Kizim01/Kizim-TLS-Pie/components_3013_iso_ORIG.jpg

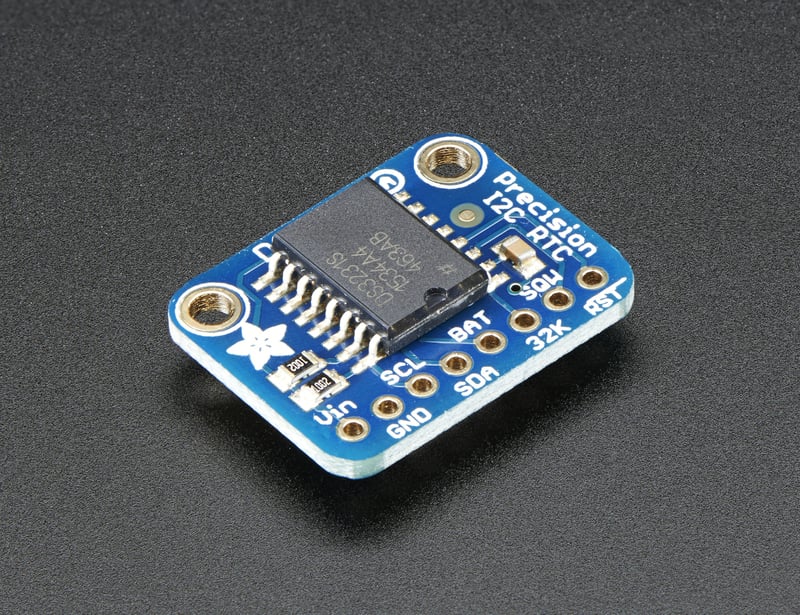
components_3013_iso_ORIG.jpg
