Kizim01/Kizim-TLS-Pie/microview pinout jpeg.jpg

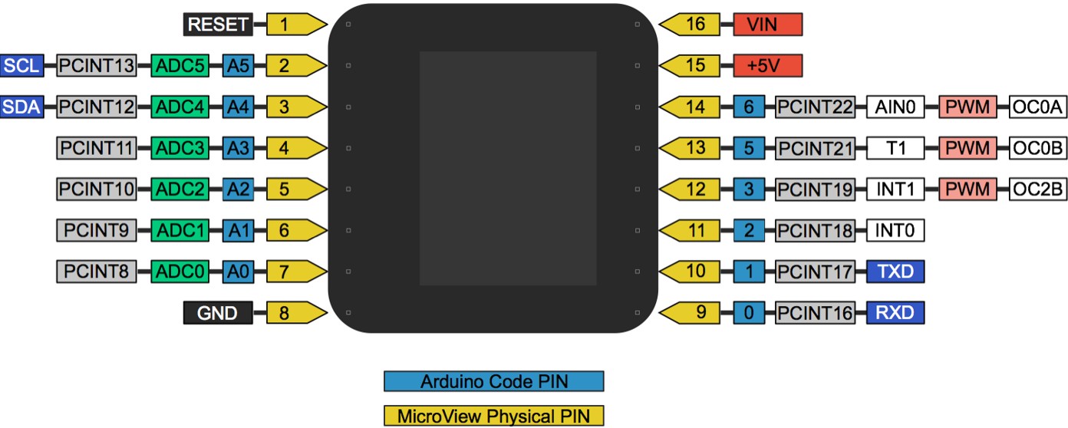
microview pinout jpeg.jpg
