Kizim01/Kizim-TLS-Pie/README.md

# TLS_Pie
Software to run a DIY Terrestrial Laser Scanner using a Raspberry Pie 4 and a Velodyne Lidar unit
house cutaway 6

Using a stepper motor a gearbox and a Velodyne VLP-16 Lidar unit one can achive good results similure to a low cost Terrestrial Laser Scanner.
PieTLS lightweight
TLS_Pie render 1
TLS_Pie render 2

Can be used indoors or Out.
house cutaway 7
spheres 1

Software to convert the Velodyne PCAP files to Point Clouds can be found here:
https://github.com/Rotoslider/PCAP-to-Point-Cloud-for-TLS
