Kizim01/Kizim-TLS-Pie/FUNDING_CONCEPT_NOTE.md

# Kizim Robotics — Funding concept note

## One-sentence pitch
Kizim Robotics is building fully autonomous, decentralized lidar mapping swarm drones that can inspect, map, and understand complex environments faster, safer, and at lower cost than traditional single-drone or manual approaches.

## Problem
Current mapping and inspection workflows are slow, expensive, and often dangerous. Traditional aerial mapping relies on expensive single-platform systems, manual operation, or centralized control. In remote, cluttered, or high-risk environments, this creates delays, incomplete coverage, and high operational cost.

## Opportunity
A new generation of low-cost autonomous drones can work together as a swarm to map large areas collaboratively, share situational awareness, and continue operating even if one unit is lost or disconnected. This is especially valuable for:
- infrastructure inspection
- mining and industrial site mapping
- disaster response and search-and-rescue support
- utilities and energy corridor monitoring
- geospatial surveying and environmental monitoring
- defense and security applications

## Solution
Kizim Robotics is developing a decentralized swarm platform for autonomous lidar mapping. The system is designed around:
- low-cost autonomous drone units
- onboard lidar sensing and navigation
- distributed coordination without a single point of failure
- collaborative mapping and data fusion
- resilient mission execution in complex environments

The platform is intended to move from single-unit operations toward a fully autonomous swarm architecture that can map and inspect large areas with greater coverage, resilience, and lower cost.

## Why now
The market is now ready for this category because:
- lidar and compute costs are falling
- edge autonomy is improving rapidly
- robotics software is maturing
- customers increasingly need faster and safer inspection workflows
- drone operations are becoming more accepted across industrial and public-sector use cases

## Why Kizim Robotics
Kizim Robotics is positioned at the intersection of robotics, autonomy, sensing, and distributed systems. The company combines hardware prototyping, embedded control, lidar mapping, and swarm coordination into a practical platform with a clear path from prototype to deployment.

## Market potential
The addressable market spans:
- industrial inspection and asset monitoring
- surveying and geospatial services
- energy and utilities
- mining and heavy industry
- defense and public safety
- disaster response and infrastructure resilience

This market is attractive because buyers are not simply buying drones; they are buying safer, faster, more complete data acquisition and reduced operational risk.

## Current traction and evidence
The project already has:
- an active hardware and software prototype direction
- evidence of lidar-based scanning and autonomy concepts
- an operating concept that is grounded in a real technical problem
- a strong narrative for research, pilot, and commercial validation

## Funding ask
Initial funding should be used to accelerate the path from prototype to credible pilot deployment.

Suggested early-stage funding target:
- $750,000 to $1.5 million for prototype maturation, field testing, and initial pilot programs

Possible funding mix:
- research and innovation grants
- strategic partnerships
- angel or seed investment
- defense or public-sector innovation channels where relevant

## Use of funds
- 40% robotics and autonomy R&D
- 25% hardware and sensor integration
- 15% field trials and pilot deployments
- 10% software and data infrastructure
- 10% team, operations, and compliance

## Milestones
Within 12 months, Kizim Robotics should aim to achieve:
- a working multi-unit autonomous demo
- a validated mapping workflow
- at least one pilot customer or partner
- strong technical and operational data for follow-on funding

## Closing statement
Kizim Robotics is building a platform that can turn distributed autonomous drones into a new class of mobile sensing infrastructure. The opportunity is not just to build drones, but to create a scalable system for autonomous mapping, inspection, and situational awareness in the real world.

This is the kind of technology that can attract grants, strategic partnerships, and early-stage investment when framed as both a breakthrough in autonomy and a practical solution to costly, dangerous, and slow current workflows.
