Kizim01/Kizim-TLS-Pie/COMPANY_LAUNCH_CHECKLIST.md

# Kizim Robotics — Company launch checklist

## 1. Define the company foundation
- Choose the legal structure for the business
- Register the company name and domain
- Set up basic corporate documents and founder agreements
- Create an internal working agreement for IP ownership and roles

## 2. Protect the technology
- Document the core technical architecture
- Record prototypes, test results, and design changes
- Create a simple IP log for inventions and improvements
- Consider provisional patent filings if the core concept is novel
- Keep clear records of prototypes, screenshots, code, and test data

## 3. Build the story and materials
- Create a one-page concept note
- Create a simple pitch deck
- Prepare a short executive summary for investors and partners
- Draft a basic website or landing page

## 4. Define the first product focus
Choose one primary use case first, such as:
- industrial inspection
- surveying and mapping
- utilities monitoring
- disaster response
- defense or public-safety support

A focused first market makes fundraising much easier.

## 5. Create a proof-of-value package
Prepare evidence that shows the technology is real:
- demo video or short footage
- technical summary
- test results
- customer problem statement
- pilot proposal or partner outreach materials

## 6. Build the funding pipeline
Start with a layered approach:
- grant and innovation funding
- strategic partnerships
- angel or seed support
- later-stage venture capital if traction is strong

## 7. Prepare a basic financial plan
- estimate runway needs
- define monthly burn
- outline hiring needs
- define hardware and software milestones
- build a simple forecast for the next 12 to 18 months

## 8. Set up the operating basics
- business bank account
- accounting system
- basic CRM or contact tracker
- shared design and project management tools
- document repository for technical and commercial materials

## 9. Start outreach early
Begin contacting:
- potential pilot customers
- research labs and universities
- robotics or sensing partners
- incubators and accelerators
- grant and innovation programs

## 10. Plan the first pilot
A pilot should answer one question clearly:
- does the system solve a real customer problem better than current alternatives?

The pilot should include:
- a clear use case
- a measurable success metric
- a timeline
- a simple deployment plan

## 11. Build the team deliberately
Start with the minimum team needed to move fast:
- technical lead
- embedded or robotics engineer
- software/autonomy engineer
- operations or business lead
- advisors in hardware, funding, or sector-specific execution

## 12. Keep the narrative disciplined
The story should stay consistent:
- the problem is real
- the solution is credible
- the market is meaningful
- the team can execute
- the funding will move the project to the next milestone

## 13. First milestones to target
Within the first 6 to 12 months, aim for:
- a working multi-unit demo
- a documented pilot use case
- initial customer conversations
- at least one credible funding path opened

## 14. Final launch mindset
Do not launch as a company that tries to be everything at once. Launch as a focused robotics company solving one high-value problem with a clear path to scale.

That is much more compelling to funders than a broad and undefined vision.
