Kizim01/Kizim-TLS-Pie/PITCH_DECK_OUTLINE.md

# Kizim Robotics — Pitch deck outline

## Suggested deck structure
This structure is designed for a seed-stage or grant-style investor conversation. Keep it visual, technical, and focused on impact.

### Slide 1 — Title
Kizim Robotics
Autonomous decentralized lidar mapping swarm drones
Subtitle: Faster, safer, more complete mapping for industrial and public-sector environments

### Slide 2 — The problem
Current mapping and inspection is slow, expensive, and often dangerous.
- Manual inspections are labor-intensive
- Single-drone systems are fragile and limited
- Large sites are difficult to map completely and quickly

### Slide 3 — The solution
A decentralized swarm of autonomous drones that collaborate in real time to map and inspect environments.
- distributed coordination
- resilient operation
- shared mapping data
- better coverage and lower operational cost

### Slide 4 — Why now
Why the market is ready now:
- cheaper sensors and compute
- better autonomy software
- rising demand for industrial inspection and remote sensing
- growing need for fast situational awareness

### Slide 5 — Product vision
What the system does:
- launch and coordinate multiple drones
- map terrain and infrastructure with lidar
- fuse data into a shared map
- adapt to changing conditions autonomously

### Slide 6 — Technical approach
Core technical pillars:
- autonomy and navigation
- lidar sensing and mapping
- swarm coordination and communication
- edge processing and data fusion

### Slide 7 — Prototype / proof of concept
Show the current technical progress:
- prototype platform
- mapping workflow
- control architecture
- early autonomous behavior
- bench-test or field-test results

### Slide 8 — Use cases
Primary applications:
- infrastructure inspection
- utilities and energy corridors
- mining and industrial sites
- disaster response
- surveying and geospatial mapping
- defense and security

### Slide 9 — Market and customer value
Who pays and why:
- operators want lower cost and faster coverage
- customers need safer and more complete data
- organizations need less downtime and better situational awareness

### Slide 10 — Business model
Possible revenue paths:
- hardware platform sales
- pilot deployments
- software and analytics subscriptions
- service contracts for inspection and mapping
- partnerships with industrial or public-sector customers

### Slide 11 — Go-to-market strategy
How to win early customers:
- start with one high-value vertical
- build a pilot program
- prove ROI with measurable outcomes
- expand through partnerships

### Slide 12 — Roadmap
12-month plan:
- field-ready prototype
- multi-unit swarm demo
- pilot deployment
- data package for follow-on funding

### Slide 13 — Team
Highlight:
- robotics and autonomy experience
- embedded systems and hardware background
- software and sensing expertise
- industry partnerships and advisors

### Slide 14 — Funding ask
State clearly:
- amount requested
- use of funds
- milestones for the next round
- what success looks like

### Slide 15 — Close
End with a strong closing line:
Kizim Robotics is building the infrastructure for autonomous distributed mapping at a time when the world needs faster, safer, and more resilient sensing systems.
