Kizim01/Kizim-TLS-Pie/TLS_Pie_Schemdraw_Schematic.pdf

## TLS_Pie wiring schematic

MicroView / Arduino
Buttons
Stepper Driver
Raspberry Pi
Signals: A0/A1/A2/D2, D3/D5/D6, D7/D8
Notes: Pi triggers GPIO17/GPIO27; shared ground required
