Kizim01/Kizim-TLS-Pie/START_HERE/README.md

# START HERE

Use this folder as the single project restart point.

Primary guide:
- [START_HERE.md](../START_HERE.md)

Quick links:
- [AI_HANDOFF_CHANGELOG.md](../AI_HANDOFF_CHANGELOG.md)
- [PROJECT_CONTEXT.md](../PROJECT_CONTEXT.md)
- [AI_HANDOFF_CHECKLIST.md](../AI_HANDOFF_CHECKLIST.md)
- [Pi_Setup_Package](../Pi_Setup_Package)
- [Pi_Setup_Package.zip](../Pi_Setup_Package.zip)
- [MicroView_Setup_Package](../MicroView_Setup_Package)
- [MicroView_Setup_Package.zip](../MicroView_Setup_Package.zip)

If resuming with Copilot, paste this prompt first:

```text
Continue from this repository context. Read these first:
1) AI_HANDOFF_CHANGELOG.md
2) PROJECT_CONTEXT.md
3) AI_HANDOFF_CHECKLIST.md
Then summarize current status, pending hardware validation, and the next 3 recommended actions.
```
