Kizim01/Kizim-TLS-Pie/4670_additional_big_easy_driver_107def42-5508-472d-be67-b35f5f0497c9.webp

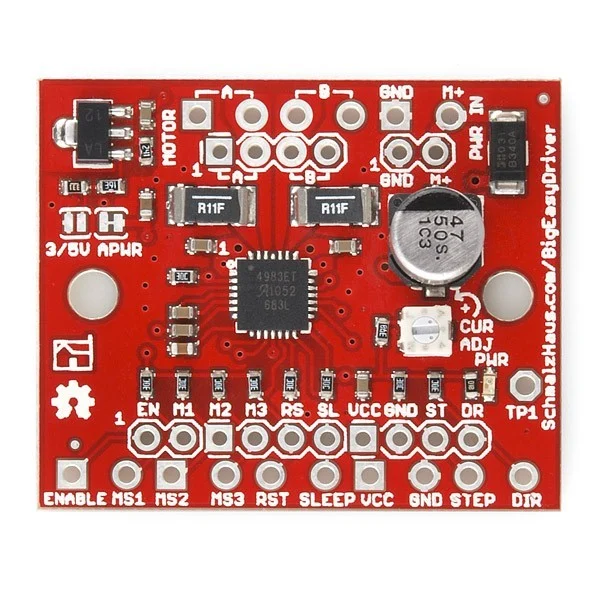
4670_additional_big_easy_driver_107def42-5508-472d-be67-b35f5f0497c9.webp
