Kizim01/Kizim-TLS-Pie/170906573-ced1bcf0-2f3b-4d30-9000-c1366d5eeb3a.png

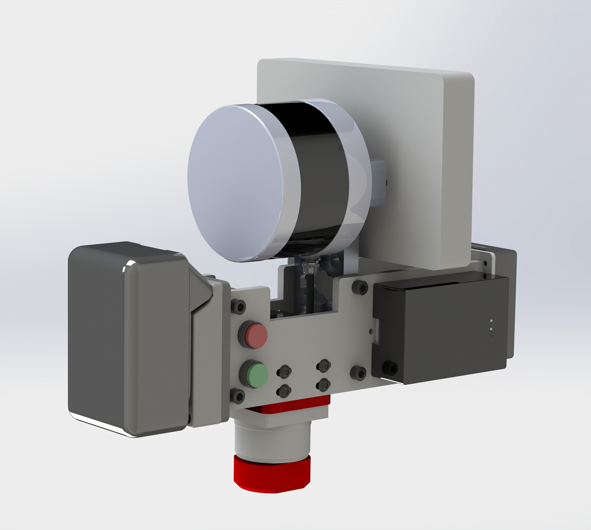
170906573-ced1bcf0-2f3b-4d30-9000-c1366d5eeb3a.png
