Kizim01/Kizim-TLS-Pie/big easy driver.jpg

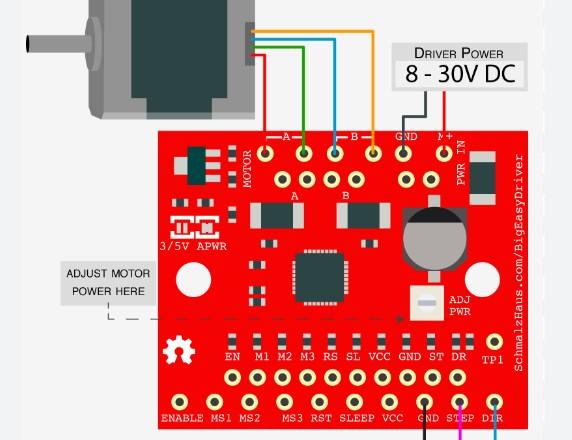
big easy driver.jpg
