Kizim01/Kizim-TLS-Pie/i-rotated-the-raspberry-pi-4s-gpio-diagram-by-180-degrees-v0-a71h1fe0s5b71.webp

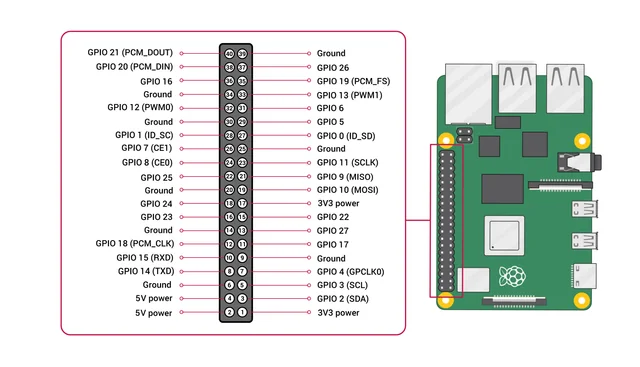
i-rotated-the-raspberry-pi-4s-gpio-diagram-by-180-degrees-v0-a71h1fe0s5b71.webp
