Kizim01/Kizim-TLS-Pie/WhatsApp Image 2026-08-09 at 3.39.35 AM.jpeg

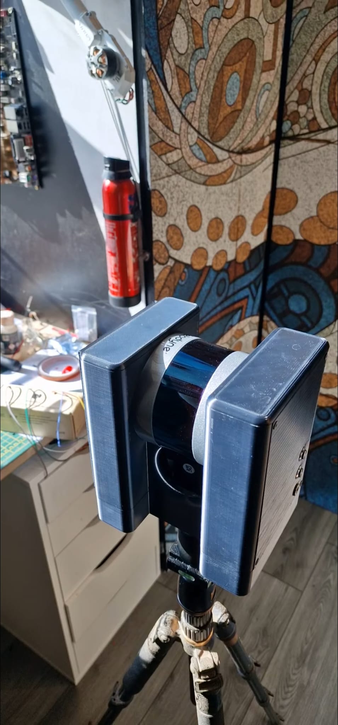
WhatsApp Image 2026-08-09 at 3.39.35 AM.jpeg
