Kizim01/Kizim-TLS-Pie/WIRING_REV2.html

Kizim Robotics · TLS Pie

# Rev 2.0 wiring schematic

Every conductor in the rig, endpoint to endpoint, named at both ends. This is the Pi-only architecture: the MicroView, the level shifter, the five push buttons and the monitor are all gone.

Rev2.0 Supersedes1.1 — 2022-09-12 Date2026-08-09 Statusnot yet built Sheets4

## 00 How to read this

This is an interconnect diagram, not a circuit-analysis schematic. Every device is a labelled block with its real silkscreen pin names on the edges, because the silkscreen is what you read with a wire in your hand. Only the parts you actually fit as discrete components — the fuse, the switches, the four resistors — are drawn as symbols.

Sheets 1–3 are grouped by subsystem: power, the motor chain, the capture path. Sheet 4 is that same wiring seen from the header — pin 1 at the bottom, laid out the way the connector sits in front of you. Use 1–3 to understand the rig, and 4 to wire it.

Two conventions A filled dot where wires meet is a connection. Wires that cross without a dot are not connected. Every ground symbol ⏚ is the same single net — see the star-point note under Figure 1.

+VBATT 12–24 V unregulated

+12 V motor supply

+5 V Pi supply

+3V3 from the Pi

GND one common net

STEP / DIR / ENABLE

I²C SDA / SCL

Ethernet capture path

Motor coils A and B

## 01 Power distribution

FIG 1

Power distribution

TLS Pie · Rev 2.0

Sheet 1 of 4

F1 protects everything. S1 and S2 hang off the fuse in parallel, so S1 does not switch the lidar — cutting S1 kills the Pi and the motor rail and leaves the VLP-16 spinning on S2.

The star point Every ⏚ on all three sheets is one net. Land them all at the battery negative terminal — that is the star point. Nine conductors arrive there: BT1(–), U3 IN–, U3 OUT–, U6 IN–, U6 OUT–, U4 GND (power side), U7 J2 pin 2, and the Pi's ground, which reaches the star through U3 OUT–. The Pi's ground and the driver's ground must be common or STEP and DIR have no return path — that is what the red note on Rev 1.1 was about.

Three things to settle before this is energised

- RESOLVED — they are LM2596 bucks, not XL6009 boosts. The Rev 1.0 label was wrong. A photograph of the hardware reads LM2596S-ADJ: a step-down regulator, 4.5–40 V in, 3 A absolute maximum, ~2 A realistically on a bare module. Making 5 V from 12 V is exactly what it is for, so the Pi's rail was never in danger from the topology.
- But a buck cannot make 12 V from a 12 V battery. It needs ~1.5 V of headroom. If U6 is set to 12 V on a 12 V nominal pack it is not regulating at all and the motor rail sags under load. Delete U6 and take M+ from the switched battery instead — the driver accepts 8–35 V, U6 only ever existed to run the monitor that is now gone, and regulating a motor supply buys nothing while costing a 3 A ceiling and an LM2596's transient response in front of a chopper driver. Measure M+ while the motor is turning.
- Feeding the Pi through JP1 pins 2 and 4 bypasses its input protection. The USB-C jack has a polyfuse and an e-fuse behind it; the header pins have neither. The supply must be accurate (5.1 V) and current-limited, and its polarity is unforgiving.
- The VLP-16 wants 12 V nominal. S2 hands it raw battery volts. On a 24 V pack that is outside the sensor's input range — check the pack's actual voltage before S2 is closed, or put a regulator in that leg.

## 02 Motor chain — Pi header to driver to motor

FIG 2

Motor chain

TLS Pie · Rev 2.0

Sheet 2 of 4

Three signals, one return, four coil wires. Everything else on the driver is left open on purpose.

R_PU is the gating item — nothing turns until it is fitted Every Pi GPIO floats as an input for the ~30 s the Pi takes to boot, and ENABLE is active-low. Without the pull-up the driver can sit energised through the whole of boot with nothing in control of it. Two details decide whether the resistor actually does its job:

- It goes on the driver side of R_EN — at the ENABLE pin itself, as drawn. Put it on the Pi side and it stops holding ENABLE high the moment the Pi is unplugged.
- It pulls up to the driver's own VCC, not the Pi's 3V3. VCC is an output from the driver's on-board regulator, selected by the 3/5V APWR jumper. Set that jumper to 3.3 V and measure VCC before wiring anything to it. Then ENABLE is held disabled whenever the driver has power, whether the Pi is running, booting or absent — and no 5 V can ever reach GPIO13.

Note: PROJECT_CONTEXT.md says pull up to +3V3 and MICROVIEW_REMOVAL.md says pull up to the driver's VCC. They disagree. VCC at 3.3 V is the version that also covers "Pi off, driver on", so that is what is drawn here.

Coil pairing is the one motor mistake that matters A1/A2 must be the two ends of the same coil, and B1/B2 the two ends of the other. Get a wire from coil A onto a B output and the motor will buzz, heat and not turn. Which way round the two ends of a coil go only reverses the direction — and direction is a software setting (TLSPIE_DIR_FORWARD=0), so do not chase it with a soldering iron.

Find the pairs with a multimeter on continuity, motor disconnected: the two wires of one coil read a few ohms to each other and open circuit to the other pair.

## 03 Capture path, clock and cooling

FIG 3

Capture path, clock, cooling

TLS Pie · Rev 2.0

Sheet 3 of 4

The sensor never touches the GPIO header — it is Ethernet the whole way, which is why eth0 must stay on 192.168.1.x and the phone hotspot must not.

TB1 — the nine-way terminal block inside U7 Nothing here is hand-wired: the VLP-16's factory cable lands on TB1 in this order. Listed so a disturbed terminal can be put back.

TB1 | Function | TB1 | Function
1 | Gnd / Shield | 6 | Ethernet TX–
2 | +12 Vdc | 7 | Ethernet RX+
3 | GPS_Pulse_CNT | 8 | Ethernet RX–
4 | GPS_RX_CNT | 9 | GPS return
5 | Ethernet TX+ | —

Vin goes to 3V3 — header pin 1, not pin 2 or 4 On this breakout the I²C pull-up resistors reference Vin, so whatever you feed Vin is what appears on SDA and SCL when the bus is idle. Put 5 V on Vin and the board pulls GPIO2 and GPIO3 to 5 V — and the Pi's GPIOs are not 5 V tolerant. The DS3231 runs happily from 2.3 V and draws microamps, so there is no reason to use 5 V here even if it were safe.

Check it before you trust it: power the board from pin 1 with the SDA and SCL wires not yet fitted, and measure SDA to GND. It must read about 3.3 V, not 5.

U1 · Adafruit DS3231 Precision RTC breakout · all eight pins
Pin | Silkscreen | Goes to | Why / why not
1 | Vin | JP1 pin 1 · 3V3 | Powers the chip and sets the I²C bus voltage — see the box above
2 | GND | JP1 pin 9 | Any Pi ground works; 9 is chosen because it sits beside the I²C pair
3 | SCL | JP1 pin 5 · GPIO3 | I²C clock
4 | SDA | JP1 pin 3 · GPIO2 | I²C data
5 | BAT | no connection | Positive of the coin cell, which lives in the holder on the underside. Nothing to wire
6 | 32K | no connection | 32.768 kHz output, open-drain. Useful as a reference clock; this rig has no use for it
7 | SQW | no connection | Alarm / square-wave output, open-drain. If you ever want the RTC to wake the Pi on a schedule, this is the pin — and it would need a free GPIO plus a pull-up
8 | RST | no connection | Open-drain reset, bidirectional. Leave it

Four things about this board specifically

- The pin order is not the order the header hands the wires over in. The breakout runs Vin, GND, SCL, SDA — the Pi's four pins arrive as 3V3, SDA, SCL, GND. Two of the four wires cross. That is drawn honestly on Sheet 4 rather than tidied away.
- SDA and SCL are easy to swap and the symptom is silence, not damage. i2cdetect simply finds nothing. Check the pair before blaming the board.
- No battery-charging circuit. That is the difference between this board and the cheap ZS-042 clones, which do have one and slowly cook a non-rechargeable cell. Here a plain coin cell is exactly right — fit it + side up.
- Address 0x68 is fixed and nothing else in the rig is on I²C, so there is no conflict to design around.

Wiring it is half the job — the Pi ignores it until you say so Raspberry Pi OS keeps time with fake-hwclock, which just restores the last known time at boot. The RTC only takes over once the kernel driver is bound:

Step | Command
Enable I²C | sudo raspi-config nonint do_i2c 0
Confirm the board answers | sudo i2cdetect -y 1 → expect 68
Bind the driver | add dtoverlay=i2c-rtc,ds3231 to /boot/firmware/config.txt, reboot
Confirm it bound | sudo i2cdetect -y 1 → 68 becomes UU
Stop the fake clock | sudo apt -y remove fake-hwclock && sudo systemctl disable fake-hwclock
Set the time once, online | sudo hwclock -w

This matters more here than on a desk machine. The rig runs off a phone hotspot with no guaranteed internet, and every scan's sidecar and filename is timestamped — without the RTC a cold boot in the field dates your captures from whenever the Pi was last switched off.

## 04 JP1 — the header as you hold it

Drawn in the orientation of your pinout card: pin 1 at the bottom, odd numbers up the right column, even numbers up the left, the header running down the board’s left edge. Eleven pins carry wires — 1, 2, 3, 4, 5, 6, 9, 33, 35, 37 and 39. One is damaged. The other twenty-eight are free, and stay free.

FIG 4

JP1 in the board’s own orientation

TLS Pie · Rev 2.0

Sheet 4 of 4

The same eleven conductors as Figures 1–3, arranged the way the connector sits in front of you. A coloured outline marks a pin that carries a wire; a grey stub marks one that does not.

Which end is pin 1 Pin 1 is the corner of the header nearest the USB-C power and micro-HDMI edge of the board. In this orientation that puts it at the bottom, 3V3 on the right of the pair and 5 V on the left. Count up in twos from there and the header cannot end up reversed — which is the mistake that destroyed the MicroView.

JP1 · Raspberry Pi 4B · Rev 2.0 assignment · pin 1 at the bottom
even pins · left column | | | odd pins · right column
GPIO21 | 40 | | 39 | GND → U4 GND (logic)
GPIO20 | 38 | | 37 | GPIO26 → R_DR → U4 DIR
GPIO16 | 36 | | 35 | GPIO19 → R_ST → U4 STEP
GND | 34 | | 33 | GPIO13 → R_EN → U4 ENABLE
GPIO12 | 32 | | 31 | GPIO6
GND | 30 | | 29 | GPIO5
ID_SC — reserved, HAT EEPROM | 28 | | 27 | ID_SD — reserved
GPIO7 CE1 | 26 | | 25 | GND
GPIO8 CE0 | 24 | | 23 | GPIO11 SCLK
GPIO25 | 22 | | 21 | GPIO9 MISO
GND | 20 | | 19 | GPIO10 MOSI
GPIO24 | 18 | | 17 | 3V3 spare
GPIO23 | 16 | | 15 | GPIO22
GND | 14 | | 13 | GPIO27 — DAMAGED, output-only
GPIO18 | 12 | | 11 | GPIO17
GPIO15 RXD tested OK | 10 | | 9 | GND → U1 GND (pin 2)
GPIO14 TXD tested OK | 8 | | 7 | GPIO4
GND → U10 fan – | 6 | | 5 | GPIO3 SCL → U1 SCL (pin 3)
5V ← U3 OUT+ · → U10 fan + | 4 | | 3 | GPIO2 SDA → U1 SDA (pin 4)
5V ← U3 OUT+ | 2 | | 1 | 3V3 → U1 Vin

Pin 13 · GPIO27 Confirmed damaged by gpio_selftest.py on 2026-08-09 — it drives both rails but its internal pull-up no longer holds it high as an input, consistent with the 12 V incident. It was the old RECORDSTOP line. Nothing in Rev 2.0 uses it. Never put an input there. GPIO14 and GPIO15, the two pins that ran to the destroyed harness, both pass.

Ground pins are electrically identical, so pins 6, 9 and 39 were chosen for tidiness rather than function: 6 sits next to the fan's 5 V on pin 4, 9 next to the I²C pair, and 39 next to the three motor signals at the far end. Keep the motor's return on 39 — it keeps the driver's ground wire away from the I²C pair.

## 05 Master netlist

One row per conductor. If a wire is not on this list it should not be in the rig. Colours follow the Rev 1.0 harness so old and new wiring read the same.

Every conductor, endpoint to endpoint
Net | From | To | Wire | Note
Power — Figure 1
+VBATT | BT1 (+) | F1 · terminal 1 | pink | size for the full load, not just the motor
+VBATT | F1 · terminal 2 | S1 · pole | pink | S1 and S2 tap the same fused node
+VBATT | F1 · terminal 2 | S2 · pole | pink | S1 does not switch this leg
+VSW1 | S1 · throw | U3 · IN+ (4) | pink
+VSW1 | S1 · throw | U6 · IN+ (4) | pink
+VSW2 | S2 · throw | U7 · J2 pin 1 | pink | barrel jack, centre positive
+5V | U3 · OUT+ (1) | JP1 pin 2 | red | set U3 to 5.1 V loaded
+5V | U3 · OUT+ (1) | JP1 pin 4 | red | second conductor, shares the current
+12V | U6 · OUT+ (1) | U4 · M+ | yellow | add 100 µF electrolytic at U4 if this run is long
Ground — one net, star-connected at BT1 (–)
GND | BT1 (–) | star point | green | the reference for everything
GND | U3 · IN– (3) | star point | green
GND | U3 · OUT– (2) | star point | green | this is also the Pi's ground path
GND | U6 · IN– (3) | star point | green
GND | U6 · OUT– (2) | star point | green
GND | U4 · GND (power side, by M+) | star point | green | carries coil current — keep it thick and short
GND | U7 · J2 pin 2 | star point | green
Motor chain — Figure 2
M.ENABLE | JP1 pin 33 · GPIO13 | R_EN → U4 · ENABLE | blue | active-low
M.ENABLE | U4 · ENABLE | R_PU → U4 · VCC | blue | 10 kΩ; driver side of R_EN
M.STEP | JP1 pin 35 · GPIO19 | R_ST → U4 · STEP | blue | pigpio DMA waveform
M.DIR | JP1 pin 37 · GPIO26 | R_DR → U4 · DIR | blue
GND | JP1 pin 39 | U4 · GND (logic side, by VCC) | green | signal return — mandatory
COIL A | U4 · A1 | M1 · A+ | motor lead | pairing matters, polarity does not
COIL A | U4 · A2 | M1 · A– | motor lead
COIL B | U4 · B1 | M1 · B+ | motor lead
COIL B | U4 · B2 | M1 · B– | motor lead
Clock, cooling, capture — Figure 3
+3V3 | JP1 pin 1 | U1 · Vin (breakout pin 1) | red/thin | 3V3, never 5 V — the board's I²C pull-ups reference Vin
GND | JP1 pin 9 | U1 · GND (pin 2) | green
SCL | JP1 pin 5 · GPIO3 | U1 · SCL (pin 3) | cyan | Pi already has 1.8 kΩ to 3V3; the breakout adds ~10 kΩ
SDA | JP1 pin 3 · GPIO2 | U1 · SDA (pin 4) | cyan | likewise — the parallel pair is still legal
— | U1 · BAT, 32K, SQW, RST (pins 5–8) | no connection | — | coin cell, 32.768 kHz out, alarm out, reset — none used here
+5V | JP1 pin 4 | U10 · fan (+) | red
GND | JP1 pin 6 | U10 · fan (–) | green
ETH | Pi on-board RJ-45 (eth0) | U7 · J3 RJ-45 | Cat5e | not on the header — the capture path
SENSOR | U7 · TB1 1–9 | VLP-16 | factory cable | see the TB1 table above

## 06 What to add and what to take off

Components added in Rev 2.0
Ref | Value | Sits between | Why
R_PU | 10 kΩ | U4 ENABLE → U4 VCC | Mandatory. Holds the driver disabled through the Pi's ~30 s boot, when no software exists
R_EN | 1 kΩ | JP1 pin 33 → U4 ENABLE | The driver's inputs are high-impedance, so these cost nothing electrically. They cap fault current into the Pi's clamp diodes at under 10 mA even with 12 V on the line
R_ST | 1 kΩ | JP1 pin 35 → U4 STEP
R_DR | 1 kΩ | JP1 pin 37 → U4 DIR

Removed from Rev 1.1 — do not re-fit
Ref | Was | Replaced by
P1 | MicroView — motor control + OLED | The Pi, in one process
U2 | 4-channel logic level shifter | Nothing. No 5 V logic remains
U9 | HDMI monitor on the 12 V rail | The phone panel
SW1–SW5 | Reset, Scan 1/2/3, Stop | The phone panel
R1–R5 | 10 kΩ button pull-ups to 5 V | Nothing — and they were a live hazard: a 10 kΩ to 5 V on a Pi GPIO puts 5 V on a pin that is not 5 V tolerant every time the button is open
R5 (1 kΩ) | series resistor on the Stop button | Nothing

Keep S1 (Main) and S2 (Lidar) are power switches, not buttons. S1 is the rig's emergency stop: it cuts both the Pi's converter and the motor rail, so the coils de-energise and STEP stops toggling — and unlike a switch in series with ENABLE, a crashed Pi with the DMA engine still clocking pulses cannot defeat it. Check S1's DC rating before trusting it: it breaks a DC inductive load, DC arcs do not self-extinguish the way AC ones do, and an under-rated switch slowly welds its contacts. A welded E-stop looks fine right up until it is needed.

## 07 Bring-up order

No motor has ever turned on this rig. Build the wiring in this order and each step is provable before the next one can hurt anything.

1. Header disconnected — run ./gpio_selftest.py. Expect 25 of 26 pins healthy and GPIO27 output-only.
2. Converters on the bench, no loads. Confirm U3 holds 5.1 V and U6 holds 12 V from the real pack, and measure M+ again while the motor is turning — a buck set to 12 V on a 12 V pack is in dropout and will sag exactly when the motor needs it.
3. Ground first. Star-point every return, then check continuity from the Pi's pin 39 to the battery negative before any supply is connected.
4. Power the Pi only. Panel reachable at http://tlspie.local:8080/, nothing else wired.
5. Fit R_PU, then the three series resistors, then the signal wires. With the driver powered and the Pi off, measure ENABLE — it must sit at VCC, not near zero.
6. Motor uncoupled from the head. ./tls_scan.py --scan scan3 --no-record, then press Stop mid-move and confirm the motor halts.
7. Command 90° and measure it with the shaft marked. This is the outstanding question: 640,000 steps/rev is measured and solid, but whether that comes from a 100:1 reduction or a 0.45°/step motor is still unsettled.
8. Full scan with capture. Watch for lost steps while tcpdump runs — DMA and capture contend for memory bandwidth, and that is the one real open performance question.

Before the first move, verify on the board itself

- MS1/MS2/MS3 open = 1/16 microstep on a Big Easy Driver, via its on-board pull-ups. The measured 640,000 steps/rev assumes 1/16 — if a jumper has been moved, the geometry constant is wrong.
- RST and SLP are tied together on the board on a genuine Big Easy Driver, so both may be left open. Put a meter across them and confirm continuity. If they are not tied, jumper RST to SLP or the driver never leaves reset and the motor will simply never move.
- Set the current limit on the ADJ PWR pot before the motor sees load.
- Confirm the Pi really is 192.168.1.100 against the VLP-16's own configuration. That number was never verified against the sensor.

TLS Pie · Rev 2.0 · drawn 2026-08-09 · supersedes Rev 1.1 of 2022-09-12 · source of truth for pin assignments is tls_stepper.py (TLSPIE_STEP_PIN / TLSPIE_DIR_PIN / TLSPIE_ENABLE_PIN) — this sheet documents the defaults
