Kizim01/Kizim-TLS-Pie/MicroView_Setup_Package/new wiring diagram 18.07.26.png

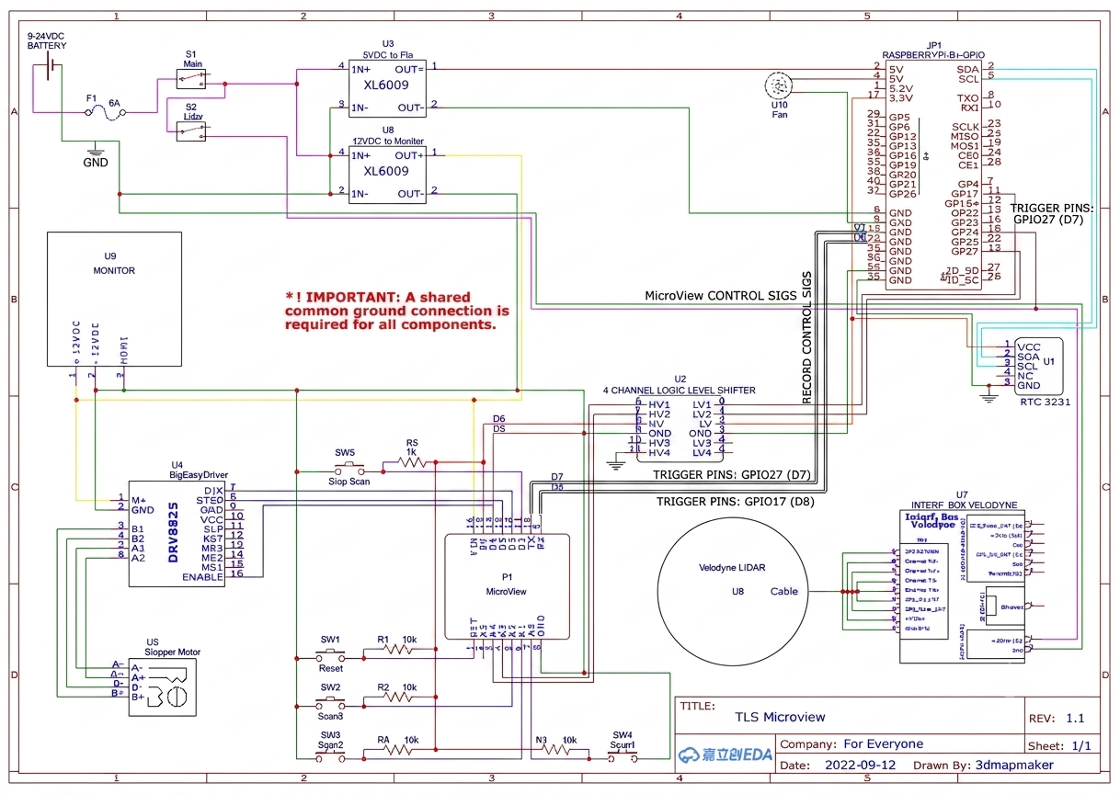
MicroView_Setup_Package/new wiring diagram 18.07.26.png
