Kizim01/Kizim-TLS-Pie/AI_HANDOFF_CHANGELOG.md

# TLS_Pie AI handoff changelog

This file is meant to help another AI instance quickly understand what changed in the repository and what still needs verification.

## Project purpose
TLS_Pie is a MicroView / Arduino + Raspberry Pi + stepper driver + Velodyne lidar control setup. The main goal is to start and stop lidar capture from the Arduino controller and have the Raspberry Pi capture packets with tcpdump.

## What changed in this session

### 1. Arduino / MicroView firmware
File: [Arduino Microview/LidarHDMicroviewV1.0/LidarHDMicroviewV1.0.ino](Arduino%20Microview/LidarHDMicroviewV1.0/LidarHDMicroviewV1.0.ino)

Changes:
- Moved the record start/stop trigger outputs from the old pins to digital pins D7 and D8.
- The current mapping is:
  - RECORDSTART = D7
  - RECORDSTOP = D8
- This was done to avoid conflicts with the MicroView display-related pins and to make the trigger wiring more reliable.

### 2. Raspberry Pi trigger scripts
Files:
- [Raspberry Pie4/TLS-Pie/VLPbuttons.py](Raspberry%20Pie4/TLS-Pie/VLPbuttons.py)
- [Raspberry Pie4/TLS-Pie/VLPwaitbutton.py](Raspberry%20Pie4/TLS-Pie/VLPwaitbutton.py)
- [Raspberry Pie4/TLS-Pie/VLPrecord.sh](Raspberry%20Pie4/TLS-Pie/VLPrecord.sh)

Changes:
- Updated the Pi-side scripts to wait for Arduino-triggered pulses rather than relying only on local button presses.
- The expected trigger wiring is:
  - Arduino D7 -> Pi GPIO17
  - Arduino D8 -> Pi GPIO27
- The record shell script now creates the capture directory before starting tcpdump.

### 3. Documentation and reference files created
Files:
- [WIRING_DIAGRAM.md](WIRING_DIAGRAM.md)
- [CHANGELOG_AND_TEST_GUIDE.md](CHANGELOG_AND_TEST_GUIDE.md)
- [UPDATED_SCHEMATIC_COMPARE.md](UPDATED_SCHEMATIC_COMPARE.md)
- [VISUAL_SCHEMATICS.md](VISUAL_SCHEMATICS.md)
- [SCHEMATIC_VISUAL_REWORK.md](SCHEMATIC_VISUAL_REWORK.md)

These files summarize:
- wiring expectations,
- signal names and pin mappings,
- troubleshooting steps,
- and comparison between the old and new schematic logic.

### 4. PDF outputs generated
Files:
- [TLS_Pie_Test_Guide.pdf](TLS_Pie_Test_Guide.pdf)
- [TLS_Pie_Updated_Schematic_Compare.pdf](TLS_Pie_Updated_Schematic_Compare.pdf)
- [TLS_Pie_Visual_Schematic.pdf](TLS_Pie_Visual_Schematic.pdf)
- [TLS_Pie_Schemdraw_Schematic_landscape.pdf](TLS_Pie_Schemdraw_Schematic_landscape.pdf)

## Important design notes
- Shared ground is required between the Arduino / MicroView, Raspberry Pi, and stepper driver.
- The Arduino now controls recording start/stop through D7 and D8.
- The Pi scripts are aligned with those trigger pins.
- The original schematic image in the repo is [Schematic_TLS Mircoview.png](Schematic_TLS%20Mircoview.png).

## What to verify next
1. Upload the Arduino sketch to the correct board and confirm the MicroView boots normally.
2. Verify button inputs on A0, A1, A2, and D2.
3. Confirm D7 and D8 produce the expected pulses when the scan starts and stops.
4. Verify Raspberry Pi GPIO17 and GPIO27 receive these pulses.
5. Confirm the Pi captures packets with tcpdump and writes output files.
6. Check the stepper driver control pins D3, D5, and D6 during motion.

## Quick summary for the next AI
If you are continuing this work, the main thing to remember is:
- the trigger wiring was changed to D7 and D8,
- the Pi waits for GPIO17 and GPIO27,
- and the system should use a common ground.

If you need to debug hardware, start with power and ground, then verify the Arduino outputs, then the Pi GPIO inputs, then the stepper and capture path.

## Pi setup work completed in this session
- Added a Raspberry Pi setup installer at [Raspberry Pie4/setup_tls_pie_pi.sh](Raspberry%20Pie4/setup_tls_pie_pi.sh)
- Added a beginner-friendly setup checklist at [Raspberry Pie4/TLS_Pie_Pi_Setup_Checklist.md](Raspberry%20Pie4/TLS_Pie_Pi_Setup_Checklist.md)
- Added a fuller setup guide at [Raspberry Pie4/TLS_Pie_Pi_Setup_Guide.md](Raspberry%20Pie4/TLS_Pie_Pi_Setup_Guide.md)
- Generated PDF versions at [Raspberry Pie4/TLS_Pie_Pi_Setup_Checklist.pdf](Raspberry%20Pie4/TLS_Pie_Pi_Setup_Checklist.pdf) and [Raspberry Pie4/TLS_Pie_Pi_Setup_Guide.pdf](Raspberry%20Pie4/TLS_Pie_Pi_Setup_Guide.pdf)

## Pi setup status
The Pi setup files and documentation are now present in the repository, but the hardware-side validation still needs to be done on the actual Pi:
1. Copy the repo to the Pi at /home/lipi/TLS-Pie
2. Run the installer script
3. Reboot and verify the recorder starts automatically
4. Confirm the Pi receives the Arduino trigger pulses and creates a .pcap file

So the setup work is largely completed in the repository, but it is not fully verified on hardware yet.

## Major integration updates (latest)

### 1. Pi runtime hardening
Files:
- [Raspberry Pie4/TLS-Pie/VLPrecord.sh](Raspberry%20Pie4/TLS-Pie/VLPrecord.sh)
- [Raspberry Pie4/TLS-Pie/VLPselfcheck.sh](Raspberry%20Pie4/TLS-Pie/VLPselfcheck.sh)
- [Raspberry Pie4/TLS-Pie/VLPstatussignal.py](Raspberry%20Pie4/TLS-Pie/VLPstatussignal.py)

Changes:
- Added recorder status tracking with explicit states written to `/tmp/tlspie/VLPrecord.status`.
- Added recorder logging under `/home/<user>/velodyne/logs`.
- Added stronger interface and runtime checks and clearer abort handling.
- Added Pi-to-MicroView status pulse signaling through `VLPstatussignal.py`.

### 2. Pi setup script improvements
Files:
- [Raspberry Pie4/setup_tls_pie_pi.sh](Raspberry%20Pie4/setup_tls_pie_pi.sh)
- [Pi_Setup_Package/setup_tls_pie_pi.sh](Pi_Setup_Package/setup_tls_pie_pi.sh)

Changes:
- Added dry-run mode (`TLSPIE_DRY_RUN=1`).
- Added setup logging.
- Added first-scan verification output.
- Ensured new companion scripts are marked executable.

### 3. MicroView abort-cause display integration
File:
- [Arduino Microview/LidarHDMicroviewV1.0/LidarHDMicroviewV1.0.ino](Arduino%20Microview/LidarHDMicroviewV1.0/LidarHDMicroviewV1.0.ino)

Changes:
- Added Pi status input pin support:
  - `PISTATUS = D4`
- Added decoded abort-cause display on OLED using pulse count codes from Pi.
- Added user-visible runtime states on OLED:
  - `READY`
  - `WAIT PI`
  - `SCANNING`
  - `REC`
  - `PI TIMEOUT`
  - `REC LOST` (brief transition before detailed abort screen)
  - `PI ABORTED` + reason code

Pi abort reason code mapping shown on OLED:
- 1 START TIMEOUT
- 2 NO INTERFACE
- 3 LIDAR OFFLINE
- 4 TCPDUMP ERROR
- 5 EMPTY PCAP
- 6 INTERRUPTED
- 7 TOOL MISSING
- 8 reserved for Pi recording ACK (non-abort)

### 4. New packaging and handoff outputs
Files/folders:
- [Pi_Setup_Package](Pi_Setup_Package)
- [Pi_Setup_Package.zip](Pi_Setup_Package.zip)
- [MicroView_Setup_Package](MicroView_Setup_Package)
- [MicroView_Setup_Package.zip](MicroView_Setup_Package.zip)
- [Pi_Setup_Package/build_package.ps1](Pi_Setup_Package/build_package.ps1)

Changes:
- Added one-command package build and sync lock verification.
- Added dedicated MicroView setup package with firmware, status references, checklist, wiring image, and Pi companion files.

### 5. Validation completed
- Bash tooling installed and verified.
- Shell script syntax checks passed.
- ShellCheck lint is clean on key scripts.
- Python compile checks passed for Pi helper scripts.
- Package sync-lock verification passed and zips were generated.

## Remaining hardware verification tasks
1. Wire Pi GPIO22 -> level shifter -> MicroView D4 (`PISTATUS`).
2. Flash updated MicroView firmware and confirm OLED states transition as expected.
3. Bench-test one full cycle:
   - READY -> WAIT PI -> SCANNING + REC -> READY
4. Force an abort condition and verify:
   - REC LOST transition
   - PI ABORTED with correct reason code.

## Latest session update (2026-07-18)

### NEW_PROJECT_START_HERE starter kit flow finalized
Files:
- [NEW_PROJECT_START_HERE/START_NEW_PROJECT.bat](NEW_PROJECT_START_HERE/START_NEW_PROJECT.bat)
- [NEW_PROJECT_START_HERE/init_new_project.ps1](NEW_PROJECT_START_HERE/init_new_project.ps1)
- [NEW_PROJECT_START_HERE/README.md](NEW_PROJECT_START_HERE/README.md)
- [NEW_PROJECT_START_HERE/Templates](NEW_PROJECT_START_HERE/Templates)

Changes:
- Removed interactive pauses from `START_NEW_PROJECT.bat` so startup is fully automatic.
- Removed self-rename behavior from `START_NEW_PROJECT.bat` (avoids Windows "batch file cannot be found" noise).
- `START_NEW_PROJECT.bat` now runs the initializer and exits cleanly.
- `init_new_project.ps1` now creates a separate `RESUME_PROJECT.bat` in the project root.
- Templates are now kept in a dedicated toolkit folder:
  - `NEW_PROJECT_START_HERE/Templates`
- Generated working docs are written to the project root:
  - `PROJECT_CONTEXT.md`
  - `AI_HANDOFF_CHANGELOG.md`
  - `AI_HANDOFF_CHECKLIST.md`
  - `AI_PROJECT_RUNBOOK.md`
  - `COPILOT_START_PROMPT.txt`
  - `START_HERE.md`
  - `RESUME_PROJECT.bat`

Validation:
- Sandbox run confirmed starter behavior:
  - Generated docs created in project root.
  - Template files stayed in `NEW_PROJECT_START_HERE/Templates`.
  - `RESUME_PROJECT.bat` created and successfully reran refresh with skip-existing behavior.
- Cleaned leftover test folder in toolkit (`NEW_PROJECT_START_HERE/_rename_test`).

Resulting usage model:
1. Keep `NEW_PROJECT_START_HERE` as a reusable toolkit folder in repo.
2. Run `NEW_PROJECT_START_HERE/START_NEW_PROJECT.bat` for initial bootstrap.
3. Run `RESUME_PROJECT.bat` from project root for future refresh/resume operations.

## Session update (2026-07-18): VLPrecord.sh timing fix + consolidated setup package

### Code review findings
Reviewed the full Velodyne -> pcap capture chain (LidarHDMicroviewV1.0.ino -> VLPbuttons.py/VLPwaitbutton.py -> VLPrecord.sh -> tcpdump -> .pcap -> MATLAB TLS_Velodyne_script.m). Found:
1. VLPrecord.sh sent the MicroView recording ACK (`signal_microview_code 8`) before starting tcpdump, so the motor could begin rotating before packet capture was actually running.
2. The autostart launcher in setup_tls_pie_pi.sh passes the capture interface as a positional argument (`VLPrecord.sh $INTERFACE`), but VLPrecord.sh never read `$1`, so the interface override was silently ignored and it always fell back to `eth0`.
3. tcpdump had no BPF filter, so it captured all traffic on the interface, not just lidar packets.

### Fixes applied
Files changed (identical fix applied to all three copies):
- [Raspberry Pie4/TLS-Pie/VLPrecord.sh](Raspberry%20Pie4/TLS-Pie/VLPrecord.sh)
- `Pi_Setup_Package/TLS-Pie/Raspberry Pie4/TLS-Pie/VLPrecord.sh`
- `MicroView_Setup_Package/Pi_Companion_Files/VLPrecord.sh`

Changes:
- `ETH_INTERFACE="${1:-${ETH_INTERFACE:-eth0}}"` - positional argument now takes priority.
- Added `CAPTURE_FILTER="${CAPTURE_FILTER-host $LIDAR_IP}"` and applied it to the tcpdump command line.
- Reordered capture start: tcpdump now starts first, the script waits 0.3s and confirms the process is alive (`kill -0`) before calling `status_update`/`signal_microview_code 8`. If tcpdump dies immediately, it aborts with `TCPDUMP_ERROR` instead of acking the MicroView.

Note: `Pi_Setup_Package/build_package.ps1` copies `Raspberry Pie4/TLS-Pie/VLPrecord.sh` (repo root) onto the Pi_Setup_Package copy and verifies by hash equality - the repo root copy had to be fixed too, or the next package rebuild would silently revert the fix.

### New consolidated setup folder
Created `SETUP_PACKAGE_18.07.26/` at the repo root with:
- `Pi/` - full copy of `Pi_Setup_Package` (installer, runtime scripts, checklists/guides)
- `MicroView/` - full copy of `MicroView_Setup_Package` (firmware, docs, Pi companion files)
- `BENCH_TEST_CHECKLIST.md` and `.pdf` - staged end-to-end bench test procedure (see below)
- `make_bench_test_checklist_pdf.py` - regenerates the PDF from the markdown source

The original `Pi_Setup_Package` and `MicroView_Setup_Package` folders were kept as backups (not deleted).

### Static validation performed (2026-07-18)
- `python -m py_compile` passed for VLPbuttons.py, VLPwaitbutton.py, VLPstatussignal.py (both package copies).
- `bash -n` (via Git for Windows bash) passed for VLPrecord.sh, VLPselfcheck.sh, setup_tls_pie_pi.sh.
- Brace/paren/bracket balance check passed for LidarHDMicroviewV1.0.ino.
- This confirms no syntax errors; it does not confirm GPIO timing or hardware behavior.

### Bench test checklist added
`SETUP_PACKAGE_18.07.26/BENCH_TEST_CHECKLIST.md` (+ PDF) documents a 6-stage test procedure:
0. Static code validation (complete, see above)
1. Pi environment self-check (VLPselfcheck.sh)
2. Dry-run install (TLSPIE_DRY_RUN=1)
3. MicroView <-> Pi signaling only (no motor, no lidar)
4. Add lidar, capture-only test
5. Full bench scan with motor engaged
6. MATLAB conversion validation

### Remaining hardware verification tasks
1. Run the bench test checklist stages 1-6 on real hardware.
2. Confirm the motor does not move until tcpdump is confirmed running (validates the ACK-ordering fix).
3. Confirm the autostart launcher picks up the correct interface via the positional argument.
4. Confirm the .pcap only contains lidar traffic and converts correctly in the MATLAB TLS_Velodyne converter.

## Session update (2026-07-18, part 2): wireless Pi setup docs

### Changes made
- Added a wireless/headless setup path to the Pi setup docs in `SETUP_PACKAGE_18.07.26/Pi/`, so the Pi can be fully configured and controlled from a laptop over WiFi/SSH without ever plugging in a monitor, keyboard, or mouse:
  - [SETUP_PACKAGE_18.07.26/Pi/TLS_Pie_Pi_Setup_Guide.md](SETUP_PACKAGE_18.07.26/Pi/TLS_Pie_Pi_Setup_Guide.md) - added a new step 4, "Set up wireless remote access (SSH)", covering Raspberry Pi Imager's SSH/WiFi settings, connecting via `ssh user@hostname.local`, and optional VNC. Remaining steps renumbered (5-13).
  - [SETUP_PACKAGE_18.07.26/Pi/TLS_Pie_Pi_Setup_Checklist.md](SETUP_PACKAGE_18.07.26/Pi/TLS_Pie_Pi_Setup_Checklist.md) - added step "1a" with the same quick SSH/VNC setup bullets.
- Regenerated both PDFs from the updated markdown.
- Added [SETUP_PACKAGE_18.07.26/Pi/make_setup_pdfs.py](SETUP_PACKAGE_18.07.26/Pi/make_setup_pdfs.py), a reusable reportlab-based generator (same pattern as `make_bench_test_checklist_pdf.py`) that renders both `TLS_Pie_Pi_Setup_Guide.md` and `TLS_Pie_Pi_Setup_Checklist.md` to PDF in one run.

### Files touched
- SETUP_PACKAGE_18.07.26/Pi/TLS_Pie_Pi_Setup_Guide.md and .pdf
- SETUP_PACKAGE_18.07.26/Pi/TLS_Pie_Pi_Setup_Checklist.md and .pdf
- SETUP_PACKAGE_18.07.26/Pi/make_setup_pdfs.py (new file)

### Validation performed
- Ran `make_setup_pdfs.py`, confirmed both PDFs regenerated with exit code 0 and printed output paths.

### Remaining work
- None code-side; this was documentation-only. The underlying VLPrecord.sh fixes and bench test checklist still need real hardware verification (see above).

---

## Session update (2026-08-08/09): MicroView destroyed, architecture moved to Pi-only

> **If you are the next AI on this project, read this section and the rewritten
> [PROJECT_CONTEXT.md](PROJECT_CONTEXT.md) before anything else.** Every earlier section of this
> changelog describes an architecture that no longer exists.

### 1. The MicroView is dead — cause confirmed

Symptom: OLED dark, `avrdude` failing `not in sync: resp=0x00` at 115200 / 57600 / 19200 / 9600.

Cause: the harness was wired with **both pin rows reversed** — right column physical pin N to pin
(25−N), left column pin N to pin (9−N). That put **12 V on physical pin 10 = Arduino D1/TXD**
(absolute max ≈ 5.5 V), and put the **GND wire on RESET**, leaving the board with no ground return.

TXD is the pin the ATmega replies to `avrdude` on, which is why the FTDI programmer looked
perfectly healthy while nothing answered — one fault explaining every symptom.

Ruled out during diagnosis: the sketch, the Arduino IDE (bare `avrdude` fails identically), port
contention, and the FT231X programmer itself.

### 2. Unresolved — is the Pi damaged?

The wires intended for TX and RX landed on pin 15 (**the +5 V rail**) and pin 16 (**VIN**), both
running off-board. The path to the Pi went through **U2, the 4-channel level shifter**, which on a
BSS138 MOSFET design blocks HV→LV conduction and probably protected the Pi. That is inference, not
measurement.

**Action for the next session:** run `gpio_selftest.py --pins 14,15` with the header disconnected.
Replace U2 regardless.

### 3. Firmware bugs found and fixed (commits `feb1d91`, `9fe8249`)

Fixed but **never uploaded** — the board died first. Retained for reference only.

- `KILL_SCAN()` ran as an ISR while calling `delay()` and driving the OLED. Interrupts are masked
  inside an ISR so Timer0 never ticks and `delay()` blocks forever — the board hung permanently on
  the first kill press, and because the `RECORDSTOP` pulse sat after those delays the Pi was never
  told to stop.
- KILL interrupt was `RISING` on an active-low button, so it fired on release. Now `FALLING`.
- All four buttons were `INPUT` but read active-low — floating. Now `INPUT_PULLUP`.
- Scan moves were blocking, so neither the kill button nor a Pi abort was looked at for the whole
  3–6 minute rotation.
- The PI TIMEOUT screen was drawn and immediately overwritten by `showReadyScreen()`.
- RAM was at 67%; the logo moved to PROGMEM, now 49%.
- **`PISTATUS`/`RECORDSTART`/`RECORDSTOP` were on D4/D7/D8 — pins the MicroView does not break
  out.** The OLED uses D4 (3.3 V regulator enable), D7 (reset), D8 (data/command), D10, D11, D13
  internally. Moved to A3/A4/A5. See `SparkFun_MicroView/src/MicroView.h`.

### 4. New architecture — the Pi runs everything (commit `5360777`)

New files in `Raspberry Pie4/TLS-Pie/`:

- **`tls_stepper.py`** — pan axis on **pigpio DMA waveforms**. Linux is not real-time, so a step
  train bit-banged from a Python loop stalls whenever the scheduler preempts it, and that jitter
  lands in the point cloud as angular error. Trapezoidal profile: 16-segment ramp, chunked cruise,
  mirrored decel, emitted as `wave_chain` loops.
- **`tls_scan.py`** — controller. `VLPrecord.sh`'s preflight checks ported verbatim; `tcpdump`
  still confirmed alive before the motor turns; capture still stops before the return leg.
- **`gpio_selftest.py`** — GPIO damage check (commit `7c9fe44`).
- **`MICROVIEW_REMOVAL.md`** — wiring tables, install, staged bench test.

Removed from the design: the MicroView, U2, and the RECORDSTART/RECORDSTOP/PISTATUS handshake.
GPIO17/22/27 are now free. **The DS3231 RTC is retained** — the Pi has no battery-backed clock and
is now the sole timekeeper for pcap filenames and packet timestamps.

Scan geometry unchanged, verified with `--plan`: 378.0 s at 1 °/s, 189.0 s at 2 °/s, 190.8 s for
the 180, all step counts exact against 640,000 steps/rev.

### 5. Rev 2.0 schematic

Proposed sheet drawn in the Rev 1.0 style:
<https://claude.ai/code/artifact/b2678f52-1866-431c-8107-538c1a09c199>

### 6. Validation performed

`py_compile` passes on all three new Python files; the motion planner runs and its arithmetic
checks out. **That is the entire extent of it.** No motor has turned, no pcap has been written, no
button has been pressed, and the Pi's GPIOs have not been tested since the incident.

### 7. What to verify next

1. `gpio_selftest.py` — is the Pi damaged?
2. **Confirm the driver chip.** `STEPS_PER_REV = 640000` assumes 1/32 microstepping, which only the
   DRV8825 does. An A4988-based Big Easy Driver maxes at 1/16 and would run every move twice as far
   as commanded. The Rev 1.0 sheet labels U4 "BigEasyDriver" but gives the part as DRV8825.
3. Fit the 10 kΩ ENABLE pull-up and remove the R1–R5 5 V button pull-ups **before** power-up.
4. Bench test in the order given in `MICROVIEW_REMOVAL.md`, motor uncoupled.
5. Watch for lost steps *while a capture is running* — DMA and `tcpdump` contend for memory
   bandwidth, and that is the one open performance question.

### 8. Known safety gaps — raised, not implemented

- The stop button is **normally-open, which fails dangerous**: a broken wire reads as "not
  pressed" and the stop function vanishes silently. Wire it normally-closed.
- **No hardware E-stop.** pigpio's DMA engine keeps clocking steps if the Python process is
  killed. A **latching** switch in series with ENABLE is the only stop that survives dead software.
- No maximum-duration watchdog, and no systemd unit (so a service stop can SIGKILL past the
  graceful path).
- **`BTNPOWEROFF` was dropped in the port** — `VLPrecord.sh` could `poweroff` on a stop press;
  `tls_scan.py` only aborts. Pulling power from a running Pi risks SD card corruption.

---

## Session update (2026-08-09, part 2): step constant corrected, phone UI, preview

### 1. `STEPS_PER_REV` was wrong by 2× — corrected to 320,000

A photograph of the fitted driver board shows the chip marked **`4983ET`**: an Allegro A4983/A4988,
which is what the SparkFun Big Easy Driver uses. **Maximum 1/16 microstepping.** Only the DRV8825
does 1/32, and that is not the fitted part.

    400 steps × 16 microsteps × 50:1 = 320,000   ← correct
    400 steps × 32 microsteps × 50:1 = 640,000   ← what the firmware used

Because the step rate is derived from the same constant, both distance and speed were doubled. A
nominal "360° at 1 °/s over 6 minutes" scan was really about **756° at 2 °/s**. This came straight
from the MicroView firmware, so it has been wrong for as long as the rig has existed — relevant if
any historical scan data ever looked odd.

**Verify empirically anyway:** command 90° on an uncoupled motor, mark the shaft, measure.

Also from the board photo: `VCC` is an **output** fed by the on-board regulator via the `3/5V APWR`
jumper — do not drive it from the Pi. The board accepts **8–30 V DC** on M+/GND. Motor current is
set on the `ADJ PWR` pot.

### 2. Hardware removed at the user's direction

The monitor, U6 (the 12 V boost that fed it) and the fan are all gone; there is no E-stop yet
(user confirmed they will fit one). **Consequence worth carrying forward:** dropping the MicroView
OLED was justified by the monitor being present, so with the monitor gone the rig was briefly
headless with no status display at all. That is what motivated the phone panel below.

### 3. Two scan profiles, four buttons

Cut to `slow` (360° @ 1 °/s) and `fast` (360° @ 2 °/s). The 180° profile is gone. That freed the
fourth button, so the mapping is now **Slow / Quick / Restart / Stop** on GPIO5 / 6 / 12 / 17.

**Restart** closes a gap the old design could only warn about. After an abort the position is
genuinely unknown — pigpio cannot report how many steps left the DMA buffer — so Restart drives the
head back to zero when the position is known, and takes the current position as the new zero when
it is not.

### 4. Phone control panel — `tls_web.py`

Stdlib-only HTTP server on a daemon thread inside `tls_scan.py`, sharing scanner state directly
rather than guessing at it through a file. **Its stop button raises the same flag the GPIO stop
button does: one abort path, not two.** iOS-style interface — frosted glass over a gradient
wallpaper, SF Pro through the system stack, dark by deliberate choice for a field instrument.
Optional `TLSPIE_WEB_TOKEN`, because the default bind lets anyone on the network start the motor.

Remote start was accepted on the user's stated basis that they are always within line of sight of
the rig while operating.

### 5. Live point-cloud preview — `tls_cloud.py`, opt in

Decodes a decimated slice of the VLP-16 UDP stream into a ring buffer the panel draws as a
top-down plan view coloured by height. **Off by default** (`TLSPIE_PREVIEW=1`) because it competes
for CPU and memory bandwidth with DMA step generation and `tcpdump` — step-timing jitter under load
is the open performance question in this design. Defaults decode ~0.6% of the stream. `tcpdump` is
unaffected: libpcap captures at the link layer and does not consume datagrams.

The preview is in the sensor frame and ignores the pan axis turning underneath, so it smears into
the sweep. Useful for judging coverage; not survey data.

### 6. `tls-scan.service`

Runs the scanner independently of any login. Not convenience: a scan launched from an SSH session
dies with the link, and a controller killed mid-scan leaves the DMA clocking steps with nothing to
stop them. `KillSignal=SIGTERM` with a 600 s stop timeout keeps systemd from SIGKILLing through the
graceful shutdown.

### 7. Validation

39 automated checks, no hardware. Notably the **VLP-16 decoder verified against hand-built packets
with known geometry** — a 10 m return at 90° azimuth on the −15° laser lands where the trigonometry
says it should. Plus range gating, malformed packets, decimation, the ring buffer, and the whole
HTTP surface including busy-rejection and token auth.

**Still nothing on hardware.** No motor has turned, no pcap written, no real lidar packet decoded.

### 8. What to verify next

1. `gpio_selftest.py` — is the Pi damaged? GPIO14/15 ran to the harness that took 12 V.
2. Measure a commanded 90° before trusting `STEPS_PER_REV`; confirm MS1/MS2/MS3 are set for 1/16.
3. Fit the 10 kΩ ENABLE pull-up and remove the old R1–R5 5 V button pull-ups **before** power-up.
4. Set motor current on the `ADJ PWR` pot.
5. Bench-test uncoupled, motor before capture. Then enable the preview and re-check for lost steps.
