Kizim01/Kizim-TLS-Pie/kicad/preview.pdf

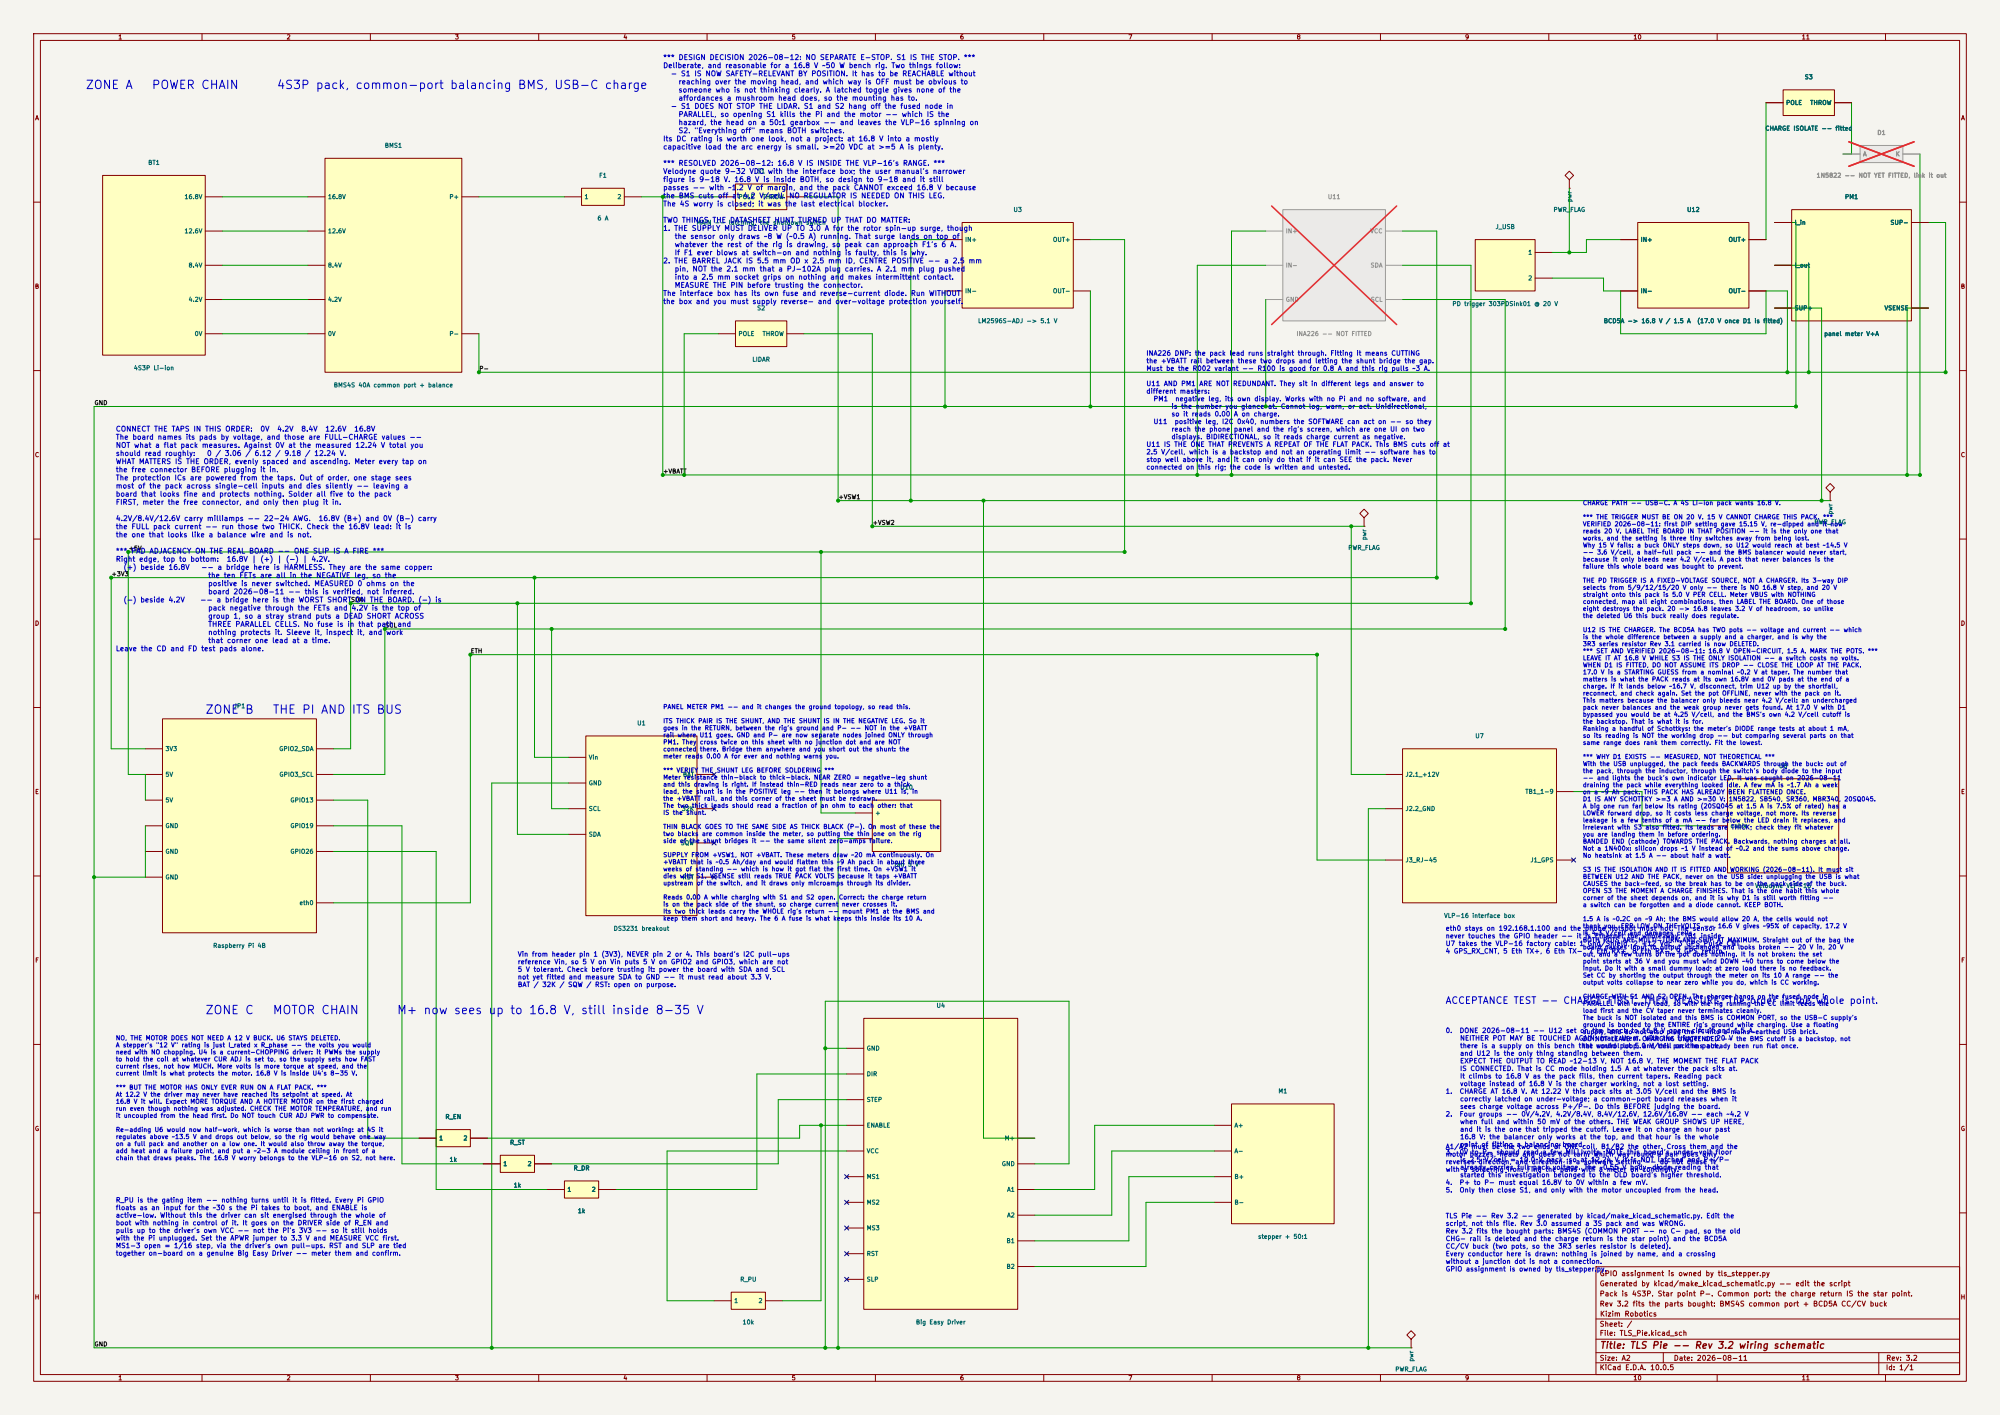
[picture p9: page 1]

*** DESIGN DECISION 2026-08-12: NO SEPARATE E-STOP. S1 IS THE STOP. *** Deliberate, and reasonable for a 16.8 V ~50 W bench rig. Two things follow: - S1 IS NOW SAFETY-RELEVANT BY POSITION. It has to be REACHABLE without

reaching over the moving head, and which way is OFF must be obvious to
someone who is not thinking clearly. A latched toggle gives none of the
affordances a mushroom head does, so the mounting has to. - S1 DOES NOT STOP THE LIDAR. S1 and S2 hang off the fused node in

S3 CHARGE ISOLATE -- fitted POLE THROW

PARALLEL, so opening S1 kills the Pi and the motor -- which IS the
hazard, the head on a 50:1 gearbox -- and leaves the VLP-16 spinning on S2. "Everything off" means BOTH switches.

Its DC rating is worth one look, not a project: at 16.8 V into a mostly
capacitive load the arc energy is small. >=20 VDC at >=5 A is plenty. *** RESOLVED 2026-08-12: 16.8 V IS INSIDE THE VLP-16's RANGE. *** Velodyne quote 9-32 VDC with the interface box; the user manual's narrower

1N5822 -- NOT YET FITTED, link it out

figure is 9-18 V. 16.8 V is inside BOTH, so design to 9-18 and it still
passes -- with ~1.2 V of margin, and the pack CANNOT exceed 16.8 V because
The 4S worry is closed; it was the last electrical blocker.

PD trigger 303PDSink01 @ 20 V POLE THROW

U12 BCD5A -> 16.8 V / 1.5 A (17.0 V once D1 is fitted) OUT+

TWO THINGS THE DATASHEET HUNT TURNED UP THAT DO MATTER:
1. THE SUPPLY MUST DELIVER UP TO 3.0 A for the rotor spin-up surge, though
the sensor only draws ~8 W (~0.5 A) running. That surge lands on top of
whatever the rest of the rig is drawing, so peak can approach F1's 6 A.
2. THE BARREL JACK IS 5.5 mm OD x 2.5 mm ID, CENTRE POSITIVE -- a 2.5 mm
pin, NOT the 2.1 mm that a PJ-102A plug carries. A 2.1 mm plug pushed
into a 2.5 mm socket grips on nothing and makes intermittent contact.
MEASURE THE PIN before trusting the connector.
the box and you must supply reverse- and over-voltage protection yourself.

different masters: PM1 negative leg, its own display. Works with no Pi and no software, and

is the number you glance at. Cannot log, warn, or act. Unidirectional, so it reads 0.00 stop well above it, and reach the phone displays. BIDIRECTIONAL, so it reads charge current as negative. U11 IS THE ONE THAT PREVENTS A REPEAT OF THE FLAT PACK. This BMS cuts off at 2.5 V/cell, which is a backstop and not an operating limit -- software has to | this rig; the code is written and untested. CONNECT THE TAPS IN THIS ORDER: 0V 4.2V 8.4V 12.6V 16.8V | A on charge. U11 positive leg, I2C 0x40, numbers the SOFTWARE can act on -- so they it can only do that if it can SEE the pack. Never connected on panel and the rig's screen, which are one UI on two

The board names its pads by voltage, and those are FULL-CHARGE values --
NOT what a flat pack measures. Against 0V at the measured 12.24 V total you
WHAT MATTERS IS THE ORDER, evenly spaced and ascending. Meter every tap on
the free connector BEFORE plugging it in.
The protection ICs are powered from the taps. Out of order, one stage sees most of the pack across single-cell inputs and dies silently -- leaving a

board that looks fine and protects nothing. Solder all five to the pack
FIRST, meter the free connector, and only then plug it in.

CHARGE PATH -- USB-C. A 4S Li-ion pack wants 16.8 V. *** THE TRIGGER MUST BE ON 20 V. 15 V CANNOT CHARGE THIS PACK. *** VERIFIED 2026-08-11: first DIP setting gave 15.15 V, re-dipped and it now

4.2V/8.4V/12.6V carry milliamps -- 22-24 AWG. 16.8V (B+) and 0V (B-) carry
the FULL pack current -- run those two THICK. Check the 16.8V lead: it is
the one that looks like a balance wire and is not. *** PAD ADJACENCY ON THE REAL BOARD -- ONE SLIP IS A FIRE *** Right edge, top to bottom: 16.8V | (+) | (-) | 4.2V.

reads 20 V. LABEL THE BOARD IN THAT POSITION -- it is the only one that works, and the setting is three tiny switches away from being lost. Why 15 V fails: a buck ONLY steps down, so U12 would reach at best ~14.5 V -- 3.6 V/cell, a half-full pack -- and the BMS balancer would never start, because it only bleeds near 4.2 V/cell. A pack that never balances is the

failure this whole board was bought to prevent. THE PD TRIGGER IS A FIXED-VOLTAGE SOURCE, NOT A CHARGER. Its 3-way DIP

the ten FETs are all in the NEGATIVE leg, so the
positive is never switched. MEASURED 0 ohms on the
board 2026-08-11 -- this is verified, not inferred.

selects from 5/9/12/15/20 V only -- there is NO 16.8 V step, and 20 V
straight onto this pack is 5.0 V PER CELL. Meter VBUS with NOTHING
connected, map all eight combinations, then LABEL THE BOARD. One of those
eight destroys the pack. 20 -> 16.8 leaves 3.2 V of headroom, so unlike
the deleted U6 this buck really does regulate. U12 IS THE CHARGER. The BCD5A has TWO pots -- voltage and current -- which

group 1, so a stray strand puts a DEAD SHORT ACROSS
THREE PARALLEL CELLS. No fuse is in that path and
that corner one lead at a time.
JP1 Raspberry Pi 4B

is the whole difference between a supply and a charger, and is why the 3R3 series resistor Rev 3.1 carried is now DELETED. *** SET AND VERIFIED 2026-08-11: 16.8 V OPEN-CIRCUIT, 1.5 A. MARK THE POTS. *** LEAVE IT AT 16.8 V WHILE S3 IS THE ONLY ISOLATION -- a switch costs no volts. WHEN D1 IS FITTED, DO NOT ASSUME ITS DROP -- CLOSE THE LOOP AT THE PACK. 17.0 V is a STARTING GUESS from a nominal ~0.2 V at taper. The number that matters is what the PACK reads at its own 16.8V and 0V pads at the end of a

Leave the CD and FD test pads alone.

charge. If it lands below ~16.7 V, disconnect, trim U12 up by the shortfall,
reconnect, and check again. Set the pot OFFLINE, never with the pack on it. This matters because the balancer only bleeds near 4.2 V/cell: an undercharged

PANEL METER PM1 -- and it changes the ground topology, so read this.

pack never balances and the weak group never gets found. At 17.0 V with D1
bypassed you would be at 4.25 V/cell, and the BMS's own 4.2 V/cell cutoff is
the backstop. That is what it is for. Ranking a handful of Schottkys: the meter's DIODE range tests at about 1 mA, so its reading is NOT the working drop -- but comparing several parts on that same range does rank them correctly. Fit the lowest. *** WHY D1 EXISTS -- MEASURED, NOT THEORETICAL *** With the USB unplugged, the pack feeds BACKWARDS through the buck: out of

the pack, through the inductor, through the switch's body diode to the input -- and lights the buck's own indicator LED. It was caught on 2026-08-11

lead, the shunt is in the POSITIVE leg -- then it belongs where U11 is, in

IS the shunt. THIN BLACK GOES TO THE SAME SIDE AS THICK BLACK (P-). On most of these the

LOWER forward drop, so it costs less charge voltage, not more. Its reverse

corner of the sheet depends on, and it is why D1 is still worth fitting --
a switch can be forgotten and a diode cannot. KEEP BOTH. 1.5 A is ~0.2C on ~9 Ah; the BMS would allow 20 A, the cells would not

thank you. ERR LOW ON THE VOLTS -- 16.6 V gives ~95% of capacity, 17.2 V
is 4.3 V/cell and damages cells. BOTH POTS ARE MULTI-TURN AND SHIP AT MAXIMUM. Straight out of the bag the board passes input to output unchanged and looks broken -- 20 V in, 20 V out, and a few turns of the pot does nothing. It is not broken: the set point starts at 36 V and you must wind DOWN ~40 turns to come below the

the control loop, and this pack has already been run flat once. Vin from header pin 1 (3V3), NEVER pin 2 or 4. This board's I2C pull-ups

4 GPS_RX_CNT, 5 Eth TX+, 6 Eth TX-, 7 Eth RX+, 8 Eth RX-, 9 GPS return.

input. Do it with a small dummy load; at zero load there is no feedback. Set CC by shorting the output through the meter on its 10 A range -- the output volts collapse to near zero while you do, which is CC working. CHARGE WITH S1 AND S2 OPEN. The charger hangs on the fused node in PARALLEL with every load, so with the rig running the CC limit feeds the

already carries full pack voltage. The ~0.55 V body-diode reading that started this investigation belonged to the OLD board's higher threshold. 4. P+ to P- must equal 16.8V to 0V within a few mV. 5. Only then close S1, and only with the motor uncoupled from the head. ACCEPTANCE TEST -- CHARGE FIRST, THEN MEASURE. The order is the whole point.

load first and the CV taper never terminates cleanly. The buck is NOT isolated and this BMS is COMMON PORT, so the USB-C supply's

ground is bonded to the ENTIRE rig's ground while charging. Use a floating
supply, and do not also plug the Pi into a mains-earthed USB brick. DO NOT LEAVE IT CHARGING UNATTENDED -- the BMS cutoff is a backstop, not

Every conductor here is drawn: nothing is joined by name, and a crossing without a junction dot is not a connection. GPIO assignment is owned by tls_stepper.py. 0. DONE 2026-08-11 -- U12 set on the bench to 16.8 V open-circuit and 1.5 A. NEITHER POT MAY BE TOUCHED AGAIN; mark them. With the trigger on 20 V

NO, THE MOTOR DOES NOT NEED A 12 V BUCK. U6 STAYS DELETED. A stepper's "12 V" rating is just I_rated x R_phase -- the volts you would

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

there is a supply on this bench that would put 5.0 V/cell on the pack, and U12 is the only thing standing between them. EXPECT THE OUTPUT TO READ ~12-13 V, NOT 16.8 V, THE MOMENT THE FLAT PACK

IS CONNECTED. That is CC mode holding 1.5 A at whatever the pack sits at.
It climbs to 16.8 V as the pack fills, then current tapers. Reading pack
voltage instead of 16.8 V is the charger working, not a lost setting. 1. CHARGE AT 16.8 V. At 12.22 V this pack sits at 3.05 V/cell and the BMS is correctly latched on under-voltage; a common-port board releases when it sees charge voltage across P+/P-. Do this BEFORE judging the board. 2. Four groups -- 0V/4.2V, 4.2V/8.4V, 8.4V/12.6V, 12.6V/16.8V -- each ~4.2 V when full and within 50 mV of the others. THE WEAK GROUP SHOWS UP HERE, and it is the one that tripped the cutoff. Leave it on charge an hour past 16.8 V: the balancer only works at the top, and that hour is the whole point of fitting a balancing board. 3. 0V to P- should read a few MILLIvolts. NOTE this board's under-volt floor

current limit is what protects the motor. 16.8 V is inside U4's 8-35 V. *** BUT THE MOTOR HAS ONLY EVER RUN ON A FLAT PACK. *** At 12.2 V the driver may never have reached its setpoint at speed. At 16.8 V it will. Expect MORE TORQUE AND A HOTTER MOTOR on the first charged

run even though nothing was adjusted. CHECK THE MOTOR TEMPERATURE, and run
it uncoupled from the head first. Do NOT touch CUR ADJ PWR to compensate.

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

A1/A2 must be the two ends of ONE coil, B1/B2 the other. Cross them and the motor buzzes, heats and does not turn. Which way round a pair goes only
is 2.5 V/cell = 10.0 V pack, so at 12.24 V it is NOT latched and P+/P-
reverses direction, and direction is a software setting -- do not chase it with a soldering iron. Find the pairs with a meter on continuity.

chain that draws peaks. The 16.8 V worry belongs to the VLP-16 on S2, not here. R_PU is the gating item -- nothing turns until it is fitted. Every Pi GPIO

floats as an input for the ~30 s the Pi takes to boot, and ENABLE is active-low. Without this the driver can sit energised through the whole of boot with nothing in control of it. It goes on the DRIVER side of R_EN and

TLS Pie -- Rev 3.2 -- generated by kicad/make_kicad_schematic.py. Edit the
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
