Kizim01/Kizim-TLS-Pie/kicad/TLS_Pie.kicad_sch

## KiCad design kicad/TLS_Pie.kicad_sch (2026-08-13)

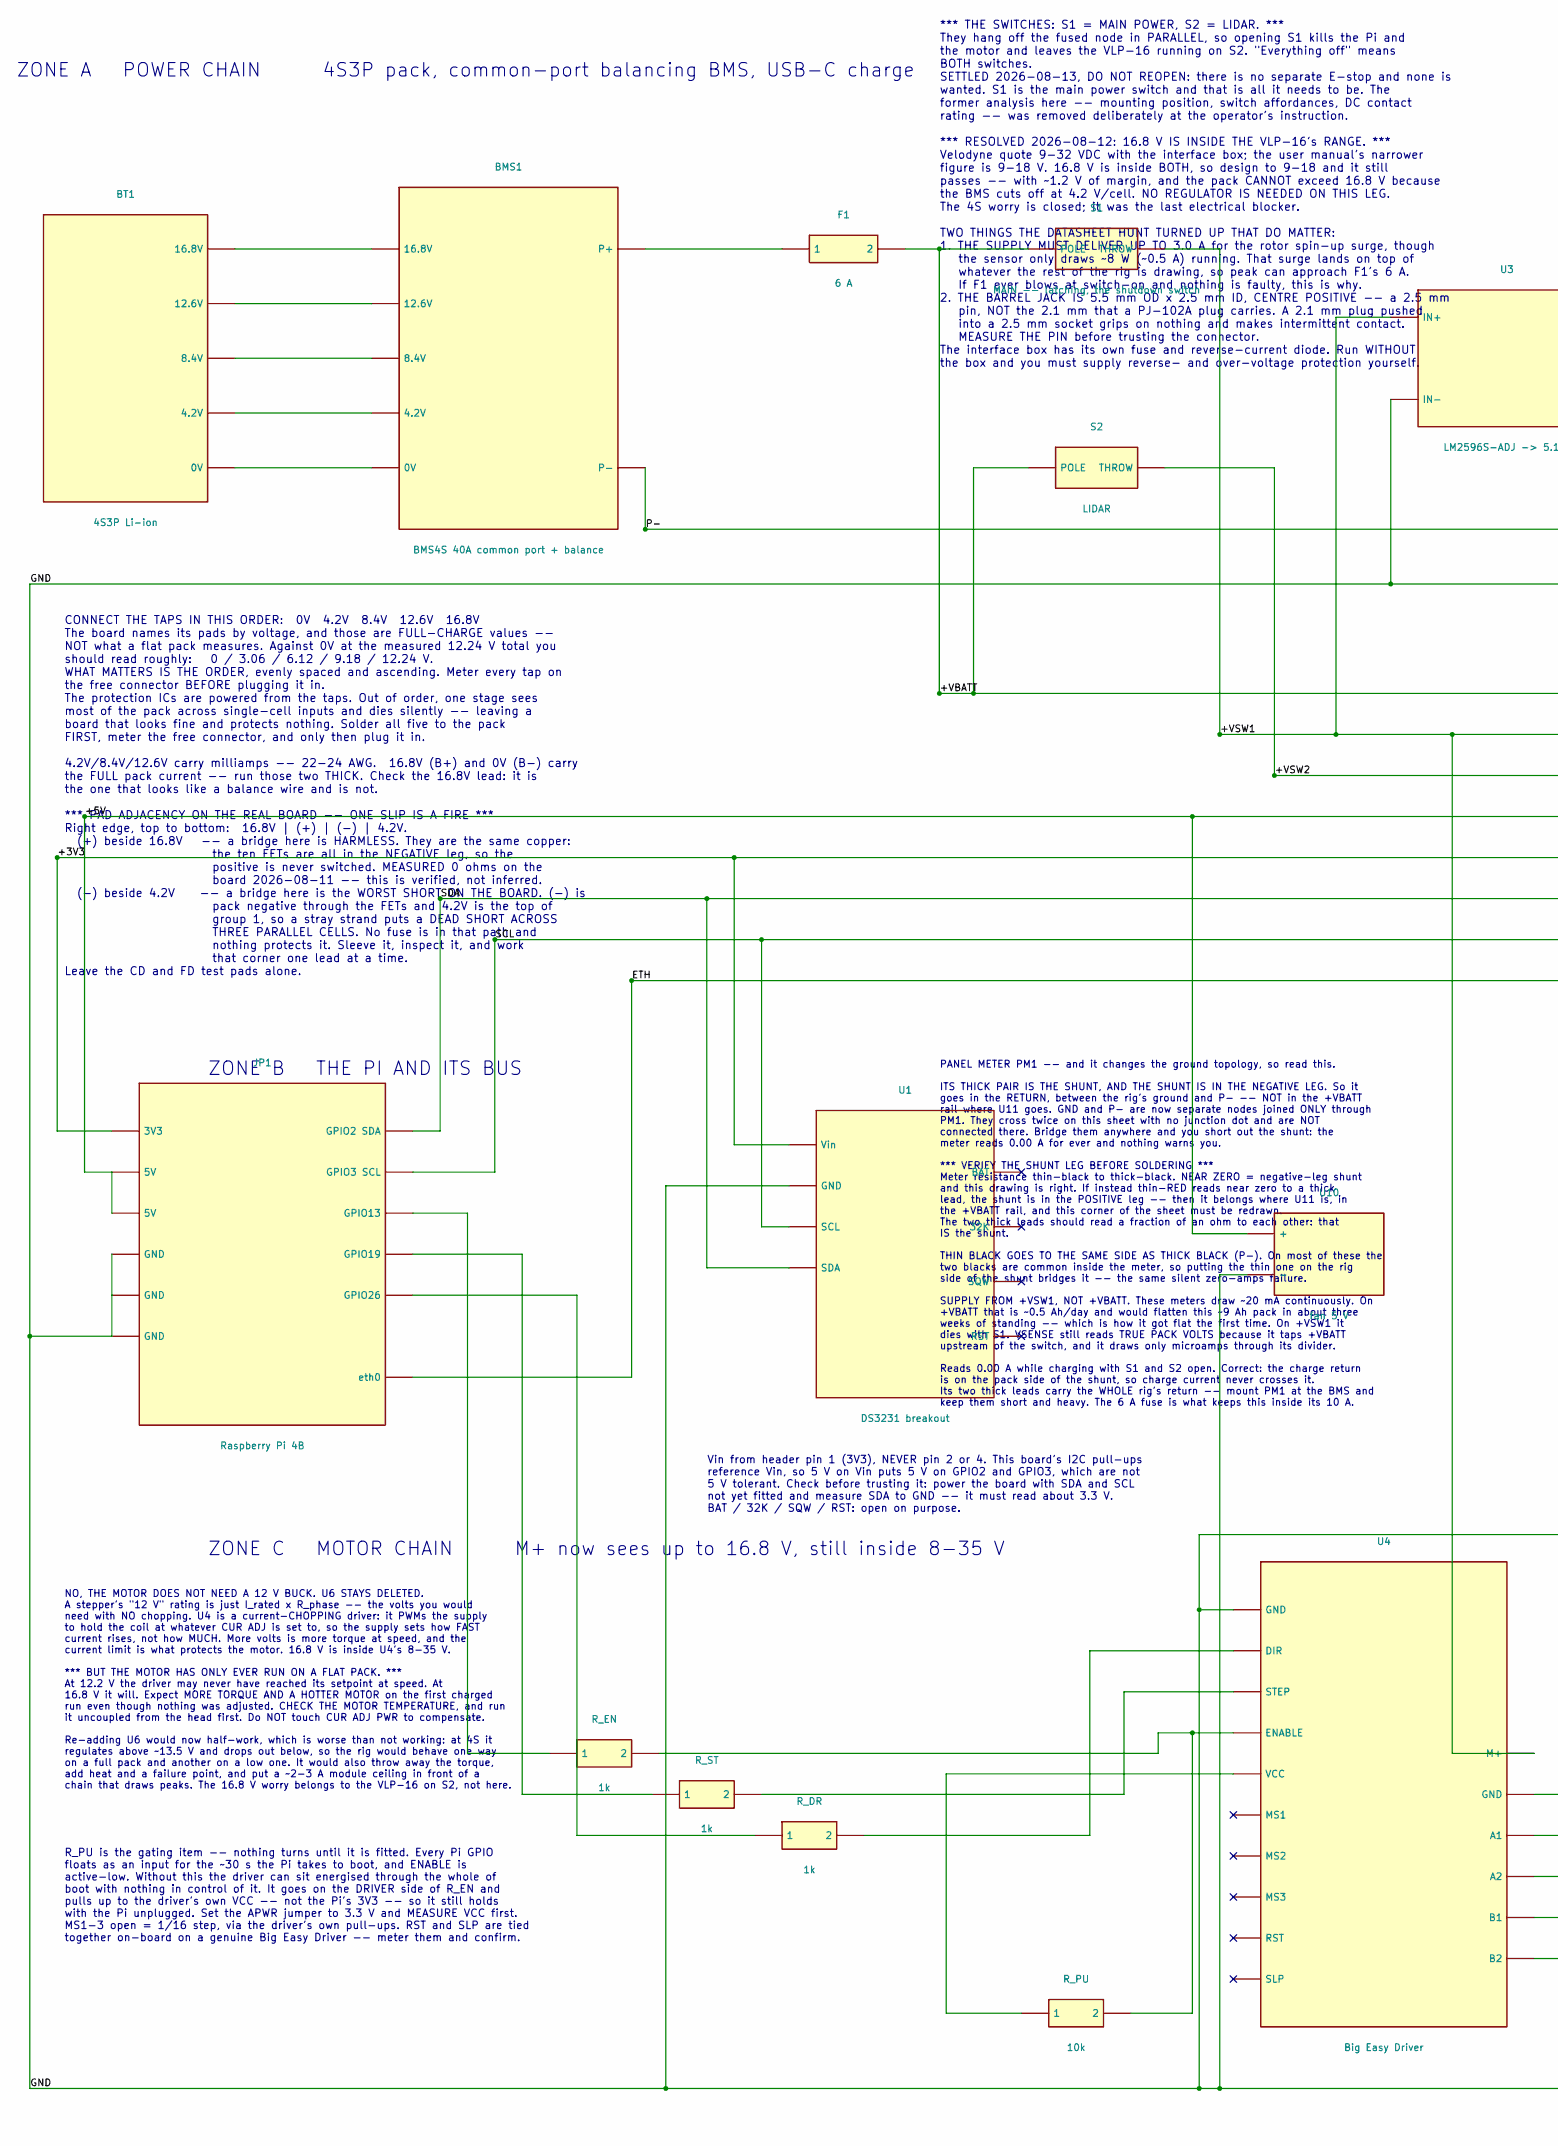
[picture p10: schematic TLS_Pie.kicad_sch, part in row 1, column 1]

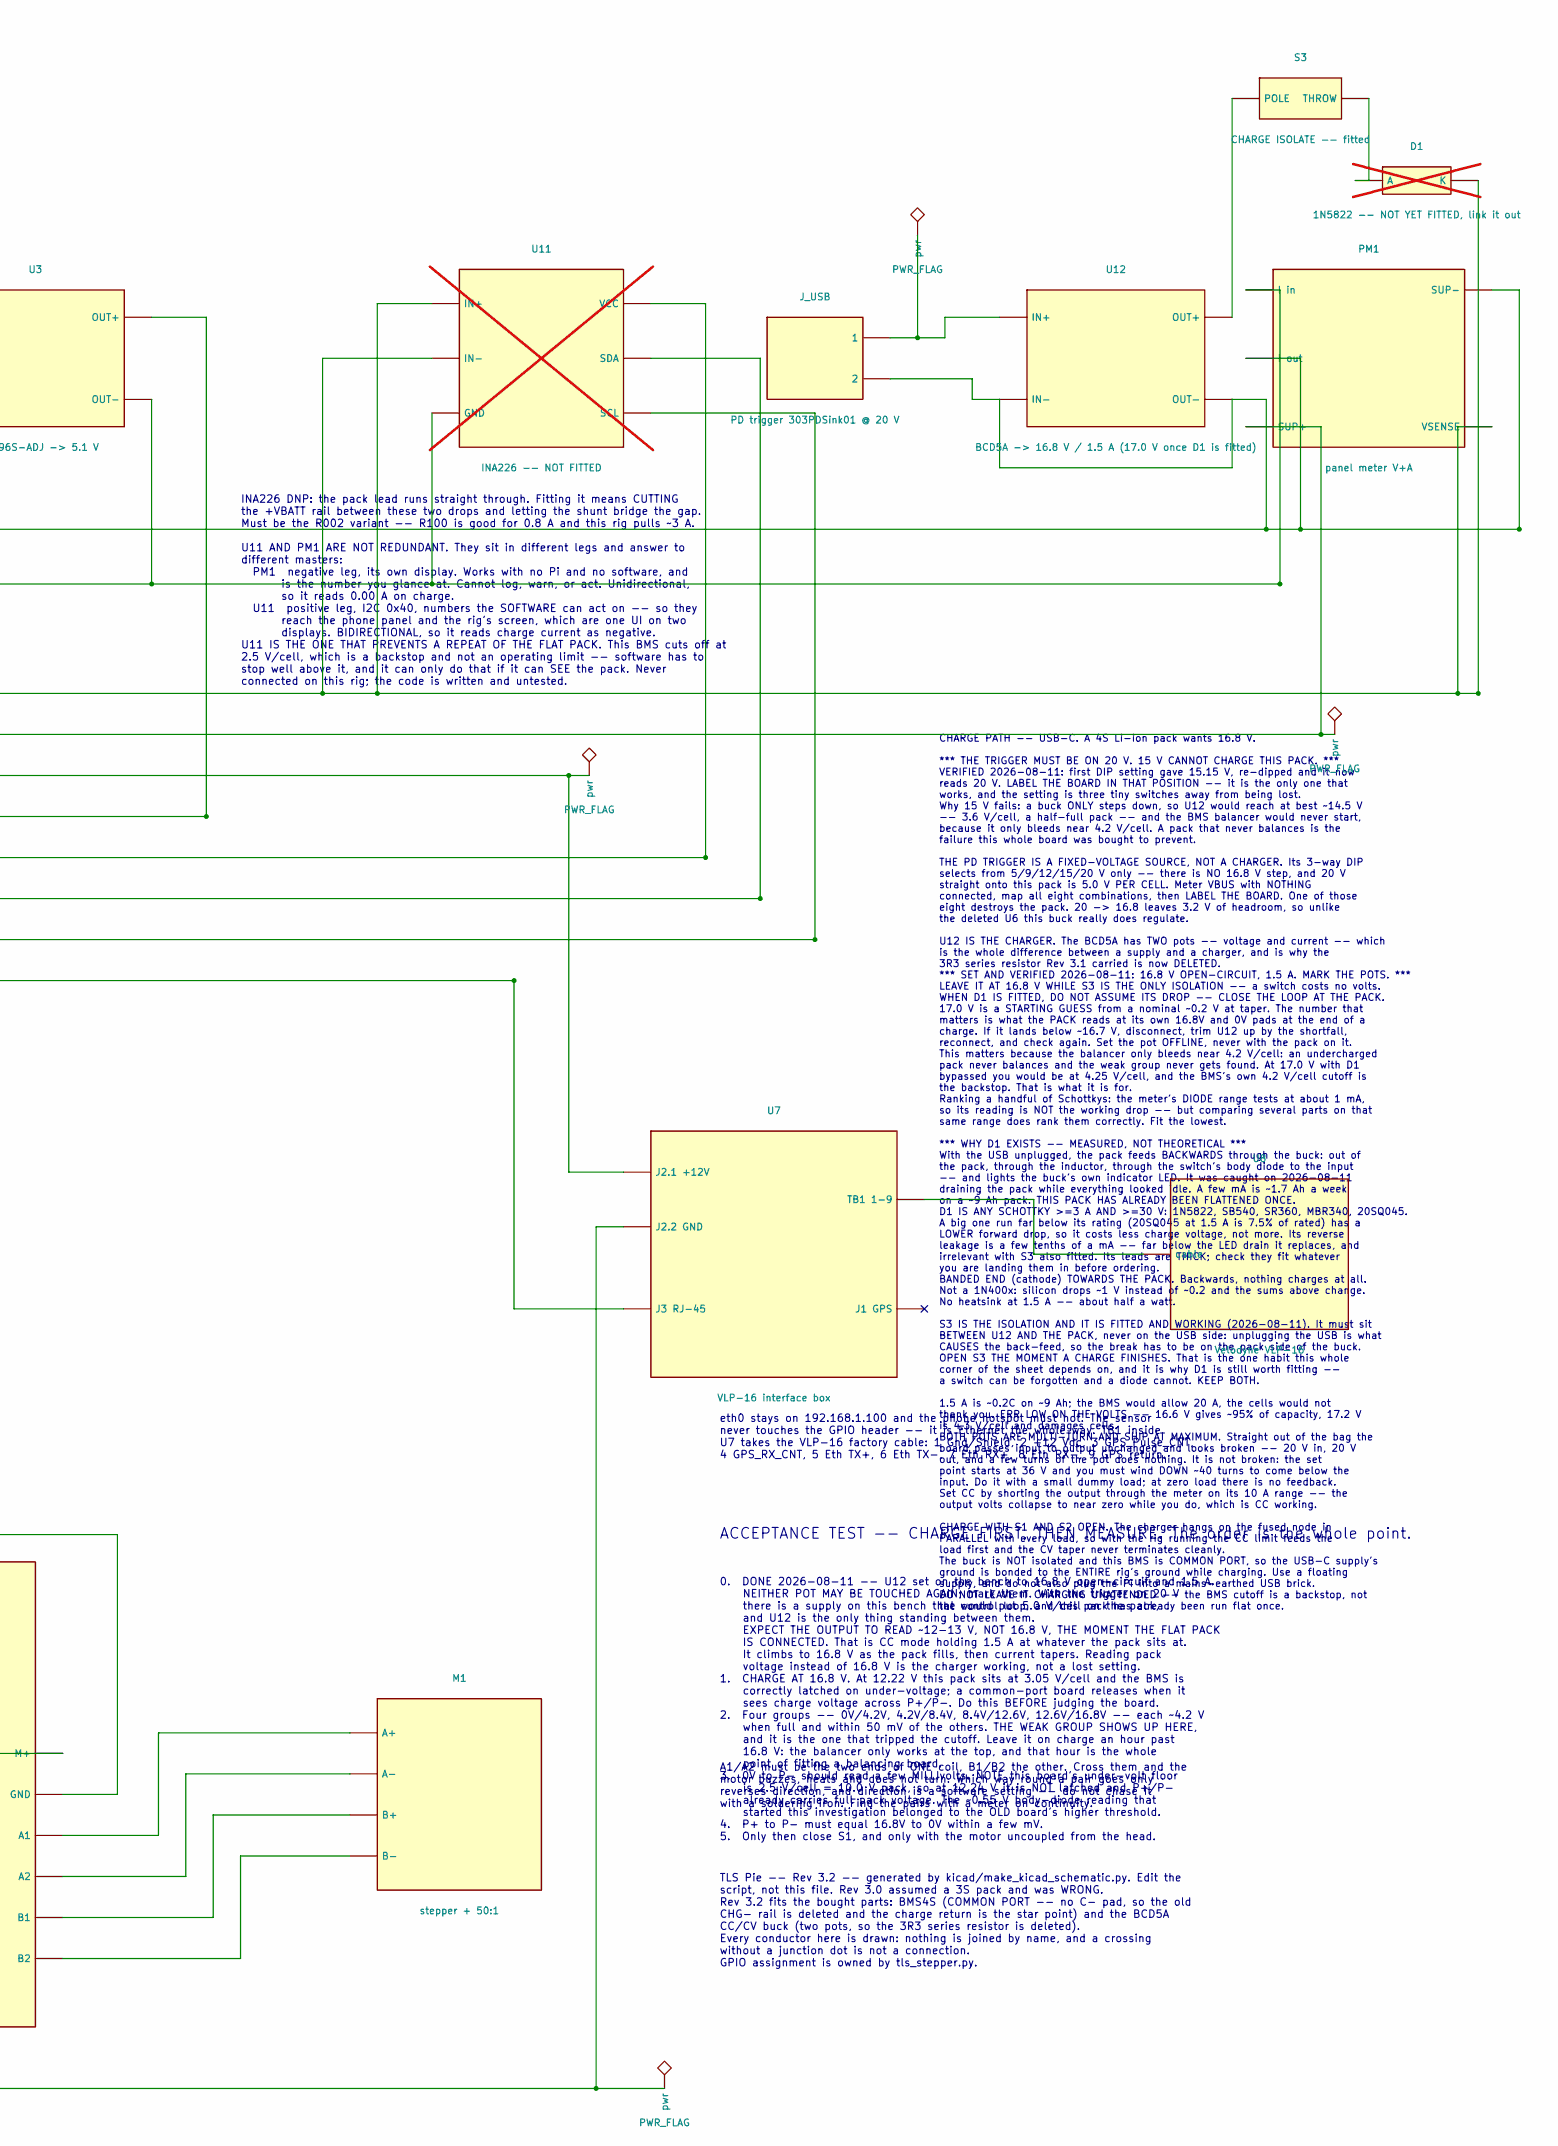
[picture p11: schematic TLS_Pie.kicad_sch, part in row 1, column 2]

Parts:
BMS1: BMS4S 40A common port + balance
BT1: 4S3P Li-ion
D1: 1N5822 -- NOT YET FITTED, link it out; not fitted
F1: 6 A
JP1: Raspberry Pi 4B
J_USB: PD trigger 303PDSink01 @ 20 V
M1: stepper + 50:1
PM1: panel meter V+A
R_DR: 1k
R_EN: 1k
R_PU: 10k
R_ST: 1k
S1: MAIN -- latching, the shutdown switch
S2: LIDAR
S3: CHARGE ISOLATE -- fitted
U1: DS3231 breakout
U3: LM2596S-ADJ -> 5.1 V
U4: Big Easy Driver
U7: VLP-16 interface box
U8: Velodyne VLP-16
U10: fan 5 V
U11: INA226 -- NOT FITTED; not fitted
U12: BCD5A -> 16.8 V / 1.5 A (17.0 V once D1 is fitted)

Connections:
+3V3: JP1.1 (3V3), U1.1 (Vin), U11.4 (VCC)
+5V: JP1.2 (5V), JP1.4 (5V), U3.1 (OUT+), U10.1 (+)
+VBATT: D1.2 (K), F1.2, PM1.5 (VSENSE), S1.1 (POLE), S2.1 (POLE), U11.1 (IN+), U11.2 (IN-)
+VSW1: PM1.3 (SUP+), S1.2 (THROW), U3.4 (IN+), U4.11 (M+)
+VSW2: S2.2 (THROW), U7.1 (J2.1 +12V)
ETH: JP1.ETH (eth0), U7.3 (J3 RJ-45)
GND: JP1.6 (GND), JP1.9 (GND), JP1.39 (GND), PM1.1 (I in), U1.2 (GND), U3.2 (OUT-), U3.3 (IN-), U4.1 (GND), U4.12 (GND), U7.2 (J2.2 GND), U10.2 (-), U11.3 (GND)
unnamed: BMS1.1 (16.8V), BT1.1 (16.8V)
unnamed: BMS1.2 (12.6V), BT1.2 (12.6V)
unnamed: BMS1.3 (8.4V), BT1.3 (8.4V)
unnamed: BMS1.4 (4.2V), BT1.4 (4.2V)
unnamed: BMS1.5 (0V), BT1.5 (0V)
unnamed: BMS1.6 (P+), F1.1
unnamed: D1.1 (A), S3.2 (THROW)
unnamed: JP1.33 (GPIO13), R_EN.1
unnamed: JP1.35 (GPIO19), R_ST.1
unnamed: JP1.37 (GPIO26), R_DR.1
unnamed: J_USB.1, U12.4 (IN+)
unnamed: M1.1 (A+), U4.13 (A1)
unnamed: M1.2 (A-), U4.14 (A2)
unnamed: M1.3 (B+), U4.15 (B1)
unnamed: M1.4 (B-), U4.16 (B2)
unnamed: R_DR.2, U4.2 (DIR)
unnamed: R_EN.2, R_PU.2, U4.4 (ENABLE)
unnamed: R_PU.1, U4.5 (VCC)
unnamed: R_ST.2, U4.3 (STEP)
unnamed: S3.1 (POLE), U12.1 (OUT+)
unnamed: U7.4 (TB1 1-9), U8.1
P-: BMS1.7 (P-), J_USB.2, PM1.2 (I out), PM1.4 (SUP-), U12.2 (OUT-), U12.3 (IN-)
SCL: JP1.5 (GPIO3 SCL), U1.3 (SCL), U11.6 (SCL)
SDA: JP1.3 (GPIO2 SDA), U1.4 (SDA), U11.5 (SDA)

Notes on the sheet:
ZONE A POWER CHAIN 4S3P pack, common-port balancing BMS, USB-C charge
*** THE SWITCHES: S1 = MAIN POWER, S2 = LIDAR. *** They hang off the fused node in PARALLEL, so opening S1 kills the Pi and the motor and leaves the VLP-16 running on S2. "Everything off" means BOTH switches. SETTLED 2026-08-13, DO NOT REOPEN: there is no separate E-stop and none is wanted. S1 is t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
CONNECT THE TAPS IN THIS ORDER: 0V 4.2V 8.4V 12.6V 16.8V The board names its pads by voltage, and those are FULL-CHARGE values -- NOT what a flat pack measures. Against 0V at the measured 12.24 V total you should read roughly: 0 / 3.06 / 6.12 / 9.18 / 12.24 V. WHAT MATTERS IS THE ORDER, evenly spac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
PANEL METER PM1 -- and it changes the ground topology, so read this. ITS THICK PAIR IS THE SHUNT, AND THE SHUNT IS IN THE NEGATIVE LEG. So it goes in the RETURN, between the rig's ground and P- -- NOT in the +VBATT rail where U11 goes. GND and P- are now separate nodes joined ONLY through PM1. They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
INA226 DNP: the pack lead runs straight through. Fitting it means CUTTING the +VBATT rail between these two drops and letting the shunt bridge the gap. Must be the R002 variant -- R100 is good for 0.8 A and this rig pulls ~3 A. U11 AND PM1 ARE NOT REDUNDANT. They sit in different legs and answer to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
CHARGE PATH -- USB-C. A 4S Li-ion pack wants 16.8 V. *** THE TRIGGER MUST BE ON 20 V. 15 V CANNOT CHARGE THIS PACK. *** VERIFIED 2026-08-11: first DIP setting gave 15.15 V, re-dipped and it now reads 20 V. LABEL THE BOARD IN THAT POSITION -- it is the only one that works, and the setting is three t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
ZONE B THE PI AND ITS BUS
Vin from header pin 1 (3V3), NEVER pin 2 or 4. This board's I2C pull-ups reference Vin, so 5 V on Vin puts 5 V on GPIO2 and GPIO3, which are not 5 V tolerant. Check before trusting it: power the board with SDA and SCL not yet fitted and measure SDA to GND -- it must read about 3.3 V. BAT / 32K / SQ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
eth0 stays on 192.168.1.100 and the phone hotspot must not. The sensor never touches the GPIO header -- it is Ethernet the whole way. TB1 inside U7 takes the VLP-16 factory cable: 1 Gnd/Shield, 2 +12 Vdc, 3 GPS_Pulse_CNT, 4 GPS_RX_CNT, 5 Eth TX+, 6 Eth TX-, 7 Eth RX+, 8 Eth RX-, 9 GPS return.
ZONE C MOTOR CHAIN M+ now sees up to 16.8 V, still inside 8-35 V
NO, THE MOTOR DOES NOT NEED A 12 V BUCK. U6 STAYS DELETED. A stepper's "12 V" rating is just I_rated x R_phase -- the volts you would need with NO chopping. U4 is a current-CHOPPING driver: it PWMs the supply to hold the coil at whatever CUR ADJ is set to, so the supply sets how FAST current rises,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
R_PU is the gating item -- nothing turns until it is fitted. Every Pi GPIO floats as an input for the ~30 s the Pi takes to boot, and ENABLE is active-low. Without this the driver can sit energised through the whole of boot with nothing in control of it. It goes on the DRIVER side of R_EN and pulls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
A1/A2 must be the two ends of ONE coil, B1/B2 the other. Cross them and the motor buzzes, heats and does not turn. Which way round a pair goes only reverses direction, and direction is a software setting -- do not chase it with a soldering iron. Find the pairs with a meter on continuity.
ACCEPTANCE TEST -- CHARGE FIRST, THEN MEASURE. The order is the whole point.
0. DONE 2026-08-11 -- U12 set on the bench to 16.8 V open-circuit and 1.5 A. NEITHER POT MAY BE TOUCHED AGAIN; mark them. With the trigger on 20 V there is a supply on this bench that would put 5.0 V/cell on the pack, and U12 is the only thing standing between them. EXPECT THE OUTPUT TO READ ~12-13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
TLS Pie -- Rev 3.2 -- generated by kicad/make_kicad_schematic.py. Edit the script, not this file. Rev 3.0 assumed a 3S pack and was WRONG. Rev 3.2 fits the bought parts: BMS4S (COMMON PORT -- no C- pad, so the old CHG- rail is deleted and the charge return is the star point) and the BCD5A CC/CV buc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
