Kizim01/Kizim-TLS-Pie/Raspberry Pie4/TLS-Pie/tls_web.py

#!/usr/bin/env python3
"""
Phone control panel for the TLS Pie scanner.

Serves a touch-sized web UI from the Pi so the whole scanner runs from a phone:
start either scan, stop one in progress, restart the head after an abort, and
watch live status, progress, capture size and an optional point-cloud preview.

This replaces the display capability lost with the MicroView OLED and the
monitor, and improves on both -- a 64x48 OLED could never show elapsed time,
capture size, or what the lidar is actually seeing.

DESIGN
------
Standard library only. No Flask, no pip install, nothing to break on a field
rig. The server runs as a daemon thread inside tls_scan.py rather than as a
separate process, so it shares scanner state directly instead of guessing at it
through a file, and its stop button raises the same flag the physical stop
button does. One abort path, not two.

The UI polls /api/status once a second. Commands are POSTs that set a flag; the
scan loop acts on them. The web thread never touches pigpio.

NETWORK EXPOSURE -- READ THIS
-----------------------------
By default this binds to 0.0.0.0, so anyone who can reach the Pi on the network
can start the motor. On a phone hotspot with just you and the Pi that is fine.
On a shared site network it is not. Set TLSPIE_WEB_TOKEN to require a token,
which the UI keeps in the URL:

    TLSPIE_WEB_TOKEN=somethingLong ./tls_scan.py
    http://raspberrypi.local:8080/?t=somethingLong

A shared secret over plain HTTP stops a bystander, nothing more.

SAFETY
------
The stop button here is software, exactly like the GPIO stop button, with the
same limit: if the controlling process dies, pigpio's DMA engine keeps clocking
step pulses and nothing in this file can intervene. S1, the main power switch,
is what covers that case. No separate E-stop is fitted and none is wanted --
settled 2026-08-13, do not re-suggest one.
"""

import json
import math
import os
import socket
import struct
import subprocess
import threading
import time
import zlib
from http.server import BaseHTTPRequestHandler, ThreadingHTTPServer
from urllib.parse import urlparse, parse_qs

# Power telemetry. Imported defensively: a panel that will not start because a
# battery gauge is unhappy would be a worse rig than one with no gauge at all,
# and this is the only software abort on the machine.
try:
    import tls_power
except Exception:                                            # pragma: no cover
    tls_power = None

# Scan storage. Same defensive import for the same reason: the panel is the
# only software abort on this rig and must come up even if a USB stick is
# behaving badly.
try:
    import tls_storage
except Exception:                                            # pragma: no cover
    tls_storage = None

WEB_HOST = os.environ.get("TLSPIE_WEB_HOST", "0.0.0.0")
WEB_PORT = int(os.environ.get("TLSPIE_WEB_PORT", "8080"))
WEB_TOKEN = os.environ.get("TLSPIE_WEB_TOKEN", "")

# The boot intro, played full-screen by the rig's own panel while the rest of
# the page settles. Absent is a perfectly normal state -- the panel skips it.
SPLASH_VIDEO = os.environ.get(
    "TLSPIE_SPLASH_VIDEO",
    os.path.join(os.path.dirname(os.path.abspath(__file__)), "splash", "intro.mp4"))

# --- the intro flag ----------------------------------------------------------
#
# tls_kiosk_launch.sh creates this file before it starts chromium and deletes it
# when mpv exits, so the panel can hold a black curtain over itself for exactly
# as long as the intro is on screen. The kiosk launcher and this server are
# different processes under different users, and a file is the smallest thing
# that carries one bit between them without inventing a protocol.
#
# ⛔ THE STALENESS CHECK IS THE SAFETY FEATURE, not tidiness. The curtain covers
# the whole screen including STOP. If the launcher is killed between creating
# the flag and removing it -- SIGKILL, a crash, a yanked power lead mid-boot --
# a plain existence check would black out the panel on every boot thereafter,
# and the only cure would be an SSH session the operator may not have. The
# window is generous against a slow cold boot and still far shorter than the
# time it takes to walk to the rig.
#
# The path is the kiosk's own runtime directory, not /run: this server runs as
# root but the launcher runs as `lipi`, and /run is not writable by it. Same
# hardcoded uid as tls-kiosk.service's XDG_RUNTIME_DIR, and for the same reason
# -- there is exactly one login user on this machine. Override in both places
# together if that ever stops being true.
INTRO_FLAG = os.environ.get("TLSPIE_INTRO_FLAG",
                            "/run/user/1000/tlspie-intro-playing")
INTRO_FLAG_MAX_AGE = 120.0


def intro_playing():
    """True while the boot intro is on screen. Never raises: a status poll that
    could 500 on a stat() is a panel that goes OFFLINE because of a decoration."""
    try:
        return (time.time() - os.path.getmtime(INTRO_FLAG)) < INTRO_FLAG_MAX_AGE
    except Exception:
        return False


class ScannerState:
    """
    Shared state between the scan loop and the web thread.

    Every field is guarded by one lock. The scan loop writes; the web thread
    reads snapshots and raises request flags the scan loop consumes.
    """

    def __init__(self, profiles, cloud=None, builder=None, dumpdir=None):
        self._lock = threading.Lock()
        self.profiles = profiles
        self.cloud = cloud
        # The stored-scan library. Optional so tls_web stays usable on its own
        # and so the tests can drive a panel with no filesystem behind it.
        self.builder = builder
        self.dumpdir = dumpdir

        self.phase = "IDLE"            # IDLE PREFLIGHT RECORDING SCANNING
                                       # RETURNING COMPLETE ABORTED HOMING
        # Set at PREFLIGHT by tls_storage.choose_dumpdir(). Needs a default
        # here so snapshot() can read it before the first scan.
        self.recording_to_usb = False
        self.message = "Waiting"
        self.profile = None
        self.started_at = None
        self.expected_s = None
        self.capture_file = None
        self.last_capture = None
        self.position_known = True
        self.busy = False

        self._start_request = None
        self._stop_request = False
        self._restart_request = False

    # --- written by the scan loop -------------------------------------
    def set(self, phase=None, message=None, **fields):
        with self._lock:
            if phase is not None:
                self.phase = phase
            if message is not None:
                self.message = message
            for key, value in fields.items():
                setattr(self, key, value)

    def begin_scan(self, profile_name, expected_s):
        with self._lock:
            self.busy = True
            self.profile = profile_name
            self.started_at = time.time()
            self.expected_s = expected_s
            self.capture_file = None
            self._stop_request = False

    def end_scan(self):
        with self._lock:
            self.busy = False
            self.profile = None
            self.started_at = None
            self.expected_s = None
            self._stop_request = False
            self._start_request = None

    # --- consumed by the scan loop ------------------------------------
    def take_start_request(self):
        with self._lock:
            profile, self._start_request = self._start_request, None
            return profile

    def take_restart_request(self):
        with self._lock:
            wanted, self._restart_request = self._restart_request, False
            return wanted

    def stop_requested(self):
        with self._lock:
            return self._stop_request

    # --- raised by the web thread -------------------------------------
    def request_start(self, profile_name):
        with self._lock:
            if self.busy:
                return False, "A scan is already running"
            if profile_name not in self.profiles:
                return False, "Unknown scan"
            self._start_request = profile_name
            return True, "Starting"

    def request_stop(self):
        """
        Stop whatever is moving the head -- and only while something is.

        ⛔ A PRESS WITH NOTHING RUNNING IS REFUSED, NOT REMEMBERED. The flag is
        cleared when a scan begins and when it ends, and nowhere else, so a
        press that landed while idle sat there until the next thing that asked.
        The panel shows STOP for up to a second after a scan ends (it polls at
        1 Hz), and a second phone or a stale page can post it at any time. A
        scan's start cleared it; Restart did not, so Restart stopped on its
        first poll, drove nothing, and reported itself interrupted (the 45th
        pass's sweep, reproduced). Every move the head makes runs with `busy`
        set -- a scan, its turn back after a stop, and a Restart -- so this
        refuses nothing that could be stopped.
        """
        with self._lock:
            if not self.busy:
                return False, "Nothing is running"
            self._stop_request = True
            return True, "Stopping"

    def clear_stop(self):
        """
        Forget a stop that has been acted on, so the next press is heard.

        A stopped scan turns the head back to where it started, and that move
        has to be stoppable as well. Left set, the press that ended the sweep
        would end the return before its first step.
        """
        with self._lock:
            self._stop_request = False

    def request_restart(self):
        with self._lock:
            if self.busy:
                return False, "Stop the scan first"
            self._restart_request = True
            return True, "Restarting"

    # --- read by the web thread ---------------------------------------
    def scan_roots(self):
        """
        Every directory the scan library should read.

        Scans live wherever the drive was at the time, so this is the SD card
        plus the USB stick when one is mounted. Resolved per call rather than
        cached: a stick can be plugged in or ejected between two page loads, and
        a library that needed a restart to notice would be worse than no USB
        support at all.

        Deliberately takes no lock -- it only reads self.dumpdir, which is set
        once at construction, and it shells out to the filesystem. Holding the
        state lock across a mount check would let a slow stick stall the scan
        loop.
        """
        if tls_storage is None or self.dumpdir is None:
            return self.dumpdir
        try:
            return tls_storage.roots(sd_dumpdir=self.dumpdir)
        except Exception:                                    # pragma: no cover
            return self.dumpdir

    def snapshot(self):
        # ⛔⛔ THE LOCK COVERS THE FIELDS, NOT THE PROBES. This used to hold the
        # state lock while it asked the USB stick for its free space, the
        # power chip for its voltage, the builder for its progress and the
        # disk for the capture's size -- and STOP, the stop flag the motor
        # polls, and so the watchdog's own loop, all wait on that same lock.
        # A stick stalling one stat() stalled the only software stop the rig
        # has (the 45th pass's sweep, `tls_web.py:283`). The fields are copied
        # under the lock; everything that can block is asked once it is free.
        with self._lock:
            elapsed = progress = remaining = None
            if self.started_at is not None:
                elapsed = time.time() - self.started_at
                if self.expected_s:
                    progress = max(0.0, min(1.0, elapsed / self.expected_s))
                    remaining = max(0.0, self.expected_s - elapsed)
            capture_file, builder = self.capture_file, self.builder
            dumpdir = self.dumpdir

            out = {
                "phase": self.phase,
                "message": self.message,
                "profile": self.profile,
                "profileLabel": (self.profiles.get(self.profile, {}).get("label")
                                 if self.profile else None),
                "busy": self.busy,
                "elapsed": elapsed,
                "remaining": remaining,
                "expected": self.expected_s,
                "progress": progress,
                "captureFile": (os.path.basename(self.capture_file)
                                if self.capture_file else None),
                "captureBytes": None,           # asked below, unlocked
                "lastCapture": (os.path.basename(self.last_capture)
                                if self.last_capture else None),
                "positionKnown": self.position_known,
                "stopPending": self._stop_request,
                "preview": self.cloud is not None,
                "library": self.dumpdir is not None,
                "build": None,                  # these are asked below,
                "power": None,                  # once the lock is free
                "storage": None,
                "recordingToUsb": self.recording_to_usb,
                "introPlaying": None,
                "scans": [
                    {"id": key, "label": value["label"], "detail": value["detail"]}
                    for key, value in sorted(
                        self.profiles.items(), key=lambda kv: kv[1]["order"])
                ],
            }
        size = None
        if capture_file:
            try:
                size = os.path.getsize(capture_file)
            except OSError:
                size = None
        out["captureBytes"] = size
        out["build"] = builder.status() if builder is not None else None
        out["power"] = tls_power.read() if tls_power is not None else None
        out["storage"] = (tls_storage.status(sd_dumpdir=dumpdir)
                          if tls_storage is not None else None)
        # Cheap: one stat() per poll, and only the rig's own screen acts on
        # it. The phone ignores the field entirely.
        out["introPlaying"] = intro_playing()
        return out


# ---------------------------------------------------------------------------
# Home-screen icon and web app manifest
# ---------------------------------------------------------------------------
# Without these, Android's "Add to Home screen" gives you a browser bookmark
# wearing a thumbnail of the page. With them you get a named icon that opens
# straight into the panel.
#
# Both are generated at runtime rather than committed as files: the rig has no
# Pillow, and a binary blob in git is a thing nobody can review or diff.
#
# NOTE ON FULL SCREEN. A true standalone install -- own icon, own entry in the
# recents list, no address bar -- additionally requires a SECURE ORIGIN, and
# this server is plain HTTP on a hotspot. A self-signed certificate does not
# help; Chrome wants a valid one. So the manifest gets you the icon and the
# name, and the page's own "Full screen" button (Fullscreen API, which does
# work over HTTP) gets you the chrome-free display. Between them the result is
# indistinguishable in use from an installed app.

ICON_BG = (0x05, 0x06, 0x0A)      # matches the page background and theme-color
ICON_ACCENT = (0x0A, 0x84, 0xFF)  # matches --blue

_icon_cache = {}
_icon_lock = threading.Lock()


def _png_chunk(tag, data):
    return (struct.pack(">I", len(data)) + tag + data
            + struct.pack(">I", zlib.crc32(tag + data) & 0xFFFFFFFF))


def render_icon(size):
    """
    Draw the launcher icon as a PNG: three concentric range rings and a sweep
    spoke on a dark ground -- a plan view of what the instrument does, and the
    same thing the preview canvas draws.

    Everything stays inside the central 72% so Android can mask the icon to a
    circle, a squircle or a teardrop without clipping anything that matters.

    Pure stdlib. The pixel loop is skipped entirely outside the artwork disc,
    which is most of the image, and the result is cached -- it runs once per
    size for the life of the process.
    """
    centre = (size - 1) / 2.0
    rings = ((0.150, 1.00), (0.245, 0.62), (0.340, 0.34))  # radius frac, alpha
    half = size * 0.011               # half the ring line thickness
    dot = size * 0.038                # centre marker
    spoke_from, spoke_to = size * 0.055, size * 0.352
    spoke_half = size * 0.010
    limit = size * 0.368              # nothing is drawn beyond this radius

    bg_row = bytes(ICON_BG) * size
    raw = bytearray()

    for y in range(size):
        raw.append(0)                 # PNG filter type 0 for this scanline
        dy = y - centre
        if abs(dy) > limit:
            raw.extend(bg_row)        # fast path: this row is entirely ground
            continue

        row = bytearray(bg_row)
        span = math.sqrt(limit * limit - dy * dy)
        for x in range(max(0, int(centre - span)),
                       min(size, int(centre + span) + 2)):
            dx = x - centre
            r = math.hypot(dx, dy)

            cover = 0.0
            for frac, alpha in rings:
                # 1px feather either side, so the curves are not stepped
                a = alpha * min(max(1.0 - (abs(r - frac * size) - half), 0.0), 1.0)
                if a > cover:
                    cover = a

            # the sweep spoke, up and to the right at 45 degrees
            proj = (dx - dy) * 0.70710678
            if spoke_from <= proj <= spoke_to:
                a = min(max(1.0 - (abs(dx + dy) * 0.70710678 - spoke_half),
                            0.0), 1.0)
                if a > cover:
                    cover = a

            px = [int(ICON_BG[i] + (ICON_ACCENT[i] - ICON_BG[i]) * cover + 0.5)
                  for i in range(3)]

            white = min(max(1.0 - (r - dot), 0.0), 1.0)
            if white > 0.0:
                px = [int(px[i] + (255 - px[i]) * white + 0.5) for i in range(3)]

            row[3 * x:3 * x + 3] = bytes(px)

        raw.extend(row)

    header = struct.pack(">IIBBBBB", size, size, 8, 2, 0, 0, 0)  # 8-bit RGB
    return (b"\x89PNG\r\n\x1a\n"
            + _png_chunk(b"IHDR", header)
            + _png_chunk(b"IDAT", zlib.compress(bytes(raw), 9))
            + _png_chunk(b"IEND", b""))


def icon(size):
    """Cached render_icon. First call for a size costs about a second on a Pi."""
    with _icon_lock:
        if size not in _icon_cache:
            _icon_cache[size] = render_icon(size)
        return _icon_cache[size]


def manifest():
    """
    The web app manifest. start_url carries the token if one is set, otherwise
    the home-screen icon would open a page that answers 403.
    """
    return {
        "name": "TLS Scanner",
        "short_name": "TLS",
        "description": "Control panel for the TLS Pie terrestrial laser scanner",
        "start_url": ("/?t=" + WEB_TOKEN) if WEB_TOKEN else "/",
        "scope": "/",
        "display": "standalone",
        "orientation": "portrait",
        "background_color": "#05060a",
        "theme_color": "#05060a",
        "icons": [
            {"src": "/icon-192.png", "sizes": "192x192",
             "type": "image/png", "purpose": "any"},
            {"src": "/icon-512.png", "sizes": "512x512",
             "type": "image/png", "purpose": "any"},
            {"src": "/icon-512.png", "sizes": "512x512",
             "type": "image/png", "purpose": "maskable"},
        ],
    }


PAGE = """<!doctype html>
<html lang="en"><head>
<meta charset="utf-8">
<meta name="viewport" content="width=device-width,initial-scale=1,viewport-fit=cover,user-scalable=no">
<meta name="theme-color" content="#05060a">
<meta name="apple-mobile-web-app-capable" content="yes">
<meta name="apple-mobile-web-app-status-bar-style" content="black-translucent">
<meta name="mobile-web-app-capable" content="yes">
<meta name="application-name" content="TLS Scanner">
<link rel="manifest" href="/manifest.webmanifest">
<link rel="icon" type="image/png" sizes="192x192" href="/icon-192.png">
<link rel="apple-touch-icon" href="/icon-180.png">
<title>TLS Scanner</title>
<style>
  :root{
    --blue:#0A84FF; --red:#FF453A; --green:#30D158; --orange:#FF9F0A;
    --purple:#BF5AF2; --teal:#40C8E0; --grey:#8E8E93;
    --text:#F5F5F7; --dim:rgba(235,235,245,.62); --faint:rgba(235,235,245,.32);
    --glass:rgba(255,255,255,.07);
    --edge:rgba(255,255,255,.14);
    --hi:rgba(255,255,255,.20);
  }
  *{box-sizing:border-box;-webkit-tap-highlight-color:transparent}
  html,body{height:100%}
  body{
    margin:0;background:#05060a;color:var(--text);
    font-family:-apple-system,BlinkMacSystemFont,"SF Pro Text","SF Pro Display",
      system-ui,"Segoe UI",Roboto,sans-serif;
    -webkit-font-smoothing:antialiased;
    padding:max(18px,env(safe-area-inset-top)) 18px
            calc(28px + env(safe-area-inset-bottom));
    max-width:560px;margin:0 auto;position:relative;overflow-x:hidden;
  }
  /* the wallpaper the glass blurs over */
  body::before{
    content:"";position:fixed;inset:-25%;z-index:-1;pointer-events:none;
    background:
      radial-gradient(46% 34% at 18% 8%, rgba(10,132,255,.42), transparent 62%),
      radial-gradient(42% 32% at 88% 22%, rgba(191,90,242,.34), transparent 62%),
      radial-gradient(52% 38% at 62% 92%, rgba(64,200,224,.24), transparent 60%),
      #05060a;
    filter:saturate(122%);
  }

  .hdr{display:flex;align-items:baseline;justify-content:space-between;
    margin:2px 2px 18px;gap:12px}
  .hdr h1{font-size:30px;font-weight:700;letter-spacing:-.024em;margin:0;
    font-family:-apple-system,BlinkMacSystemFont,"SF Pro Display",sans-serif}
  .hdrend{display:flex;align-items:baseline;gap:10px;flex:none}
  .hdr .rev{font-size:12px;color:var(--faint);letter-spacing:.02em;
    font-variant-numeric:tabular-nums}
  .hdr .fs{appearance:none;-webkit-appearance:none;font:inherit;font-size:12px;
    color:var(--dim);background:var(--glass);border:1px solid var(--edge);
    border-radius:9px;padding:5px 10px;letter-spacing:.01em;white-space:nowrap}
  .hdr .fs:active{background:var(--hi)}

  .card{
    background:var(--glass);
    -webkit-backdrop-filter:blur(30px) saturate(180%);
    backdrop-filter:blur(30px) saturate(180%);
    border:.5px solid var(--edge);border-radius:24px;
    padding:20px;margin-bottom:14px;
    box-shadow:0 12px 40px rgba(0,0,0,.42),
               inset 0 .5px 0 var(--hi);
  }

  .statusline{display:flex;align-items:center;gap:11px}
  .dot{width:11px;height:11px;border-radius:50%;flex:0 0 auto;
    background:var(--grey);box-shadow:0 0 14px currentColor}
  .dot.live{animation:breathe 1.6s ease-in-out infinite}
  @keyframes breathe{0%,100%{opacity:1;transform:scale(1)}
                     50%{opacity:.4;transform:scale(.82)}}
  @media (prefers-reduced-motion:reduce){.dot.live{animation:none}}
  .phase{font-size:15px;font-weight:600;letter-spacing:.10em;
    text-transform:uppercase}
  .msg{font-size:15px;color:var(--dim);line-height:1.42;margin-top:11px}
  .prof{font-size:13px;color:var(--faint);margin-top:4px}

  .bar{height:8px;background:rgba(255,255,255,.10);border-radius:99px;
    overflow:hidden;margin:18px 0 9px}
  .bar>div{height:100%;width:0;border-radius:99px;
    transition:width .8s cubic-bezier(.4,0,.2,1)}
  .times{display:flex;justify-content:space-between;font-size:13px;
    color:var(--faint);font-variant-numeric:tabular-nums}

  .stack{display:flex;flex-direction:column;gap:11px}
  button{
    font:inherit;font-weight:600;width:100%;cursor:pointer;
    border-radius:20px;border:.5px solid var(--edge);
    background:var(--glass);
    -webkit-backdrop-filter:blur(30px) saturate(180%);
    backdrop-filter:blur(30px) saturate(180%);
    color:var(--text);padding:19px 20px;text-align:left;line-height:1.25;
    box-shadow:inset 0 .5px 0 var(--hi);
    transition:transform .12s ease, opacity .18s ease;
  }
  button:active{transform:scale(.975)}
  button:disabled{opacity:.32;cursor:not-allowed}
  button:focus-visible{outline:3px solid var(--blue);outline-offset:3px}
  button .lbl{display:block;font-size:19px;letter-spacing:-.012em}
  button .det{display:block;font-size:13.5px;color:var(--dim);
    font-weight:400;margin-top:4px}

  .go{background:linear-gradient(180deg,rgba(10,132,255,.34),rgba(10,132,255,.20));
    border-color:rgba(10,132,255,.52)}
  .go .det{color:rgba(255,255,255,.72)}
  .stop{background:linear-gradient(180deg,rgba(255,69,58,.42),rgba(255,69,58,.26));
    border-color:rgba(255,69,58,.62);text-align:center;padding:26px 20px}
  .stop .lbl{font-size:23px;font-weight:700;letter-spacing:.05em}
  .stop .det{color:rgba(255,255,255,.76)}
  .restart{text-align:center}
  .restart .lbl{font-size:17px}

  /* Shut down. Deliberately QUIETER than .stop, which is filled red and 23px:
     STOP is the safety control and has to be the loudest thing on the screen,
     and a power button that shouts just as loudly next to it is a hazard
     under time pressure. This one is outlined, and buys its safety from a
     second tap rather than from size. Arming it fills it in, so "one more tap
     and the rig goes off" is visible from arm's length. */
  .power{text-align:center;background:rgba(255,69,58,.10);
    border-color:rgba(255,69,58,.40)}
  .power .lbl{font-size:17px;color:#FF9A93}
  .power.armed{background:rgba(255,69,58,.34);
    border-color:rgba(255,69,58,.78)}
  .power.armed .lbl{color:#fff}

  /* Reboot is amber, not red. It is recoverable -- the rig comes back on its
     own -- and colouring it identically to the one irreversible control on the
     page would flatten exactly the distinction that matters when they sit a
     finger-width apart. */
  .power.reboot{background:rgba(255,159,10,.10);
    border-color:rgba(255,159,10,.40)}
  .power.reboot .lbl{color:#FFC46B}
  .power.reboot.armed{background:rgba(255,159,10,.32);
    border-color:rgba(255,159,10,.78)}
  .power.reboot.armed .lbl{color:#fff}

  .kv{display:flex;justify-content:space-between;gap:14px;font-size:14.5px;
    padding:11px 0;border-bottom:.5px solid rgba(255,255,255,.09)}
  .kv:last-child{border-bottom:0;padding-bottom:0}
  .kv:first-child{padding-top:0}
  .kv span:first-child{color:var(--faint)}
  .kv span:last-child{font-variant-numeric:tabular-nums;text-align:right;
    word-break:break-all}

  .banner{border-radius:18px;padding:14px 17px;margin-bottom:14px;
    font-size:14px;line-height:1.45;border:.5px solid;
    -webkit-backdrop-filter:blur(24px);backdrop-filter:blur(24px)}
  .banner.warn{border-color:rgba(255,159,10,.5);color:#FFD08A;
    background:rgba(255,159,10,.13)}

  .cvwrap{position:relative;border-radius:18px;overflow:hidden;
    background:rgba(0,0,0,.34);border:.5px solid rgba(255,255,255,.09)}
  canvas{display:block;width:100%;height:auto}
  .cvmeta{position:absolute;left:13px;bottom:11px;font-size:11.5px;
    color:var(--faint);font-variant-numeric:tabular-nums;
    text-shadow:0 1px 3px rgba(0,0,0,.8)}
  .sechead{font-size:12px;letter-spacing:.11em;text-transform:uppercase;
    color:var(--faint);font-weight:600;margin:0 0 13px}

  .foot{color:var(--faint);font-size:12px;text-align:center;
    margin-top:22px;line-height:1.6;padding:0 8px}

  /* ---- stored scans ---- */
  .daygroup{font-size:11.5px;letter-spacing:.1em;text-transform:uppercase;
    color:var(--faint);font-weight:600;margin:15px 0 2px}
  .daygroup:first-child{margin-top:0}
  .srow{display:flex;align-items:center;gap:12px;width:100%;text-align:left;
    padding:13px 0;background:none;border:0;border-bottom:.5px solid
    rgba(255,255,255,.09);color:var(--text);border-radius:0;cursor:pointer}
  /* The row used to be a <button>. It carries a real <button> inside it now,
     and a button inside a button is invalid HTML that browsers silently
     un-nest -- which would put the download control outside the row. */
  .vsliders{position:absolute;left:11px;right:11px;bottom:62px;z-index:6;
    background:rgba(10,12,18,.90);border:.5px solid var(--edge);
    border-radius:15px;padding:11px 13px;display:flex;flex-direction:column;
    gap:9px}
  .vsl{display:flex;align-items:center;gap:10px;font-size:12.5px;
    color:var(--dim)}
  .vsl>span{flex:0 0 78px}
  .vsl>input{flex:1;min-width:0;accent-color:#0A84FF}
  .vsl>b{flex:0 0 62px;text-align:right;color:var(--text);font-weight:600;
    font-variant-numeric:tabular-nums}
  .dl{flex:0 0 auto;width:36px;height:36px;padding:0;border-radius:99px;
    font-size:15px;line-height:1;background:rgba(255,255,255,.07);
    border:.5px solid var(--edge);color:var(--dim)}
  .dl:active{opacity:.55}
  .srow:last-child{border-bottom:0}
  .srow:active{transform:none;opacity:.6}
  .srow .nm{flex:1;min-width:0}
  .srow .t{font-size:15.5px;letter-spacing:-.01em}
  .srow .d{font-size:12.5px;color:var(--faint);margin-top:3px;
    font-variant-numeric:tabular-nums}
  .chip{font-size:10.5px;padding:3px 9px;border-radius:99px;white-space:nowrap;
    border:.5px solid rgba(255,255,255,.18);color:var(--dim);font-weight:600;
    letter-spacing:.03em}
  .chip.ok{border-color:rgba(48,209,88,.45);color:#7DE2A0}
  .chip.busy{border-color:rgba(10,132,255,.5);color:#7CC0FF}
  .chip.warn{border-color:rgba(255,159,10,.5);color:#FFD08A}
  .empty{color:var(--faint);font-size:13.5px;line-height:1.5;padding:2px 0}

  /* ---- 3D viewer ---- */
  #viewer{position:fixed;inset:0;z-index:60;background:#05060A;display:none}
  #viewer.on{display:block}
  #glcv{position:absolute;inset:0;width:100%;height:100%;
    touch-action:none;display:block}
  .vbar{position:absolute;left:0;right:0;display:flex;gap:9px;
    align-items:center;padding:12px 14px;pointer-events:none}
  .vbar > *{pointer-events:auto}
  .vtop{top:0;padding-top:calc(env(safe-area-inset-top,0px) + 12px);
    background:linear-gradient(180deg,rgba(5,6,10,.92),rgba(5,6,10,0))}
  .vbot{bottom:0;padding-bottom:calc(env(safe-area-inset-bottom,0px) + 12px);
    background:linear-gradient(0deg,rgba(5,6,10,.92),rgba(5,6,10,0))}
  .vb{border-radius:13px;border:.5px solid var(--edge);background:var(--glass);
    -webkit-backdrop-filter:blur(24px);backdrop-filter:blur(24px);
    color:var(--text);font:600 14px/1 -apple-system,system-ui,sans-serif;
    padding:12px 15px;text-align:center}
  .vb.wide{flex:1}
  .vb.on{background:linear-gradient(180deg,rgba(10,132,255,.34),rgba(10,132,255,.20));
    border-color:rgba(10,132,255,.55)}
  .vb.danger{background:linear-gradient(180deg,rgba(255,69,58,.42),
    rgba(255,69,58,.26));border-color:rgba(255,69,58,.62)}
  .vtitle{flex:1;font-size:13.5px;color:var(--dim);min-width:0;
    overflow:hidden;text-overflow:ellipsis;white-space:nowrap}
  .vstat{position:absolute;left:14px;
    bottom:calc(env(safe-area-inset-bottom,0px) + 66px);
    font-size:11.5px;color:var(--faint);font-variant-numeric:tabular-nums;
    text-shadow:0 1px 4px #000;pointer-events:none;line-height:1.5}

  /* Narrow and see-through on purpose: nudging a scan is pointless if the
     panel hides the cloud you are lining it up against. The blur keeps the
     text readable over whatever is behind it. */
  .layers{position:absolute;top:0;right:0;bottom:0;width:min(248px,60vw);
    background:rgba(10,12,18,.55);
    -webkit-backdrop-filter:blur(36px) saturate(180%);
    backdrop-filter:blur(36px) saturate(180%);
    border-left:.5px solid var(--edge);overflow-y:auto;z-index:2;
    transform:translateX(101%);transition:transform .22s ease;
    padding:0 14px calc(env(safe-area-inset-bottom,0px) + 20px);
    text-shadow:0 1px 3px rgba(0,0,0,.55)}
  .layers.on{transform:none}
  .lhead{position:sticky;top:0;z-index:1;display:flex;align-items:center;
    gap:10px;margin:0 -14px 4px;padding:calc(env(safe-area-inset-top,0px)
    + 12px) 14px 11px;
    background:linear-gradient(180deg,rgba(10,12,18,.72),rgba(10,12,18,0));
    -webkit-backdrop-filter:blur(12px);backdrop-filter:blur(12px)}
  .lhead .sechead{margin:0;flex:1}
  .lback{padding:8px 13px;border-radius:11px;font-size:13.5px;font-weight:600;
    border:.5px solid var(--edge);background:rgba(255,255,255,.10);
    color:var(--text)}
  .lrow{display:flex;align-items:center;gap:11px;padding:12px 0;
    border-bottom:.5px solid rgba(255,255,255,.09)}
  .sw{width:15px;height:15px;border-radius:5px;flex:none;
    border:.5px solid rgba(255,255,255,.25)}
  .lname{flex:1;min-width:0;font-size:14px;overflow:hidden;
    text-overflow:ellipsis;white-space:nowrap}
  .tog{width:46px;height:27px;border-radius:99px;flex:none;padding:0;
    border:.5px solid var(--edge);background:rgba(255,255,255,.10);
    position:relative;transition:background .16s}
  .tog.on{background:rgba(48,209,88,.75)}
  .tog i{position:absolute;top:2.5px;left:2.5px;width:21px;height:21px;
    border-radius:99px;background:#fff;transition:transform .16s}
  .tog.on i{transform:translateX(19px)}
  .nudge{padding:12px 0 4px;border-bottom:.5px solid rgba(255,255,255,.09)}
  .nudge label{display:block;font-size:12px;color:var(--faint);
    margin:9px 0 5px;font-variant-numeric:tabular-nums}
  .nudge input[type=range]{width:100%;accent-color:var(--blue)}
  .note{font-size:12px;color:var(--faint);line-height:1.5;margin:11px 0 0}

  /* --- Local touch panel only. Scoped to .kiosk so the phone and any desktop
         browser are completely unaffected. --------------------------------- */

  /* There is no mouse on the rig, so the pointer is an arrow parked on the
     screen forever. The compositor draws its own hardware cursor as well --
     XCURSOR_SIZE=1 in tls-kiosk.service deals with that half. */
  html.kiosk, html.kiosk *{cursor:none !important}

  /* THE TAP DELAY. This page carries a mobile viewport meta, but DESKTOP
     chromium ignores it -- and the kiosk is desktop chromium. So every tap was
     being held for ~300ms waiting to see if it became a double-tap-to-zoom,
     which is what made the panel feel unresponsive on the 5.5" screen.
     touch-action:manipulation opts out of double-tap zoom and is honoured on
     desktop, so taps register immediately.

     NOT applied to the 3D viewer's canvas, which sets touch-action:none and
     does its own pinch and drag handling. */
  html.kiosk body, html.kiosk button, html.kiosk .card,
  html.kiosk .banner, html.kiosk .scan, html.kiosk .power{touch-action:manipulation}

  /* Long-pressing a control on a touchscreen otherwise starts a text
     selection, complete with handles, over the scan buttons. */
  html.kiosk{-webkit-user-select:none;user-select:none}
  html.kiosk input, html.kiosk textarea{-webkit-user-select:auto;user-select:auto}

  /* ⛔ THE PERFORMANCE FIX. This is what made the local screen feel slow.
     The panel's frosted-glass look is NINE backdrop-filter blur(30px)
     saturate(180%) rules. Each one re-blurs the region behind it EVERY FRAME.
     A phone GPU eats that for breakfast; the Pi 4's VideoCore, driving
     1080x1920, does not -- and it is paid on every repaint, which the 1 Hz
     status poll triggers constantly.

     Dropped for the kiosk only, so the phone keeps the look it was designed
     with. --glass is only rgba(255,255,255,.07), which relies on the blur to
     read as a surface, so the cards get an opaque background instead of
     turning into faint rectangles. */
  html.kiosk *{backdrop-filter:none !important;-webkit-backdrop-filter:none !important}

  /* ⛔ GLASS WITHOUT THE BLUR -- and it costs nothing.
     The first version of this made the cards nearly opaque
     (rgba(32,32,40,.92)), which killed the frosted look along with the blur.
     It did not have to: what backdrop-filter is blurring here is the page
     BACKGROUND, and that background is a smooth gradient with no
     high-frequency detail in it. Blurring a smooth gradient produces very
     nearly the same pixels as not blurring it -- so a genuinely translucent
     card over it reads as frosted glass for free.

     So: real translucency (the gradient shows through and shifts colour down
     the page, exactly as the phone's does), a bright top edge for the lit
     bevel, and NO per-frame blur. */
  html.kiosk .card{
    background:linear-gradient(180deg,rgba(66,66,84,.55),rgba(30,30,42,.50));
    box-shadow:inset 0 .5px 0 rgba(255,255,255,.15)}
  html.kiosk .banner{
    background:linear-gradient(180deg,rgba(78,62,40,.55),rgba(44,34,22,.50));
    box-shadow:inset 0 .5px 0 rgba(255,255,255,.12)}

  /* TRUE backdrop-filter, opt-in only: ?aero=1 / TLSPIE_KIOSK_AERO=1.
     ⛔ IT IS OFF BY DEFAULT AND SHOULD STAY OFF. Measured on the rig, panel
     idle at its 1 Hz poll, summed across every chromium process:

         flat cards ....... 7.0% of one core
         backdrop-filter .. 17.1% of one core

     Two and a half times the cost while nothing is happening, and it is paid
     again on every repaint -- which is what made the panel feel laggy the one
     time it shipped enabled. The rule above gets the same look for free. */
  html.kiosk.aero .card{background:var(--glass);box-shadow:none;
    -webkit-backdrop-filter:blur(30px) saturate(180%) !important;
    backdrop-filter:blur(30px) saturate(180%) !important}

  /* ⛔ DO NOT give .hdr a background here. There was a
         html.kiosk .hdr{background:rgba(18,18,24,.94)}
     rule, added by reflex alongside the two above, and it was a mistake: .hdr
     has NO background and NO backdrop-filter in the base stylesheet. The title
     is meant to sit directly on the page gradient, as it does on the phone.
     Giving it one painted an opaque slab behind "TLS Scanner" with a hard edge
     down each side -- the header, alone on the whole page, stopped matching the
     phone. The two rules above are compensating for a blur that was removed;
     this one compensated for nothing. */

  /* Transitions on a device that is already working hard read as lag rather
     than polish. Taps should land instantly. */
  html.kiosk *{transition-duration:0s !important}

  /* No mouse means the scrollbar is not a control, just a bright strip down
     the right-hand edge. Touch scrolling is unaffected. */
  html.kiosk::-webkit-scrollbar, html.kiosk *::-webkit-scrollbar{
    width:0;height:0;display:none}
  html.kiosk{scrollbar-width:none;-ms-overflow-style:none}

/* --- the boot curtain -------------------------------------------------------
   Holds the panel black from its FIRST PAINT until the intro video has
   finished, on the rig's own screen only (`kiosk=1`; the phone never gets it).

   ⛔ WHY THE PANEL HAS TO PAINT ITSELF AND THEN HIDE, rather than just loading
   later. cage stacks toplevels by map order, so mpv has to map AFTER chromium
   or the video plays underneath the panel. mpv takes about 1.8 s to get its
   window up, and chromium spends that time painting -- so the operator saw the
   control surface, then a video over it, then the control surface again.

   Loading the panel late instead was tried on 2026-08-11 and put a WHITE FLASH
   between the intro and the panel: a window covered by a fullscreen client is
   occluded, and chromium defers painting an occluded window, so the navigation
   rendered only when mpv exited -- white first. The panel must be painted
   BEFORE the intro covers it. This makes what it paints black.

   Black on `html` with the body faded out, rather than a fixed overlay: the
   panel sets `zoom` on the root element, and zoom changes the containing block
   a `position:fixed` overlay is sized against. This construction cannot be
   caught out by it. */
html.booting{background:#000}
html.booting body{opacity:0}
body{transition:opacity .25s ease}
@media (prefers-reduced-motion:reduce){body{transition:none}}
</style></head><body>
<script>
/*
  Two things the rig's own 5.5" panel needs and the phone does not. Both come
  from query parameters, so this stays ONE page serving both surfaces.

  zoom -- the panel is 1080x1920 across 5.5 inches, about 400 PPI. Rendered 1:1
  the CSS viewport is 1080px wide while body is max-width:560px, so the layout
  sits as a narrow strip down the middle with dead space either side. That is
  exactly what the first fit on hardware looked like. Zoom 250% makes the CSS
  viewport 432px, so the phone layout fills the screen at phone-sized targets.

  ⛔ Deliberately NOT chromium's --force-device-scale-factor. Tried 2026-08-10:
  it shrank chromium's Wayland SURFACE to exactly one third -- a 360x640 plane
  in the top-left of a 1080x1920 screen. Zoom changes the layout; that flag
  changed the window.

  Runs before first paint, so there is no flash of the unzoomed layout.
*/
(function(){
  try{
    var p = new URLSearchParams(location.search);
    var z = parseFloat(p.get('zoom'));
    if(z > 0) document.documentElement.style.zoom = z / 100;
    if(p.get('kiosk') === '1') document.documentElement.classList.add('kiosk');
    if(p.get('aero') === '1') document.documentElement.classList.add('aero');
    /* Curtain up before the first paint, on the rig's screen only. Dropped by
       poll() once the server says the intro is over -- see the CSS above.
       Applied optimistically: if the intro is already finished, the very first
       poll clears it, which costs one frame of black on a screen that was
       black anyway. Getting it wrong the other way shows the control surface
       mid-boot, which is the fault being fixed. */
    if(p.get('kiosk') === '1') document.documentElement.classList.add('booting');
  }catch(e){}
})();
</script>

<div class="hdr"><h1>TLS Scanner</h1><span class="hdrend">
  <span class="rev" id="rev">Rev 2.0</span>
  <button class="fs" id="fs" hidden>Full screen</button>
</span></div>

<div class="card">
  <div class="statusline"><div class="dot" id="dot"></div>
    <div class="phase" id="phase">&mdash;</div></div>
  <div class="msg" id="msg">Connecting&hellip;</div>
  <div class="prof" id="prof"></div>
  <div class="bar"><div id="fill"></div></div>
  <div class="times"><span id="elapsed">&ndash;&ndash;:&ndash;&ndash;</span>
    <span id="remain"></span></div>
  <div class="prof" id="pwr"></div>
</div>

<div id="rehome" class="banner warn" style="display:none">
  Position unknown after the abort. Align the head, then press Restart to set
  this as the start position.
</div>

<!--
  Power. Hidden while the supply is healthy: a warning that is always on screen
  stops being a warning. On 2026-08-10 a draining pack made the motor shed
  steps and then rebooted the Pi mid-move with nothing to show for it, and the
  measurements taken meanwhile sent a debugging session down the wrong path.
-->
<div id="pwrbanner" class="banner warn" style="display:none"></div>

<div class="card" id="previewCard" style="display:none">
  <p class="sechead">Live preview &middot; plan view</p>
  <div class="cvwrap">
    <canvas id="cv" width="720" height="520"></canvas>
    <div class="cvmeta" id="cvmeta"></div>
  </div>
</div>

<div class="stack" style="margin-bottom:14px">
  <button class="stop" id="stop" onclick="cmd('stop')" disabled>
    <span class="lbl">STOP</span>
    <span class="det">deletes this scan and turns the head back</span>
  </button>
</div>

<div class="card">
  <div class="stack" id="scans"></div>
</div>

<div class="stack" style="margin-bottom:14px">
  <button class="restart" id="restart" onclick="cmd('restart')">
    <span class="lbl">Restart</span>
    <span class="det">return the head to start and clear the fault</span>
  </button>
</div>

<!--
  Storage. Scans record to the USB stick whenever one is usable and to the SD
  card otherwise -- a missing stick must never stop a scan. Eject is disabled
  during a scan because unmounting the filesystem tcpdump is writing to loses
  the capture, and exFAT has no journal to recover it from.
-->
<div class="card" id="usbCard">
  <p class="sechead">Storage</p>
  <div class="prof" id="usbline">&mdash;</div>
  <button class="restart" id="usbcheck" onclick="cmd('usb?action=check')">
    <span class="lbl">Check for USB</span>
    <span class="det">mount a drive you have just plugged in</span>
  </button>
  <button class="restart" id="usbeject" onclick="cmd('usb?action=eject')">
    <span class="lbl">Eject USB</span>
    <span class="det">flush and unmount, then it is safe to pull out</span>
  </button>
</div>

<div class="card" id="libCard" style="display:none">
  <p class="sechead">Scans</p>
  <div id="buildnote" class="banner warn" style="display:none"></div>
  <div id="lib"><div class="empty">Loading&hellip;</div></div>
</div>

<div class="card">
  <div class="kv"><span>Capture</span><span id="cap">&mdash;</span></div>
  <div class="kv"><span>Size</span><span id="size">&mdash;</span></div>
  <div class="kv"><span>Last completed</span><span id="last">&mdash;</span></div>
</div>

<div id="viewer">
  <canvas id="glcv"></canvas>

  <div class="vbar vtop">
    <button class="vb" onclick="closeViewer()">&lsaquo; Back</button>
    <div class="vtitle" id="vtitle"></div>
    <button class="vb" onclick="toggleLayers()">Layers</button>
  </div>

  <div class="vstat" id="vstat"></div>

  <!-- Hidden by default: on a 5.5in panel three sliders permanently on screen
       cost more than they earn, and they are set once and left. -->
  <div class="vsliders" id="vsliders" hidden>
    <label class="vsl"><span>Point size</span>
      <input type="range" id="spsize" min="20" max="200" value="100" step="5">
      <b id="spsizev">1.00&times;</b></label>
    <label class="vsl"><span>Colour low</span>
      <input type="range" id="szlo" min="0" max="1000" value="0" step="1">
      <b id="szlov">auto</b></label>
    <label class="vsl"><span>Colour high</span>
      <input type="range" id="szhi" min="0" max="1000" value="1000" step="1">
      <b id="szhiv">auto</b></label>
    <button class="vb" id="sreset" onclick="resetDisplay()">Reset display</button>
  </div>

  <div class="vbar vbot">
    <button class="vb wide" id="vcolor" onclick="cycleColor()">Colour: height</button>
    <button class="vb" id="vdisp" onclick="toggleSliders()">Display</button>
    <button class="vb" id="vroam" onclick="toggleRoam()">Orbit</button>
    <button class="vb" onclick="resetView()">Recentre</button>
    <!-- Stop stays reachable from inside the viewer. The panel is the only
         software abort on this rig, so it must never be a navigation away. -->
    <button class="vb danger" id="vstop" onclick="cmd('stop')" hidden>STOP</button>
  </div>

  <div class="layers" id="layers">
    <div class="lhead">
      <p class="sechead">Layers</p>
      <button class="lback" id="lback">Done</button>
    </div>
    <div id="layerlist"></div>
    <div id="nudgebox"></div>
    <p class="note" id="viewnote"></p>
  </div>
</div>

<div class="foot">
  Software stop only &mdash; if the controller dies, cut power at the main switch.
</div>

<!--
  Shut down, at the very bottom of the page on purpose: it is the last thing
  you do, it is irreversible, and nothing above it should ever be reached by a
  thumb aiming here. Pulling the plug instead risks the scan library, because
  exFAT has no journal and loses the directory rather than the last file.
-->
<!--
  ⚠ "Reboot the Pi", never "Restart". There is already a Restart button on this
  page and it does something completely different -- it returns the HEAD to
  start and clears a fault. Two controls called Restart, one of which reboots
  the computer mid-session, is a trap in the dark on a tripod.
-->
<div class="card" id="powerCard">
  <p class="sechead">Power</p>
  <div class="stack">
    <button class="power reboot" id="rbtbtn" onclick="armPower('rbt')">
      <span class="lbl">Reboot the Pi</span>
      <span class="det" id="rbtdet">ejects the USB stick first, then restarts</span>
    </button>
    <button class="power" id="pwrbtn" onclick="armPower('pwr')">
      <span class="lbl">Shut down the Pi</span>
      <span class="det" id="pwrdet">ejects the USB stick first, then powers off</span>
    </button>
  </div>
</div>

<script>
const T = new URLSearchParams(location.search).get('t');
const q = p => T ? p + (p.includes('?') ? '&' : '?') + 't=' + encodeURIComponent(T) : p;

const COLOR = {
  IDLE:'#8E8E93', PREFLIGHT:'#FF9F0A', RECORDING:'#FF453A', SCANNING:'#0A84FF',
  RETURNING:'#BF5AF2', HOMING:'#BF5AF2', COMPLETE:'#30D158',
  ABORTED:'#FF453A', STOPPED:'#8E8E93'
};
const LIVE = ['PREFLIGHT','RECORDING','SCANNING','RETURNING','HOMING'];

const mmss = s => s == null ? '--:--'
  : (s=Math.max(0,Math.round(s)), String(Math.floor(s/60)).padStart(2,'0')+':'+String(s%60).padStart(2,'0'));
const mb = b => b == null ? '—'
  : b < 1048576 ? (b/1024).toFixed(0)+' kB' : (b/1048576).toFixed(1)+' MB';

/* The scan buttons come from the server, so they must be rebuilt when the
   SERVER's answer changes -- not once and never again.

   ⛔ This read `if(!built)`, and on 2026-08-19 that shipped a profile nobody
   could press. A third profile was added and deployed, /api/status served all
   three on every poll, and the panel went on showing two: the page had been
   loaded before the restart, `built` was already true, and buildScans never ran
   again. Caught only by taking a screenshot -- the API and the screen disagreed
   and only the screen was right, which is this project's oldest lesson.

   It would have been worse in the field than on the bench. The kiosk gets a
   fresh page whenever tls-kiosk restarts; a phone left open on the panel does
   not, so the operator's own screen could stay stale for days while every poll
   carried the new button. A deploy that needs every viewer to know to reload is
   not a deploy.

   Keying on the offered set rather than a flag also covers a label or detail
   that was merely edited, which no count of buttons would catch. Rebuilding
   only on a genuine change is what keeps the poll cheap -- and the disabled
   pass below re-runs every poll anyway, so a rebuilt button is never left
   enabled during a scan. */
let builtKey = null;
const scansKey = s => s.scans.map(x => [x.id, x.label, x.detail].join('\u0001')).join('\u0002');
function buildScans(s){
  const wrap = document.getElementById('scans');
  wrap.innerHTML = '';
  s.scans.forEach(sc => {
    const b = document.createElement('button');
    b.className = 'go'; b.id = 'btn-' + sc.id;
    b.onclick = () => cmd('start', sc.id);
    b.innerHTML = '<span class="lbl">' + sc.label + '</span>' +
                  '<span class="det">' + sc.detail + '</span>';
    wrap.appendChild(b);
  });
  builtKey = scansKey(s);
}

// Power readout and warning.
//
// Two sources, and the UI says WHICH, because they answer different questions.
// Without an INA226 fitted, all the Pi can report is whether its own 5 V rail
// has sagged -- that is a health light, not a fuel gauge, and labelling it
// "battery" would be a lie the operator would rely on.
//
// The percentage is hedged with a ~ for the same reason: lithium voltage
// against charge is nonlinear and sags under load, so it reads low during a
// scan and "recovers" afterwards. That is chemistry, not a fault.
function renderPower(p){
  const line = document.getElementById('pwr');
  const ban  = document.getElementById('pwrbanner');
  if(!p){ line.textContent = ''; ban.style.display = 'none'; return; }

  const bits = [];
  if(p.packV != null){
    bits.push(p.packV.toFixed(2) + ' V');
    if(p.percent != null) bits.push('~' + p.percent + '%');
    if(p.amps != null)    bits.push(p.amps.toFixed(2) + ' A');
  } else {
    // Be explicit that the pack is not being measured, rather than silently
    // showing nothing and letting it read as "fine".
    bits.push('pack not monitored');
  }
  if(p.socTempC != null) bits.push(p.socTempC.toFixed(0) + '°C');
  line.textContent = bits.join('  ·  ');

  if(p.level === 'ok' || !p.note){ ban.style.display = 'none'; return; }
  ban.textContent = p.note;
  ban.style.display = 'block';
  ban.style.borderColor = p.level === 'crit' ? 'rgba(255,69,58,.55)'
                                             : 'rgba(255,159,10,.5)';
  ban.style.color       = p.level === 'crit' ? '#FF9A93' : '#FFD08A';
  ban.style.background  = p.level === 'crit' ? 'rgba(255,69,58,.14)'
                                             : 'rgba(255,159,10,.13)';
}

// Storage. Says WHERE the next scan will record, because that is the thing an
// operator needs to know before walking over and pulling the stick out.
// Scales all the way to TB, unlike mb() above which stops at MB -- fine for a
// capture file, useless for a 64 GB stick's free space.
function sz(n){
  if(n == null) return '?';
  const u = ['B','kB','MB','GB','TB'];
  let i = 0, v = n;
  while(v >= 1024 && i < u.length-1){ v /= 1024; i++; }
  return v.toFixed(0) + ' ' + u[i];
}

function renderStorage(s){
  const st = s.storage;
  const line = document.getElementById('usbline');
  const chk  = document.getElementById('usbcheck');
  const ej   = document.getElementById('usbeject');
  if(!st){ document.getElementById('usbCard').style.display = 'none'; return; }

  let txt;
  if(st.targetIsUsb){
    txt = 'Recording to USB · ' + sz(st.usbFree) + ' free';
  } else if(st.usbPresent && !st.usbMounted){
    txt = 'USB drive found but not mounted — press Check for USB';
  } else {
    txt = 'Recording to the SD card · ' + sz(st.sdFree) + ' free';
  }
  if(st.note) txt += ' · ' + st.note;
  line.textContent = txt;

  // Both actions touch the filesystem tcpdump may be writing to.
  chk.disabled = s.busy;
  ej.disabled  = s.busy || !st.usbMounted;
}

/* --- dropping the boot curtain ---------------------------------------------
   One-shot. Once the panel has been shown it is never hidden again: the curtain
   exists to cover a boot, and a control surface that can black itself out later
   is a hazard, not a feature. */
let curtainDropped = false;
function dropCurtain(){
  if(curtainDropped) return;
  curtainDropped = true;
  document.documentElement.classList.remove('booting');
}

/* ⛔ THIS IS SAFETY, NOT POLISH. The curtain covers the whole screen, STOP
   button included, so every path that could leave it up is a safety problem
   rather than a cosmetic one -- the same rule test_intro.py already applies to
   the intro itself. It is therefore bounded three independent ways: the server
   says the intro ended, OR a deadline passes, OR the operator touches the
   screen. Losing the server does not strand anybody behind it. */
if(document.documentElement.classList.contains('booting')){
  setTimeout(dropCurtain, 25000);
  addEventListener('pointerdown', dropCurtain, {once:true});
}

async function poll(){
  // Once the Pi is on its way down there is nothing left to ask it, and the
  // OFFLINE banner would read as a fault rather than as the expected outcome.
  if(shuttingDown) return;
  try{
    const s = await (await fetch(q('/api/status'),{cache:'no-store'})).json();
    // A server too old to report the field sends undefined, which drops the
    // curtain. That is the right way round to fail.
    if(!s.introPlaying) dropCurtain();
    if(scansKey(s) !== builtKey) buildScans(s);
    const c = COLOR[s.phase] || '#8E8E93';

    document.getElementById('phase').textContent = s.phase;
    document.getElementById('phase').style.color = c;
    document.getElementById('msg').textContent = s.message;
    document.getElementById('prof').textContent = s.profileLabel || '';

    const dot = document.getElementById('dot');
    dot.style.background = c; dot.style.color = c;
    dot.className = 'dot' + (LIVE.includes(s.phase) ? ' live' : '');

    const fill = document.getElementById('fill');
    fill.style.width = ((s.progress || 0)*100).toFixed(1) + '%';
    fill.style.background = 'linear-gradient(90deg,' + c + 'AA,' + c + ')';

    document.getElementById('elapsed').textContent = mmss(s.elapsed);
    document.getElementById('remain').textContent =
      s.remaining != null ? mmss(s.remaining) + ' left' : '';
    document.getElementById('cap').textContent = s.captureFile || '—';
    document.getElementById('size').textContent = mb(s.captureBytes);
    document.getElementById('last').textContent = s.lastCapture || '—';
    document.getElementById('rehome').style.display = s.positionKnown ? 'none':'block';
    renderPower(s.power);
    renderStorage(s);
    renderShutdown(s);

    document.getElementById('stop').disabled = !s.busy || s.stopPending;
    document.getElementById('restart').disabled = s.busy;
    s.scans.forEach(sc => {
      const b = document.getElementById('btn-' + sc.id);
      if(b) b.disabled = s.busy;
    });

    document.getElementById('previewCard').style.display = s.preview ? 'block':'none';
    if(s.preview) pollCloud();

    document.getElementById('libCard').style.display = s.library ? 'block':'none';

    // The viewer covers the whole screen, so Stop has to be reachable from
    // inside it. This panel is the only software abort on the rig.
    const vs = document.getElementById('vstop');
    vs.hidden = !s.busy;
    vs.disabled = s.stopPending;

    // A build that is running, or one that just gave way to a scan.
    const b = s.build || {};
    if(b.building){
      const pct = b.fraction != null ? ' ' + (b.fraction*100).toFixed(0) + '%' : '';
      setBuildNote('Building the 3D view for ' + b.building + pct +
                   ' — a scan will interrupt it.');
      if(Date.now() - libStamp > 2000){ libStamp = Date.now(); refreshLibrary(); }
    } else if(b.last && !b.last.ok){
      setBuildNote('3D view for ' + b.last.name + ': ' + b.last.message + '.');
    } else {
      setBuildNote('');
    }

    keepAwake(s.busy);
  }catch(e){
    document.getElementById('phase').textContent = 'OFFLINE';
    document.getElementById('phase').style.color = '#FF453A';
    document.getElementById('msg').textContent = 'No reply from the Pi.';
    document.getElementById('dot').className = 'dot';
  }
}

/* ---- point cloud preview: top-down plan view ---- */
let cloudBusy = false;
async function pollCloud(){
  if(cloudBusy) return;
  cloudBusy = true;
  try{
    const d = await (await fetch(q('/api/cloud'),{cache:'no-store'})).json();
    drawCloud(d);
  }catch(e){}
  cloudBusy = false;
}

function drawCloud(d){
  const cv = document.getElementById('cv'), g = cv.getContext('2d');
  const W = cv.width, H = cv.height, cx = W/2, cy = H/2;
  g.clearRect(0,0,W,H);

  const p = d.points || [];
  // furthest point sets the scale, rounded up to a tidy ring spacing
  let far = 1;
  for(let i=0;i<p.length;i+=3){
    const r = Math.hypot(p[i], p[i+1]);
    if(r > far) far = r;
  }
  const farM = Math.max(2, far/100);
  const step = farM <= 5 ? 1 : farM <= 12 ? 2 : farM <= 30 ? 5 : farM <= 60 ? 10 : 20;
  const spanM = Math.ceil(farM/step)*step;
  const scale = (Math.min(W,H)/2 - 14) / (spanM*100);

  // range rings
  g.strokeStyle = 'rgba(255,255,255,.10)'; g.lineWidth = 1;
  g.font = '11px -apple-system,system-ui,sans-serif';
  g.fillStyle = 'rgba(235,235,245,.30)';
  for(let r=step; r<=spanM; r+=step){
    g.beginPath(); g.arc(cx,cy,r*100*scale,0,6.2832); g.stroke();
    g.fillText(r+' m', cx + 4, cy - r*100*scale + 13);
  }
  g.strokeStyle = 'rgba(255,255,255,.07)';
  g.beginPath(); g.moveTo(cx,8); g.lineTo(cx,H-8);
  g.moveTo(8,cy); g.lineTo(W-8,cy); g.stroke();

  // points, coloured by height
  let zmin = 1e9, zmax = -1e9;
  for(let i=2;i<p.length;i+=3){ if(p[i]<zmin)zmin=p[i]; if(p[i]>zmax)zmax=p[i]; }
  const zr = Math.max(1, zmax - zmin);
  for(let i=0;i<p.length;i+=3){
    const t = (p[i+2]-zmin)/zr;                       // 0 low .. 1 high
    const hue = 205 - t*185;                          // blue -> amber
    g.fillStyle = 'hsla(' + hue + ',88%,' + (46+t*22) + '%,.85)';
    g.fillRect(cx + p[i]*scale - 1, cy - p[i+1]*scale - 1, 2.2, 2.2);
  }

  // sensor marker
  g.fillStyle = '#FFFFFF';
  g.beginPath(); g.arc(cx,cy,3.4,0,6.2832); g.fill();

  document.getElementById('cvmeta').textContent =
    d.count.toLocaleString() + ' pts · ' + spanM + ' m across · ' +
    d.packetsUsed.toLocaleString() + '/' + d.packetsSeen.toLocaleString() + ' pkts';
}

// --- shut down / reboot ---------------------------------------------------
// Two taps, not a dialog. These live on a touchscreen bolted to a tripod, so a
// brushed sleeve must not end the session -- but a modal is worse on a 5.5"
// panel in daylight than a button that changes what it says. The arm expires
// by itself, so walking away is the same as cancelling.
//
// Both buttons share one implementation on purpose: they carry identical
// guards on the server, and two near-copies here would be two places for the
// confirm or the disable-while-scanning to rot out of step.
const POWER = {
  pwr: {btn:'pwrbtn', det:'pwrdet', api:'/api/shutdown',
        idle:'Shut down the Pi',  rest:'ejects the USB stick first, then powers off',
        arm:'Tap again to shut down', going:'Shutting down…',
        phase:'SHUTTING DOWN', after:'safe to cut power once the LED is off',
        lost:'Shutting down — wait for the green LED to stop before cutting power'},
  rbt: {btn:'rbtbtn', det:'rbtdet', api:'/api/reboot',
        idle:'Reboot the Pi',     rest:'ejects the USB stick first, then restarts',
        arm:'Tap again to reboot', going:'Rebooting…',
        phase:'REBOOTING', after:'the panel comes back on its own',
        lost:'Rebooting — the panel comes back in about fifteen seconds'}
};
let armTimer = null, armed = null;
let shuttingDown = false;

function pwrLabel(k, lbl, det){
  document.getElementById(POWER[k].btn).querySelector('.lbl').textContent = lbl;
  document.getElementById(POWER[k].det).textContent = det;
}

function disarmPower(k){
  if(armed === k){ clearTimeout(armTimer); armTimer = null; armed = null; }
  document.getElementById(POWER[k].btn).classList.remove('armed');
  pwrLabel(k, POWER[k].idle, POWER[k].rest);
}

async function armPower(k){
  const c = POWER[k];
  const b = document.getElementById(c.btn);
  if(!b.classList.contains('armed')){
    // Arming one disarms the other. Leaving both live invites tapping the
    // wrong one, and they are one finger-width apart.
    Object.keys(POWER).forEach(o => { if(o !== k) disarmPower(o); });
    b.classList.add('armed');
    armed = k;
    pwrLabel(k, c.arm, 'cancels itself in 5 seconds');
    armTimer = setTimeout(() => disarmPower(k), 5000);
    return;
  }
  clearTimeout(armTimer); armTimer = null; armed = null;
  b.disabled = true;
  pwrLabel(k, c.going, 'flushing the USB stick');

  let ok = false, message = '';
  try{
    const r = await fetch(q(c.api + '?confirm=yes'), {method:'POST'});
    const j = await r.json();
    ok = j.ok; message = j.message;
  }catch(e){
    // The machine going down before the reply arrives looks EXACTLY like this,
    // and is the successful case. Treating a dropped connection as a failure
    // would tell the operator it had not happened while the rig was already
    // on its way down -- so the only honest reading is that it worked.
    ok = true;
    message = c.lost;
  }

  if(ok){
    shuttingDown = true;             // stop polling; OFFLINE would be alarming
    b.classList.remove('armed');
    document.getElementById('phase').textContent = c.phase;
    document.getElementById('phase').style.color = '#FF9F0A';
    document.getElementById('dot').className = 'dot';
    document.getElementById('dot').style.background = '#FF9F0A';
    document.getElementById('msg').textContent = message;
    pwrLabel(k, c.going, c.after);
    // The other button is now meaningless and must not be tappable.
    Object.keys(POWER).forEach(o => {
      if(o !== k) document.getElementById(POWER[o].btn).disabled = true;
    });
    return;
  }
  // Refused, or it could not run. Say why, right under the button.
  b.disabled = false;
  b.classList.remove('armed');
  pwrLabel(k, c.idle, message);
}

function renderShutdown(s){
  if(shuttingDown) return;
  Object.keys(POWER).forEach(k => {
    const b = document.getElementById(POWER[k].btn);
    if(s.busy){
      if(b.classList.contains('armed')) disarmPower(k);
      b.disabled = true;
      document.getElementById(POWER[k].det).textContent = 'stop the scan first';
    } else if(b.disabled){
      // Only on the transition back, so a refusal message stays readable
      // instead of being wiped by the next 1 Hz poll.
      b.disabled = false;
      disarmPower(k);
    }
  });
}

async function cmd(what, profile){
  const url = what === 'start' ? '/api/start?profile=' + profile : '/api/' + what;
  try{ await fetch(q(url), {method:'POST'}); }catch(e){}
  poll();
}

// Full screen. Plain HTTP cannot get a standalone PWA install, but the
// Fullscreen API works anywhere, and it is what actually matters on a rig you
// operate at arm's length: no address bar eating the top of the screen.
// Hidden entirely where the API is missing, rather than offering a dead button.
const fsb = document.getElementById('fs');
if (document.documentElement.requestFullscreen){
  fsb.hidden = false;
  fsb.onclick = () => {
    if (document.fullscreenElement) document.exitFullscreen();
    else document.documentElement.requestFullscreen().catch(()=>{});
  };
  document.addEventListener('fullscreenchange', () => {
    fsb.textContent = document.fullscreenElement ? 'Exit full screen'
                                                 : 'Full screen';
  });
}

// Keep the screen awake while a scan runs. A phone that sleeps mid-scan does
// not stop the scan -- the Pi owns that -- but you lose sight of it, and the
// reflex is to grab the rig. Best effort: unsupported on older browsers, and
// the lock is dropped by the browser whenever the tab is backgrounded.
let wakeLock = null;
async function keepAwake(want){
  if (!('wakeLock' in navigator)) return;
  try{
    if (want && !wakeLock){
      wakeLock = await navigator.wakeLock.request('screen');
      wakeLock.addEventListener('release', () => { wakeLock = null; });
    } else if (!want && wakeLock){
      await wakeLock.release(); wakeLock = null;
    }
  }catch(e){ wakeLock = null; }
}

/* ==================== stored scans ==================== */
const PALETTE = ['#0A84FF','#FF9F0A','#30D158','#BF5AF2','#FF375F','#64D2FF',
                 '#FFD60A','#5E5CE6'];
let library = [], libStamp = 0;

const dayName = ep => {
  const d = new Date(ep*1000), now = new Date();
  const same = (a,b) => a.toDateString() === b.toDateString();
  const y = new Date(now); y.setDate(y.getDate()-1);
  if (same(d,now)) return 'Today';
  if (same(d,y))   return 'Yesterday';
  return d.toLocaleDateString(undefined,{day:'numeric',month:'short'});
};
const clock = ep => new Date(ep*1000)
  .toLocaleTimeString(undefined,{hour:'2-digit',minute:'2-digit'});

function setBuildNote(text){
  const el = document.getElementById('buildnote');
  el.textContent = text;
  el.style.display = text ? 'block' : 'none';
}

async function refreshLibrary(){
  try{
    const d = await (await fetch(q('/api/scans'),{cache:'no-store'})).json();
    library = d.scans || [];
  }catch(e){ return; }

  const wrap = document.getElementById('lib');
  if(!library.length){
    wrap.innerHTML = '<div class="empty">No scans yet. The 3D view appears ' +
      'here once a scan finishes and its cloud has been built.</div>';
    return;
  }
  let html = '', day = null;
  library.forEach(s => {
    const d = dayName(s.epoch);
    if(d !== day){ day = d; html += '<div class="daygroup">'+d+'</div>'; }

    let chip = '<span class="chip">tap to build</span>';
    if(s.building) chip = '<span class="chip busy">building…</span>';
    else if(s.hasCloud && s.registered === false)
      chip = '<span class="chip warn">unregistered</span>';
    else if(s.hasCloud && s.blocked)
      /* Nothing in this scan got more than a few metres from the sensor. The
         usual cause is the lens cover, and the rig cannot tell on its own --
         every other status reads as a clean success. */
      chip = '<span class="chip warn" title="nothing beyond ' +
             (s.reachM||0).toFixed(1) + ' m — lens cover on?">blocked?</span>';
    else if(s.hasCloud) chip = '<span class="chip ok">' +
      (s.points/1000).toFixed(0) + 'k pts</span>';
    else if(!s.hasCapture) chip = '<span class="chip warn">no data</span>';

    // The capture is offloaded and pruned in normal use; the cloud stays. So
    // the size is only shown while there is still a capture to size.
    const size = s.hasCapture ? (s.pcapBytes/1048576).toFixed(0)+' MB'
                              : 'capture offloaded';
    const det = [clock(s.epoch), s.label || '', size].filter(Boolean).join(' · ');
    /* Offer the capture when there is one -- that is the product, and the
       reason to get a scan off the rig at all. Once it has been offloaded and
       pruned the cloud is what remains, so offer that instead. */
    const kind = s.hasCapture ? 'capture' : (s.hasCloud ? 'cloud' : null);
    const what = s.hasCapture ? 'capture, '+(s.pcapBytes/1048576).toFixed(0)+' MB'
                              : 'cloud';
    const dl = kind ? '<button class="dl" data-dl="'+s.name+'" data-kind="'+kind+
                      '" title="Download '+what+'" aria-label="Download '+what+
                      '">&#8595;</button>' : '';
    html += '<div class="srow" role="button" tabindex="0" data-scan="'+s.name+'" ' +
            'data-ready="'+(s.hasCloud?1:0)+'">' +
            '<span class="nm"><span class="t">'+(s.label||s.name)+'</span>' +
            '<span class="d">'+det+'</span></span>'+chip+dl+'</div>';
  });
  wrap.innerHTML = html;
}

/* Handlers are delegated onto the containers rather than written as inline
   onclick attributes. Generated markup would otherwise need a JS string quoted
   inside an HTML attribute inside a Python string, and Python quietly eats the
   escaping -- which it did, and which no amount of checking that the page
   CONTAINS the right words would have caught. Delegation removes the nesting
   entirely. Containers keep their listeners because only their children are
   replaced. */
document.getElementById('lib').addEventListener('click', e => {
  /* The download button sits inside the row, so it must be claimed first or
     tapping it would also open the viewer behind the download. */
  const dl = e.target.closest('.dl');
  if(dl){
    downloadScan(dl.getAttribute('data-dl'), dl.getAttribute('data-kind'));
    return;
  }
  const row = e.target.closest('.srow'); if(!row) return;
  const name = row.getAttribute('data-scan');
  if(row.getAttribute('data-ready') === '1') openViewer(name);
  else buildCloud(name);
});
/* The row is a div now, so Enter and Space are not free any more. */
document.getElementById('lib').addEventListener('keydown', e => {
  if(e.key !== 'Enter' && e.key !== ' ') return;
  const row = e.target.closest('.srow'); if(!row) return;
  e.preventDefault();
  row.click();
});

function downloadScan(name, kind){
  /* A plain navigation, NOT fetch(). The browser's own downloader handles
     resume, backgrounding and the save location, and it streams to storage --
     whereas fetch() into a Blob would have to fit 370 MB in the phone's RAM
     before a single byte reached the disk. */
  const a = document.createElement('a');
  a.href = q('/api/download?name='+encodeURIComponent(name)+'&kind='+kind);
  a.download = '';
  document.body.appendChild(a);
  a.click();
  a.remove();
}

async function buildCloud(name){
  try{ await fetch(q('/api/build?name='+encodeURIComponent(name)),
                   {method:'POST'}); }catch(e){}
  refreshLibrary();
}

/* ==================== 3D viewer ==================== */
/* Hand-written WebGL rather than a library: the Pi serves this offline on a
   phone hotspot, so every byte has to come from here, and a point cloud is one
   buffer and one draw call. A library would be most of a megabyte to save
   about eighty lines of matrix maths. */

const VS = `
attribute vec3 aPos;        /* centimetres, as int16 */
attribute float aInt;
uniform mat4 uVP, uModel;
uniform vec2 uZ;            /* height range for the colour ramp */
uniform vec3 uFlat;         /* per-scan colour */
uniform float uMode;        /* 0 = by height, 1 = by scan, 2 = by intensity */
uniform float uPS;
uniform float uPSmax;    /* ceiling, so points can go genuinely small */
varying vec3 vC;
vec3 ramp(float t){
  return vec3(smoothstep(0.42,0.95,t),
              0.30 + 0.62*smoothstep(0.0,0.72,t) - 0.18*smoothstep(0.80,1.0,t),
              1.0 - 0.88*smoothstep(0.10,0.62,t));
}
void main(){
  vec4 w = uModel * vec4(aPos*0.01, 1.0);
  gl_Position = uVP * w;
  float t = clamp((w.z - uZ.x)/max(0.01, uZ.y - uZ.x), 0.0, 1.0);
  vec3 c = ramp(t);
  if(uMode > 1.5) c = vec3(0.35 + 0.65*aInt);
  else if(uMode > 0.5) c = uFlat;
  vC = c;
  /* The ceiling is what actually decides how fat a dense cloud looks: at
     500k points most are near enough to sit on the clamp, so scaling uPS alone
     changes almost nothing until the ceiling comes down with it. 1.0 is the
     floor because a point smaller than a pixel is not drawn smaller, it is
     drawn unreliably. */
  gl_PointSize = clamp(uPS/max(gl_Position.w, 0.5), 1.0, uPSmax);
}`;

const FS = `
precision mediump float;
varying vec3 vC;
void main(){ gl_FragColor = vec4(vC, 1.0); }`;

const V = {
  gl:null, prog:null, loc:{}, layers:[], base:null, sel:null,
  cam:{yaw:-0.9, pitch:0.45, dist:30, t:[0,0,0]},
  free:false,
  psize:1.0, zlo:null, zhi:null,
  mode:0, raf:0, dirty:true, dpr:1
};
const MODES = ['height','scan','intensity'];

function m4persp(fov, asp, n, f){
  const t = 1/Math.tan(fov/2), o = new Float32Array(16);
  o[0]=t/asp; o[5]=t; o[10]=(f+n)/(n-f); o[11]=-1; o[14]=2*f*n/(n-f);
  return o;
}
function m4mul(a,b){
  const o = new Float32Array(16);
  for(let i=0;i<4;i++) for(let j=0;j<4;j++){
    let s=0; for(let k=0;k<4;k++) s += a[k*4+j]*b[i*4+k];
    o[i*4+j] = s;
  }
  return o;
}
function camBasis(){
  const cp=Math.cos(V.cam.pitch), sp=Math.sin(V.cam.pitch);
  const cy=Math.cos(V.cam.yaw),   sy=Math.sin(V.cam.yaw);
  return {dir:[cp*cy,cp*sy,sp], right:[-sy,cy,0], up:[-sp*cy,-sp*sy,cp]};
}
function m4view(){
  const b = camBasis(), t = V.cam.t, d = V.cam.dist;
  const eye = [t[0]+b.dir[0]*d, t[1]+b.dir[1]*d, t[2]+b.dir[2]*d];
  const dot = (u,v) => u[0]*v[0]+u[1]*v[1]+u[2]*v[2];
  return new Float32Array([
    b.right[0], b.up[0], b.dir[0], 0,
    b.right[1], b.up[1], b.dir[1], 0,
    b.right[2], b.up[2], b.dir[2], 0,
    -dot(b.right,eye), -dot(b.up,eye), -dot(b.dir,eye), 1]);
}
function m4model(a){
  const r = (a.yaw||0)*Math.PI/180, c = Math.cos(r), s = Math.sin(r);
  return new Float32Array([c,s,0,0, -s,c,0,0, 0,0,1,0,
                           a.x||0, a.y||0, a.z||0, 1]);
}

function glInit(){
  const cv = document.getElementById('glcv');
  const gl = cv.getContext('webgl', {antialias:false, alpha:false,
                                     preserveDrawingBuffer:false});
  if(!gl){ return null; }
  const sh = (type, src) => {
    const s = gl.createShader(type);
    gl.shaderSource(s, src); gl.compileShader(s);
    if(!gl.getShaderParameter(s, gl.COMPILE_STATUS))
      throw new Error(gl.getShaderInfoLog(s));
    return s;
  };
  const p = gl.createProgram();
  gl.attachShader(p, sh(gl.VERTEX_SHADER, VS));
  gl.attachShader(p, sh(gl.FRAGMENT_SHADER, FS));
  gl.linkProgram(p);
  if(!gl.getProgramParameter(p, gl.LINK_STATUS))
    throw new Error(gl.getProgramInfoLog(p));
  gl.useProgram(p);

  V.gl = gl; V.prog = p;
  V.loc = {
    aPos: gl.getAttribLocation(p,'aPos'), aInt: gl.getAttribLocation(p,'aInt'),
    uVP: gl.getUniformLocation(p,'uVP'), uModel: gl.getUniformLocation(p,'uModel'),
    uZ: gl.getUniformLocation(p,'uZ'), uFlat: gl.getUniformLocation(p,'uFlat'),
    uMode: gl.getUniformLocation(p,'uMode'), uPS: gl.getUniformLocation(p,'uPS'),
    uPSmax: gl.getUniformLocation(p,'uPSmax')
  };
  gl.enable(gl.DEPTH_TEST);
  gl.clearColor(0.02, 0.024, 0.039, 1);
  return gl;
}

function parseCloud(buf){
  const dv = new DataView(buf);
  const magic = String.fromCharCode.apply(null, new Uint8Array(buf,0,6));
  if(magic !== 'TLSCLD') throw new Error('not a cloud file');
  const hlen = dv.getUint32(8, true);
  const hdr = JSON.parse(
    new TextDecoder().decode(new Uint8Array(buf, 12, hlen)));
  const n = hdr.count, off = 12 + hlen;
  return {hdr, n,
          pos: new Int16Array(buf, off, n*3),
          inten: new Uint8Array(buf, off + n*6, n)};
}

async function addLayer(entry, isBase){
  if(V.layers.some(l => l.name === entry.name)) return;
  const gl = V.gl;
  const url = '/api/scanfile?name=' + encodeURIComponent(entry.name) +
              '&v=' + (entry.built || 0);
  const buf = await (await fetch(q(url))).arrayBuffer();
  const c = parseCloud(buf);

  const pb = gl.createBuffer();
  gl.bindBuffer(gl.ARRAY_BUFFER, pb); gl.bufferData(gl.ARRAY_BUFFER, c.pos, gl.STATIC_DRAW);
  const ib = gl.createBuffer();
  gl.bindBuffer(gl.ARRAY_BUFFER, ib); gl.bufferData(gl.ARRAY_BUFFER, c.inten, gl.STATIC_DRAW);

  const a = entry.alignment || {};
  V.layers.push({
    name: entry.name, label: entry.label || entry.name,
    n: c.n, pb, ib, hdr: c.hdr, on: true, base: !!isBase,
    color: PALETTE[V.layers.length % PALETTE.length],
    align: {x: a.x_m||0, y: a.y_m||0, z: a.z_m||0, yaw: a.yaw_deg||0},
    saved: !!entry.alignment
  });
  V.dirty = true;
  renderLayers();
}

function zRange(){
  let lo = 1e9, hi = -1e9;
  V.layers.filter(l=>l.on).forEach(l => {
    const b = l.hdr.bounds_m;
    if(!b) return;
    lo = Math.min(lo, b[0][2] + l.align.z);
    hi = Math.max(hi, b[1][2] + l.align.z);
  });
  if(lo > hi) return [0,1];
  /* A manual range is kept as absolute metres, not as a fraction of the auto
     range, so toggling scans on and off does not silently move the colours
     you just set. */
  const a = (V.zlo === null) ? lo : V.zlo;
  const b = (V.zhi === null) ? hi : V.zhi;
  return (b - a < 0.01) ? [a, a + 0.01] : [a, b];
}
function zAuto(){
  let lo = 1e9, hi = -1e9;
  V.layers.filter(l=>l.on).forEach(l => {
    const b = l.hdr.bounds_m;
    if(!b) return;
    lo = Math.min(lo, b[0][2] + l.align.z);
    hi = Math.max(hi, b[1][2] + l.align.z);
  });
  return (lo > hi) ? [0,1] : [lo, hi];
}

function draw(){
  V.raf = 0;
  const gl = V.gl; if(!gl) return;
  const cv = gl.canvas;
  const w = Math.round(cv.clientWidth * V.dpr), h = Math.round(cv.clientHeight * V.dpr);
  if(cv.width !== w || cv.height !== h){ cv.width = w; cv.height = h; }
  gl.viewport(0,0,cv.width,cv.height);
  gl.clear(gl.COLOR_BUFFER_BIT | gl.DEPTH_BUFFER_BIT);

  const far = Math.max(400, V.cam.dist*6);
  const vp = m4mul(m4persp(1.0, cv.width/Math.max(1,cv.height), 0.15, far), m4view());
  gl.uniformMatrix4fv(V.loc.uVP, false, vp);
  gl.uniform2fv(V.loc.uZ, new Float32Array(zRange()));
  gl.uniform1f(V.loc.uPS, cv.height * 0.11 * V.psize);
  gl.uniform1f(V.loc.uPSmax, Math.max(1.0, 5.0 * V.psize));
  gl.uniform1f(V.loc.uMode, V.mode);

  let shown = 0;
  V.layers.forEach(l => {
    if(!l.on) return;
    shown += l.n;
    gl.uniformMatrix4fv(V.loc.uModel, false, m4model(l.align));
    const c = l.color;
    gl.uniform3f(V.loc.uFlat, parseInt(c.substr(1,2),16)/255,
                 parseInt(c.substr(3,2),16)/255, parseInt(c.substr(5,2),16)/255);
    gl.bindBuffer(gl.ARRAY_BUFFER, l.pb);
    gl.enableVertexAttribArray(V.loc.aPos);
    gl.vertexAttribPointer(V.loc.aPos, 3, gl.SHORT, false, 0, 0);
    gl.bindBuffer(gl.ARRAY_BUFFER, l.ib);
    gl.enableVertexAttribArray(V.loc.aInt);
    gl.vertexAttribPointer(V.loc.aInt, 1, gl.UNSIGNED_BYTE, true, 0, 0);
    gl.drawArrays(gl.POINTS, 0, l.n);
  });

  const on = V.layers.filter(l=>l.on).length;
  document.getElementById('vstat').textContent =
    shown.toLocaleString() + ' pts · ' + on +
    (on===1 ? ' scan' : ' scans') + ' · ' +
    (V.free ? 'free roam'
            : V.cam.dist <= CAM_FLOOR + 1e-6 ? 'inside'
                                             : V.cam.dist.toFixed(0) + ' m out');
}
function invalidate(){ if(!V.raf) V.raf = requestAnimationFrame(draw); }

/* ---- camera control: one finger orbits, two pinch and pan ---- */
function bindTouch(cv){
  let prev = null;
  const snap = ts => ts.length >= 2
    ? {x:(ts[0].clientX+ts[1].clientX)/2, y:(ts[0].clientY+ts[1].clientY)/2,
       d:Math.hypot(ts[0].clientX-ts[1].clientX, ts[0].clientY-ts[1].clientY), n:2}
    : {x:ts[0].clientX, y:ts[0].clientY, d:0, n:1};

  cv.addEventListener('touchstart', e => { prev = snap(e.touches); },
                      {passive:true});
  cv.addEventListener('touchend', e => {
    prev = e.touches.length ? snap(e.touches) : null; }, {passive:true});
  cv.addEventListener('touchmove', e => {
    e.preventDefault();
    const cur = snap(e.touches);
    if(prev && prev.n === cur.n){
      if(cur.n === 1) orbit(cur.x-prev.x, cur.y-prev.y);
      else { zoom(prev.d/Math.max(1,cur.d)); pan(cur.x-prev.x, cur.y-prev.y); }
    }
    prev = cur;
  }, {passive:false});

  /* mouse, so this can be checked on a laptop before it goes near a rig */
  let down = null;
  cv.addEventListener('mousedown', e => { down = {x:e.clientX, y:e.clientY, s:e.shiftKey}; });
  window.addEventListener('mouseup', () => { down = null; });
  window.addEventListener('mousemove', e => {
    if(!down) return;
    const dx = e.clientX-down.x, dy = e.clientY-down.y;
    down.s ? pan(dx,dy) : orbit(dx,dy);
    down.x = e.clientX; down.y = e.clientY;
  });
  cv.addEventListener('wheel', e => { e.preventDefault();
    zoom(Math.exp(e.deltaY*0.0012)); }, {passive:false});
}
/* ---- the pivot, and why there are two modes -------------------------------
   The camera is stored as (yaw, pitch, dist, t) with eye = t + dir*dist, so
   rotating yaw/pitch swings the EYE around t while t stays put. That is an
   orbit rig, and it is the right feel for inspecting a cloud from outside.

   Inside a room it is the wrong feel entirely. Every drag swings you around a
   pivot somewhere out in the geometry, which reads as the cloud being dragged
   about rather than you turning your head, and corners stay unreachable
   because you can never look INTO one -- you can only circle it.

   FREE ROAM keeps the eye fixed and rotates about it: look around from where
   you stand. Same maths, opposite fixed point. Recompute t from the eye after
   the angles change and every other function -- m4view, zoom, pan -- carries
   on working unaltered, because they only ever read (yaw,pitch,dist,t). */
function eyePos(){
  const b = camBasis(), t = V.cam.t, d = V.cam.dist;
  return [t[0]+b.dir[0]*d, t[1]+b.dir[1]*d, t[2]+b.dir[2]*d];
}
function setEye(e){
  const b = camBasis(), d = V.cam.dist;      /* NEW basis: call after rotating */
  for(let i=0;i<3;i++) V.cam.t[i] = e[i] - b.dir[i]*d;
}

function orbit(dx,dy){
  const keep = V.free ? eyePos() : null;
  V.cam.yaw -= dx*0.0062;
  V.cam.pitch = Math.max(-1.45, Math.min(1.45, V.cam.pitch + dy*0.0062));
  if(keep) setEye(keep);          /* pivot on the eye, not on the target */
  invalidate();
}

function toggleRoam(){
  const keep = eyePos();
  V.free = !V.free;
  /* Pin the radius short on entry. dist is the gain for both pan and the
     fly-through step, so leaving it at overview scale (30 m) would make a
     single swipe inside a room throw you across the building. The eye is
     preserved, so the view does not jump when the mode changes -- only the
     handling does. */
  if(V.free) V.cam.dist = CAM_FLOOR;
  setEye(keep);
  document.getElementById('vroam').textContent = V.free ? 'Free roam' : 'Orbit';
  document.getElementById('vroam').classList.toggle('on', V.free);
  invalidate();
}
/* ---- fly-through, added 2026-08-13 ------------------------------------
   This used to be a pure orbit rig with a hard floor on the radius:

       V.cam.dist = Math.max(0.6, Math.min(900, V.cam.dist*f));

   Zooming only ever shortened the leash to a target pinned at the centre of
   the cloud, so the camera could never pass through anything. That read as
   "the viewport stops when it hits a point" -- but nothing here tests points
   at all. It was the 0.6 m floor, every time, and the wall was simply what
   happened to be near the pivot.

   Below the floor the pinch stops shrinking the radius and starts pushing the
   TARGET forward instead. The eye follows, because eye = t + dir*dist, so the
   whole camera translates and you fly through the wall into the room. Orbit
   still works once inside: there is still a target to swing around, it is just
   in front of you now rather than at the centre of the scan.

   ⚠ FLY_GAIN is not cosmetic. The raw residual (CAM_FLOOR - dist*f) is about a
   centimetre per touchmove, so without it crossing a room takes a minute of
   pinching and the feature reads as still broken.

   Reset View returns to the fitted overview, so flying off into empty space is
   always one tap from recoverable. */
const CAM_FLOOR = 0.6, FLY_GAIN = 6.0;

function zoom(f){
  const d = V.cam.dist * f;
  if(d >= CAM_FLOOR){ V.cam.dist = Math.min(900, d); invalidate(); return; }
  const b = camBasis(), step = (CAM_FLOOR - d) * FLY_GAIN;
  for(let i=0;i<3;i++) V.cam.t[i] -= b.dir[i]*step;   /* -dir is into the scene */
  V.cam.dist = CAM_FLOOR;
  invalidate();
}
function pan(dx,dy){
  /* Floor the gain too. While flying, dist is pinned at CAM_FLOOR, and a
     strictly dist-proportional pan works out at well under a millimetre per
     swipe -- which feels like a seized control rather than a slow one. */
  const b = camBasis(), k = Math.max(V.cam.dist, 1.5)*0.0022;
  for(let i=0;i<3;i++) V.cam.t[i] += (-b.right[i]*dx + b.up[i]*dy)*k;
  invalidate();
}

function resetView(){
  const bnds = V.layers.filter(l=>l.on).map(l=>l.hdr.bounds_m).filter(Boolean);

  /* ⭐ PIVOT ON THE LIDAR, NOT ON THE BOUNDING BOX.
     The cloud is built in a sensor-centred frame -- the optical centre IS the
     origin, confirmed 2026-08-13 against three tape-measured surfaces -- so
     [0,0,0] is exactly where the instrument stood, and it is the only pivot
     that means anything physically.

     The bounding-box centre is not a place at all. It is an artefact of
     whatever the scan happened to reach, so one far return drags it somewhere
     nobody ever stood. On this rig's first scan the box spans
     y = -24.9 .. +72.8 m because a single wall was seen at 72 m, which put the
     pivot about 24 m out in +y -- open air. Every drag then swung the cloud
     about a point off in the distance rather than about the instrument, which
     is what made it feel like dragging the cloud instead of examining it. */
  V.cam.t = [0,0,0];

  if(bnds.length){
    const lo = [0,1,2].map(i => Math.min.apply(null, bnds.map(x=>x[0][i])));
    const hi = [0,1,2].map(i => Math.max.apply(null, bnds.map(x=>x[1][i])));
    /* Frame by REACH FROM THE SENSOR, now that the sensor is the centre -- the
       box diagonal would pull back to fit geometry that is no longer centred.

       Use the MEDIAN of the four horizontal half-extents, not the max. The max
       is set by the single furthest thing the scan caught: on the bench scan
       that is a wall at 72.8 m seen through a doorway, which frames the view at
       ~102 m and renders the actual room a smudge. The median tolerates one
       runaway direction out of four and gives ~35 m here, which frames what you
       came to look at. Under-framing is cheap now anyway -- you can zoom and
       fly out -- whereas over-framing wastes the whole screen. */
    const reach = [Math.abs(lo[0]), Math.abs(hi[0]),
                   Math.abs(lo[1]), Math.abs(hi[1])].sort((p,q) => p-q);
    V.cam.dist = Math.max(4, (reach[1]+reach[2])/2 * 1.4);
  } else { V.cam.dist = 30; }
  V.cam.yaw = -0.9; V.cam.pitch = 0.45;
  /* Recentre means 'back to the overview', which is an orbit view by
     definition. Leaving free roam on here would keep the eye-pivot while
     dist jumped back to overview scale -- overview reach, room-scale handling. */
  if(V.free){
    V.free = false;
    const btn = document.getElementById('vroam');
    if(btn){ btn.textContent = 'Orbit'; btn.classList.remove('on'); }
  }
  invalidate();
}
/* ---- the Display sliders -------------------------------------------------
   Point size is a multiplier on both the size and its ceiling (see the shader
   note). The two colour sliders are positions within the cloud's own height
   range, converted to absolute metres the moment they are touched -- so the
   colours stay put when scans are toggled, instead of drifting as the auto
   range changes underneath them. */
function toggleSliders(){
  const p = document.getElementById('vsliders');
  p.hidden = !p.hidden;
  document.getElementById('vdisp').classList.toggle('on', !p.hidden);
  if(!p.hidden) syncSliders();
}
function syncSliders(){
  const [lo,hi] = zAuto(), span = Math.max(0.01, hi-lo);
  const f = v => Math.round(1000*(v-lo)/span);
  const zl = document.getElementById('szlo'), zh = document.getElementById('szhi');
  if(V.zlo !== null) zl.value = Math.max(0, Math.min(1000, f(V.zlo)));
  if(V.zhi !== null) zh.value = Math.max(0, Math.min(1000, f(V.zhi)));
  labelSliders();
}
function labelSliders(){
  document.getElementById('spsizev').textContent = V.psize.toFixed(2)+'×';
  document.getElementById('szlov').textContent =
    V.zlo === null ? 'auto' : V.zlo.toFixed(1)+' m';
  document.getElementById('szhiv').textContent =
    V.zhi === null ? 'auto' : V.zhi.toFixed(1)+' m';
}
function bindSliders(){
  const ps = document.getElementById('spsize');
  ps.addEventListener('input', () => {
    V.psize = ps.value/100; labelSliders(); invalidate();
  });
  const zl = document.getElementById('szlo'), zh = document.getElementById('szhi');
  const apply = () => {
    const [lo,hi] = zAuto(), span = Math.max(0.01, hi-lo);
    let a = lo + span*(zl.value/1000), b = lo + span*(zh.value/1000);
    /* Keep them ordered without fighting the user's finger: whichever slider
       moved last wins, and the other is nudged clear of it. */
    if(b - a < 0.05) b = a + 0.05;
    V.zlo = a; V.zhi = b;
    labelSliders(); invalidate();
  };
  zl.addEventListener('input', apply);
  zh.addEventListener('input', apply);
}
function resetDisplay(){
  V.psize = 1.0; V.zlo = null; V.zhi = null;
  document.getElementById('spsize').value = 100;
  document.getElementById('szlo').value = 0;
  document.getElementById('szhi').value = 1000;
  labelSliders(); invalidate();
}

function cycleColor(){
  V.mode = (V.mode+1) % 3;
  document.getElementById('vcolor').textContent = 'Colour: ' + MODES[V.mode];
  invalidate();
}
function toggleLayers(){
  document.getElementById('layers').classList.toggle('on');
}
function closeLayers(){
  document.getElementById('layers').classList.remove('on');
}
document.getElementById('lback').addEventListener('click', closeLayers);

/* ---- layers panel ---- */
function renderLayers(){
  let html = '';
  V.layers.forEach((l,i) => {
    html += '<div class="lrow">' +
      '<span class="sw" style="background:'+l.color+'"></span>' +
      '<span class="lname" data-sel="'+i+'">'+l.label+
        (l.base ? '' : ' · <span style="color:var(--faint)">nudge</span>')+
      '</span>' +
      '<button class="tog'+(l.on?' on':'')+'" data-tog="'+i+'">' +
      '<i></i></button></div>';
  });

  const others = library.filter(s => s.hasCloud &&
                                !V.layers.some(l => l.name === s.name));
  if(others.length){
    html += '<p class="sechead" style="margin:18px 0 8px">Add</p>';
    others.forEach(s => {
      html += '<div class="lrow"><span class="lname" data-add="'+s.name+'">' +
        (s.label||s.name)+'</span>' +
        '<span class="chip">'+clock(s.epoch)+'</span></div>';
    });
  }
  document.getElementById('layerlist').innerHTML = html;
  renderNudge();
}

document.getElementById('layerlist').addEventListener('click', e => {
  const tog = e.target.closest('[data-tog]');
  if(tog){ toggleLayer(+tog.getAttribute('data-tog')); return; }
  const sel = e.target.closest('[data-sel]');
  if(sel){ selectLayer(+sel.getAttribute('data-sel')); return; }
  const add = e.target.closest('[data-add]');
  if(add) addByName(add.getAttribute('data-add'));
});

function toggleLayer(i){ V.layers[i].on = !V.layers[i].on; renderLayers(); invalidate(); }
function selectLayer(i){ V.sel = (V.sel === i) ? null : i; renderNudge(); }
function addByName(name){
  const e = library.find(s => s.name === name);
  if(e) addLayer(e, false).then(invalidate).catch(()=>{});
}

function renderNudge(){
  const box = document.getElementById('nudgebox');
  const note = document.getElementById('viewnote');
  if(V.sel == null || !V.layers[V.sel]){
    box.innerHTML = '';
    note.textContent = V.layers.length > 1
      ? 'Tap a scan’s name to nudge it into place.'
      : 'Scans from the same tripod position stack exactly. Move the tripod ' +
        'and they will not — use the nudge sliders to line them up.';
    return;
  }
  const l = V.layers[V.sel], a = l.align;
  const row = (k,lab,min,max,step,unit) =>
    '<label>'+lab+' <b data-lab="'+k+'">'+a[k].toFixed(k==='yaw'?1:2)+unit+
    '</b></label>' +
    '<input type="range" data-k="'+k+'" min="'+min+'" max="'+max+'" ' +
    'step="'+step+'" value="'+a[k]+'">';
  box.innerHTML = '<div class="nudge"><p class="sechead" style="margin:4px 0 2px">'
    + l.label + '</p>'
    + row('x','East',-30,30,0.05,' m')
    + row('y','North',-30,30,0.05,' m')
    + row('z','Up',-5,5,0.02,' m')
    + row('yaw','Twist',-180,180,0.5,'°')
    + '<button class="vb wide" id="savealign" style="width:100%;margin-top:14px">'
    + 'Save alignment</button></div>';
  note.textContent = 'Rough alignment — for coverage checking only. ' +
    'Survey-grade registration happens off the Pi, from the pcaps.';
}

document.getElementById('nudgebox').addEventListener('input', e => {
  const k = e.target.getAttribute('data-k');
  if(k) setNudge(k, e.target.value);
});
document.getElementById('nudgebox').addEventListener('click', e => {
  if(e.target.closest('#savealign')) saveNudge();
});
function setNudge(k, v){
  if(V.sel == null) return;
  const l = V.layers[V.sel];
  l.align[k] = parseFloat(v);
  l.saved = false;
  // Update the readout in place. Re-rendering the panel here would replace the
  // very slider under the operator's finger and the drag would die after one
  // event.
  const lab = document.querySelector('#nudgebox b[data-lab="' + k + '"]');
  if(lab) lab.textContent = l.align[k].toFixed(k === 'yaw' ? 1 : 2) +
                            (k === 'yaw' ? '°' : ' m');
  invalidate();
}
async function saveNudge(){
  if(V.sel == null) return;
  const l = V.layers[V.sel];
  try{
    await fetch(q('/api/align?name=' + encodeURIComponent(l.name)),
      {method:'POST', body: JSON.stringify({alignment: l.align})});
    l.saved = true;
    document.getElementById('viewnote').textContent =
      'Saved. The workstation will inherit this alignment from the sidecar.';
  }catch(e){
    document.getElementById('viewnote').textContent = 'Could not save that.';
  }
}

/* ---- open / close ---- */
async function openViewer(name){
  const entry = library.find(s => s.name === name);
  if(!entry || !entry.hasCloud) return;
  const box = document.getElementById('viewer');
  box.classList.add('on');
  document.getElementById('vtitle').textContent = entry.label || name;

  if(!V.gl){
    V.dpr = Math.min(window.devicePixelRatio || 1, 2);
    try{
      if(!glInit()) throw new Error('no WebGL');
      bindTouch(document.getElementById('glcv'));
      window.addEventListener('resize', invalidate);
    }catch(e){
      document.getElementById('vstat').textContent =
        'This browser cannot draw 3D (' + e.message + ').';
      return;
    }
  }
  V.layers.forEach(l => { V.gl.deleteBuffer(l.pb); V.gl.deleteBuffer(l.ib); });
  V.layers = []; V.sel = null;
  try{
    await addLayer(entry, true);
  }catch(e){
    document.getElementById('vstat').textContent = 'Could not load: ' + e.message;
    return;
  }
  bindSliders();
  resetView();
  keepAwake(true);
}
function closeViewer(){
  document.getElementById('viewer').classList.remove('on');
  document.getElementById('layers').classList.remove('on');
  poll();
}
window.addEventListener('popstate', closeViewer);

poll();
refreshLibrary();
setInterval(poll, 1000);

/* While the curtain is up, ask more often. At the normal 1 Hz the panel could
   sit black for a further second after the video had already ended, which reads
   as a stall right at the moment the rig is meant to become usable. The fast
   timer stops itself the moment the curtain drops, so it costs nothing after
   boot. */
if(document.documentElement.classList.contains('booting')){
  const fast = setInterval(() => {
    if(curtainDropped) clearInterval(fast); else poll();
  }, 200);
}
setInterval(() => { if(!shuttingDown &&
                       !document.getElementById('viewer').classList.contains('on'))
                      refreshLibrary(); }, 5000);
</script>
</body></html>
"""


# The boot shim. Chromium's window is WHITE from the moment it is mapped until
# it first paints, and painting the real panel takes about half a second on the
# Pi -- half a second of full-screen white in the middle of the boot sequence,
# on a panel usually looked at in the dark.
#
# ⛔ It cannot be covered. cage stacks toplevels by map order, newest on top, so
# nothing can be put in front of a window that maps after it -- and chromium's
# is the window in question. It cannot be suppressed either:
#
#     no flag ........................... 0.50 s white
#     --default-background-color=ffARGB . 0.53 s white   <- does nothing
#     --default-background-color=RGB .... 0.40 s white   <- noise
#     a trivial dark page ............... 0.00 s white
#
# So the answer is to give chromium something it can paint instantly. This is
# ~300 bytes with the colour in a style attribute, so it paints on the first
# frame, and then hands over to the real panel -- and chromium's paint holding
# keeps THIS page on screen until the panel has painted, so the navigation is
# not white either.
#
# location.replace, not href: the shim must not sit in history, or the panel's
# own popstate handler for closing the 3D viewer would land back here.
# The query string is passed straight through, so the token, kiosk and zoom
# all survive without this page having to know what any of them mean.
BOOT_PAGE = """<!doctype html><html style="background:#12121a"><head>
<meta charset="utf-8"><title>TLS Scanner</title>
<style>html,body{margin:0;height:100%;background:#12121a}</style>
<script>location.replace('/' + location.search + location.hash);</script>
</head><body>
<noscript><meta http-equiv="refresh" content="0;url=/"></noscript>
</body></html>
"""


_ICON_ROUTES = {
    "/icon-192.png": 192,   # Android launcher
    "/icon-512.png": 512,   # Android splash and the maskable entry
    "/icon-180.png": 180,   # apple-touch-icon
    "/favicon.ico": 64,     # browsers ask for this unprompted; a PNG is fine
}
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
