Kizim01/Kizim-TLS-Pie/MicroView_Setup_Package/Pi_Companion_Files/VLPwaitbutton.py

#!/usr/bin/env python3
"""
Waits for the Arduino stop signal on GPIO, then terminates the capture.
"""

import os

import RPi.GPIO as GPIO

# GPIO pin for detecting the Arduino stop trigger.
# This should be connected to the Arduino RECORDSTOP output.
PIN_STOP = int(os.environ.get("TLSPIE_STOP_PIN", "27"))
DEBOUNCE_MS = int(os.environ.get("TLSPIE_DEBOUNCE_MS", "40"))
WAIT_TIMEOUT_S = int(os.environ.get("TLSPIE_STOP_TIMEOUT_S", "0"))


def main():
    GPIO.setwarnings(False)
    GPIO.setmode(GPIO.BCM)
    GPIO.setup(PIN_STOP, GPIO.IN, pull_up_down=GPIO.PUD_UP)

    print(f"Waiting for Arduino to stop capture on GPIO{PIN_STOP}")
    try:
        timeout_ms = None if WAIT_TIMEOUT_S <= 0 else WAIT_TIMEOUT_S * 1000
        channel = GPIO.wait_for_edge(
            PIN_STOP,
            GPIO.FALLING,
            timeout=timeout_ms,
            bouncetime=DEBOUNCE_MS,
        )
    except KeyboardInterrupt:
        print("Interrupted while waiting for stop signal")
        return 1
    finally:
        GPIO.cleanup(PIN_STOP)

    if channel is None:
        print(f"Timed out waiting for stop signal on GPIO{PIN_STOP}")
        return 2

    print("Button press detected STOPPED PCAP RECORD")
    return 0


if __name__ == "__main__":
    raise SystemExit(main())
