Kizim01/Kizim-TLS-Pie/Raspberry Pie4/TLS-Pie/tls_scan.py

#!/usr/bin/env python3
"""
TLS Pie scanner controller -- the whole scanner, on the Pi.

This replaces the MicroView entirely. One process owns the pan motor, the pcap
capture and the phone control panel, which removes the MicroView <-> Pi
handshake rather than reimplementing it.

WHAT THIS REPLACES
------------------
    VLPbuttons.py       waited on GPIO17 for the MicroView's RECORDSTART
    VLPwaitbutton.py    waited on GPIO27 for the MicroView's RECORDSTOP
    VLPstatussignal.py  pulse-coded abort reasons back on GPIO22
    VLPrecord.sh        orchestrated the above around tcpdump

All three GPIO lines and the pulse-code protocol are gone. They existed only
so two boards could agree on when a scan started; with a single process there
is nothing to agree with.

THE REAL WIN
------------
Rotation and capture are sequenced by the same process, so the mapping from
timestamp to pan angle is exact instead of inferred through a handshake with
unknown latency. That is a point-cloud quality improvement, not just tidier
code.

CONTROL SURFACES
----------------
Two, both using the same code paths:

  * the phone control panel (tls_web.py) -- start, stop, live status
  * the command line (--scan), for the bench

The physical buttons were removed on 2026-08-09; see the note further down.
Because the panel is now the only way to stop a running scan, this program
REFUSES TO START if the panel cannot bind its port -- a scanner that can be
started and not stopped is worse than one that will not start.

BEFORE FIRST RUN
----------------
  * S1, the main power switch, is the hardware stop. No separate E-stop is
    fitted and none is wanted -- settled 2026-08-13, do not re-suggest one.
    Note what it does NOT cover: if the Pi crashes while pigpio's DMA engine
    is still clocking steps, only cutting power stops the motor.
  * Fit a pull-up from the driver's ENABLE to +3V3. Pi GPIOs float for the
    ~30 s of boot and ENABLE is active-low. See tls_stepper.py.
  * sudo apt install pigpio python3-pigpio
    sudo systemctl enable --now pigpiod
  * tcpdump needs privileges: run this as root, or
    sudo setcap cap_net_raw,cap_net_admin=eip /usr/bin/tcpdump

USAGE
-----
    ./tls_scan.py                 phone panel, until stopped
    ./tls_scan.py --scan scan1    run one scan immediately, then exit
    ./tls_scan.py --check         run the preflight checks and exit
    ./tls_scan.py --no-record     move the motor without capturing (bench test)
    ./tls_scan.py --no-web        disable the phone control panel
"""

import os
import shutil
import signal
import subprocess
import sys
import time
from datetime import datetime

import json

import tls_cloud
import tls_geometry
import tls_scanstore
import tls_stepper
import tls_storage
import tls_web
from tls_stepper import Stepper

try:
    import pigpio
except ImportError:
    pigpio = None


# --- No push buttons ------------------------------------------------------
# Removed 2026-08-09 at the user's direction: the rig is operated from the
# phone, so SW1-SW5 and their pull-ups R1-R5 come off the board. S1 (Main) and
# S2 (Lidar) in the schematic stay -- those are the power switches, not
# buttons.
#
# The Pi's GPIO5, 6, 12 and 17 are therefore unused, as are 22 and 27 from the
# old MicroView handshake. Only STEP, DIR and ENABLE remain on the header.
#
# ⚠ WHAT THIS COSTS, STATED PLAINLY
# The phone panel is now the ONLY way to stop a scan, and the Pi reaches the
# phone over the phone's own hotspot -- so one device is both the control
# surface and the network carrying it. If the phone sleeps, crashes, goes flat
# or walks out of range, there is no software abort left at all.
#
# THE HARDWARE ABORT IS S1, THE MAIN POWER SWITCH (decided 2026-08-09).
# Cutting it stops rotation either way the supply is arranged: if S1 feeds the
# driver the coils de-energise, and if it only feeds the Pi's 5 V converter
# then STEP stops toggling and the motor stops turning regardless. That is
# more complete than a switch in series with ENABLE -- it removes the energy
# rather than asking the driver to stand down -- and it cannot be defeated by
# a crashed Pi with the DMA engine still clocking pulses.
#
# Use the panel's Stop for normal aborts and S1 only when something is wrong:
# a hard power cut truncates the pcap and, repeated, will eventually damage
# the SD card.
#
# See also: the duration watchdog in tls_stepper.move_steps(), the software
# half of this, which needs no network but cannot survive this process dying.

# --- Capture --------------------------------------------------------------
DUMPDIR = os.environ.get("DUMPDIR", "/home/lipi/velodyne")
TMPDIR = os.environ.get("TMPDIR", "/tmp/tlspie")
ETH_INTERFACE = os.environ.get("ETH_INTERFACE", "eth0")
LIDAR_IP = os.environ.get("LIDAR_IP", "192.168.1.201")
CHECK_LIDAR_REACHABILITY = os.environ.get("CHECK_LIDAR_REACHABILITY", "0") == "1"
CAPTURE_FILTER = os.environ.get("CAPTURE_FILTER", "host " + LIDAR_IP)
TCPDUMP_SETTLE_S = float(os.environ.get("TLSPIE_TCPDUMP_SETTLE_S", "0.3"))

# --- Scan profiles --------------------------------------------------------
#
# Angles carried over from the MicroView firmware. The 360 scans overshoot to
# 378 deg so a full revolution is captured after tcpdump is confirmed live; the
# 180 sweeps 190.8 deg, which is 10.8 deg of overlap past the half turn.
#
# THE RETURN LEG IS GONE -- 2026-08-20, at the operator's instruction.
#
# It ran after capture had stopped, so it never touched the data; it only made
# the operator wait. On the 180 profile that was 27 s of a 124 s scan, 22% of
# the wall clock spent walking back.
#
# ⛔ I ARGUED AGAINST THIS THE SAME MORNING AND I WAS WRONG. The claim was
# that sweep minus return had to be a whole number of turns or "the head ends
# off its mark and the NEXT scan starts somewhere nobody recorded". The code
# says otherwise. `PanTrack.from_segments(..., start_deg=0.0)` builds every
# sidecar's track from the SWEEP's segments starting at zero, so a scan is
# described relative to wherever the head happened to begin; the absolute
# angle is never written down and nothing downstream asks for it. And the
# operator confirmed there is no slip ring and no cable constraint, which was
# the only physical reason left. An invariant is only as good as its
# justification, and that justification did not survive being checked.
#
# The head simply stays where the sweep ended. `position_steps` still tracks
# it -- the panel's Restart still walks it back on demand, and that is the one
# place in the program that ever read it.
#
# ⭐ AND IT CAME BACK FOR ONE PROFILE -- 2026-09-10: "i would like the pi head
# to move back to a 180 position after a fast capture", then "quick 180 scan"
# (operator). The 180 Rapid sweeps 190.8 -- half a turn plus the 10.8 degree
# overlap that closes its seam -- so it now walks back 10.8 and finishes on
# exactly 180 from where it started: 4,800 steps, about two seconds.
# ⛔ THE SAME DAY IT WAS FIRST PUT ON THE WRONG PROFILE. "A fast capture" was
# read as the 360 Quick, because that profile's key is literally `fast`, and it
# was given a 198 degree walk: 28 s at 7 deg/s, the very wait that had the leg
# removed in August, on a scan nobody had asked to change. The operator's own
# name for the scan settled it. ⭐ A KEY IN THE CODE IS NOT THE OPERATOR'S NAME
# FOR THE THING -- the button says "180° Rapid" and they call it the quick 180.
# Both 360s stop where they finish.
RETURN_DEG_PER_S = float(os.environ.get("TLSPIE_RETURN_DEG_PER_S", "7.0"))

# Three scans. The 180 came back on 2026-08-19, asked for by name: the quick
# profile's rate over half the turn.
#
# ⭐ IT IS NOT HALF A SCAN, AND THE LABEL MUST NOT LET ANYONE THINK IT IS.
# The puck is on its side, so its fan is a full vertical circle and covers world
# azimuths pan+90 and pan-90 AT ONCE. 180 degrees of pan therefore reaches every
# direction, and the 360 profiles cover everything TWICE, from opposite sides of
# the fan. So this is a COMPLETE dome at single coverage.
#
# What it gives up is that second look -- the redundancy that fills the shadows
# cast by the rig's own enclosures, because a direction blocked by hardware at
# one pan angle is clear half a turn later. Single coverage means those shadows
# stay. Hence "one pass" in the detail line: "180" on its own reads as half a
# room to the operator standing in front of it, and that is the wrong worry.
#
# ⛔ IT ALSO COSTS THE PITCH CHECK. tls_pitchcheck splits the sweep on
# `pan % 360 < 180` and needs both halves; this sweep hands it 180 degrees and a
# 10.8 degree sliver, from which it would still fit a slope and still print a
# confident pitch. That tool now refuses a short sweep outright -- see the guard
# in its collect(). Check the pitch on a 360 scan.
#
# Every angle here is step-exact at 160,000 steps/rev, which is where the
# firmware's odd-looking numbers come from: 378 = 168,000 steps, 190.8 = 84,800.
# `degrees_to_steps` ROUNDS, so an angle that is not exact never raises -- the
# head just stops a sliver short on every scan.
#
# `return_deg` is kept rather than deleted: the field is written into every
# sidecar, so removing it would change the shape of a record that older
# captures already carry. Zero is the honest value for the two 360s, which do
# not walk back; the 180 Rapid's 10.8 is what puts it on 180.
SCAN_PROFILES = {
    "slow": {"label": "360° Slow", "detail": "1°/s · about 6¼ min",
             "order": 1, "sweep_deg": 378.0, "deg_per_s": 1.0,
             "return_deg": 0.0},
    "fast": {"label": "360° Quick", "detail": "2°/s · about 3¼ min",
             "order": 2, "sweep_deg": 378.0, "deg_per_s": 2.0,
             "return_deg": 0.0},
    "rapid": {"label": "180° Rapid", "detail": "2°/s · about 1¾ min · one pass",
              "order": 3, "sweep_deg": 190.8, "deg_per_s": 2.0,
              "return_deg": 10.8},
}

STATUSFILE = os.path.join(TMPDIR, "VLPrecord.status")

_shutdown = False
_state = None
_builder = None


class ScanAborted(Exception):
    """Raised when a scan cannot continue. `reason` mirrors VLPrecord.sh."""

    def __init__(self, reason, message):
        super().__init__(message)
        self.reason = reason
        self.message = message


def status_update(state_name, message):
    """Write the status file, log it, and push it to the phone panel."""
    stamp = datetime.now().strftime("%Y-%m-%dT%H:%M:%S%z")
    try:
        os.makedirs(TMPDIR, exist_ok=True)
        with open(STATUSFILE, "w") as handle:
            handle.write("%s|%s|%s\n" % (stamp, state_name, message))
    except OSError:
        pass  # a status file we cannot write must never sink a scan
    print("%s: [%s] %s" % (datetime.now(), state_name, message), flush=True)
    if _state is not None:
        _state.set(phase=state_name, message=message)


def park_deg(profile):
    """Where the head finishes, in degrees from where the sweep began.

    ⛔ THE MESSAGE HAS TO NAME THE PLACE THE HEAD IS ACTUALLY GOING. The
    status line said "returning to start" for as long as the return leg was a
    full walk back, and it would have gone on saying it now that the Quick 360
    stops at 180 instead -- which is the same class of small lie as a phase
    called RETURNING while the head does not move, and sends the same person
    looking for the same imaginary fault. Computed from the two numbers rather
    than written down, so a message cannot drift away from the motion.
    """
    return profile["sweep_deg"] - profile["return_deg"]


def estimate_duration(profile):
    """
    Expected wall-clock seconds for a whole scan, for the progress bar.

    Uses the same planner the motion does, so the estimate tracks any change to
    speeds or geometry automatically.
    """
    total = 0.0
    for degrees, rate in ((profile["sweep_deg"], profile["deg_per_s"]),
                          (profile["return_deg"], RETURN_DEG_PER_S)):
        segments, _ = tls_stepper.plan_move(
            tls_stepper.degrees_to_steps(degrees),
            tls_stepper.deg_per_s_to_step_rate(rate),
        )
        total += sum(n / r for n, r in segments if r > 0)
    return total + TCPDUMP_SETTLE_S + 1.0  # capture settle + inter-leg pause


# --- Preflight ------------------------------------------------------------
def preflight():
    """Port of VLPrecord.sh's checks. Raises ScanAborted on any hard failure."""
    for tool in ("tcpdump", "ip"):
        if not shutil.which(tool):
            raise ScanAborted("TOOL_MISSING",
                              "%s is required but was not found" % tool)

    if subprocess.call(["ip", "link", "show", ETH_INTERFACE],
                       stdout=subprocess.DEVNULL,
                       stderr=subprocess.DEVNULL) != 0:
        raise ScanAborted("NO_INTERFACE",
                          "Network interface '%s' was not found" % ETH_INTERFACE)

    link = subprocess.run(["ip", "link", "show", ETH_INTERFACE],
                          capture_output=True, text=True).stdout
    if "state UP" not in link:
        print("Warning: interface '%s' is not UP yet" % ETH_INTERFACE)

    addr = subprocess.run(["ip", "-4", "addr", "show", "dev", ETH_INTERFACE],
                          capture_output=True, text=True).stdout
    if "inet " not in addr:
        print("Warning: interface '%s' has no IPv4 address" % ETH_INTERFACE)

    if CHECK_LIDAR_REACHABILITY:
        if not shutil.which("ping"):
            raise ScanAborted("TOOL_MISSING",
                              "ping not available for reachability check")
        if subprocess.call(["ping", "-c", "1", "-W", "1", LIDAR_IP],
                           stdout=subprocess.DEVNULL,
                           stderr=subprocess.DEVNULL) != 0:
            raise ScanAborted("LIDAR_OFFLINE",
                              "Lidar IP %s is not reachable" % LIDAR_IP)


# --- Capture --------------------------------------------------------------
def start_capture(dumpdir=None):
    """
    Start tcpdump and confirm it survived. Returns (process, path, epoch).

    `dumpdir` is decided ONCE, at PREFLIGHT, by tls_storage.choose_dumpdir().
    It is passed in rather than looked up here on purpose: a destination that
    can change while tcpdump is running is a destination that can vanish while
    tcpdump is running.
    """
    dumpdir = dumpdir or DUMPDIR
    os.makedirs(dumpdir, exist_ok=True)
    timestamp = datetime.now().strftime("%y_%m_%d_%H_%M_%S")
    capture_file = os.path.join(dumpdir, "TLS_%s.pcap" % timestamp)

    # ⛔ -Z root IS LOAD-BEARING ON THE USB STICK. Debian builds tcpdump to drop
    # privileges to user `tcpdump` automatically, and dropping them with -w makes
    # it chown() the savefile. The stick is vfat, which cannot represent ownership
    # at all, so that chown returns EPERM and tcpdump treats it as FATAL: it exits
    # code 1 having written only the 24-byte pcap header, and the scan aborts with
    # TCPDUMP_ERROR before the motor ever turns.
    #
    # Measured 2026-08-13, all three legs on the rig:
    #   no -Z  + vfat  -> FAILS, 24 bytes, "Couldn't change ownership of savefile"
    #   -Z root+ vfat  -> works, 23,222 bytes, 20 real packets
    #   no -Z  + ext4  -> works, and the file lands owned tcpdump:tcpdump
    # That last line is the proof: on ext4 the chown SUCCEEDS, which is precisely
    # what vfat cannot do. The fault is the filesystem, not the flag.
    #
    # Unconditional rather than "only when the target is vfat" on purpose. A
    # filesystem-sniffing conditional silently regresses the moment the stick is
    # reformatted, replaced, or exFAT is used instead — exFAT has no ownership
    # either. tls_scan.py already runs as root, so keeping tcpdump there costs
    # nothing that was not already spent.
    cmd = ["tcpdump", "-Z", "root", "-U", "-w", capture_file, "-i", ETH_INTERFACE]
    if CAPTURE_FILTER:
        cmd.extend(CAPTURE_FILTER.split())

    print("Recording packets from LIDAR on %s" % ETH_INTERFACE)
    print("Capture file %s" % capture_file)
    print("Capture filter: %s" % (CAPTURE_FILTER or "<none>"))

    proc = subprocess.Popen(cmd)
    started = time.time()

    # Confirm capture is genuinely live before the motor turns. Starting the
    # sweep first would silently lose the opening slice of the rotation.
    time.sleep(TCPDUMP_SETTLE_S)
    if proc.poll() is not None:
        raise ScanAborted("TCPDUMP_ERROR",
                          "tcpdump exited immediately (code %s)" % proc.returncode)
    return proc, capture_file, started


def _terminate(proc):
    if proc is not None and proc.poll() is None:
        proc.terminate()
        try:
            proc.wait(timeout=5)
        except subprocess.TimeoutExpired:
            proc.kill()
            proc.wait()


def meta_path_for(capture_file):
    return os.path.splitext(capture_file)[0] + ".json"


def write_scan_meta(capture_file, profile_name, profile, stepper,
                    capture_started, start_steps=None):
    """
    Write the sidecar that turns a recording into a scan.

    A few kilobytes next to a 360 MB pcap, and without it that pcap is close to
    useless: it holds where every point was relative to the SENSOR, and only
    this process knows where the sensor was pointing at each instant. Decode
    the capture on its own and every static surface comes out smeared around
    the whole circle the head turned through.

    Must be called BEFORE the return leg, which overwrites the stepper's record
    of the last move with its own.

    Never raises. A sidecar that cannot be written is a real loss, but losing
    the scan on top of it would be worse -- so it reports and returns.
    """
    try:
        segments = stepper.last_move_segments or []
        track = tls_geometry.PanTrack.from_segments(
            segments, tls_stepper.STEPS_PER_REV,
            forward=stepper.last_move_forward)

        meta = {
            "format": "tls-scan-meta",
            "version": 1,
            "scan": {
                "profile": profile_name,
                "label": profile["label"],
                "sweep_deg": profile["sweep_deg"],
                "deg_per_s": profile["deg_per_s"],
                "return_deg": profile["return_deg"],
            },
            "capture": {
                "file": os.path.basename(capture_file),
                "started_epoch": capture_started,
                "interface": ETH_INTERFACE,
                "lidar_ip": LIDAR_IP,
                "filter": CAPTURE_FILTER,
            },
            "sweep": {
                "started_epoch": stepper.last_move_started_at,
                "forward": stepper.last_move_forward,
                # How far the wall clock jumped during the sweep, in seconds.
                # The pan track is on that clock, so a jump misplaces every
                # packet after it; see tls_stepper.move_steps. None from a
                # stepper that did not measure it.
                "clock_step_s": getattr(stepper, "last_move_clock_step_s",
                                        None),
                "steps_per_rev": tls_stepper.STEPS_PER_REV,
                "planned_deg": track.total_deg,
                "planned_seconds": track.duration_s,
                # Piecewise linear, one breakpoint per motion segment. The step
                # rate is constant inside a segment, so interpolating between
                # these is exact rather than approximate.
                "track": [[round(t, 6), round(d, 6)]
                          for t, d in track.as_breakpoints()],
            },
            "mount": tls_geometry.Frame().as_dict(),
            "zero": {
                "provenance": stepper.zero_provenance,
                "position_known": stepper.position_known,
                # ⭐ WHERE THE HEAD ITSELF WAS STANDING WHEN THE SWEEP
                # BEGAN. The track above starts at zero, so a cloud's
                # azimuth is measured from wherever that happened to be;
                # this is the one number that ties two clouds' zeros
                # together. Until 2026-08-20 it was not needed, because
                # every profile ended a whole number of turns from where
                # it started and that direction never moved. The return
                # leg was removed that day, so a Rapid now leaves the
                # head 190.8 degrees round and the next scan's zero is
                # 190.8 degrees away from this one's.
                #
                # ⭐ WHAT IT BUYS: a camera remounted the same way each
                # time has a FIXED heading in the rig's frame, so the
                # converter can carry one solved heading forward instead
                # of re-solving -- which matters because on 2026-08-20 a
                # correct pair scored 2.01 against a gate of 5.0. Rig
                # angle = this + the track angle: the same sign both
                # sides, because PanTrack.from_segments and
                # move_steps() take their sign from the same `forward`.
                #
                # null when the head's position is not known, rather
                # than a plausible zero -- an unknown anchor makes a
                # carried-over heading wrong, and silently.
                "head_deg": (
                    None if start_steps is None else
                    round(start_steps * 360.0
                          / tls_stepper.STEPS_PER_REV, 6)),
            },
            # Filled in by the phone panel once scans are aligned to each
            # other, so the workstation inherits that alignment for free.
            "alignment": None,
        }

        path = meta_path_for(capture_file)
        tmp = path + ".tmp"
        with open(tmp, "w") as handle:
            json.dump(meta, handle, indent=2, sort_keys=True)
        os.replace(tmp, path)
        return path
    except (OSError, ValueError, AttributeError) as exc:
        print("WARNING: could not write the scan sidecar (%s). The capture is "
              "intact but has no pan track, so it will only decode into the "
              "sensor frame." % exc, flush=True)
        return None


#: A pcap savefile's own header, written by tcpdump the moment it opens the
#: file and before a single packet has arrived.
#:
#: ⛔⛔ THIS NUMBER IS WHY THE EMPTY-CAPTURE GUARD COULD NEVER FIRE. It tested
#: `getsize(...) == 0`, and a file tcpdump has so much as opened is 24 bytes --
#: so the one condition the guard was written to catch was the one condition it
#: had excluded. The proof was already in this file, two hundred lines up:
#: `start_capture`'s own comment records the vfat failure as "exits code 1
#: having written only the 24-byte pcap header".
#: ⭐ A GUARD WHOSE THRESHOLD LIES OUTSIDE THE RANGE ITS SUBJECT CAN TAKE IS
#: NOT A LOOSE GUARD, IT IS AN ABSENT ONE -- and it reads in review as a guard.
PCAP_HEADER_BYTES = 24


def stop_capture(proc, capture_file):
    _terminate(proc)
    # tcpdump exits non-zero when signalled; that is the normal path here, so
    # only a missing or packetless file counts as a failure.
    if not os.path.exists(capture_file):
        raise ScanAborted("EMPTY_PCAP", "Capture file was never created")
    size = os.path.getsize(capture_file)
    if size <= PCAP_HEADER_BYTES:
        raise ScanAborted(
            "EMPTY_PCAP",
            "the capture holds nothing but its %d-byte pcap header (%d bytes "
            "on disk), so no packet from the lidar ever reached it -- check "
            "the sensor is powered and on %s"
            % (PCAP_HEADER_BYTES, size, ETH_INTERFACE))
    return capture_file


# --- Triggers -------------------------------------------------------------
def wait_for_trigger(pi):
    """
    Block until the phone panel requests something.

    Returns ("scan", profile) or ("restart", None), or None if shutting down.
    Since the buttons came off, the panel is the only source of requests.
    """
    status_update("IDLE", "Ready — use the phone panel")
    while not _shutdown:
        if _state.take_restart_request():
            _abandon_build("a restart")
            return ("restart", None)
        requested = _state.take_start_request()
        if requested:
            # A scan always wins. A cloud build is optional work and the
            # scanner must never be busy with optional work when the operator
            # wants the thing it exists for. The half-built cloud is discarded
            # and can be rebuilt from the panel afterwards.
            _abandon_build("a scan")
            return ("scan", requested)
        time.sleep(0.02)
    return None


def _abandon_build(reason):
    if _builder is not None and _builder.abort():
        status_update("IDLE", "Abandoning the 3D view build for %s" % reason)


def do_restart(pi, stepper):
    """
    Put the head back to the start position and clear any fault.

    Two cases, because after a watchdog overrun the position is genuinely
    unknown -- that move was not following its plan, so its timing says
    nothing about where it got to. (A stop is counted from the plan and keeps
    the position; see tls_stepper.steps_by_time.)

      * position known  -> drive back to zero
      * position unknown -> the operator has aligned the head by hand, so take
        the current position as the new zero
    """
    def should_abort():
        # One abort path. The phone panel's stop button and SIGTERM both
        # land here; the physical stop button that used to be a third source
        # was removed with the rest of the buttons on 2026-08-09.
        return _shutdown or _state.stop_requested()

    # ⛔ A LEFTOVER STOP MUST NOT END THIS BEFORE IT STARTS. Restart polls the
    # same flag a scan does, and nothing had cleared a press left from before
    # it -- so it stopped on its first poll, drove nothing, and said it had
    # been interrupted. The panel now refuses a STOP while idle
    # (tls_web.request_stop); this is the other half. Cleared BEFORE `busy` is
    # raised: a press is only accepted once it is, so nothing meant for this
    # restart can be thrown away here.
    _state.clear_stop()
    _state.set(busy=True)
    try:
        if not stepper.position_known:
            stepper.set_home()
            _state.set(position_known=True)
            status_update("IDLE",
                          "Start position set from where the head is now")
            return

        offset = stepper.position_steps
        if offset == 0:
            status_update("IDLE", "Already at the start position")
            return

        degrees = abs(offset) * 360.0 / tls_stepper.STEPS_PER_REV
        status_update("HOMING", "Returning %.1f° to the start position" % degrees)

        stepper.enable()
        completed = stepper.move_steps(
            abs(offset),
            tls_stepper.deg_per_s_to_step_rate(RETURN_DEG_PER_S),
            forward=(offset < 0),
            should_abort=should_abort,
        )
        stepper.disable()

        if completed:
            stepper.set_home()
            status_update("IDLE", "At the start position — ready")
        else:
            status_update("ABORTED", "Restart interrupted before the head "
                                     "reached the start position")
        _state.set(position_known=stepper.position_known)
    finally:
        stepper.disable()
        _state.end_scan()


# --- Scan sequence --------------------------------------------------------
def _discard_and_return(stepper, capture_file, swept):
    """
    A scan the operator stopped: delete what it recorded, turn the head back.

    Asked for on 2026-09-10: "if i stop a scan mid sweep to delete that scan
    and lidar resets ... resets heading". A stopped scan is one the operator
    has decided against, and leaving its fragment in the library puts a partial
    capture beside the real ones, looking exactly like them.

    ⛔ ONLY WHAT THIS SCAN WROTE. The capture tcpdump was told to create and
    the sidecar beside it, if one exists -- by name, never by pattern, so
    nothing else on the stick can be caught up in it.

    ⛔⛔ THE HEAD GOES BACK TO WHERE THIS SCAN STARTED, AND A SECOND STOP ENDS
    THAT TOO. The panel's STOP is the only software stop on the rig, so a press
    that ends in the motor running again has to be answerable by another press.
    The stop that ended the sweep is cleared first -- left set, it would end the
    return before its first step -- and the return then asks the stop flag
    exactly as the sweep did. The distance is the steps the sweep got through,
    counted from its plan (tls_stepper.steps_by_time), taken the other way.
    """
    gone, kept = [], []
    for path in ((capture_file, meta_path_for(capture_file))
                 if capture_file else ()):
        if not os.path.isfile(path):
            continue
        try:
            os.remove(path)
            gone.append(os.path.basename(path))
        except OSError as exc:
            kept.append("%s (%s)" % (os.path.basename(path), exc))
    _state.set(capture_file=None)
    if kept:
        said = "could not delete %s" % ", ".join(kept)
    elif gone:
        said = "deleted %s" % gone[0]
    else:
        said = "nothing had been recorded"

    steps, forward = swept
    if not steps:
        status_update("STOPPED", "Scan stopped — %s; the head had not moved"
                      % said)
        return
    deg = steps * 360.0 / tls_stepper.STEPS_PER_REV
    _state.clear_stop()
    status_update("HOMING", "Scan stopped — %s; turning the head back "
                            "%.1f° to where it started" % (said, deg))
    try:
        stepper.enable()
        time.sleep(1.0)
        back = stepper.move_steps(
            steps, tls_stepper.deg_per_s_to_step_rate(RETURN_DEG_PER_S),
            forward=not forward,
            should_abort=lambda: _shutdown or _state.stop_requested())
    except tls_stepper.MoveOverran as exc:
        stepper.stop_and_release()
        status_update("ABORTED", "MOVE_OVERRAN on the way back: %s" % exc)
        return
    finally:
        stepper.disable()
    if back:
        status_update("STOPPED", "Scan stopped — %s; the head is back where "
                                 "it started" % said)
    else:
        short = steps - (getattr(stepper, "last_stop_steps", None) or 0)
        status_update("STOPPED", "Stopped again on the way back — the head "
                                 "is %.1f° short of where the scan started"
                      % (short * 360.0 / tls_stepper.STEPS_PER_REV))


def run_scan(pi, stepper, profile_name, record=True):
    profile = SCAN_PROFILES[profile_name]
    # Why the recorder stopped, if it stopped by itself. A list rather than a
    # name so the closure below can fill it in without `nonlocal`.
    capture_died = []

    def should_abort():
        # One abort path. The phone panel's stop button and SIGTERM both land
        # here; the physical stop button that used to be a third source was
        # removed with the rest of the buttons on 2026-08-09.
        #
        # ⛔⛔ AND A RECORDER THAT HAS DIED IS AN ABORT TOO. `start_capture`
        # confirms tcpdump survived its first moment and NOTHING LOOKED AT IT
        # AGAIN -- so a capture that died a few degrees into a three-minute
        # sweep ran the motor to the end, wrote a sidecar describing the whole
        # track, and reported "Scan complete". The pcap holds a sliver of it.
        # ⭐ This is the only place the sweep asks anything, so it is the only
        # place the question can be asked at all.
        if record and proc is not None and not capture_died:
            code = proc.poll()
            if code is not None:
                capture_died.append(code)
        return bool(capture_died) or _shutdown or _state.stop_requested()

    _state.begin_scan(profile_name, estimate_duration(profile))
    if _state.cloud is not None:
        _state.cloud.clear()  # each scan starts the preview from empty
    status_update("PREFLIGHT", "%s — %s" % (profile["label"], profile["detail"]))

    proc = None
    capture_file = None
    capture_started = None
    # Who stopped the sweep, and how far it got: read where they happen, used
    # after the abort has been reported.
    by_operator = False
    swept = (None, True)
    try:
        if record:
            preflight()
            # Where this scan records is decided here and nowhere else. USB
            # always wins when it is usable -- that is the point of plugging it
            # in -- but a missing stick must never stop a scan, so this falls
            # back to the SD card and says so on the panel.
            dumpdir, on_usb, note = tls_storage.choose_dumpdir(
                sd_dumpdir=DUMPDIR)
            if note:
                status_update("PREFLIGHT", note)
            # ⛔ AND WHEREVER IT RECORDS HAS TO HOLD A SCAN. Only the stick was
            # ever measured; the SD card the scan falls back to was not, so a
            # nearly full card took the scan and lost it part way -- the loss
            # the stick's check exists to prevent (the 45th pass's sweep,
            # `tls_storage.py:301`). Refused here, before the recorder or the
            # motor starts.
            short = tls_storage.short_of_room(dumpdir)
            if short:
                raise ScanAborted("NO_SPACE", short)
            proc, capture_file, capture_started = start_capture(dumpdir)
            _state.set(capture_file=capture_file, recording_to_usb=on_usb)
            status_update("RECORDING", "tcpdump started — sweeping%s"
                          % (" (USB)" if on_usb else ""))
        else:
            status_update("RECORDING", "capture skipped (--no-record)")

        stepper.enable()
        _state.set(phase="SCANNING")
        # Read BEFORE the sweep: afterwards the head has moved and the
        # start can only be reconstructed, which is a subtraction that
        # would have to guess the sign the move was made in.
        start_steps = (stepper.position_steps
                       if stepper.position_known else None)
        completed = stepper.move_degrees(
            profile["sweep_deg"], profile["deg_per_s"], should_abort=should_abort
        )
        _state.set(position_known=stepper.position_known)
        # Taken now, before any other move can overwrite it: after a stop, the
        # way back is the same number of steps the other way.
        swept = (getattr(stepper, "last_stop_steps", None),
                 getattr(stepper, "last_move_forward", True))

        # ⛔ THE DEAD RECORDER IS READ BEFORE `completed`, AND THE ORDER IS THE
        # POINT. A recorder that dies stops the sweep THROUGH `should_abort`,
        # so `completed` is False either way -- and reported as INTERRUPTED it
        # would tell the operator they had pressed Stop. The abort code is the
        # only thing the panel has to go on, so it has to name the cause and
        # not merely the symptom.
        if capture_died:
            raise ScanAborted(
                "TCPDUMP_DIED",
                "tcpdump stopped on its own part way through the sweep (exit "
                "%s), so the capture covers only the beginning of the track -- "
                "the scan was stopped rather than finished"
                % capture_died[0])
        if not completed:
            # ⛔ WHO STOPPED IT DECIDES WHAT HAPPENS NEXT. Only a press on the
            # panel means "throw this scan away and turn back". A shutdown must
            # not start the motor, and a dying recorder never reaches here --
            # its capture is the evidence of why, and it is kept.
            by_operator = (not _shutdown) and _state.stop_requested()
            raise ScanAborted("INTERRUPTED", "Stop pressed during the sweep")

        # Capture stops before the return leg, exactly as the firmware did.
        if record:
            stop_capture(proc, capture_file)
            proc = None
            # Before the return leg: that move overwrites the stepper's record
            # of the sweep, which is what the pan track is built from.
            write_scan_meta(capture_file, profile_name, profile, stepper,
                            capture_started, start_steps=start_steps)
            _state.set(last_capture=capture_file)
            status_update("RETURNING",
                          ("Captured %s — parking the head at %g°"
                           % (os.path.basename(capture_file),
                              park_deg(profile)))
                          if profile["return_deg"] else
                          ("Captured %s" % os.path.basename(capture_file)))
        elif profile["return_deg"]:
            status_update("RETURNING",
                          "Parking the head at %g°" % park_deg(profile))

        # ⛔ SAY WHAT IS HAPPENING, OR NOTHING AT ALL. A phase called
        # RETURNING while the head does not move is the kind of small lie that
        # sends someone looking for a fault in the motor.
        if profile["return_deg"]:
            time.sleep(1.0)
            stepper.move_degrees(-profile["return_deg"], RETURN_DEG_PER_S,
                                 should_abort=should_abort)
        _state.set(position_known=stepper.position_known)
        stepper.disable()

        status_update("COMPLETE",
                      "Scan complete: %s"
                      % (os.path.basename(capture_file) if capture_file
                         else "no capture"))

        # Build the 3D view now, automatically, while the operator is still on
        # site. Making it a button you have to remember to press means skipping
        # it exactly when a missed corner would have mattered. The motor is
        # stopped and tcpdump is closed, so this competes with nothing -- and a
        # scan request abandons it instantly (see wait_for_trigger).
        if capture_file and _builder is not None:
            _builder.request(capture_file)
        return True

    except tls_stepper.MoveOverran as exc:
        # The duration watchdog stopped the motion. Report it like any other
        # abort rather than letting it kill the controller: the operator needs
        # to see WHY on the phone, and a dead controller is a scanner that
        # cannot be told anything at all now that the buttons are gone.
        stepper.stop_and_release()
        _terminate(proc)
        status_update("ABORTED", "MOVE_OVERRAN: %s" % exc)
        _state.set(position_known=False)
        status_update("REHOME",
                      "Position unknown after an overrun — re-home, and check "
                      "the microstep jumpers against STEPS_PER_REV before the "
                      "next scan")
        return False
    except ScanAborted as exc:
        stepper.stop_and_release()
        _terminate(proc)
        status_update("ABORTED", "%s: %s" % (exc.reason, exc.message))
        if exc.reason == "INTERRUPTED" and by_operator:
            _discard_and_return(stepper, capture_file, swept)
        _state.set(position_known=stepper.position_known)
        if not stepper.position_known:
            status_update("REHOME",
                          "Position unknown after abort — re-home before the "
                          "next scan")
        return False
    finally:
        stepper.disable()
        _state.end_scan()


def _handle_signal(signum, frame):
    global _shutdown
    _shutdown = True


def main():
    global _state, _builder
    import argparse

    parser = argparse.ArgumentParser(description="TLS Pie scanner controller")
    parser.add_argument("--scan", choices=sorted(SCAN_PROFILES),
                        help="run one scan immediately instead of waiting")
    parser.add_argument("--check", action="store_true",
                        help="run the preflight checks and exit")
    parser.add_argument("--no-record", action="store_true",
                        help="move the motor without capturing (bench test)")
    parser.add_argument("--no-web", action="store_true",
                        help="disable the phone control panel")
    args = parser.parse_args()

    if args.check:
        try:
            preflight()
        except ScanAborted as exc:
            print("PREFLIGHT FAILED [%s] %s" % (exc.reason, exc.message))
            return 1
        print("Preflight OK: interface %s, lidar %s" % (ETH_INTERFACE, LIDAR_IP))
        return 0

    if pigpio is None:
        print("pigpio is not installed. sudo apt install python3-pigpio")
        return 1

    # --no-web used to leave the physical buttons in charge. There are none
    # now, so without the panel and without --scan this would sit waiting for
    # a trigger that can never arrive.
    if args.no_web and not args.scan:
        print("--no-web needs --scan: with the buttons removed the control "
              "panel is the only way to start or stop anything.")
        return 1

    signal.signal(signal.SIGINT, _handle_signal)
    signal.signal(signal.SIGTERM, _handle_signal)

    cloud = tls_cloud.create()          # None unless TLSPIE_PREVIEW=1
    _builder = tls_scanstore.CloudBuilder(DUMPDIR)
    _state = tls_web.ScannerState(SCAN_PROFILES, cloud=cloud,
                                  builder=_builder, dumpdir=DUMPDIR)

    pi = pigpio.pi()
    if not pi.connected:
        print("Cannot reach pigpiod. sudo systemctl start pigpiod")
        return 1

    httpd = None
    stepper = None
    try:
        stepper = Stepper(pi)
        print("Steps per revolution: %d" % tls_stepper.STEPS_PER_REV)

        if not args.no_web:
            httpd = tls_web.start(_state)
            # With the buttons gone the panel is the only stop control, so a
            # panel that will not bind is fatal rather than a warning. The
            # previous behaviour -- carry on without it -- was correct when a
            # physical stop button existed and is dangerous now: it would give
            # a scanner that can be started from the command line and stopped
            # by nothing.
            if httpd is None and not args.scan:
                print("REFUSING TO START: the control panel could not bind, "
                      "and it is now the only way to stop a scan.")
                print("Free the port, or set TLSPIE_WEB_PORT, or use "
                      "--scan/--no-web for a bench run you supervise.")
                return 1

        if args.scan:
            ok = run_scan(pi, stepper, args.scan, record=not args.no_record)
            return 0 if ok else 1

        while not _shutdown:
            action = wait_for_trigger(pi)
            if action is None:
                break
            kind, value = action
            if kind == "restart":
                # run_scan handles its own overruns; do_restart moves the head
                # too, so it needs the same guard. The controller must survive
                # a fault -- it is the only thing the phone can talk to.
                try:
                    do_restart(pi, stepper)
                except tls_stepper.MoveOverran as exc:
                    stepper.stop_and_release()
                    _state.set(busy=False, position_known=False)
                    status_update("ABORTED", "MOVE_OVERRAN during re-home: %s"
                                  % exc)
            else:
                run_scan(pi, stepper, value, record=not args.no_record)
        return 0
    finally:
        if stepper is not None:
            stepper.stop_and_release()
        if httpd is not None:
            httpd.shutdown()
        if cloud is not None:
            cloud.stop()
        pi.stop()
        status_update("STOPPED", "Controller exited")


if __name__ == "__main__":
    sys.exit(main())
