Kizim01/Kizim-TLS-Pie/(commit log)

2026-08-08 Fix KILL interrupt hang, floating button inputs, and RAM pressure
    KILL_SCAN() ran as an ISR but called delay() and drove the OLED. Inside an
    ISR interrupts are masked, so Timer0 never ticks and millis() never advances
    -- delay() blocked forever. The board would blank its screen and hang on the
    first kill press, and because the RECORDSTOP pulse sat after those delays,
    the Pi was never told to stop recording.
    The ISR is now killISR(), which only sets a volatile flag. All display work,
    the RECORDSTOP pulse and the motor shutdown moved to handleKill() in normal
    context.
    Also:
    - KILL interrupt changed RISING -> FALLING. The buttons are wired active-low,
    so with a pull-up the pin idles high;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
    [LidarHDMicroviewV1.0.ino]
2026-08-08 Move Pi handshake off D4/D7/D8 -- those pins are not on the MicroView header
    The MicroView breaks out only twelve I/O pins. D4, D7, D8, D10, D11 and D13
    are consumed internally by the OLED, so the three Pi handshake signals were
    named against pins that do not physically exist on the 16-pin header:
    PISTATUS D4 -> the display's 3.3V regulator enable (OLEDPWR)
    RECORDSTART D7 -> OLED reset (PORTD bit 7)
    RECORDSTOP D8 -> OLED data/command (PORTB bit 0)
    Driving those from the sketch fights the display for its own control lines --
    pulsing RECORDSTART reset the OLED, and anything pulling D4 low switched the
    display's power rail off. Verified against SparkFun_MicroView/src/Micr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
    [LidarHDMicroviewV1.0.ino]
2026-08-08 Move the scanner onto the Pi and drop the MicroView handshake
    The Pi 4 now owns the buttons, the pan motor and the pcap capture in one
    process. The MicroView's job disappears rather than being reimplemented.
    tls_stepper.py -- pan axis on the Big Easy Driver, clocked by pigpio DMA
    waveforms. Linux is not real-time, so a step train bit-banged from a Python
    loop stalls whenever the scheduler preempts it, and on a laser scanner that
    jitter lands in the point cloud as angular error. pigpio clocks pulses from a
    DMA buffer at ~1us resolution instead. Trapezoidal profile: a 16-segment
    linear ramp, a chunked-and-looped cruise, then a mirrored decel. Segments
    become single-pulse waves repeated by wav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
    [tls_scan.py, tls_stepper.py]
2026-08-08 Add a Pi GPIO damage check after the reversed-harness incident
    The MicroView harness was wired with both pin rows reversed (right column
    N <-> 25-N, left column N <-> 9-N). Two consequences reach past the MicroView:
    * the GND wire landed on RESET (pin 1), so the board had no ground return
    and every return current went out through ESD protection diodes
    * the wires intended for TX and RX landed on pin 15 (+5V rail) and pin 16
    (VIN) -- both of which run off-board
    12V on pin 9 (D0) forward-biases that pin's clamp diode into VCC, pulling the
    whole 5V net to ~11V. Pin 15 is that net, and pin 15 was wired to whatever the
    TX line connects to. If that was the Pi's GPIO15/RXD (header pin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
    [gpio_selftest.py]
2026-08-08 Rewrite PROJECT_CONTEXT.md and log the architecture change
    PROJECT_CONTEXT.md described D7/D8 -> GPIO17/27 as the live architecture. That
    is now wrong twice over: the MicroView is destroyed, and those three pins were
    never broken out to its header in the first place. A future session reading it
    would have acted on a system that no longer exists.
    Rewritten around the current state:
    * the incident, its confirmed cause (both harness pin rows reversed, putting
    12V on physical pin 10 = D1/TXD and the GND wire on RESET), and what was
    ruled out during diagnosis
    * the open question of whether the Pi is damaged, why U2 probably protected
    it, and the command that settles it
    * the P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
2026-08-09 Correct STEPS_PER_REV to 320,000 -- the driver is an A4983/A4988, not a DRV8825
    A photograph of the fitted board shows the chip marked 4983ET: an Allegro
    A4983/A4988, which is what the SparkFun Big Easy Driver uses. Its maximum is
    1/16 microstepping. Only the DRV8825 does 1/32, and that is not the fitted part.
    400 steps x 16 microsteps x 50:1 = 320,000 <- correct
    400 steps x 32 microsteps x 50:1 = 640,000 <- what the firmware used
    The old constant commanded twice the steps a revolution actually takes, and
    because the step rate is derived from the same constant the speed was doubled
    too. A nominal "360 deg at 1 deg/s over 6 minutes" scan was really about
    756 deg at 2 deg/s. This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
    [tls_stepper.py]
2026-08-09 Add the phone control panel, point-cloud preview, and cut to two scans
    The rig is headless -- no OLED, no monitor -- so the operator display is now a
    web page the Pi serves to a phone. It improves on what it replaces: a 64x48
    OLED could never show elapsed time, capture size, or what the lidar is seeing.
    tls_web.py -- stdlib-only HTTP server on a daemon thread inside tls_scan.py, so
    it shares scanner state directly rather than guessing at it through a file. Its
    stop button raises the same flag the GPIO stop button does: one abort path, not
    two. iOS-style interface, frosted glass over a gradient wallpaper, SF Pro via
    the system stack, dark by deliberate choice for a field instrument. Optional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
    [tls_cloud.py, tls_scan.py, tls_stepper.py, tls_web.py]
2026-08-09 Sync context and changelog with the phone UI, preview and two-scan design
    PROJECT_CONTEXT.md updated to match what the code now does rather than what it
    did this morning:
    * button map is Slow / Quick / Restart / Stop, and Restart is documented as
    what closes the "re-home manually after abort" gap -- pigpio cannot report
    how many steps left the DMA buffer, so it either drives back to zero or
    takes the current position as the new zero
    * two scan profiles, both full 360; the 180 is gone and why
    * the phone panel: one abort path shared with the GPIO stop button, the token,
    the SSH-drop hazard, and the field networking options
    * the point-cloud preview, why it is opt-in,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
2026-08-09 Add setup_wifi.sh -- join the Pi to WiFi without a credential in git
    The repo is on GitHub, so a password committed here is permanent even if a
    later commit deletes it. The SSID is a positional argument and the password is
    read interactively with `read -rs`; neither is stored. On the wpa_supplicant
    path it uses wpa_passphrase so even the local config holds a hash rather than
    the plaintext.
    The checks afterwards are the point, not the connection itself. The Pi runs two
    networks doing two jobs -- eth0 is the Velodyne at 192.168.1.x and is the
    capture path, wlan0 is the control panel and SSH. If WiFi hands out an address
    in the lidar's subnet the two collide and packets can leave via the wrong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
2026-08-09 Add the networking section and turn the next-step list into a restart pointer
    PROJECT_CONTEXT.md now covers the two-interface split -- eth0 is the Velodyne
    and the capture path, wlan0 is the control panel and SSH -- and points at
    setup_wifi.sh. Records that the WiFi credential is deliberately absent from the
    repo and that the next session should ask for it rather than hunt for it.
    The subnet-clash hazard is written down because it fails quietly: if WiFi hands
    out an address in 192.168.1.x it collides with the lidar and packets can leave
    via the wrong interface, which looks like a capture problem rather than a
    network one.
    The closing section is now an ordered restart pointer rather than a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
2026-08-09 Make the phone panel installable to the home screen
    Android's "Add to Home screen" gave a bookmark with a page thumbnail. It now
    gets a manifest and a real icon, so it presents as an app.
    - web app manifest at /manifest.webmanifest; start_url carries the token, or
    the home-screen icon would open a page that answers 403
    - launcher icon rendered at runtime from stdlib zlib+struct (the rig has no
    Pillow, and a binary blob in git is unreviewable); cached per size, and the
    pixel loop is skipped outside the artwork disc
    - manifest and icon routes are exempt from the token check: the browser
    fetches them with no query string, so requiring a token would break the
    install for exactly the p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
    [test_web_install.py, tls_web.py]
2026-08-09 Add first-boot provisioning for a fresh SD card
    One idempotent script to take a clean Raspberry Pi OS install to a working
    scanner: pigpio + tcpdump + avahi, capture directory, executable bits, a
    static NetworkManager profile for the lidar link, and the systemd unit.
    Two deliberate choices worth stating:
    - tls-scan.service is installed but NOT enabled. The ENABLE pull-up resistor
    is still not fitted, and every Pi GPIO floats as an input for the ~30 s the
    Pi takes to boot; ENABLE is active-low, so autostart could energise the
    driver with no software in control. gpio_selftest.py has also not been run
    since the 12 V incident. Autostart is a hazard until both are settled.
    - eth0 gets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
2026-08-09 Fix two bugs in gpio_selftest that misreported a healthy Pi
    Run against the real Pi 4 for the first time today. It called three pins
    damaged. Two of those calls were wrong and the third was too blunt to act on.
    1. GPIO2 and GPIO3 were reported "STUCK HIGH - ignores the internal
    pull-down". They are the I2C pins, and every Pi carries 1.8k pull-ups to
    3V3 fitted on the board itself. The internal pull-down is ~50k and cannot
    pull against 1.8k, so reading high is correct, healthy behaviour. The test
    now knows about those pins and only checks the direction that means
    anything for them.
    2. The pull test returned early on failure, so the output-driver test never
    ran on exactly t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
    [gpio_selftest.py]
2026-08-09 Remove the push buttons; add the duration watchdog they were covering for
    SW1-SW5 and their pull-ups R1-R5 come off the board. The rig is operated from
    the phone, so the buttons earned nothing. S1 (Main) and S2 (Lidar) stay --
    those are the power switches after the battery, not buttons.
    R1-R5 had to go regardless: they pull to 5 V, which is not something a Pi GPIO
    should ever see.
    GPIO5, 6, 12, 17, 22 and 27 are now unused. Only STEP, DIR and ENABLE remain
    on the header, which also makes the GPIO27 damage found today irrelevant.
    WHAT THIS COSTS, AND WHAT COVERS IT
    The phone panel is now the only software abort, and the Pi reaches the phone
    over the phone's own hotspot -- one device is bo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
    [test_stepper_watchdog.py, tls_scan.py, tls_stepper.py]
2026-08-09 Record S1, the main power switch, as the emergency stop
    The previous commit said a latching switch in series with ENABLE was now
    mandatory. The user's answer is better: use S1, the main power switch that
    already exists.
    It stops rotation whichever way the supply is arranged. If S1 feeds the
    driver, the coils de-energise. If it only feeds the Pi's 5 V converter, STEP
    stops toggling and the motor stops turning anyway. So the conclusion does not
    depend on reading the power distribution off the schematic, which I could not
    do reliably from the image.
    It is also more complete than the ENABLE switch I was arguing for: it removes
    the energy instead of asking the driver to stand down, and it canno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
2026-08-09 First hardware milestone: Pi built, proven, panel driven from the phone
    The rig's controller now exists and works. Recorded in the restart pointer,
    which had said "everything below is unstarted" since it was written.
    Proven on hardware today:
    - fresh Bookworm card, on the hotspot, ssh tlspie from the laptop
    - the Pi survived the 12 V incident. GPIO14/15 both pass, which was the
    open question. GPIO27 is output-only and nothing uses it.
    - pigpio 1.79 with pigpiod active -- the reason Bookworm was mandatory
    - the phone drove both scans, Stop mid-scan, the re-home prompt, Restart,
    Full screen and Add to Home screen, using --no-record so the real motion
    state machine ran wit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
2026-08-09 Bring PROJECT_CONTEXT.md up to date with the built hardware
    The file still described a rig with four push buttons, an unresolved question
    about whether the Pi was damaged, a stop button that fails dangerous, a
    missing duration watchdog, and "nothing has run on hardware". All of that is
    now wrong, and this is the file a fresh session reads first and believes.
    Corrected throughout:
    - the Pi damage question is RESOLVED and moved from inference to
    measurement. GPIO14/15 pass; GPIO27 is output-only and unused. The
    incident cost one MicroView, not a Pi.
    - the pin map is three motor lines and the RTC. All buttons removed;
    GPIO5/6/12/17/22/27 free. S1/S2 are power switches and stay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
2026-08-09 Build pcap -> registered point cloud; two hardware facts settled by measurement
    The scan pipeline gains the step that turns a recording into a scan, and the
    real capture used to test it overturned two things this project believed.
    New: tls_geometry (mount rotation, lever arm, PanTrack), tls_pcap (stdlib pcap
    reader), tls_cloudbuild (pipeline, .cloud container, CLI), and 67 checks in
    test_cloud_registration that need no hardware.
    Every scan now writes a sidecar next to its pcap holding the pan track, the
    mount geometry and the zero's provenance. Without it a 360 MB capture decodes
    into the sensor frame and every static surface smears around the whole circle
    the head turned through -- only t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
2026-08-09 Add the 3D scan viewer: browse stored scans, orbit them, overlay and nudge
    A Scans card lists every capture grouped by day. Tap one and a full-screen
    WebGL view opens -- one finger orbits, pinch zooms, two fingers pan -- with
    colour by height, scan or intensity, and a Layers panel to overlay other scans.
    Hand-written WebGL rather than a library. The Pi serves this offline on a phone
    hotspot so every byte comes from the Pi, and a point cloud is one buffer and
    one draw call; three.js would be most of a megabyte to save eighty lines of
    matrix maths. Positions reach the GPU as int16 centimetres and are scaled in
    the shader: half the transfer of float32 and below what the sensor resolves.
    The c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
    [test_viewer.py, tls_cloudbuild.py, tls_scan.py, tls_scanstore.py, tls_web.py]
2026-08-09 Slim the Layers panel down, make it see-through, and give it a way out
    Three things wrong on first real use on the phone: it covered most of the
    screen, it was effectively opaque, and there was no way to dismiss it except
    the Layers button behind it.
    Width goes from min(330px, 88vw) to min(248px, 60vw), the background from .96
    to .55 alpha with a stronger blur, and a sticky header carries a Done button.
    The transparency is not decoration. The panel's main job is nudging one scan
    onto another, and a panel that hides the cloud you are lining up against makes
    that impossible -- you would be dragging a slider blind. Narrow also leaves
    enough canvas to orbit without dismissing the panel, so che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
    [test_viewer.py, tls_scanstore.py, tls_web.py]
2026-08-09 Make the panel permanent, and fix two real faults in the unit while doing it
    Enabled tls-scan.service so the control panel comes up on its own at every
    boot, with no SSH and nothing to remember. Starting the unit does not move the
    motor: the controller comes up IDLE and only turns the head when someone
    presses a scan on the panel.
    Two faults found on the way in, both of which systemd had been quietly living
    with:
    * StartLimitBurst and StartLimitIntervalSec were in [Service], where systemd
    ignores them -- the journal has been logging "Unknown key
    'StartLimitIntervalSec' in section [Service], ignoring" all along. So the
    guard against restarting in a tight loop while the motor i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
2026-08-09 Log the panel's address once WiFi turns up, and record the permanent service
    Now that the unit no longer waits for network-online.target, the panel starts
    before WiFi associates -- so the startup banner could only ever say the address
    was unknown, which is exactly when an operator goes looking for it. A short
    daemon thread now polls and logs "Control panel is reachable at http://..." the
    moment a route exists, then stops. It gives up quietly after ten minutes rather
    than polling forever on a rig that will never have WiFi.
    Verified over a reboot: the banner says it is waiting, and nine seconds later
    the journal carries the real address.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
    [tls_web.py]
2026-08-09 Rev 2.0 wiring schematic: every conductor named at both ends
    The Rev 1.0 drawing still shows the MicroView, the level shifter, five push
    buttons and a monitor -- none of which exist any more -- and the current pin
    assignments live only in a table in MICROVIEW_REMOVAL.md. WIRING_REV2.html is
    the drawing to build from: three sheets (power tree, motor chain, capture
    path), the full 40-pin header map with all 40 pins accounted for, per-device
    pinouts and a master netlist with one row per conductor.
    Three things surfaced while drawing it, all recorded in PROJECT_CONTEXT.md:
    * U3 is labelled XL6009, which is a step-UP converter and cannot make 5 V
    from 12 V. Either the modules are buck-boost v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
2026-08-09 Link the Rev 2.0 schematic's hosted copy for bench reading
2026-08-09 Add Sheet 4: the header drawn in the board's own orientation
    The user works from the standard pinout card -- pin 1 at the bottom, odd pins
    up the right column, even up the left, header down the board's left edge.
    Sheets 1-3 are organised by subsystem, which is right for understanding the
    rig and wrong for wiring it: you are looking at the connector, not at the
    power tree. Sheet 4 redraws the same eleven conductors from the header's point
    of view, with all 40 pins named as the card names them, and reorients the pin
    table to match.
    Also fixes two errors in the first cut of the header map: pin 1 was listed as
    a spare while the netlist had it feeding the DS3231's VCC, and the count said
    six pin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
2026-08-09 Redraw the RTC for the actual board: Adafruit DS3231, not a ZS-042
    The sheets carried a generic 5-pin DS3231 module (VCC/SDA/SCL/NC/GND) taken
    from the Rev 1.0 drawing. The board on the bench is Adafruit's Precision RTC
    breakout: eight pins, and a different order -- Vin, GND, SCL, SDA, BAT, 32K,
    SQW, RST. Figure 3 and Sheet 4 now show all eight in silkscreen order, with
    BAT/32K/SQW/RST explicitly open, and Sheet 4 draws the crossing honestly
    rather than pretending the header hands the wires over in the breakout's
    order.
    The reason this matters beyond tidiness: the breakout's I2C pull-ups
    reference Vin, so Vin sets the bus voltage. Vin on 5 V would pull GPIO2 and
    GPIO3 to 5 V and the Pi's GP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
2026-08-09 RTC is live: DS3231 verified on the real Pi, clock set from the chip at boot
    i2cdetect found 0x68 first try and nothing at 0x57, which is itself the
    confirmation that this is the Adafruit board rather than a ZS-042 clone.
    Enabled i2c_arm, added the i2c-rtc overlay, added i2c-dev to /etc/modules,
    removed fake-hwclock. dmesg after the reboot shows rtc-ds1307 setting the
    system clock 1.2 s into boot, before any network -- which is the whole point,
    since the rig timestamps captures and has no guaranteed internet.
    Two traps recorded: dtparam=i2c_arm=on alone does not create /dev/i2c-1 at
    boot without i2c-dev in /etc/modules (raspi-config normally adds it, editing
    config.txt by hand does not), an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
2026-08-09 ENABLE pull-up CLOSED: fitted by the user, then measured over SSH
    The gating safety item is done. Rather than take 'it is fitted' on trust --
    this project has been wrong three times from inspection and right every time
    from measurement -- GPIO13 was released for ~50 ms and the external circuit
    interrogated: HIGH against the internal pull-down AND against the internal
    pull-up, 40/40 samples in both. Only an external pull-up on a live supply
    gives that signature, so R_PU is fitted and the driver's VCC is powered.
    Records the method, because it separates 'pull-up fitted and powered' from
    'fitted but unpowered' from 'nothing connected' without a meter, and the 1k
    series resistor does not defeat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
2026-08-09 Add bench_move.py: command one exact move, settle STEPS_PER_REV by return-to-mark
    First motor motion on this rig ran today (378 deg profile, aborted at 71.8 s
    by the panel Stop, which worked). Two numbers now disagree: the log says
    71.8 s of commanded 1 deg/s, so ~72 deg, and the head was read as 90 deg. If
    the 90 is right the implied constant is ~510,400 -- suspiciously close to
    400 x 16 x 80 = 512,000, an 80:1 harmonic drive -- against the 640,000 the
    2022 driveway capture supports to 0.03%.
    An eyeballed angle cannot separate 72 from 90, so this tool exists to command
    a FULL TURN and ask only whether the head lands back on its mark. No
    protractor, no reading error, and a 26% error becomes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
    [bench_move.py]
2026-08-09 Correct the power tree to LM2596 bucks; driveway.pcap is a DIFFERENT RIG
    Two corrections from the user, both of which invalidate conclusions recorded
    earlier the same day.
    1. The converters are LM2596S-ADJ bucks, not XL6009 boosts -- the Rev 1.0
    label was wrong. That closes the 'it can only boost and will destroy the
    Pi' hazard I raised while drawing Rev 2.0. A new one replaces it: a buck
    cannot make 12 V from a 12 V pack, so if U6 is set to 12 V it is in
    dropout and the motor rail sags under exactly the load that is currently
    losing steps. Recommend deleting U6 and feeding M+ from the switched
    battery; the driver takes 8-35 V and U6 only existed for the monitor.
    2. captu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
2026-08-09 Clear the last XL6009 references from the schematic prose and alt text
2026-08-09 Set the motor current with no ammeter: use the head as the instrument
    The operator has no current meter. They do not need one: bench_move.py now
    gives a quantitative read of step loss, so nudge the pot, run 90 deg, read the
    angle against a mark, repeat. The achieved angle climbs with current and then
    plateaus, and the plateau is the endpoint -- this converges on the current
    setting and STEPS_PER_REV together with nothing but a pencil mark.
    Also records what the board photograph actually shows: IC is 4983ET, the
    trimmer is silkscreened CUR ADJ PWR with a + for direction, sense resistors
    read R11F. The Vref arithmetic that follows from 0.11 ohm is written down but
    flagged not to be acted on u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
2026-08-09 Fix 'too many chain counters': no scan could ever have finished
    Found on hardware. _build_chain emitted one pigpio loop counter per motion
    segment, and pigpio allows only a handful per chain. A slow move has a ramp
    about two steps long, collapses to ~5 segments and worked. A fast move
    spreads its ramp over RAMP_SEGMENTS at each end:
    378 deg @ 1 deg/s -> 5 segments -> worked
    378 deg @ 2 deg/s -> 19 segments -> would have failed
    18 deg @ 7 deg/s -> 31 segments -> would have failed
    That last line is the return leg of EVERY scan. The whole fast profile was
    broken too. It went unseen because the only move ever run to completion was
    the slow sweep, and it was aborted before the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
    [test_stepper_watchdog.py, tls_stepper.py]
2026-08-09 STEPS_PER_REV = 160,000, measured on this rig by counting turns
    640,000 pulses at 7 deg/s turned the head exactly four revolutions back onto
    its mark. 640,000/4 = 160,000 = 200 x 16 x 50:1. The configured value was
    wrong by 4x from two compounding 2x errors: it assumed a 0.9 deg/step motor
    (it is 1.8) and a 100:1 reduction (it is 50:1, exactly as the oldest documents
    said). Every scan this rig ever ran swept four times as far and fast as told.
    Three earlier attempts disagreed because the motor sheds ~2/3 of its steps at
    1 deg/s. Re-read against 160,000 the runs keep 31%, 38% and 100%, the last
    being the 7 deg/s one -- so the rule is: count whole turns against a mark, and
    never calibrate at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
    [test_stepper_watchdog.py, tls_stepper.py]
2026-08-09 Re-key the step-loss data to motor RPM -- deg/s was a trap
    The confirmation run clicked and kept ~56%, at the same '7 deg/s' that had
    been silent and lossless an hour earlier. Not a regression: step rate is
    deg/s x STEPS_PER_REV, so correcting the constant by 4x divided every rate by
    4. That command meant 233 RPM before and 58 RPM after.
    Any table of this behaviour written in deg/s is therefore wrong the moment the
    constant changes -- which is exactly how I nearly recorded '7 deg/s is silent'
    as a durable fact. Re-keyed everything to motor RPM: clicks at 8.3, 33 and 58
    RPM keeping 34-56% of steps, silent at 133 and 233 RPM keeping 100%. The
    threshold is between 58 and 133 RPM.
    Failing only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
2026-08-09 Save the session: the motor turned, and four documented facts fell
    Restart pointer now opens with what would most mislead a cold read: the 4x
    STEPS_PER_REV error, driveway.pcap being a different rig, the LM2596-not-
    XL6009 correction, and the chain-counter bug that made every scan's return
    leg impossible. Records the baseline for the open blocker -- 45 deg of a
    commanded 90 at the fast profile's speed, 50% of steps kept, trimmer still
    untouched -- and rewrites the stale to-do list, which still told the reader to
    go and confirm 640,000.
    Also captures the three method lessons the day earned: count whole turns
    against a mark rather than reading an angle; never calibrate at a speed where
    the me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
2026-08-09 Restart pointer: name the single blocking action, and where memory now lives
    Opens the restart pointer with the one command that unblocks the project --
    set the current limit, iterate with bench_move.py 90 2.0 against the recorded
    45-of-90 baseline -- because everything else is downstream of it and no scan
    has ever completed.
    Also records that this project's session memory was moved out of the
    trading-bot namespace into its own on 2026-08-09, so start Claude Code from
    this directory. Flags that the namespace name is inferred from the path and
    unconfirmed, and that none of it is load-bearing: this file is the record.
2026-08-10 Close the motion blocker: the current limit was too HIGH, not too low
    Turning CUR ADJ PWR DOWN an eighth of a turn made every speed silent and
    lossless. The slow profile -- 1 deg/s, 8.3 RPM, a full 360 in 360.0 s --
    now lands exactly on its mark, having never once worked before. Also
    clean at 2, 7 and 12 deg/s.
    The direction was DOWN and every prior instinct said UP. This file said
    "the standard cure is more phase current"; so did I. That reasoning --
    a motor short of torque fails at HIGH speed, so failing at LOW speed
    means give it more -- is backwards for a geared axis with a huge torque
    surplus. Through 1/16 microstepping and 50:1 there was ~29 Nm at the
    output for a head needing a fract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
    [burst_probe.py]
2026-08-10 Pin LF endings for everything that runs on the Pi
    core.autocrlf=true plus a bare 'text=auto' meant the next checkout on
    Windows would hand these scripts CRLF. They are then scp'd to the Pi,
    where the shebang reads '#!/bin/bash\r' and Linux answers:
    /bin/bash^M: bad interpreter: No such file or directory
    The ^M is easy to miss and the message never says 'line endings'. The
    files happened to be LF today by luck rather than by rule; git warned it
    was about to change that while adding the kiosk scripts. Python is just
    as exposed -- bench_move.py and burst_probe.py are executed directly, so
    their shebangs matter too.
2026-08-10 Show the rig's power state on the panel -- phone and local screen alike
    Written the night a draining pack made the motor shed steps and then
    rebooted the Pi mid-move with no warning, and -- worse -- made a flat
    battery look like a mechanical fault for the better part of an hour. A
    supply you cannot see is a supply that corrupts your measurements.
    Because the kiosk renders the same web app the phone loads, this appears
    on both surfaces from one implementation.
    Two sources behind one interface, and read() never raises:
    vcgencmd no hardware. 5 V rail under-voltage now and ever since
    boot, plus SoC temp. A health light, NOT a fuel gauge --
    and the UI says s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
    [test_power.py, tls_power.py, tls_web.py]
2026-08-10 Fix chip detection: it was misreading every INA226 as an INA219
    Shipped hours ago in 4ddce63 and wrong. Detection compared register 0xFE
    against 0x2260, but on the INA226 0xFE is the MANUFACTURER id (0x5449)
    and 0x2260 is the DIE id at 0xFF. No INA226 could ever have matched, so
    every one would have fallen through to the INA219 branch and been read
    with INA219 scaling -- 4 mV/LSB and a 3-bit shift applied to a register
    that is 1.25 mV/LSB and not shifted.
    That does not raise. A 12.60 V pack would have displayed as 5.04 V: a
    plausible number, on a battery gauge, wrong by 7.5 V and with nothing to
    indicate it. Found only because the question "why not use the INA238?"
    sent me back to the regis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
    [test_power.py, tls_power.py]
2026-08-10 Tell "no chip fitted" apart from "chip won't identify itself"
    Caught by deploying to the actual Pi, which is the only place smbus2 is
    installed. With nothing on the bus every probe read raised OSError, and
    that was reported as "unidentified device at 0x40 -- set
    TLSPIE_INA_CHIP". Nothing is fitted to this rig and nothing is meant to
    be yet, so that message sent the operator hunting a wiring fault on a
    machine with no monitor in it. i2cdetect confirms the bus holds only the
    DS3231 at 0x68.
    These are different problems and must not share a message:
    silence on the bus -> no chip fitted, the rig's NORMAL state. Say
    nothing, fall back to the SoC rail source.
    answers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
    [test_power.py, tls_power.py]
2026-08-10 Record scans to a USB stick when one is in, the SD card when it is not
    A slow scan is ~340 MB, so a busy day is ~7 GB written to the SD card.
    SD cards die from write wear and a dead boot card takes the whole rig
    down until it is re-flashed; a dead 5 GBP stick is an inconvenience. It
    also means data leaves the rig by being picked up rather than squeezed
    through a hotspot that has dropped this Pi repeatedly all evening.
    THE RULE: a missing stick must never stop a scan. choose_dumpdir() runs
    ONCE, at PREFLIGHT, and falls back to the SD card whenever the stick is
    absent, unwritable or under 1 GB free. It is deliberately not consulted
    again -- a destination that can change while tcpdump is runni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
    [test_storage.py, tls_scan.py, tls_scanstore.py, tls_storage.py, tls_web.py]
2026-08-10 The screen is on the rig, and the BMS turns out to be the wrong one
    LOCAL TOUCH PANEL: FITTED AND WORKING. The 5.5" Waveshare AMOLED renders
    the same web app the phone loads, full screen in portrait, with working
    touch. It needed NO display configuration at all -- the panel supplies
    EDID and offers 1080x1920 natively, so every hdmi_timings instruction in
    the Waveshare documentation was not merely wrong for Bookworm KMS but
    unnecessary.
    Four things had to be removed to get there, all now recorded as warnings
    so nobody re-adds them:
    PAMName=login + TTYPath=/dev/tty1 the pattern every kiosk guide
    recommends. getty@tty1 is active here, so StandardInput=tty-fail
    could not claim t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
    [tls_web.py]
2026-08-10 The cursor was never going to hide: cage does not read XCURSOR_THEME
    Three attempts at the kiosk cursor failed for one reason, found by reading
    the binaries instead of the documentation:
    strings /usr/bin/cage | grep -i xcursor -> API symbols only
    strings libwlroots-0.18.so | grep XCURSOR_ -> XCURSOR_PATH, alone
    cage calls wlr_xcursor_manager_create(NULL, ...) and wlroots substitutes the
    literal string "default" for a NULL theme name. Neither XCURSOR_THEME nor
    XCURSOR_SIZE exists anywhere in either binary, which is why setting the size
    to 1 did not shrink the arrow either -- that was the clue all along.
    So the theme is installed as "default" (for cage) as well as "t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
    [test_blankcursor.py, test_shutdown.py, tls_blankcursor.py, tls_web.py]
2026-08-10 The cursor was chromium's, and the pointer was an HDMI CEC device
    Four attempts at a transparent cursor THEME all failed because the arrow was
    never a theme cursor. Settled by instrumenting rather than reasoning:
    strace -e trace=openat on cage -> it DID open our transparent left_ptr,
    successfully. Theory dead.
    grim screenshots, fetched and -> the arrow is present in the capture
    actually looked at taken WITHOUT -c, which does not
    overlay a cursor. So it is composited
    into the framebuffer, and the shape is
    ch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
2026-08-11 Boot splash: the artwork from power-on, then the video, then the panel
    Nothing was on screen between power-on and the panel except the rainbow
    square, the kernel log and a login prompt. Now:
    firmware rainbow square -> disable_splash=1
    kernel log, raspberries, -> quiet, loglevel=3, logo.nologo,
    blinking cursor vt.global_cursor_default=0, console->tty3
    userspace getty on tty1 -> plymouth holds the artwork
    ~25 s cage + chromium -> plymouth quits only AFTER tls-kiosk starts
    then the intro video, then the control panel
    The plymouth still is the video's own first frame, so the picture the
    operator has been looking at turns out to b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
2026-08-11 Boot splash: play the intro with mpv, and stop trusting frame counters
    Follow-up to 05aef6b, fixing three things that were each invisible until the
    pixels were actually measured rather than the logs believed.
    1. --hwdec=auto renders a SOLID BLUE RECTANGLE while mpv cheerfully reports
    "fps=24.000 dropped=0". Screenshotting the panel and measuring variance:
    --hwdec=auto rgb(0,13,128) variance 0.0 <- flat blue
    --hwdec=no rgb(57,60,64) variance 1427.4 <- the video
    --vo=wlshm rgb(56,58,62) variance 1373.0 <- also fine
    Software decode of 1080x1920@24 is comfortable on a Pi 4, so there is
    nothing to win and a blue screen to lose. Guarded by a test that str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
2026-08-11 Cut the boot white flash from 1.10 s to 0.40 s with a paint-first shim
    chromium's window is WHITE from the moment cage maps it until it first
    paints, and painting the panel takes about a second on this Pi. Measured by
    recording the screen with wf-recorder at 30 fps and counting frames whose
    average luma exceeds 200 -- sampling with grim missed it entirely and
    reported zero, which is why the earlier commit claimed it was fixed:
    panel opened directly ............... 1.10 s white
    --default-background-color=ffARGB ... no change <- the flag does nothing
    --default-background-color=RGB ...... no change
    http://localhost:8080/boot.html ..... 0.37 s
    local file:// shim .................. 0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
    [test_intro.py, tls_web.py]
2026-08-11 Add a Reboot button, and give the header its transparency back
    REBOOT
    POST /api/reboot?confirm=yes, sharing one implementation with shutdown on
    both sides. The guards are the whole point of these buttons, so two
    near-copies would be two places for one to rot out of step: same confirm,
    same refusal while a scan is running, same USB flush-and-unmount first with
    a failed unmount aborting it.
    ⚠ Called "Reboot the Pi", never "Restart". There is already a Restart button
    on this page and it returns the HEAD to start and clears a fault. Two
    controls called Restart, one of which reboots the computer mid-session, is a
    trap in the dark on a tripod. It is amber rather than red as well: it is
    recovera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
    [test_shutdown.py, tls_web.py]
2026-08-11 Frosted cards for free, and kill the white flash after the intro
    AERO
    The kiosk cards are translucent rather than blurred. What backdrop-filter
    blurs here is the page background, and that background is a smooth gradient
    with no high-frequency detail -- blurring it produces nearly the same pixels
    as not blurring it, so a genuinely translucent card over it reads as frosted
    glass for nothing. A lit top edge supplies the bevel. Measured idle, summed
    over every chromium process:
    opaque (flat) ............ 7.0% of one core
    translucent, no blur ..... 8.0% <- current
    real backdrop-filter ..... 17.1%
    The first cut at this made the cards nearly opaque, throwing the look away
    with the cost; t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
2026-08-11 Rev 3.0: fit the 3S BMS, and move the star point off the pack terminal
    The replacement board arrived, and its own silkscreen answered three things
    the record had listed as "confirm before fitting":
    B1+ 3.7V / B2+ 7.4V / B3+ 11.1V -> 3S, and the Li-ion variant. A LiFePO4
    board of this family reads 3.2/6.4/9.6 V. No listing needed.
    no C- pad, only B- / P+ / P- -> common port. Two wires leave the pack.
    8x 075N03L in the negative leg -> switching is on the negative side, which
    is *why* the star point has to move.
    That last one is the change most likely to be got wrong, so it is stated three
    times over: a ground landed on B- instead of P- bypasses the protection FETs,
    which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
    [TLS_Pie.kicad_sch]
2026-08-11 Pin the KiCad and HTML sources to LF
    git add warned it was about to CRLF the whole Rev 3.0 project on the next
    checkout. Nothing in the working copy would have shown it -- the files are LF
    here -- but a fresh clone would have got CRLF and failed the validator's own
    'is LF only' check, which is exactly the kind of failure that wastes a session.
2026-08-11 STOP: the pack may be 4S, which would make the 4S BMS correct all along
    The user corrected the pack: 12 cells in 4 rows of 3, not the 36 that "3S12P"
    claimed. "4 rows" is exactly what 4S3P looks like, and layout does not settle
    topology -- it depends where the nickel strips run. Two things follow, and they
    are independent.
    The diagnosis may be inverted. At 12.22 V, 3S is 4.07 V/cell (nearly full, so a
    BMS refusing to conduct must be at fault) and 4S is 3.05 V/cell (genuinely low,
    and one weak group easily sits under the cutoff). BOTH explain the ~0.55 V
    body-diode reading. If it is 4S the original board was right, the pack really
    was flat, and the fix is a 16.8 V charge plus finding the wea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
2026-08-11 Rev 3.1: the pack is 4S3P, the BMS was right, and every trace is now drawn
    Two changes, both from the user.
    FIRST: the pack is 4S3P -- 12 cells in 4 rows of 3, not the 36 that "3S12P"
    claimed. That inverts the diagnosis. At 12.22 V a 4S pack sits at 3.05 V/cell,
    which is genuinely low, so the 4S board already fitted was the CORRECT part
    doing its job, and the ~0.55 V body-diode reading was it working rather than
    failing. The original "flat battery" conclusion was right and should never have
    been struck out: the argument used to void it -- "3S12P is ~330 Wh, it could not
    drain in an evening" -- rested entirely on the cell count. Twelve cells is
    ~130 Wh, about seven hours at the rig's ~18 W.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
    [TLS_Pie.kicad_sch]
2026-08-11 Add the USB-C charge path: PD trigger, buck, series R, into P+ and C-
    The user wants to charge over USB-C and has a 303PDSink01 PD trigger board and
    LM2596S-ADJ bucks. Drawn on the sheet as J_USB -> U12 -> R_CHG -> the fused
    node, returning to C-.
    Three things the drawing exists to stop:
    The trigger board is a FIXED-VOLTAGE SOURCE, not a charger. Its three DIP
    switches select from the standard PD ladder only -- 5/9/12/15/20 V -- and three
    switches also rules out PPS, which would need a button sequence or I2C. There is
    no 16.8 V step, which is what a 4S Li-ion pack wants, and 20 V straight onto this
    pack is 5.0 V per cell. So: set the trigger to 20 V and let the buck make 16.8 V,
    and find t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
    [TLS_Pie.kicad_sch]
2026-08-11 Context save: restart pointer reads clean for a cold start
    All blockers are closed; what remains is physical. The pointer now opens with
    that, lists the three jobs in order (charge at 16.8 V, find the weak group,
    check the VLP-16 input range before S2), and carries the two unresolved safety
    items -- the sensor's tolerance of 16.8 V, and S1's unconfirmed DC rating.
    Also fixes a table row that was missing its closing pipe, which would have
    swallowed the next row on render.
2026-08-11 Rev 3.2: fit the BMS and buck actually bought, and both changed the topology
    The Cricklewood BMS4S is COMMON PORT -- it has no C- pad -- so charge and
    discharge share P+/P-. Rev 3.1 was drawn against the separate-port board
    already fitted and gave the charger its own return node and its own rail.
    That rail is now deleted, not moved: the charge return IS the star point.
    Two consequences that are new, and neither is a wiring choice:
    * the charger hangs across +VBATT/GND in PARALLEL with every load, upstream
    of both switches -- so charge with S1 and S2 open, or the CC limit feeds
    the load and the CV stage never terminates cleanly;
    * the buck is not isolated, so the USB-C supply's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
    [TLS_Pie.kicad_sch]
2026-08-11 Bring the wiring document up to Rev 3.2 -- it is what you wire from
    WIRING_REV3_BMS.html still described a C- pad this board does not have, a
    3R3 series resistor that is now deleted, and tap names that do not match the
    silkscreen. That is the document with a soldering iron next to it, so leaving
    it a revision behind was the unsafe half of the change.
    Fig 1 redrawn: the charger now hangs on P+/P- with the loads, with junction
    dots, rather than branching off a C- pin that does not exist. Tap names
    follow the vendor ladder. Section 04 gains the two consequences of common
    port that are not wiring choices -- charge with S1 and S2 open, and the USB-C
    supply's ground is bonded to the whole rig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
2026-08-11 Charger set and verified: 16.8 V / 1.5 A -- and why the board looked broken
    The BCD5A's pots are multi-turn and ship at MAXIMUM, so a new board reads
    20 V in / 20 V out and a few turns of the trimmer changes nothing. It is not
    faulty: the set point starts at 36 V and you have to wind DOWN about forty
    turns to come below the input, ideally with a small dummy load, because at
    zero load there is no feedback to watch. The current pot at its
    counter-clockwise stop is minimum -- which presents as no current at all.
    That cost an evening, so it is now on the sheet, in the restart pointer and in
    memory rather than in anyone's head.
    Also recorded, because it is the next thing that will look like a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
    [TLS_Pie.kicad_sch]
2026-08-11 Pads verified against the board: this BMS names its taps by voltage
    The one assumption Rev 3.2 flagged as unverified is now settled by a photo of
    the board itself. It does not label its taps B1/B2/B3 -- it labels them by
    voltage, 0V / 4.2V / 8.4V / 12.6V / 16.8V, and its two output pads carry a
    circled minus and plus rather than P- and P+. The sheet now shows what is
    actually printed, because the silkscreen is what you read with a wire in your
    hand.
    Seven pads, five taps and two outputs, confirms common port with no C-.
    Two things worth having in writing, both of which will otherwise read as
    faults:
    * those voltages are FULL-CHARGE values. Metering the taps on a flat pack
    gives r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
    [TLS_Pie.kicad_sch]
2026-08-11 First per-group measurement: taps correct, and the old BMS is exonerated
    Taps against 0V on the flat pack: 2.98 / 6.10 / 9.18 / 12.25 V. Ascending and
    evenly spaced, so the five conductors are wired right. Differenced, the four
    groups are 2.98 / 3.12 / 3.08 / 3.07 V -- group 1 is the low one, 80 mV under
    the mean.
    Nothing is damaged. Every group is well above the ~2.5 V where Li-ion takes
    permanent harm; the pack is discharged, not degraded.
    This closes the mystery the whole investigation started from. Most 4S boards
    cut off at 2.8-3.0 V/cell and group 1 sits at 2.98 V -- right on that
    threshold. The old board latched because a group had genuinely reached its
    floor. It was never faul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
2026-08-11 Add the panel meter -- and it splits the ground, so draw it that way
    The Cricklewood DPM's thick pair IS its shunt, and on this class of meter the
    shunt is in the NEGATIVE leg. So it goes in the return, between the rig's
    ground and P- -- not in the +VBATT rail where U11 goes. GND and P- are now
    two nets joined ONLY through PM1, and they cross twice on the sheet with no
    junction dot. Bridge them anywhere and the shunt is shorted out: the meter
    reads 0.00 A for ever and nothing warns you, which is why there is now an
    assertion for exactly that.
    Supply comes from +VSW1, never +VBATT. These meters draw ~20 mA
    continuously; on the always-live rail that is ~0.5 Ah/day and would flatten
    this ~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
    [TLS_Pie.kicad_sch]
2026-08-11 Spell out why U11 and PM1 are not redundant
    They sit in different legs and answer to different masters. PM1 has its own
    display and works with no Pi and no software, but cannot log, warn or act, and
    being unidirectional it reads 0.00 A on charge. U11 produces numbers the
    SOFTWARE can act on, so they reach the phone panel and the rig's screen -- one
    UI on two displays -- and being bidirectional it sees charge current too.
    U11 is the one that prevents a repeat of the flat pack. This BMS cuts off at
    2.5 V/cell, which is a backstop and not an operating limit, so the software has
    to stop well above it -- and it can only do that if it can see the pack. Still
    never connected on this rig, and t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
    [TLS_Pie.kicad_sch]
2026-08-11 Why the motor keeps taking raw pack volts, and what to watch instead
    A stepper's "12 V" rating is I_rated x R_phase -- the volts you would need
    with no chopping. U4 is a current-chopping driver, so the supply sets how
    fast coil current rises, not how much; the current limit is what protects the
    motor, and 16.8 V is inside U4's 8-35 V.
    The real warning is not over-voltage, it is that the motor has only ever run
    on a flat pack. At 12.2 V the driver may never have reached its setpoint at
    speed; at 16.8 V it will. Expect more torque and a hotter motor on the first
    charged run with nothing adjusted -- check the temperature, run uncoupled from
    the head, and do not touch CUR ADJ PWR to compensa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
    [TLS_Pie.kicad_sch]
2026-08-11 Pad adjacency from the board photo: one neighbouring pair is a fire
    Right edge, top to bottom: 16.8V | (+) | (-) | 4.2V. The two adjacent pairs
    are not equally forgiving and the asymmetry is worth knowing with an iron in
    your hand.
    (+) beside 16.8V is harmless -- they are the same copper, because all ten FETs
    sit in the negative leg and the positive is never switched. Meters ~0 ohms,
    which also confirms the topology.
    (-) beside 4.2V is the worst short on the board. (-) is pack negative through
    the FETs and 4.2V is the top of group 1, so a stray strand is a dead short
    across three parallel cells with no fuse anywhere in that path.
    Confirms the drawing: seven pads, five taps named by vol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
    [TLS_Pie.kicad_sch]
2026-08-11 Positive-leg continuity is now measured, not inferred
    (+) to 16.8V reads 0 ohms on the board. That confirms the positive is never
    switched and that all ten FETs are in the negative leg -- which is what the
    whole star-point rule rests on, and it had been an inference until now.
    Marking the difference deliberately. This project has already lost a day to a
    written number that was never measured.
    [TLS_Pie.kicad_sch]
2026-08-11 Add D1: the charge chain was draining the pack backwards through its own LED
    Caught live rather than reasoned about. With the USB unplugged but the buck
    still wired to the BMS, the pack fed BACKWARDS through the buck -- out of the
    pack, through the inductor, through the switch's body diode to the input --
    and lit the buck's own indicator LED. The pack was going down while
    everything looked idle.
    A few mA is ~1.7 Ah a week on a ~9 Ah pack, and this pack has already been
    flattened once by exactly this class of fault, so this is not a rounding
    error. It is the same failure wearing a different component.
    Fix is an SS54 Schottky in the charge lead. A connector there would also work
    and cost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
    [TLS_Pie.kicad_sch]
2026-08-11 D1 is 1N5822, not SS54 -- I specified a surface-mount part for a hand-wired job
    Any Schottky of >=3 A and >=30 V does the job: 1N5822, SB540, SR360, MBR340.
    SS54 is DO-214AB, which is the wrong shape for this build entirely. Not a
    1N400x either -- silicon drops ~1 V instead of ~0.2 and the 17.0 V sum stops
    working.
    Also recorded: the free alternative is a connector or switch in the same lead,
    BETWEEN the buck and the pack. Unplugging the USB is what causes the
    back-feed, so the break has to be on the pack side. It costs no volts and can
    be forgotten, which is the whole argument for the diode.
    And this does not block tonight: the pack can be charged now by physically
    disconnecting the bu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
    [TLS_Pie.kicad_sch]
2026-08-11 S3 charge-isolate switch fitted; D1 drawn DNP until it arrives
    The switch solves the back-feed today and costs no volts, so the buck stays at
    the 16.8 V already set and verified. D1 stays on the sheet as not-fitted
    rather than being dropped, because the two are not interchangeable: a switch
    can be forgotten and a diode cannot. Keep both.
    The placement rule is the part worth not losing. S3 has to sit between the
    buck and the pack, never on the USB side -- unplugging the USB is what CAUSES
    the back-feed, so the break must be on the pack side of the buck.
    New assertion: S3 must actually BREAK the charge path. If its two sides ever
    end up one node it isolates nothing and the drain that fla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
    [TLS_Pie.kicad_sch]
2026-08-11 20SQ045 accepted for D1 -- overrating it helps rather than hurts
    20 A / 45 V is enormous for a 1.5 A charge path, and that is the point: run at
    7.5% of rating a Schottky's forward drop is LOWER, so it costs less charge
    voltage than the 3 A part I first suggested. It is also literally the solar
    blocking-diode part, doing the same job -- stopping a battery feeding back
    into its charger overnight.
    Reverse leakage is the one thing a big Schottky is worse at, and at a few
    tenths of a mA it is still far below the LED drain it replaces, and irrelevant
    once S3 is also in the path.
    Noted the practical catch: the leads are thick and may not fit whatever they
    are being landed in. No heatsink needed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
    [TLS_Pie.kicad_sch]
2026-08-11 Context save: charge path built, measured, and its back-feed fault fixed
    Restart pointer rewritten so a cold session reads the state rather than the
    history: what is done and measured, the four jobs left in order, and what is
    still open.
    Recorded this session, all of it measured rather than reasoned:
    * PD trigger on 20 V. The first DIP setting gave 15.15 V, which cannot
    charge this pack at all -- a buck only steps down, so it would have
    reached ~14.5 V and the balancer, which bleeds near 4.2 V/cell, would
    never have started.
    * BCD5A at 16.8 V / 1.5 A. Both pots ship at MAXIMUM and are multi-turn,
    so a new board reads 20 V in / 20 V out and looks broken.
    * BMS pads r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
    [TLS_Pie.kicad_sch]
2026-08-11 VLP-16 voltage settled from the datasheets: 16.8 V is inside its range
    This was the last electrical blocker and it is closed. Velodyne quote 9-32
    VDC with the interface box; the user manual carries a narrower 9-18 V. 16.8 V
    is inside BOTH, so the conservative reading still passes, and the pack cannot
    exceed 16.8 V anyway because the BMS cuts off at 4.2 V/cell. No regulator is
    needed on S2.
    Recording both figures rather than picking one. They disagree and the
    disagreement is probably sensor-alone versus with-the-box, but the decision
    does not turn on it -- so the honest record keeps both and notes that the
    narrower one still clears.
    Two things the hunt turned up that do matter and were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
    [TLS_Pie.kicad_sch]
2026-08-11 No separate E-stop: S1 is the stop, and the record now says so
    A deliberate call and a reasonable one for a 16.8 V ~50 W bench rig. The
    sheet had been calling S1 the E-stop, which it is not, and had been carrying a
    DC-arc warning out of proportion to 16.8 V into a mostly capacitive load.
    Both corrected rather than left to nag.
    Two things do follow from the decision and are now written down:
    * S1 becomes safety-relevant by POSITION. It has to be reachable without
    reaching over the moving head, and which way is OFF has to be obvious to
    someone who is not thinking clearly. A latched toggle gives none of the
    affordances a mushroom head does, so the mounting has to.
    * S1 does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
    [TLS_Pie.kicad_sch]
2026-08-11 Context save: every electrical blocker is closed
    The restart pointer now opens with the state rather than the history -- what
    is done and measured, the three jobs left, and what genuinely remains open.
    Closed today and not to be reopened:
    * the VLP-16 voltage question. 16.8 V is inside its range on both the
    figures Velodyne publish (9-32 VDC with the interface box on the spec
    sheet, 9-18 V in the user manual), so the conservative reading still
    clears and no regulator is needed on S2.
    * the E-stop question. Decided against; S1 is the stop. The sheet had
    been calling S1 an E-stop, which it never was, and carrying a DC-arc
    warning out of proportion to 16.8 V into a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
2026-08-11 System check with the USB stick fitted: the storage path is real now, and the lidar ping is a liar
    Full sweep of the Pi with the SanDisk stick connected. throttled=0x0, both
    services up, panel renders, stepper ENABLE reads 1 so the coils are off.
    The USB path was the part the record called "still unexercised on hardware".
    It is exercised now: mounts in 0.03 s, 113 MB/s, 123 GB free, target auto-flips
    to the stick, eject and re-mount both work. Two things worth writing down --
    the mount action is `check` not `mount`, and a stick reading "not mounted" at
    idle is correct rather than a fault, because choose_dumpdir() mounts at
    PREFLIGHT. The stick is FAT32 where the doc assumed exFAT; it works,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
2026-08-12 Make the journal survive a reboot, which is the only time anyone reads it
    journald was Storage=volatile, the stock Pi setting that keeps the log in RAM
    to spare the SD card. Every power cycle wiped it. That is backwards for this
    rig: brownouts, a flat pack mid-move and a dead scan are all investigated after
    a reboot, and get_throttled's "ever" bits only count since boot as well, so
    there was no undervoltage history anywhere. The card is 119 GB at 4% use and
    scans record to USB now, so the wear argument does not hold; the journal is
    capped at 100 MB regardless.
    The part worth writing down is that restarting journald is not enough and does
    not complain. Afterwards the config read persistent,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
2026-08-12 Boot sequence: drop the artwork, and stop showing the panel before the intro
    The reported sequence was artwork, white, control surface, video, control
    surface -- four changes of subject before the rig was usable. Now it is black,
    video, panel.
    The artwork and rain are gone at the operator's request; tlspie.script draws
    nothing. plymouth stays, because its real job is covering the getty login
    prompt between the kernel and cage, and that is not decoration.
    The control surface appearing before the video was the harder half. It has to
    paint early -- chromium defers painting an occluded window, so loading it late
    puts a white flash AFTER the intro, which is the fault that was fixed on the
    11th.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
    [test_splash.py, tls_web.py]
2026-08-12 Record a negative result: disable_fw_kms_setup=1 is load-bearing for this panel
    The band of static at power-up is not plymouth, cage or chromium -- it is there
    before any of them exist, which is why removing the splash artwork did nothing
    to it. It is the panel being fed uninitialised memory until vc4-kms-v3d loads.
    The obvious fix was to stop disabling firmware KMS setup, so the firmware would
    allocate and clear a framebuffer first. Tried it. The screen did not come on at
    all -- not the static, not the panel, nothing through the entire boot. SSH
    stayed up, which is the only reason this cost two minutes instead of a re-flash.
    Reverted from the backup and the panel came back as before.
    So t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
2026-08-12 Confirmed by eye: video= does not fix the power-up static either
    Operator power-cycled and the band is still there. Recording it as a verified
    negative rather than leaving the note ambiguous, because the line is staying in
    cmdline.txt and the next reader would otherwise assume it is doing something.
    Two config guesses are now spent, and the second could not have worked for a
    reason that was knowable beforehand: nothing on the kernel command line changes
    WHEN the display starts being driven. So the next step is a diagnostic, not a
    third edit -- whether the band appears instantly at switch-on (the panel's own
    memory, unreachable from the Pi) or about two seconds in as the kernel loads
    (an unc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
2026-08-12 Context save: boot sequence and system check closed, static band still open
    Brings the restart pointer up to date so a cold read lands on what is true. The
    old "awaiting the user's eyes on the next cold boot" paragraph described a
    sequence that no longer exists, and the summary table still claimed the 08-11
    splash and a 12.5 s boot.
    What a next session needs from the top: the boot sequence is black -> video ->
    panel and confirmed by the operator, boot is 6.36 s, the USB path is exercised
    on real hardware rather than theoretical, and the journal survives a reboot.
    The one open item is the power-up static band, and it is written as a
    diagnostic rather than a task, because two config guesses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
2026-08-12 The pack is good: four groups within 40 mV at full charge
    Charged and re-measured against B-: 4.15 / 8.33 / 12.52 / 16.68 V, so the
    four groups are 4.15 / 4.18 / 4.19 / 4.16. Spread 140 mV -> 40 mV against a
    50 mV pass threshold written before the charge.
    Group 1 -- the group that had reached its floor and latched the BMS -- came
    up with the rest, and group 4 is now within 10 mV of it, so the flat-pack
    ranking was the steep bottom of the discharge curve and nothing more.
    That closes the battery thread: the brownouts and mid-move reboots were a
    flat battery, and every rival explanation is now disproved by measurement.
    Also noted so it is not "fixed" later: 16.68 V against a 16.8 V setpoint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
2026-08-13 The symptom is gone: 72 s of motion on the pack, throttled=0x0
    First run of the assembled rig on the charged pack, puck mounted. Two
    continuous 360 deg legs at 10 deg/s, sampled at baseline, after each leg
    and at the end: throttled stayed 0x0 the whole way, not even bit 16, the
    latched "undervoltage happened at some point" flag. ARM held 1800 MHz.
    That closes the power thread at the level no bench measurement could
    reach. Yesterday's 40 mV spread said the pack should be fine; this says
    it is. The brownouts and mid-move reboots do not recur.
    The return leg ran for the first time in this project's life and the head
    came back on the mark, confirmed by eye. So STEPS_PER_REV = 160000 now
    holds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
2026-08-13 Lidar link up: puck streaming 753 pkt/s, no blockers left
    It was the cable. Link negotiated immediately on reconnection -- a new
    kernel event at t=11.49s, Link is Up 100Mbps/Full, eth0 carrier 1 at
    192.168.1.100/24, NetworkManager bound to the lidar profile.
    Verified the puck by decoding a packet rather than trusting a count:
    12/12 blocks carry the 0xEEFF flag, azimuths ascend 186.2 -> 190.6 deg
    across the packet (4.4 deg, right for 600 rpm), product ID 0x22 = VLP-16,
    return mode 0x37 = strongest. 753 data packets/s on :2368 and 138
    position packets/s on :8308, both from 192.168.1.201. tls_scan.py --check
    reports Preflight OK.
    That also settles the addressing question that had sat open and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
2026-08-13 FIRST FULL SCAN: 337,280 packets, 0 drops, cloud built
    360 deg Slow at 1 deg/s, on the battery, recording to the USB stick. It
    completed through every phase including the return leg, and built a cloud
    of 119,354 points in 7.8 s with registered: true. Position known
    afterwards, no re-home needed. throttled=0x0 across 14 samples over the
    whole six minutes of motion plus capture. Peak SoC temp 61.3 C.
    Zero kernel drops at 753 packets/s for six minutes is the number worth
    keeping: the capture path keeps up with the sensor, with margin, on a USB
    stick, while the motor is stepping.
    Every stage of this machine has now run together at least once.
    BUG FIXED TO GET THERE: tcpdump could not write to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
    [tls_scan.py]
2026-08-13 The rig is height-agnostic by construction; say so where it misleads
    The 1.5 m in tls_geometry.py's mount comments read like a configured
    instrument height. It is not, and never was: there is no height input
    anywhere in the pipeline. The world transform is a pan rotation plus
    LEVER_Z_M, and LEVER_Z_M is the optical centre's offset from the PAN
    AXIS -- how the puck is bolted to the head, not how high the tripod
    stands. The first scan's sidecar confirms it: lever_m [0,0,0], no height
    field.
    It cannot matter structurally either. Instrument height is a translation
    ALONG the pan axis, and a translation along the rotation axis commutes
    with the rotation, so it factors out of the whole sweep. Rais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
2026-08-13 MOUNT_ROLL_DEG = +90 confirmed on this rig, by tape and cloud
    The old argument for the sign -- "a ceiling 1.5 m above a driveway is not
    a thing" -- came from driveway.pcap, a different machine, and does not
    survive indoors where a floor below and a ceiling above are both real. It
    needed replacing rather than re-running.
    Replaced with two tape measurements on the bench scan: sensor 18 cm above
    the table, surface directly overhead 141 cm above the sensor. Against the
    built cloud, rendered at roll +90:
    surface overhead tape +1.41 m lidar +1.405 m
    table top tape -0.18 m lidar -0.193 m
    floor tape ~-1.05 m lidar -1.040 m
    Sharpest 6 cm slab anywhere in +/-3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
    [tls_geometry.py]
2026-08-13 The 1 cm residual is the enclosure datum, confirmed, and measurable
    Operator confirms the 18 cm was taped to the outside of the lidar
    enclosure, not to the optical centre, which sits inside the body where no
    tape reaches. So the disagreement was never error: it is the datum
    offset, and the lidar measures it. The optical centre sits about 1.3 cm
    above the enclosure face the tape was taken to, being 19.3 cm by lidar
    against 18.0 cm by tape.
    That inverts the usual relationship worth noting: the instrument is fine
    enough to calibrate the fixture around it. If the optical centre's
    position inside the enclosure is ever needed, measure it this way rather
    than reading it off a drawing. Differential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
    [tls_geometry.py]
2026-08-13 Drop the E-stop from the design entirely: S1 is the main power switch
    Operator's instruction, 2026-08-13: "forget about the e-stop completely,
    i have a main power switch." It had already been decided against on
    08-12, but the analysis behind that decision stayed written down in nine
    places across the record, the wiring procedure, the schematic and the
    source -- so every session read it as an open question and raised it
    again. This session raised it again. Removing the text is the fix; the
    agreement was never the problem.
    Cleared from:
    PROJECT_CONTEXT.md seven passages, plus the two derived to-do
    items (S1's mounting position, S1's DC rating)
    WIRING_REV3_BM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
    [TLS_Pie.kicad_sch]
2026-08-13 Viewer: fly through the cloud instead of stopping at a 0.6 m floor
    Reported as the camera stopping when it hits a point. It never touched
    the points -- nothing in the renderer tests geometry. The camera was a
    pure orbit rig with a hard floor on the radius:
    V.cam.dist = Math.max(0.6, Math.min(900, V.cam.dist*f));
    Zoom only shortened the leash to a target pinned at the centre of the
    cloud, so the eye could never pass through anything. The wall was simply
    whatever happened to sit near the pivot.
    Below the floor, zoom now pushes the TARGET forward instead of shrinking
    the radius. The eye follows, since eye = t + dir*dist, so the whole
    camera translates and you fly through the wall into th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
    [tls_web.py]
2026-08-13 Viewer: free-roam toggle, and pivot on the lidar instead of the bbox
    Two additions on top of the fly-through zoom, which is unchanged.
    FREE ROAM. The camera is stored as (yaw, pitch, dist, t) with
    eye = t + dir*dist, so rotating swings the EYE around a fixed target.
    That is right for inspecting a cloud from outside and wrong inside a
    room: every drag swings you around a pivot out in the geometry, which
    reads as the cloud being dragged about, and corners stay unreachable
    because you can only circle one, never look into it.
    Free roam keeps the eye fixed and rotates about it -- same maths,
    opposite fixed point. Recomputing t from the eye after the angles change
    leaves m4view, zoom and pan wor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
    [tls_web.py]
2026-08-13 Denser preview clouds, and a download button on every scan
    DENSITY. The preview was showing 119k points from a 337k-packet capture.
    The obvious lever, MAX_POINTS, turns out to be the wrong one: measured on
    TLS_26_08_13_02_05_15, six times the budget bought 2.2x the points
    (150k->119,354 ... 1.5M->267,191) because the 3 cm voxel grid saturates
    long before the budget does. Sweeping the voxel with the budget held high
    gave 3.0 cm -> 320k, 2.0 cm -> 702k, 1.5 cm -> 1.21M.
    Settled on 2 cm with a 900k budget. The real scan rebuilt from 119,354 to
    521,616 points, 3.65 MB, 32 s of background build.
    Recorded honestly in the comment: 2 cm is BELOW the VLP-16's +/-3 cm range
    accuracy, so some of the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
    [tls_cloudbuild.py, tls_scanstore.py, tls_web.py]
2026-08-13 Viewer: point-size and height-ramp sliders, plus a blocked-sensor flag
    POST-SCAN CHECK. A lens cover left on produces a scan that reports
    complete success at every level -- full 377 deg sweep, 186 MB captured,
    [COMPLETE] logged, cloud built, registered: true -- and worthless data.
    Nothing in the rig noticed. The scan list now flags it.
    The test is REACH, not point count, and the distinction is measured
    rather than assumed:
    returns/packet anything beyond 3 m
    uncovered 2% in 274 0
    uncovered 35% 291 67
    uncovered 70% 286 2765
    cover on 2% 28 0
    cover on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
2026-08-13 Solve the two-pass disagreement: the fan's zero was never measured
    MOUNT_PITCH_DEG was 0.0. It is 8.4. Surfaces go from 40.7 cm thick to 1.8 cm.
    On a sideways puck, Ry(pitch).Rx(90) adds pitch straight onto the sensor's own
    azimuth, so pitch is not a small misalignment -- it IS the fan's zero. The
    VLP-16's azimuth origin is set by its own body and was never aligned to
    vertical; the bracket holds it 8.4 degrees round from up. The 0.0 was a
    placeholder standing in for a measurement and was carried as though it were one.
    That is also why it surfaced as the two passes disagreeing. A full-circle fan
    covers azimuths pan+90 and pan-90 at once, so every direction is measured twice
    from opposite si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
    [test_cloud_registration.py, tls_geometry.py, tls_pitchcheck.py]
2026-08-13 Desktop converter: full-resolution captures to LAS/LAZ/PLY on Windows
    The scanner's own modules are already stdlib-only and already run on Windows --
    tls_pcap says so in its docstring. So this is not a rewrite; it is the
    workstation half that was always intended, plus the formats other software
    reads.
    The Pi builds a PREVIEW: 1 packet in 16, a 2 cm voxel, whole centimetres. A
    390 MB capture holds ~113 million returns. This decodes all of them with numpy,
    streamed in chunks so a cloud that would be 1.4 GB as float32 is never resident.
    ⛔ The rig's geometry is NOT duplicated here. rig.py imports tls_geometry from
    the scanner tree, because MOUNT_PITCH_DEG already spent this rig's whole life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
2026-08-13 Record the desktop converter, and the measurement trap found building it
    Adds the converter section to the restart pointer and the record, including the
    colourisation plan settled with the operator (swap the lidar for the X4 on the
    same tripod at the same optical-centre height, so occlusion vanishes rather than
    being corrected) and the note that the X4's IMU-levelled horizon is a free
    vertical reference -- which matters because the pitch calibration was
    differential, so a common tilt of the whole tripod is invisible to it.
2026-08-13 Stop decimating by default, and open a viewer when a conversion finishes
    The clouds were far sparser than the hardware can produce, and the cause was my
    default. --max-points does not cap the OUTPUT: it skips whole packets before
    anything is decoded, so the GUI's 5,000,000 read about one packet in
    twenty-four and threw away 96% of the capture before the voxel grid ever saw it.
    That is a Pi-era compromise -- the Pi cannot afford to decode everything -- and
    it had no business being the desktop default.
    Density now belongs to the voxel alone. Measured on TLS_26_08_13_02_05_15
    (390 MB, 59.3 M returns), reading every packet:
    none (--full) 59,343,707 pts ~1.5 GB
    5 mm 11,11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
2026-08-13 Colourise from a 360 photo, solving the camera's heading from the data
    Completes the colour half. Drop the equirectangular panorama beside the capture
    sharing its stem and the converter finds it, works out which way the camera was
    facing, and samples it. No upload, no SDK, no second radio.
    WHY THE GEOMETRY IS EASY HERE. The workflow is to swap the lidar for the camera
    on the same tripod at the same optical-centre height, so the camera occupies the
    point the lidar occupied -- and then anything the lidar could see, the camera
    could see. Occlusion does not get corrected, it does not arise. Parallax is not
    a problem either way, because the ray is taken from the CAMERA's centre to a
    point whose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
2026-08-14 Register two setups into one frame, and a workbench to check it by eye
    Adds tlsconvert/registration.py (a 3-DOF planar solve: two of translation and
    one of yaw), pipeline.merge, and tlsconvert/align.py -- a browser workbench that
    shows both scans tinted by origin, moves one by drag or slider, solves on a
    button, and clips into a box so you can see inside the room.
    Four things this cost, each caught by a test failing rather than by reading:
    - A ROTATION-ONLY SEARCH CANNOT SEE A TRANSLATION. Sweeping yaw across a
    genuinely moved pair gives a flat curve, and that flatness was read as the two
    scans being from the same position. It is evidence that the wrong parameter
    was being varied, no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
2026-08-14 Studio becomes an editor: grips, lasso, ortho, and an honest density
    The preview was showing about one percent of each capture and never said so.
    At the 2 cm default TLS_26_08_14_01_21_59 draws 1,040,435 of 91,709,044
    returns and 01_28_36 draws 923,743 of 45,507,670. Nothing was ever lost --
    export re-reads the captures at full density -- but a viewer that looks
    complete while showing a fiftieth of the data is the exact shape of quiet
    wrongness this project keeps meeting, so shown-of-captured is now on screen
    permanently and both preview and export detail are the operator's to choose.
    A lasso is stored as the screen polygon plus the camera that drew it, never
    as a world solid: a freehand ou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
2026-08-15 A clip box you can turn, a world-axes widget, and a rectangle marquee
    The scans come out in the sensor's frame and a tripod is never set down
    parallel to the room, so an axis-aligned box cuts diagonally across every
    wall and the operator ends up trimming a corner at a time. The box now
    carries yaw, tilt and roll: a green grip turns it, Square to view snaps it
    to the wall you are facing, and sliders do it by number.
    The bounds are held in the box's own frame measured from a world pivot,
    which is the part that is easy to get wrong. Held as world lo/hi instead,
    dragging the +X face of a turned box pushes the face along its own normal
    while sliding the centre along world x -- the box creeps sid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
2026-08-15 A camera mode that hands the window back, and lets go of itself
    One press (or C) gives the whole window to the view: no grips, no tools,
    nothing to catch a drag. Once the clip box is small enough to be useful its
    grips sit over the very points being inspected and every drag near one grabs
    the grip instead of the camera, and a live lasso takes the canvas outright.
    The part worth being careful about is that it lets go of itself. Choosing a
    tool, or Drag to move, turns camera mode off rather than being ignored by
    it. A mode that silently swallows the next button press is the failure this
    project keeps meeting -- a tool that does nothing reads as a tool that is
    broken, and there is nothing on s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
2026-08-15 Name the correspondences yourself when the solver will not converge
    Point-pair picking (P): click a feature on the reference cloud, the same
    feature on the moving one, three times, then Align from pairs. GICP only
    works from a start close enough that its nearest-neighbour guesses are
    mostly right, and two setups with little overlap -- or a corridor that
    looks the same from either end -- will not give it one.
    The guard is the whole point. Pick the top and bottom of one door frame
    and the picks share a position in plan, so turning the cloud about that
    position moves them not at all: a fit is still available, carrying no
    heading at all -- yaw 0, residual zero, every published sign of success.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
2026-08-15 Level the room against gravity by naming a surface you know is horizontal
    Press G, click three or more points on a floor or worktop, then Level to
    these. This closes a gap flagged in PROJECT_CONTEXT long before it had a
    tool: the clouds are in the RIG's frame, not gravity's. The pitch
    calibration was differential -- it measured the lasers against each other
    -- so a common tilt of the whole tripod is invisible to it, and a room
    scanned off a slightly out-of-level tripod comes out leaning by exactly
    that much with every internal check still passing.
    The degeneracy again, in a new shape. Three points along a line -- a
    skirting board, the edge of a step -- lie on infinitely many planes, a
    whole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
2026-08-15 A straight edge you can hold up to the room
    Press T. A plumb line, a level cross and a metre grid drawn through a
    point you click, as real geometry in the levelled world. Click a second
    point and it says by how far: "out of plumb 8 mm over 2.40 m -- 0.19
    deg", or out of level in mm over the run. Millimetres over the run is how
    a builder states it; the degrees are there too.
    It is only a plumb line if the room has been levelled, and that is the
    trap this whole pair of tools exists for. Unlevelled, world +Z is the
    RIG's vertical -- the reference would be perfectly consistent with a room
    that is leaning, and holding a wall up to it would confirm nothing except
    that the wall and the tripod agre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
2026-08-15 Save project did nothing, and the cause was a hyphen
    pywebview validates every file-filter string before it opens anything,
    against ^([\w ]+)\((\*(?:\.(?:\w+|\*))*...)\)$ -- word characters and
    spaces in the description and nothing else. So the entirely ordinary
    "TLS-Pie project (*.tlspie)" raised ValueError on the hyphen in our own
    product name. The captures filter, "Scanner captures (*.pcap)", has no
    hyphen, which is why Browse went on working and made the fault look like
    it belonged to projects.
    What made it silent is the part worth keeping. `except Exception:
    return ""` routed the crash into the one answer the page is built to
    ignore: "" means cancelled, and cancelled is deliberately th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
2026-08-15 The wheel button is the camera -- and it found a tool that was already dead
    Middle-button drag pans, shift + middle-button drag orbits, in Studio and in
    the single-scan viewer alike. Asked for by the operator; it is the Revit /
    Navisworks / Fusion binding.
    It is not a convenience. Every tool takes the left button, so with a lasso, a
    rectangle, a pair pick or a level pick switched on there was no way to orbit at
    all short of turning the tool off -- and getting round to the far side of the
    feature is most of the work of picking pairs. One button no tool may claim
    fixes that permanently, which is why the tool tests are gated on `left` rather
    than the middle button being filtered out afterwards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
2026-08-19 Specify the two components going onto the rig
    A gravity sensor for levelling, with a bubble display on the panel, and an
    integrated camera for colourisation. Neither is bought yet; both decisions turn
    on constraints particular to this rig, so the reasoning is recorded before the
    order rather than after.
    Gravity sensor: an inclinometer, not an IMU. The instrument is stationary and
    we want a static vector, so gyros and fusion buy nothing and the whole error
    budget is bias and temperature drift, which is where cheap IMUs are worst. A
    BNO055 is about a degree, worse than picking a floor by hand in Studio, which
    is the thing it would replace. SCL3300 first, ADXL355 second.
    The MPU6050's default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
2026-08-19 No leg guide: the mount head adjusts, so the bubble needs de-rotating
    The tripod head is fully adjustable, so leg-by-leg guidance goes and with it
    the one-time leg-marking setup. What replaces it is a constraint that falls
    out of mounting the sensor on the head: the adjustment knobs sit below the pan
    axis and do not rotate, so a bubble in raw sensor axes would spin as the head
    pans. De-rotate by the pan angle the stepper already knows.
    Also recorded: verify the bubble's sign physically, because an inverted one is
    not a broken tool but a tool issuing confident wrong instructions; and re-read
    after clamping, since an adjustable head can creep as it locks.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
2026-08-19 Add a 180 Rapid profile, and stop the pitch check answering without it
    The operator asked for the quick profile's rate over half the turn. That is a
    six-line dict entry; the rest of this commit is what those six lines cost
    elsewhere, and what makes the button honest.
    The 180 is not half a scan. The puck is on its side, so its fan is a full
    vertical circle and covers world azimuths pan+90 and pan-90 at once: 180
    degrees of pan already reaches every direction. This file has said so since the
    mount orientation was established. So rapid is a complete dome at single
    coverage, and what it gives up is the second look -- the redundancy that fills
    the shadows cast by the rig's own enclosures, becaus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
2026-08-19 Rebuild the scan buttons when the server's answer changes
    Deploying the 180 profile to the rig shipped a button nobody could press.
    /api/status served all three on every poll and the panel went on showing two.
    The page read `if(!built) buildScans(s)`, so the buttons were built once per
    page load and never again, and the kiosk's page predated the restart. Nothing
    threw, nothing looked wrong, and the API and the screen disagreed with only the
    screen being right -- which is the oldest standing rule on this project and the
    only reason it was caught, because the API is what I would otherwise have
    checked and it was reporting success.
    Worse in the field than on the bench. tls-kiosk gets a fresh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
    [test_scan_profiles.py, tls_web.py]
2026-08-20 Colour meets its first real photograph, and the gate moves 6.0 -> 5.0
    An Insta360 X4 equirectangular, 5888x2944, shot 11 minutes after a 360 Quick
    capture of a restaurant. The workflow colour.py was written for -- scan, swap
    the camera onto the tripod, shoot -- done for real for the first time.
    The pipeline works. The gate did not. The photograph scored 5.5 and was
    refused at 6.0, which is exactly what the comment in colour.py warned would
    happen: that threshold was calibrated against a panorama derived from the
    scan's own depth, so its edges WERE the geometry, while a photograph's edges
    also come from texture, paint and lighting.
    The instruction left there was to move it only if it reject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
2026-08-20 Studio opens exported clouds, and photos are added inside the program
    Three things asked for together, and they are one feature. What actually
    blocked colour was FILING: a camera writes IMG_20260820_102917_00_011.jpg, the
    pipeline looks for <capture stem>.jpg, and that rename is a manual step that
    gets forgotten -- and a forgotten rename presents as "colour does not work".
    Every scan in the legend now has an Add photo button. It gathers that scan's
    files into a folder named after the scan, COPIES the chosen image in beside
    them under the scan's stem, solves the camera's heading, repaints, and switches
    the view to the photo colours -- otherwise the work is invisible under the
    by-scan tint an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
2026-08-20 Drop the return leg, and correct the invariant I argued for that morning
    The operator's call. The return ran after capture had stopped, so it never
    touched the data; it only made them wait. On the 180 profile that was 27 s of a
    124 s scan, 22% of the wall clock spent walking back. The 360s save 3 s each,
    the 180 goes 2.07 -> 1.61 min.
    I had argued against this the same morning and I was wrong. The claim was that
    sweep minus return must be a whole number of turns, because otherwise "the head
    ends off its mark and the NEXT scan starts somewhere nobody recorded" -- and I
    wrote a test enforcing it. The code says otherwise.
    PanTrack.from_segments(..., start_deg=0.0) builds every sidecar's track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
    [test_scan_profiles.py, tls_scan.py]
2026-08-20 Record the stairs colour failure while it is parked, tilt ruled out
    Parked at the operator's instruction mid-diagnosis. Written down because the
    branches that were RULED OUT are worth more than the unfinished one, and
    re-walking them would cost an hour.
    TLS_26_08_20_15_01_37 with IMG_20260820_150439_00_017.jpg, an X4 equirect at
    11904 x 5952 shot three minutes after the scan, scores 2.35 against a gate of
    5.0 -- below even the 3.8-4.2 that pure noise scored on the morning's pair.
    Camera tilt is ruled out, which was the operator's first guess and mine. It was
    a real possibility: solve_yaw correlates over longitude only, so a camera
    rotated in pitch or roll moves every edge in latitude and n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
2026-08-20 Let the operator give the heading, and carry it to the next scan
    The stairs scan's refusal was the confidence failing, not the solve. The
    rig was standing against a wall, which puts a once-round-the-sphere term
    in both panoramas; the correlation peak came out 180 degrees wide instead
    of two and could not stand above its own shoulders. 2.01 against a gate
    of 5.0, on a heading that turned out to be right: coloured at +82.6 the
    mural comes back as a readable picture on the flat wall, and a half-turn
    puts the bar there instead.
    The gate could not be lowered to take it -- 2.01 is below what pure noise
    scores -- and removing the low harmonics was tried and refuted, lifting
    the wrong pairs as far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
    [test_scan_profiles.py, tls_scan.py]
2026-08-20 Remember where the head is standing, so a restart does not move zero
    The operator asked whether the Pi could be shut off. Checking what a
    power cycle would do to the carried-over camera heading turned up a hole
    in it: position_steps was set to 0 in the constructor and persisted
    nowhere, so every restart silently redefined zero to wherever the head
    happened to be. A baseline saved in one session and used in the next
    would have been out by the whole of the previous session's travel -- with
    the return leg gone, 190.8 degrees per Rapid. A plausible half-turn, on a
    cloud that looks fine.
    Pressing Restart before shutdown would have fixed it for nothing, and was
    rejected for the same reason the re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
    [test_stepper_watchdog.py, tls_stepper.py]
2026-08-20 Let a cloud be taken out, and a cut belong to one cloud
    Three things the operator asked for, and a dead button found under them.
    Remove takes a wrongly loaded cloud out of the session. Nothing is deleted
    on disk, and it takes two presses of the same button rather than confirm():
    an embedded WebView can suppress a dialog and return false, and a button
    that quietly does nothing is worse than one that asks twice. The other
    clouds keep the placement they had, even when the first one goes -- every
    setup, the clip box, the level and every cut live in that first scan's
    frame, and re-basing so the new first reads as identity would slide the
    whole job sideways under a box that would not move with it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
2026-08-20 Grade the photo alignment instead of refusing it, and give it controls
    A confidence of 4.6 was refused, which left nothing on screen to judge --
    and the operator already knew the photograph was right. The single gate was
    doing two jobs that pull apart: keeping out an unrelated image, and saying
    how far to trust a plausible one. colour.py's own measurements make the
    second impossible. A real photograph scored 5.5 and the best wrong answer,
    that same photograph downsampled 64x until unrecognisable, scored 4.59, on
    a number that moves by 0.44 with the sample alone.
    So the score grades rather than vetoes: quiet at or above 5.0, amber and
    "unsure" at or above 4.0 -- exactly the band the old gate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
2026-08-20 Ask a second, independent method before believing a photograph
    The confidence could never decide which photograph belongs to a scan, and
    measuring it on 57 photographs from one shoot showed how badly: the edge
    correlation ranked the KNOWN correct one second, behind an image shot two
    and a half hours later at another table, 7.46 against 7.02. No threshold
    and no ranking picks the right one out of that.
    So there is a second method that shares nothing with the first but the
    cloud. The edge solve matches depth silhouettes against image gradients;
    this one matches lidar reflectivity against image brightness through mutual
    information, which is the right measure precisely because the two need not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
2026-08-20 Tell the cloud which way is north
    Level answers "where is down", and says in its own docstring that it
    deliberately does not reassign X because yaw already means something here.
    So nothing had ever answered "where is north": a cloud came out correctly
    levelled and pointing an arbitrary way, which is fine for measuring a room
    and useless the moment it has to sit beside anything surveyed.
    Sight two points along something whose bearing you know -- a wall, a kerb,
    a corridor -- and press the direction that line runs. That is a measurement
    an operator can actually make on site, unlike turning the cloud until it
    looks right.
    The heading lives on Level rather than in a class of its own because it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
2026-08-21 Carry the alignment to the file, and let it be improved
    The export re-solved every heading from scratch: save() passed no colour
    pose, so convert() called find_photo() and started again. Every nudge, the
    half-turn, the candidate picked off the shortlist, the camera height and the
    heading typed in by hand reached the screen and none reached the file -- and
    a hand-set heading exported grey, because prepare_colour still refuses a low
    confidence and that control exists precisely because a correct pair scored
    2.01. open_project had the same hole from the other side.
    A photograph has three angles, not one. Measured 2.44 degrees of pitch on
    the confirmed pair; taking it out raised the fit from 0.2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
2026-08-21 Hide a cloud to work behind it, and load at full detail
    A show-one control already existed and it changed the picture and nothing
    else: a lasso drawn while one scan was isolated still cut through every
    cloud. So the one gesture an operator makes when clouds overlap -- hide the
    front one, cut the back one -- silently deleted points from the cloud they
    had just taken off the screen, in a program whose whole safety story is
    that you look at what you are about to remove.
    Each scan now has its own Hide, a hidden cloud is not drawn, not pickable
    and NOT taken from by new cuts, and a standing line says what is hidden
    because "where has my cloud gone" is the failure mode of any hide. Hiding
    does no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
2026-08-21 Close the live job: the restaurant shoot is sorted
    The restart pointer still told the next session to open Studio and re-attach
    the restaurant photographs by hand. That job is done -- the operator ran the
    new Sort a shoot instead, and the result is on disk. What replaced it is
    checking the pairing by geometry, since the sorter pairs on time and time is
    only a proposal.
2026-08-21 Search the whole circle for a photograph's pose, and use the card for it
    Deep align: sweep all 360 headings and judge with three unrelated measures
    -- depth silhouettes, mutual information on lidar reflectivity (Pandey et
    al. 2012, now on every axis rather than one), and where the hardest returns
    land. Verified through the server on the one pair whose answer is known:
    forced 130 degrees wrong, back to 0.017 of the truth in nine seconds, and
    reported as a DIFFERENT answer rather than a refinement -- which is the
    shape a mis-paired photograph takes.
    Two bugs that only a known answer could find. _profile_peaks was half a
    turn out, and nothing looked wrong because the incumbent seed has a free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
2026-08-21 Take the shortcut caption off the workspace, and let the trays be moved
    Reported as "I can't change the point size". The shortcut ledger was fixed
    to the bottom-left with no width and no pointer-events:none, at the panel's
    own z-index and after it in the document -- so forty items separated by
    middots wrapped clear across the window, painted over the panel's lower
    half, and swallowed every click that landed there. The point-size slider is
    the last control in the last tray, which is the lowest thing on the panel,
    which is the thing most reliably covered.
    The other two fixed overlays got this right and that is the tell: #hud and
    #ov both carry pointer-events:none, because both are drawn over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
2026-08-21 The turn ring was a mode nobody chose: make it a widget you can put away
    "When a new scan comes in there is a rotate widget that is stuck in that
    function." ringOf returned a ring for whichever scan was ACTIVE,
    unconditionally -- so importing a scan made it active and raised a rotation
    ring around it, with no control anywhere to dismiss it. At 16% of the wider
    floor span it crossed most of the screen, and a press within ten pixels of
    a ring starts a rotation, so an ordinary orbit drag near a newly imported
    cloud turned the cloud instead of the view.
    It is off until asked for now, with a Turn ring button beside Drag to move,
    and pressing it again takes it away. Every widget now reads the sam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
2026-08-21 Real controls for placing a scan, and two faults in the sliders
    A Move gizmo -- three arms through the tripod, dragged to slide the scan
    along one axis at a time -- plus a button each way and a box to type into
    for all four axes, driven by a typed "move by" and "turn by". The sliders
    stay: they are the right control for a coarse sweep, but they were never
    the right one for 14.37 m and until now there was nothing else.
    The arms point along the axes the SLIDERS move, which is not the world's. A
    Setup is applied before the levelling rotation, so once a room is levelled
    "east" in a setup is a few degrees off east in the world -- and drawing
    world axes while writing into a setup would slide the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
2026-08-21 Make Ctrl-Z universal, found by a function that reversed nothing
    undoBox() was defined and never called, anywhere in the file. The whole
    clip box -- six face sliders, three turn sliders, two grips, Fit to view,
    Square to view, Square to world -- sat outside the undo stack while the
    function written to reverse it had no caller. A dead undo is a strong
    signal: somebody meant to and did not, and nothing failed to say so.
    The audit it prompted found three more. Reset wiped a scan's whole
    placement, from the most destructive button in the tray, sitting
    immediately beside the controls the placement was made with. Solve the
    whole shoot -- the largest single action in the program, refitting one
    cam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
2026-08-21 Tilt a scan, and three controls that did nothing
    A cloud could only ever be turned about the vertical, because a
    registration.Setup holds a yaw and a shift and nothing else. Rings for
    tip and bank would have been two rotations the exporter had nowhere to
    put, so the storage came first: registration.Lean, applied in the scan's
    own frame BEFORE the placement, carried through convert and merge, and
    held apart from the Setup so that the next Auto-align cannot quietly eat
    a correction that could only be made by eye.
    A placement now crosses the wire as one dict with six numbers in it, and
    Setup.from_dict takes four of them while Lean.from_dict takes two, out
    of the same dict, neither knowing the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
2026-08-21 Build the CUDA engine
    The packaged programs were CPU-only by design. They are not any more:
    build_cuda_engine.py writes a cuda-engine folder that sits beside the
    executables, and gpu.py finds it, opens its libraries and mounts it
    before anything asks for CuPy. Without a folder, or without a card,
    everything behaves exactly as before.
    A folder rather than part of the program, because these are --onefile
    builds: bundled, CuPy measured 1,032 MB per executable, and a one-file
    build unpacks itself into a temporary directory at every launch. The
    operator would have waited through a gigabyte of copying to open a
    capture, on a laptop that may have no NVIDIA card at all.
    What goes in it was measure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
2026-08-21 The camera's seat, and a fine judge to find it with
    "The current solution is not accurate enough" for colouring the cloud
    from the photograph. The biggest of the three ceilings was a missing
    degree of freedom: the pose model had five of the camera's six numbers
    -- heading, tip, bank, height, and nothing for where the optical centre
    sits sideways of the lidar's axis, on a camera that is remounted by
    hand. That offset is parallax: near furniture is painted from a point
    the rays never left, smeared by atan(offset/range), and no rotation can
    express it, because turning the photograph moves the error round the
    room instead of removing it. It is camera_x and camera_y on the scan
    now, stored, saved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
2026-08-22 Measure reported the extents and also chose which cloud moves
    Reported as "a glitch with auto clean up points -- when pressed it moves
    all the scans around out of registration or any movements i made to make
    them line up."
    The clean never touched a placement. Proved on the operator's own capture
    (23,464,814 returns, RESTAURANT SCAN\1): a hand placement with a lean
    survived a Remove strays that hid 4,004 points, identical to the last
    decimal, and identical again in the metadata the page rebuilds from.
    It moved the AIM. measure() ended with `V.active = <the last scan>`,
    unconditional -- and measure() runs after EVERY rebuild. So Remove strays,
    attaching a photograph, re-colouring and re-solv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
2026-08-23 Never worse than yours was true of every step and false of the journey
    "Auto align scan is being less successful even when i get the scans really
    close to one another."
    Measured before it was touched. Sixteen consecutive pairs of the restaurant
    walk, each handed the solver its own answer moved 5.8 cm and 1.0 degree -- a
    person's idea of "really close". Twelve pulled straight back to the answer
    and improved on the placement. Four returned the placement untouched. And
    one, folder 21 onto folder 20, came back WORSE: a placement priced 0.2048 m
    replaced by an answer priced 0.2133 m, on this program's own metric, at its
    own final scale.
    `solve_gicp` carries the guard -- "an alignment the op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
2026-08-23 The live project: folder 10 was out, and one press would have missed it
    Looked at the last two scans of main project.02.tlspie. Folder 9 is already
    right -- 86.1% of it lands within 10 cm of folder 8 -- and Auto-align
    correctly declines to move it. Folder 10 is out: 16.9% within 10 cm, and one
    press takes it to 90.0%, nn RMS 0.206 -> 0.082 m. The correction is 0.31 m,
    +3.78 degrees, and a tilt going from -3.72 to -0.91 degrees, which is about
    half a metre at the far side of a ten-metre room.
    But the press only works if it is aimed correctly, and the program would not
    have aimed it that way. `nearest_to` picks by distance between TRIPODS: that
    is folder 8 at 1.97 m, sharing 12.6%. The s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
2026-08-23 The judge went blind with distance from the reference
    "Auto align is even worse than it was before ... the current solver moves the
    scan to a completely different space." Reproduced on the operator's own
    project, scans 11 and 12, and it was not the solver -- it was the judge.
    Every score in registration.py is a panorama, and a panorama has a CENTRE.
    The pair was solved with both clouds placed in the merged frame, which anchors
    that centre at the REFERENCE tripod -- right where the first pairs stood, and
    ten metres from where the operator was working by scan 11. Measured there:
    the fixed cloud's profile had 0.8% of bins finite against 57% in its own
    frame. From the origin a far room is a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
2026-08-23 Close the day: what is verified, what is queued, and one dead end
    The restart pointer was missing three things that existed only in the
    conversation.
    The exe line still described the 13:45 build, which predates the frame fix.
    It now names the 17:24 one and says the thing that is invisible on screen: a
    Studio left running from before it is the old program.
    The cleaning theory is recorded as the dead end it turned out to be. The
    stray rule takes 0.0-0.3% of the solver's cloud and the answers are identical
    to four decimals, and the reason is worth more than the result: the rule is
    calibrated on the voxel-accumulated preview, where an isolated cell stands
    out, and the sample is a uniform stri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
2026-08-23 Fit a scan to every neighbour at once, and put the whole gizmo on one button
    Aligning a walk pair by pair builds a chain: scan 12 is placed against 11,
    which was placed against 10, and each link carries its predecessor's error
    forward. "Fit to its neighbours" asks the question the operator actually has
    -- does this sit right in the room I have already built -- and the neighbours
    constrain each other.
    The union of the neighbours is what GICP fits to, because more surface is the
    whole point and small_gicp is a KD-tree with no opinion about panoramas. The
    SCORE never sees that union. registration.Judge keeps one profile per capture
    position, in that position's own frame, and combines them; mer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
2026-08-23 Give the world a zero, a grid to see it against, and a floor to stand on
    Level answered two of the three questions about the world and nobody had
    noticed the third. The tilt says where down is; the heading says where north
    is; nothing said where ZERO is, so every cloud this program has written came
    out correctly levelled, correctly oriented, and measured from wherever the
    first tripod happened to be standing.
    Level now carries an origin, for the reason its own docstring gives for
    carrying the heading: same breath, same frame, same apply, and a separate
    object would be a third thing to forget to pass. Held in the RAW frame and
    rotated on use, like the pivot and like every other pick here --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
2026-08-24 A path the program invented is not a path the operator chose
    The Save as... work shipped in the 10:49 build and did not fix anything,
    because OUTPATH was seeded `OUT || ''` and tlspie_studio.py ALWAYS computes a
    fallback path. So the "ask when nowhere is chosen" branch could never be
    reached: Export went on writing silently to ~/tlspie_merged.laz with a Save
    as... button sitting right there unused.
    The evidence is exact. Studio was started at 11:12, after that build, and at
    11:41 it wrote a 377 MB file to the home folder -- the operator pressed Export
    again and lost the file again, and came back and asked the same question a
    second time. That second asking is the only reason this was caught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
2026-08-24 Close the day's record: the export thread, and the one thing still blocked
    The restart pointer now opens with the blocker rather than burying it: the exe
    is one build behind, build_exe.py fails WinError 5 because the running Studio
    holds it, and the 10:49 build does NOT contain the Save-as fix -- so Export in
    the operator's running copy still writes to the home folder without asking.
    Do not kill those processes; there may be alignment work in them.
    Also recorded: SketchUp is settled (they have Scan Essentials, so .laz is
    already right and adding E57 or PTS would be wasted work, the same shape as
    the 3ds Max .rcp finding), the delivered 19-cloud file and its numbers, and
    the far-field measur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
2026-08-24 Open on the ground plane, and give the move controls a door
    Three requests, and the middle one was not a bug in the code at all.
    "Bring back the move cloud button": nothing had been removed. `git log -S`
    over the whole history shows `id="grab"` added once, in 79a4e34, and never
    touched. Drag to move, the gizmo and all twelve typed controls live in the
    `move` tray -- which was not in the set opened on a fresh install, and with
    it shut there is no way to move a cloud at all. Third time in two days that
    a working feature with no door read as a removed one. The default set now
    includes it, and a one-time reopen (flagged `moveback`, written immediately
    so it fires once) reaches the operators who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
2026-08-24 The exes are current again: rebuilt from a3aa6b3, selftest 0
    And record how to check that, since the last attempt got it wrong: mtime and
    --selftest, never grep on the exe. PyInstaller stores modules as compressed
    bytecode, so grep finds neither the new strings nor ones that have been in
    the program for weeks.
2026-08-24 Put the floor ON the grid, not merely parallel to it
    Reported from a new project: load the first scan and the ground does not
    meet the world grid. It never had. Levelling answered "which way is down"
    and stopped there, and since a capture's zero is the INSTRUMENT and the
    instrument stands on a tripod, the ground sat about 1.4 m UNDER the grid,
    which then cut through the room at chest height. Every part of "use the
    ground surface points and level it to world grid" was built except the last
    step -- and the tray said "nothing was moved", so nothing looked wrong.
    `level_from_floor` now names the floor as the height datum when no origin
    has been set. The pivot is already a measured point ON the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
2026-08-25 The scan comes to the grid, and stands on the floor when it gets there
    "I want the scan to straighten to the world grid, not the world grid to
    the scan", then "scans land in the centre of the grid; I'd like them to
    load onto the grid but on the scanned floor". Two halves of one thing: a
    capture's zero is the INSTRUMENT, so a freshly loaded cloud arrives leaning
    by its own tripod's error with its TRIPOD on the ground plane and the floor
    a tripod's height underneath -- the grid through the room at chest height.
    Each capture is now stood up on its own floor as it arrives: the tip and
    bank that its tripod was out by, and the height it stood above the ground.
    That is the instrument's compensator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
2026-08-25 The heading ring turned the picture and never sent it
    "Move image controls not working." They were not. `tiltRelease` read
    `V.tiltAxis` to decide what to send, and the pointer-up handler cleared that
    flag ON THE SAME LINE, before the call:
    if(tilting!==null){ tilting=null; V.tiltAxis=null; tiltRelease(); }
    so the yaw branch could never be taken and every ring drag ended by sending
    tip and bank. Tip and bank worked by luck. The heading ring turned the
    picture on screen and then re-coloured at the OLD heading, so it sprang
    back. The release is now TOLD which axis it is finishing: a handler that
    reads mutable state a tear-down line can clear is one whose correctness
    depends on statements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
2026-08-25 Give the photograph's gizmo a button in the photograph's own panel
    "Scan photograph panel has no gizmo controls. I need the gizmo to appear
    after I press a button." Every part of it existed and the only way in was a
    `mini` button called "rings" inside the SCAN LIST -- a different panel from
    the one an operator is looking at while working on a picture, and small
    enough to read as a label rather than a control. Fourth built-and-
    unreachable control this week, after the export, the scan gizmo and the
    folder badge.
    The photograph tray now opens with a Gizmo button and the two halves it is
    made of: Rings, which aim the picture, and Camera arms, which move the
    camera's own centre. The blurb says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
2026-08-25 The photograph meets a LEVEL cloud: solve and paint after the lean
    The Insta360 levels its own stitch from its IMU; the lidar has no tilt
    sensor. Every solve and every paint ran in the RAW frame, on a comment
    whose justifying sentence named the wrong sensor - "the colouriser has
    to see the points where the sensor saw them" is true of the lidar and
    false of the camera, and the camera is the sensor whose picture is
    being sampled.
    - colour_scan, refine, deep, prepare_colour and convert's emit all move
    to the levelled frame: lean first, colour second, placement third.
    - On import the walk-time colouriser is deleted: load goes decode ->
    stand_up (extracted from level_scan, shared) -> colour_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
2026-08-25 Record the rebuild: exes current at 22:37, selftest 0
2026-08-25 The first paint knows where the camera sits
    "The image is too low, needs to go up" - uniform lowness is a
    signature: the rig mounts the 360 camera above the lidar and the clamp
    leans it, yet the first paint assumed height zero and tilt zero on
    every scan, low by atan(height/range) plus the mounting pitch. The
    only way up was knowing to press Auto-align three times.
    Measured first on folder 1: the ladder finds +6 cm and +2.45 deg and
    lifts the fit 0.288 -> 0.318 in 4 seconds. The attach now climbs the
    whole refinement ladder itself - colour_scan's solve path and
    prepare_colour's CLI self-solve - on the ladder's own rules: it cannot
    make the solved heading worse, the grade stays the global sw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
2026-08-25 Record the rebuild: exes current at 00:49, selftest 0
    Also record the failure mode that delayed it: a rebuild with Studio
    open dies on [WinError 5] - the running exe locks its own file.
2026-08-26 The camera height is seeded, not slid to
    "The image needs to go up a bit still" - said after the auto-climb
    shipped - was a measurement: the ladder's height answer (+3.8 cm) sat
    in the wrong basin. Height and pitch trade against each other (both
    lift the picture in front, separating only through near-surface
    parallax), so a tilt fitted at height zero and a height fitted at that
    tilt settle into whichever basin the start was in. Measured on folder
    1: the ladder sat at z +4 cm scoring 0.324; the true optimum is
    z +16.7 cm / pitch +4.83 deg scoring 0.330 - a believable bracket
    height, in exactly the direction the operator's eye called twice.
    colour.climb_pose is now the one home for the automa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
2026-08-26 Record the rebuild: exes current at 01:10, selftest 0
2026-08-26 Give the ladder the intensity eye, and the fine grid the last word
    The operator asked whether the solver could match the cloud's intensity
    map against the image. It could half-way: the heading sweep and the deep
    search already carried Pandey-style reflectivity MI, but the automatic
    refinement ladder judged with depth silhouettes alone -- and the survey
    (koide3's direct_visual_lidar_calibration, OmniColor) says pixel-level
    intensity registration IS the fine stage of the state of the art.
    colour.ladder_objective: the ladder's two-eyed judge -- edges plus
    reflectivity MI, standardised once against a 72-bin reference sweep,
    beacon out, and the vote EARNED: it stands down to edges alone unless
    t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
2026-08-26 Record the rebuild: exes current at 03:35, selftest 0
2026-08-26 The photograph follows the frame it was solved in
    Scan 3, diagnosed by the operator in one sentence: the solver colorises
    the incorrectly tilted cloud before it gets correctly levelled. Right,
    twice over. The arrival path does level first -- but folder 3's floor
    fit is 2 degrees of roll wrong (rms 4.3 cm, the "floor" a 24 cm-thick
    band, stable across halves: bias, not noise), and two independent
    witnesses agree on the truth: registration against folder 1 gives
    pitch 2.32 / roll 0.00, and the photograph re-solved in that frame puts
    the camera tilt at 2.27 / 0.45 -- folder 1's bolted mounting residual
    (2.52 / 0.62) reproduced. A bolted camera is a per-scan gravity
    witness: the mounting number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
2026-08-26 Record the rebuild: exes current at 20:43, selftest 0
2026-08-26 The clip box no longer owns the left button: its grips wait for Ctrl
    "Camera movements change when I activate the clipping box" -- the camera
    math never consulted the box; the POINTER ROUTING did. Any drag beginning
    within 15 px of one of the seven grips (six faces + the turn knob) went to
    the box, and a box fitted to the room puts those grips exactly where an
    orbit begins. A bare drag is now always the camera, whatever is switched
    on; ctrl-drag is how you say "I mean the box". The hover highlight lights
    only while Ctrl is down, so it stays a promise about the next click, and
    the tray blurb, the keys help and the Box shown message all teach the
    gesture. Scan gizmos untouched -- they appear o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
2026-08-27 The stitch lift: the operator's eye was right and both judges were biased
    "Still does not solve correctly, needs to be up a bit and to the left" --
    measured instead of asked, and the eye was confirmed by instrument: the
    camera stitches its panorama horizon 0.6-1.1 degrees BELOW the image's
    middle row (folder 1 ~0.8, folder 3 ~0.58 -- systematic, not per-shot).
    A uniform latitude offset is OUTSIDE THE POSE SPAN -- pitch raises the
    front but lowers the back, height moves near things more than far -- so
    every climb could only smear it into pitch/height compromises, which is
    what three weeks of "the image is too low" was. Worse, the global judges
    are biased on exactly this axis: the edge cosine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
2026-08-27 The crash leaves a trail: GL recovery, one log file, and a zombie guard
    "Drag to move crashed the program" -- and nothing anywhere said why. The
    forensics: no WER report, no event-log entry, no log of any kind, but two
    Studio processes still alive from 07:57 (the child at 1.9 GB) with ZERO
    WebView2 processes, and the profile's Crashpad watson_metadata touched at
    08:07:59. The WebView2 renderer crashed mid-drag, the window vanished
    wordlessly -- a windowed build has no console -- and desktop.show() never
    returned, leaving a headless server holding gigabytes. The drag path
    itself is pure client (a uModel uniform per frame; nudge never calls the
    server), so the crash was the renderer's. Three d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
2026-08-27 The full code check: five verified bug clusters from six finders, fixed
    The operator asked for a full code check; six review agents swept the
    package from independent angles and the verified findings are fixed:
    1. A yaw-only drift correction was measured, folded, and thrown away.
    settle_drift set moved = bool(up_px) and both callers gate the whole
    pose update on moved, so a photograph whose content sat right-of-true
    but not low kept its wrong heading -- half of the operator complaint
    the stitch lift exists for. A folded yaw now counts as movement.
    (Found independently by two finders.)
    2. A replacement photograph inherited the old photo's lift forever: the
    door applied the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
2026-08-27 Align on import fits each arrival to the room, not only to the previous scan
    Reported by the operator: "align scan on import aligns to only the previous
    scan". True by construction -- the import loop ran one pair fit per arrival
    against its nearest scan, so a walk of imports built a chain, every link
    carrying its predecessor's error forward, while the room-wide fit sat one
    button away and was never consulted.
    The loop now follows each pair fit with the same solve/multi the "Fit to
    its neighbours" button runs: pair first, because the room fit cannot start
    from an unplaced cloud, then the refit onto every placed capture within
    reach, with the pair answer as the start and the leans on the wire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
2026-08-27 The rush twin: fewer points while the hand moves, every point at rest
    "Rotating and moving the cloud is really sluggish" -- reported the day
    align-on-import made it easy to open a whole walk at once, which is the
    tell: rotation redraws every point of every scan each frame, so the
    camera's feel degrades with project size. The standard answer, not an
    invention: CloudCompare ships it as "decimate clouds over N points when
    moved", Potree's octree LOD is the same idea with more machinery.
    Every scan over 500k points gets a strided twin capped at 250k, built once
    at load (and again on context recovery, carrying the cuts -- upload()
    refreshes the twin's live mask or a delete would flicker back mid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
2026-08-27 No frame draws the whole project: progressive refinement, incremental cuts
    The studio log answered the "still sluggish" report with two facts: the
    window is drawn by the AMD INTEGRATED chip (Windows gives WebView2 the
    power-saving GPU; the RTX sits idle), and there are 46,501,002 points on
    screen. "Works for one bit of a turn, then hangs" was the full-detail
    redraw on release: one 46M-point frame that the next grab had to wait
    behind.
    So the full cloud is never drawn in one go again. Scene frames draw the
    rush twins and QUEUE the real chunks; idle frames refine one chunk each
    into the preserved drawing buffer (identical points, identical pixels,
    identical depth -- seamless sharpening); a ne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
2026-08-27 Aim an unplaced scan by the walk, and stop the twin punching holes in walls
    Two operator reports, one root each, both measured on the live job before
    anything was changed.
    "Auto align is not working when the scans are close." An unplaced scan sits
    at the ORIGIN -- and so does the reference, which therefore won the tripod
    tie by 0.00 m every single time. So the FIRST press on every scan, the one
    press that has to work, fitted it to scan 1: exactly the failure nearest_to
    was written to prevent, arriving through nearest_to. Folder 13 of the live
    job stands 0.72 m from folder 12 and ten metres from the reference. Onto the
    reference: residual 0.383 m, not trustworthy, ambiguous. Onto folder 12: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
2026-08-28 The twin stops leaving rims, and the view opens the way it is worked in
    "I can see the quick LOD points, they don't disappear when the full cloud
    snaps back" -- introduced by yesterday's own growth fix. A GROWN twin point
    cannot be painted out by the real point it stands for: the real one is
    drawn at the ordinary size INSIDE it and leaves the fat rim standing. At
    equal size the two are the same point -- same place, colour and depth -- so
    one paints out the other exactly. The twin is therefore grown only while
    the hand is moving, where nothing refines on top and the whole frame is
    uniformly grown, so the coverage is free.
    Three defaults the operator asked for: a job opens on the smallest poi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
2026-08-28 Code check, first pass: an export cannot destroy the last one, and a wrong photograph stops passing as a good one
    Six reviewers swept the package. Fixed here, worst first.
    DATA LOSS. Both writers opened the operator's chosen path outright, which
    truncates it before a single point exists -- so a decode that threw on
    capture 9 of 15 had already destroyed the previous good export AND left one
    that reads as COMPLETE, because close() patches the PLY header with the
    count written so far and the truncation check only fires when the header
    promises more than the body holds. Re-exporting to the same name after a
    small edit is the ordinary case, and this is a surveyor's only copy. Both
    writers now wo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
2026-08-28 Refine the rivals and size the seeds to the reach: 2 of 7 blind fits become 3
    The solver reviewer explained the fourteenth pass's measurement, and one of
    its findings confirmed an experiment already run: lifting refine_refused
    changed nothing because solve_multi always passes a start, so solve_ladder
    takes the +/-10 degree NEAR fan and a 178 degree flip is not reachable by
    any of its five seeds. The guard was downstream of a fan that cannot
    produce the answer.
    Two defects fixed, both measured on the operator's own restaurant against
    the placements they accepted.
    THE RIVAL WAS NEVER REFINED, ONLY RE-PRICED. The fan's winner descended
    three further GICP rungs while the runner-up kept its coa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
2026-08-28 Give the placement sliders the twin they were never wired to
    The rush twin was wired to the CANVAS drag. The six sliders in "Move a scan"
    turn and slide a whole cloud on every `input` event and had none of it, so a
    drag of the Turn slider queued every full-detail chunk on every one of the
    hundred-odd events a drag fires: the view spent the gesture alternating a
    cheap scene frame with a four-million-point refinement frame. That is
    "rotate is broken again, it hangs" -- the same complaint the twin was built
    to answer, arriving through the one control the twin had never been wired to.
    `V.rush` now has ONE owner and the holders are NAMED. It used to be set and
    cleared from two places that knew n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
2026-08-28 Give the blind search a PLACE, not just a heading: 2 of 9 -> 5 of 9
    Every blind seed started the moving capture standing on the REFERENCE'S OWN
    TRIPOD. The fan varies a heading; its translation is zero, and the coarse rung
    reaches 1.5 m. From the operator's own saved placements, consecutive tripods on
    that walk stand a MEDIAN 2.6 m apart -- 0.72 m at the closest, 7.29 m at the
    widest. The true answer was in no seed's basin at all, and no yaw spacing could
    ever have reached it.
    That is why three earlier fixes, each correct, moved nothing: the spacing was
    resized to the reach, the rivals were properly refined and re-ranked, and both
    were real improvements to a search that still could not put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
2026-08-28 The project tray opens by default
    Asked for by name: it carries the job's name and whether there are unsaved
    changes, which is the one thing worth having in view the whole time rather
    than something to go and open.
    Two things it had to get right, both scars already in this codebase.
    A DEFAULT REACHES NOBODY WHO ALREADY HAS A SAVED ARRANGEMENT. Tray layout is
    kept in localStorage on purpose, so changing the fresh-install list alone
    would do nothing for anyone who has ever run the program. A one-time migration
    opens it against an existing arrangement and leaves order, folds and every
    other tray exactly as they were.
    AND IT IS A SEPARATE `if`, NOT ANOTHER LINK IN THE `moveback` CHAIN. That
    c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
2026-08-28 Record the seventeenth pass: a report I could not reproduce
    The operator saved a two-scan job placed close by hand and reported that
    auto-align was not working, then that the rotation was wrong.
    I measured it three times with `srv.solve(index)` and reported conclusions
    from it. That leaves start=None, which sets hint=None and takes the BLIND
    path. The panel does not do that: autoAlign() sends `start: s.setup` whenever
    the scan has been moved at all, so a hand-placed pair always presses the
    hinted path. Every number I gave them was the blind search, with a seeder that
    is not in their build.
    A probe that calls the library directly can take a different route from the
    button, and the DEFAULT A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
2026-08-28 Record the eighteenth pass, and test the undo order by running it
    The source check that a cut reaches the one undo stack was defeated by
    the reversion audit with `if(0) remember(...)`: every string it looked
    for stayed in the file while the call never ran. A check that cannot
    tell "present" from "called" is not testing the behaviour, so the
    behaviour is exercised instead -- cut, move, undo, in that order,
    which is the operator's own sequence. It reads [0, 1] where the bug
    read [1, 0].
    Three attempts to get that harness running, each its own lesson:
    "\n".join joined the lifted functions with the literal characters \n;
    _js_func matches on "function <name>(" and so lifts an async function
    with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
2026-08-28 A circle and a polygon to cut with
    Neither is a new kind of cut. The rectangle was already a four-point
    polygon fed through commitLasso, so a circle is that with sixty-four
    points and a polygon is that with however many corners were clicked.
    Nothing on the server, in editPlan or in the exporter learned anything
    -- pinned by a check, so a later change cannot quietly give one of
    them its own path.
    The circle is a DRAG and the polygon is CLICKS, so they went into
    different tables on purpose. A circle is drawn from its CENTRE: a
    marquee is placed by its edges because that is where a rectangle's
    meaning is, but a circle goes over a tripod or a bin, and you place
    it by the thing in the middle.
    E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
2026-08-28 Record the nineteenth pass, including what I got wrong about the noise
    The circle and the polygon, and the reason they were cheap: the
    rectangle was already a four-point polygon, so neither needed anything
    new from the server, editPlan or the exporter. Read the existing shape
    of a feature before pricing a new one against it.
    Also written down are the answers given verbally this pass, because
    none of them are visible in the code:
    - The noise floor was OVERSTATED by me today. The 2-5 cm scan-to-scan
    gap contains two scans' noise plus registration error, so the true
    single-scan sigma is smaller than I said. Queued as a measurement
    rather than a correction in passing, because it bears on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
2026-08-29 Make a delete delete points, not hang a hole in the room
    A box and a lasso were both tested in the merged frame, so a cut was a
    fixed VOLUME and the clouds slid through it: move a scan after cutting
    the tripod out of it and the tripod came back, while whatever drifted
    into the hole vanished in its place. Both halves of the report are the
    same slide, in opposite directions.
    It was the design, not a slip -- editsFollow existed to recompute the
    mask on every move and said so in a comment. What it got wrong is what
    a person means when they draw round something and press Delete.
    It cannot be fixed by remembering which points were hit: the preview
    holds a 2 cm thinning while the export re-reads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
2026-08-31 Close the loop: move the whole survey at once, because the error is in no one scan
    Reported: auto-align "not working" on scan 18, sitting 0.2 m above the
    bartop. Measured on the project: 0.026 m against its walk neighbours,
    0.307-0.392 m against the captures from the start of the walk - and scan 17
    reads the same. Sixteen pairwise fits each left millimetres; where the walk
    closed, the sum landed on the bartop. The multi fit rightly refused to move
    one scan, so this adds the tool that moves them all: every in-reach pair is
    measured fresh by GICP, a weighted pose graph is solved with scan 1 as the
    gauge (registration.close_loop), and either the survey measures better
    afterwards and everything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
2026-08-31 Cap the survey edges at the density they measurably need
    Measured before built, on the live 18-capture job: the press at full
    density (1.2M-point samples) took 1441 s; capped near 300k points it took
    546 s and every capture landed within 0.017 m and 0.33 degrees of the
    full-density answer - inside the 1-3 cm wobble the weak cross-wall edges
    show under ANY resampling, against corrections of 0.2-0.45 m. Only the
    survey caps: a pair or multi fit is one fit, not one vote among fifty, so
    those keep the full sample. The capped view is used for solver, judge and
    verdict alike, so the floor the bars scale from is the floor of the points
    actually measured. Suites 1434 -> 1437, both new checks reversi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
2026-09-01 Record the 22nd pass: scan 21's photo pose was a compensation stack
    The 'deep align not working' report reproduced: re-pressing digs the
    tilt deeper because the term gate and standardisation follow the start
    lean. The content oracle (pre-lift ladder on paint_drift, folder 1 as
    control) shows the true stack is the rig's own: mount residual +2.3/+0.6,
    camera_z 0.11, zero lift. Corrected copy delivered as
    'auto align error - image 21 level.tlspie'; code fix designed, not built.
    Also: the loop press is confirmed pressed (00:39 save matches the
    loop-closed poses).
2026-09-01 Give the content the last word after a deep search
    Measured on scan 21: the deep search's term gate and standardisation are
    taken at the lean it starts from, so a wrong basin, once stored, votes
    itself back in and a re-press digs deeper (-10.5 became -11.2,
    "improved"). On a 190.8-degree sweep the laser covers half the circle,
    where tilt, stitch lift and camera height are three-way degenerate --
    the search settled a compensation stack whose content sat 4.5 degrees
    adrift while the rig's own bolted numbers sat at 0.3.
    colour.content_offset reads where the content sits PAST paint_drift's
    +-5 degree window by walking the image through known pre-lifts and
    believing only readings that fall 1:1 w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
2026-09-01 Open the colour tray by default, and let the move tool keep the twin
    Two operator requests, 2026-09-01. The Colour / point size / detail
    tray joins the default-open set on the right, with a one-time colourv1
    migration for saved arrangements (fold kept, its own recorded flag --
    the project/moveback shape). And the move tool now holds the rush twin
    for the whole time it is armed, not per drag: "starts smooth then gets
    really laggy" was each release letting the full cloud start refining
    between nudges, so the next grab waited behind a chunk. setGrab is the
    one home for the tool's state -- button text, lit class, cursor and the
    'movetool' rush holder -- used by the click and the camera-mode door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
2026-09-01 Three polygon gestures for the draw-then-delete loop
    Asked for on 2026-09-01. Right-click closes an open outline -- with
    corners down a right-button pan could only ABANDON the outline (the
    matrix froze at the first corner), so the button was a gesture spent on
    self-defeat; with no outline it pans as it always has. Esc empties the
    polygon tool's hands but leaves it armed; a second Esc, with nothing
    left to throw away, puts the tool away like any other. And a middle
    CLICK deletes what a pending selection holds -- gated press-vs-drag
    exactly as a pick is, so the pan the middle button has always been is
    untouched, and it fires only where Enter already does the same. The
    button title, the corner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
2026-09-01 Write closed polylines, because a face is what Push/Pull extrudes
    The operator wants to trace the internal perimeter and model on top of it in
    SketchUp. SketchUp turns a CLOSED, coplanar loop of edges into a FACE, and only
    a face extrudes -- so the outline has to arrive as one entity, not as separate
    LINEs that happen to meet. Two segments computed by different means have no
    reason to share bit-identical endpoints, and the failure is invisible: the
    drawing looks right and simply will not extrude.
    LWPOLYLINE is R13+ and this writer is R12, so the R12 form is POLYLINE /
    VERTEX... / SEQEND, with 66 announcing that vertices follow and bit 1 of 70
    marking it closed. A closed polyline does not re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
2026-09-01 Deep align every photograph in one press, and the delete keeps the tool
    Two operator requests, 2026-09-01. "Deep align them all" runs the
    whole-circle search with its content check on every photographed scan
    in turn -- THE BATCH IS THE BUTTON PRESSED N TIMES: each scan goes
    through deep() itself so the batch cannot drift from the single press.
    A heading the operator typed is an input, not a guess, and is skipped
    by name; every outcome is named with the alarming ones first (one
    photograph moving FAR is the shape of a mis-paired image and must not
    scroll away inside a count); one Ctrl-Z puts every photograph back,
    built from the per-scan undo the way the shoot solve is.
    And a middle-click del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
2026-09-01 Trace free space: the outline, and the holes that are the structures
    Three pieces, all pure numpy because scipy is excluded from the build.
    floor_base_z: the flat plane a drawing stands on. The operator asked to trace
    down to the lowest floor so every wall extrudes UPWARD, but the literal minimum
    over five million cells is a drain or one stray return, and it would drop the
    whole base to chase it while looking perfectly reasonable. So the floor is
    fitted, re-selected against its own plane, and the base is a low PERCENTILE.
    On the real restaurant that is the difference between -0.110 (the minimum) and
    -0.070 (the 2nd percentile of 687,281 floor cells).
    free_space: cells the instrument could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
2026-09-01 Snap the outline to fitted walls, and shave the shadow fingers first
    snap_to_walls straightens a traced loop onto the fitted walls: position from
    the fit, topology from the trace. Where no wall was fitted the trace is kept
    UNCHANGED -- running a straight line through a stretch nothing was measured on
    is the invented wall this file already refuses to draw. Corners come from
    INTERSECTING the two wall lines, never from joining their ends, because an end
    is where a wall ran out of returns; on the fixture the walls deliberately stop
    20 cm short of every corner and the corner still lands exactly on (0, 0).
    clean_free_space came out of the real capture disagreeing with the fixture.
    Raw free space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
2026-09-01 Cut the plan along the wall lines, then let free space label the pieces
    This inverts the outline path, and the inversion is the point. Trace a raster
    boundary and snap it to walls, and straightness is a REPAIR that succeeded on
    47% of the operator's outline -- the share that happened to lie near a fitted
    wall. Cut the plan along the wall lines first and the inside/outside boundary
    can only ever lie ON one of those lines: straightness stops being something to
    fix and becomes a property of the construction, and corners are exact line
    intersections for the same reason. It is the approach the published pipelines
    converge on (a cell complex labelled by energy minimisation; Ochmann et al.,
    and the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
2026-09-01 Write 3DFACE too, because SketchUp imports a closed polyline as edges
    The operator opened the DXF and could not Push/Pull anything. The geometry was
    not at fault -- parsed back, every loop is closed, has no self-crossings, no
    zero-length edges and a 20 mm minimum edge. SketchUp's DXF importer simply
    brings closed CAD polylines in as EDGES, which is a long-standing documented
    complaint rather than a defect in the file. Edges do not extrude, and extruding
    is the whole reason the outline exists.
    3DFACE is a face on arrival. The polyline is still written -- it is one
    editable entity and AutoCAD and Max prefer it -- so both are in the file and
    the operator can use whichever their tool likes.
    Ea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
2026-09-01 Record the 25th pass: the outline tool, and why the floor must not be levelled
    The operator asked for an outline they can extrude in SketchUp. It is built and
    live, and its own verdict is recorded with it: it misses the platforms and the
    seating, because everything is cut at 1.70-2.30 m to find walls above the
    furniture, so every platform and seat is invisible by design. The fix is named
    and sourced rather than guessed -- a z-histogram at 0.05 m, every bin over 50%
    of the maximum being a horizontal surface, which gives seat tops, platforms and
    the bar in one pass.
    Also recorded, because it inverts an existing tool: 41 walls fitted in 3-D come
    back plumb while the floor slopes 0.24 deg, so t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
2026-09-01 Find the levels a room is built in, not just the slabs in it
    The operator's verdict on the last outline was that it "does not represent
    the room" and was missing the raised platforms and the seating. The cause
    was a design choice: everything was cut at 1.70-2.30 m to find real walls
    above the furniture, so every platform, seat and counter was invisible by
    construction.
    Cloud2BIM (arXiv 2503.11498) finds horizontal surfaces from a 0.05 m
    z-histogram, taking any band over 0.6x the MAXIMUM. Measured on the
    restaurant that selects the floor and two bands of ceiling and nothing
    else -- the ceiling holds a million returns and the bar top a hundred
    thousand, so a rule scored against the maximum ca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
2026-09-01 Hide the triangulation, and stop simplifying below the raster
    The operator's screenshot: hundreds of edges radiating from single points
    across the whole plan. The triangulation was NOT at fault -- measured, every
    loop's triangle area matches its polygon area exactly (153.64 vs 153.64 on
    the floor). A 475-vertex outline simply has 473 correct triangles and 472
    interior edges, and they were all being drawn.
    Two separable causes, both fixed:
    1. The loops were staircases. SIMPLIFY_TOL_M is 0.03 m and a level is traced
    on a 0.05 m grid, so a raster step -- exactly one cell tall -- could not be
    removed by any amount of simplifying. The tolerance preserved the
    RASTERISATION as faithfully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
2026-09-01 Export the outline from the clip box, with a button on the Export tray
    "only trace whats inside the clip box then i can choose", and then "i want a
    button on the export tab for exporting the outline from clipbox".
    The clip box replaces a classifier I could not validate. Cut at 1.70-2.30 m
    to find walls above the furniture, the plan also catches whatever the ceiling
    hangs down into it: 3 of 61 fitted lines on the restaurant (11.8 m of 217 m)
    have almost no returns below head height. But a wall standing behind a bar
    counter measures the same, the ratios run 0.029, 0.070, 0.127, 0.181, 0.203
    with no gap, and a second test ("you can walk under a soffit", asked of the
    ray casting) ranked a compl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
2026-09-01 Record the ceiling rule, the clip box, the button, and three defects found
2026-09-01 cut="box": the clip box IS the cut, floor or no floor
    "trace only around the walls that touch the clipping box, when i go to
    export there will be no points on the floor at all only the wall outlines."
    That case refused outright. DrawingWriter finds the floor and ceiling in the
    cloud it is given, and a box holding a band of wall has neither, so close()
    raised and no drawing was written.
    The refusal is right in general -- a cloud with no findable floor is usually
    a cloud that should not be drawn, and a plan cut at a guessed height is a
    drawing of nothing that looks like a drawing of something. So this is NOT
    wired to "detection failed". It is an explicit mode: a box drawn round a band
    of wal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
2026-09-01 Record cut=box, and the caveat that the box is the cut, not a crop
2026-09-01 Rewrite the restart pointer as one block; it had grown to contradict itself
    Its last line still said 'none of it is wired into CLI/GUI/Studio' after the
    Export-tray button shipped. A pointer that contradicts itself is worse than a
    short one, so the block is now written whole rather than prepended to, and it
    says so.
2026-09-01 An outline cut takes only what the clip box shows
    A lasso, rectangle, circle or polygon cut is a screen-space prism through
    the WHOLE cloud, so with the clip box on it deleted points the box was
    hiding -- points nobody could see. The hidden-scan doctrine one level down.
    The cut now carries a clip stamp, frozen at commit like the camera and the
    frames: a delete spares the clip-hidden points, and a keep KEEPS them
    (otherwise "keep only this" would quietly wipe everything the box hid).
    Box cuts are exempt on purpose -- hide-inside-then-delete-the-box is the
    designed preview pairing. One stamp rides the one plan, so the preview,
    the fast drop path, the replay, the project file and the export al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
2026-09-01 Record the 27th pass: the clip-limited outline cut, and the 12:54 exes
2026-09-01 Put the points back, aim the widget, pick a cloud, light one up
    Five operator asks in one sitting.
    Put every point back / Put this cloud back. Nothing is re-read because
    nothing was ever thrown away: a cut is an operation on a list and a clean
    is a rule on the server, so neither has touched the capture on disk or
    the buffers on the card. Clear all took back the cut list and stopped,
    so an operator who had also pressed Remove strays cleared every cut and
    still had a hole; these switch off both. Restoring ONE cloud NARROWS a
    whole-job cut rather than dropping it -- dropping it would put the tripod
    back into the four other scans as the price. The placement is never
    touched, so the cloud comes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
2026-09-01 Pin the commit in the 29th-pass live-state block
2026-09-01 Thread the RANSAC scoring: 41.3s -> 22.7s, DXF byte-identical
    fit_segments was 97% of a whole export (88.2 of 91.1s, profiled on the
    real capture). Threads, not processes: the scoring is large-array NumPy,
    which releases the GIL, so no freeze_support/spawn machinery in the
    frozen app. One batched draw per round consumes the seed stream exactly
    as the sequential pairs did; winner by first-argmax = the old
    earliest-strict-max rule; FIT_SCORE_WORKERS=8 is a measured bandwidth
    cap (4 threads 3.0x, 16 threads 3.1x on this box).
    The first regression test caught 0 of 4 planted breaks - workers=1 vs
    workers=4 on a clean fixture compares the broken code to itself, and
    clean data converges. The suite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
2026-09-01 Record the thirtieth pass, and heal the pointer the parallel sessions outran
    The threading commit's record, plus: the NEXT SESSION block had sat
    unrewritten through passes 27-29 (parallel sessions, same day), claiming
    the 11:25 exes current while the build trail below it said 23:02. It now
    points at the real state: 23:02 exes lack only 85f9384; rebuild all
    three when Studio closes; check git log before numbering a pass.
2026-09-01 Record the 23:51 exes: all three rebuilt with the threaded fitter
    Selftest 0, card + cuda-engine found, smoke-tested through the console
    bundle (capture decoded, colour solved at confidence 7.0, 335.7 MB PLY
    in 2.8s). The outline button now runs at the 1.8x.
2026-09-02 Two reports reproduced on the job itself, then the deep search 2.5x faster
    "Deep align them all not working": reopening a project promoted every
    solved heading to hand-typed -- colour_scan marks any handed yaw as given
    and _carry_colour hands it the file's -- so deep_all refused all nineteen
    ("nothing here can be deep aligned" on 11 doubtful / 3 confirmed / 3 sure
    / 2 unsure, not one of them typed). The restore now puts the flag back
    from the file (colour_pose writes it; old files fall back on the grade,
    which has always recorded a typed heading), and the lean resolver,
    set_camera and the page's "typed" label heal with it. Re-pressed on the
    operator's job: 19 of 19 eligible, no timeouts; 16_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
2026-09-02 Pin the 31st pass's commit and the 02:45 exes in the live-state block
2026-09-02 The press was measured: neither ceiling, buy nothing
    The operator ran a real Close-the-loop press with the 4-second sampler
    recording. Studio peaked at 7.2 GB of 31.2; VRAM's 95% is the viewer;
    GPU compute idled. The 21st pass's unproven memory-traffic suspect is
    excluded on capacity; the press is CPU by elimination, so the next
    speedup is a profile, not a purchase. Chrome+VS pushed commit past
    physical RAM in the first minutes - exposure, not cause.
2026-09-02 An outline thrown away takes its panel with it, and a dead press speaks
    "Polygon tool is still not deleting points" -- same words as yesterday,
    different fault. On the 02:45 build the press left no message at all and
    no js-error, and the whole commitLasso -> pushEdit -> applyDrop chain ran
    clean in node at the job's real scale -- so the press was dying at a
    guard. clearPending, the Ctrl-Z path that throws a drawn outline away,
    nulled V.pending and left the Delete inside / Delete outside panel
    standing: every later press hit commitLasso's silent "if(!V.pending)
    return;" and did nothing, forever. The 29th-pass record had even written
    "clearPending does not hide the Delete-inside panel" -- as a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
2026-09-02 Pin the 32nd pass's commit and the 03:52 exes in the live-state block
2026-09-02 Thread the survey press across pairs, and hand the judge down
    Profiled first, and the profile lied: cProfile tripled the press and
    mis-ranked the judge machinery. Unprofiled and instrumented, the truth:
    397.8 s, 98% in solve_gicp, a heavy tail (two fine-rung aligns of 66 s
    each, discarded by the keep-start guard; most pairs under a second).
    solve_survey now measures pairs concurrently - each pair WHOLE by one
    worker, results consumed in pair order - and hands its per-capture admit
    judge into solve_gicp, which was rebuilding an identical reference
    profile and sampling floor in every one of its 206 calls. Handing the
    float32-backed judge down is exact because _binned_ranges is float64 end
    to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
2026-09-02 Record the thirty-third pass and the 10:15 exes
    The survey press threaded and measured; the profiler that lied; the
    audit break that crashed a brittle check instead of failing its own;
    passes 31-32 landing from parallel sessions mid-pass, one editing the
    same file concurrently. Exes rebuilt with the threading, selftest 0,
    smoke-tested at 45.5M points.
2026-09-02 The whole day in one press: sort, open, colour, solve
    The operator asked for "the solve the shoot button to copy the images and
    move the scans into the numbered folder structure", with a fresh 5.5 GB job
    (D:\ministry of sound) waiting, and chose the whole chain when asked.
    "Sort, open and solve a shoot..." runs the four existing steps in order,
    none duplicated: shoot/plan, the SAME confirm as Sort a shoot (extracted to
    sortPitch), shoot/apply, ingest, solveShoot. The one departure is
    copy_photos: the chain COPIES photographs beside their captures and the
    camera's own files stay put (attach_photo's covenant) while captures still
    move; the plain Sort press is unchanged. Arrivals are handed to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
2026-09-02 Pin the 34th pass's commit and the 23:40 exes as current
2026-09-02 Give the 34th pass a live-state block, and retire the 04:00 one
    The build line was already pinned; what the record lacked was the block a
    next session reads for what is owed right now: the ministry job has not been
    pressed, the 23:40 build is what has the button, nothing on disk was moved,
    and the restaurant leftovers are unchanged. The 04:00 block is now marked
    superseded whole rather than on its build line alone.
2026-09-02 The shoot was walked in order, so the matcher may not cross it over
    Greedy nearest-pair assignment is not order-preserving. On the Ministry of
    Sound job -- 54 photographed positions in a dark club -- it crossed four
    adjacent pairs over (folders 3/4, 12/13, 30/31, 35/36) and then, having spent
    those frames on the wrong captures, pushed three more (9/10, 20/21, 32) down
    the "share it rather than call it unphotographed" path onto a picture of
    somebody else's tripod position. Seven of fifty-four captures wore the wrong
    room, which no solve can fix and which the confidence score reports as a bad
    photograph rather than a bad sort.
    The gap between a sweep ending and its photograph being taken by h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
2026-09-02 Pin the 09-03 exes, which carry the order-preserving matcher
2026-09-03 The operator's ground truth overturned the pairing, and the verifier with it
    "This image is scan 1" -- the frame the matcher had filed as a pre-shoot test
    shot. The offset histogram had locked a wrong peak: this shoot photographed
    each position BEFORE its two sweeps, so the true gaps drift while the next
    position's photos keep a tidy rhythm, and the tidy wrong answer out-scored the
    true one by one whole position. Every internal check passed regardless -- a
    global shift is monotonic, the yaw witness is mute between neighbouring rooms
    in a club, and the "sorted correctly" verifier checked the disk against the
    matcher's own offset. A verifier that shares the estimator's assumption cannot
    catch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
2026-09-03 The twin rises for the gesture, not the tool: the operator reversed the 09-01 hold
    "Drag to move now only shows the lod point cloud when button is pressed i
    would like it to show full scan on that button when its pressed." The 09-01
    tool-wide hold was that same operator's own ask -- smooth control, coarse the
    whole time the tool is armed, sharpen once on put-down. Placing a 56-scan
    club by eye reverses the priority: whether a wall sits ON a wall is judged on
    detail the 250k twin does not have.
    setGrab now holds nothing. The per-drag, wheel and arrow-key holders raise
    the twin only while the hand actually moves, and a still hand sees the full
    cloud, armed or not. The cost this re-admits is n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
2026-09-03 The operator's rule closes the pairing: nearest on the name clock, either side
    "Sort images of the shoot by time closest to each other scan - image or image
    - scan." Two facts fell out of taking that literally. The scanner's stem names
    and the camera's filenames carry the SAME wall clock, so this rig never needed
    offset estimation at all -- the peak fight was over a number the filenames
    settle. And the operator had already hand-attached images to four scans in
    Studio; those picks match the nearest-either-side rule exactly, supersede the
    earlier "071 is scan 1" anchor, and settle the workflow model on its third
    correction: one photo per scan, taken around it.
    Applied to the job: 43 images re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
2026-09-03 Pin the 02:36 exes and the fresh ministry project, odd list named
2026-09-03 Bring the live-state block current for the compaction handoff
2026-09-03 The deletes were landing, on one cloud of twenty: the cut scope no longer follows the pick
    "Delete points tools are not deleting points, try again" -- the third such
    report in four days, and the evidence was the operator's own saved project,
    not the code diff: both of their delete edits, a freehand lasso and a
    polygon, carried "scan": 19. aimAt set V.editWho alongside the movement aim,
    so every "work on this one" gesture -- a double-click, a list row, the 09-01
    point-pick, even a scan arriving -- silently rescoped every future delete to
    that one cloud for the rest of the session. Twenty overlapping scans of a
    club made the default indistinguishable from a broken button: the other
    nineteen cl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
2026-09-04 The predicted lag came back and the named lever was pulled: refine in slices, not buffers
    "Moving scans is back to being really slow" -- the exact 09-01 lag the
    drag-to-move reversal (9c7d922) re-admitted, arriving as the comment at
    setGrab said it would: with the move tool no longer holding the twin, the
    full cloud refines between nudges, and the next grab waits behind the
    refinement draw in flight. That draw was a whole 4M-point GPU buffer,
    because the refine quantum WAS the buffer.
    The lever recorded beside the cost ("smaller refine chunks, not a third
    flip of this holder") is now pulled. Idle frames draw a REFINE_POINTS=500k
    slice per frame: drawArrays takes a first and a count, so the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
2026-09-04 Pin the 36th pass's two commits in the live-state block for the compaction handoff
2026-09-04 Straighten from the walls: the survey levelled off the surfaces built plumb
    The operator asked for a button under Close the loop that takes the
    average verticality of the walls and straightens all the scans together.
    Built as level_from_floor's sibling, measuring the other surfaces:
    wall_planes finds each capture's flat STANDING patches (voxel cells,
    batched-eigh normals, a flat gate and a standing gate), the normals ride
    each placement's rotation into the merged frame, and the up is the one
    direction perpendicular to every wall at once - applied ONCE to the
    room's Level, never to a scan, under the same undo as the floor. Walls
    invent no datum; one direction of wall is refused, not guessed;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
2026-09-04 The camera is parked while a polygon is open
    Operator: "right click also moves the cloud, which is causing the
    polygon tool to reset - only when I stop drawing should right click go
    back to moving the cloud." The polygon froze its matrix at the first
    corner and ABANDONED the outline the moment the camera moved; the
    comment defended that trade (refusing the camera "stops the view working
    and nothing on screen says why"). The chair overruled it: obedience
    destroys the work in hand under a habitual gesture, where a refusal can
    say why while the work still stands.
    Several doors led to the same death, so the class is closed, not the
    button: pointerdown refuses middle/shift/world-axes presses wit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
2026-09-04 Pin the 37th pass's two commits in the live-state block for the compaction handoff
2026-09-06 Record what the solvers actually read: the full cloud, never the trimmed one
    The operator asked whether Align entire shoot and Close the loop use the
    trimmed clouds. They do not, and the answer was verified on four points
    rather than recalled: Scan.sample is assigned exactly once in the
    constructor, so no edit, clean or undo path rewrites it; solve_survey
    caps its per-capture views from that sample; body.get("edits") occurs
    once in the whole file and it is in save, not in any solve route; and
    Scan.clean is a stored spec that is never applied to the loaded points.
    Both level fits read the same raw sample.
    It follows from the program's own rule that a cut is an operation rather
    than removed d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
2026-09-06 The photographs move with the shoot, the cut history folds, and the photo solve reads only what is left
    Three operator asks, 2026-09-06.
    A shoot copied to another drive reopened with every cloud grey: the
    captures had a relative-first ladder (project_paths) and a photograph's
    pose stored only the old drive's absolute path, which open_project tested
    verbatim -- and the page never read the lost_photos it was handed.
    photo_paths gives the photograph the same ladder (project-relative `rel`,
    written by every save from now on; the absolute path; the file structure
    re-rooted on where the capture was found, which rescues every project
    saved before `rel` existed; the same name beside the capture). T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
2026-09-06 Pin the 38th pass's commit and the 11:58 build in the live-state block
2026-09-06 A placement follows its cloud, and the picture can be pinned by hand
    The alignment shuffle, first. Reported as "something broke point cloud
    alignment of this entire project, i was using the move image and then
    the lidars got mismatched", with the job already saved over.
    Diagnosed from the file rather than from the symptom: all 18 placements
    had changed, and every one of them was a VERBATIM value from the
    previous save sitting on a DIFFERENT scan. A solve makes new numbers;
    there was not one new number in the file. Nothing had been re-solved --
    the placements had been dealt out to the wrong clouds, in an interleave,
    which is what two loops running at once leaves behind.
    rebuildFrom was the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
2026-09-06 The markings as a judge, measured; and the pictures check the clock's sort
    Two operator ideas. The first -- "deep align should take the lidar return
    intensity, create a 360 black and white image and use that to align the
    colour image because all shapes would be similar" -- was two thirds built:
    the panorama existed and mutual information already matched its VALUES.
    Nothing had compared the two as SHAPES. The edges of reflectivity are
    sign-free where its values are not, so a material boundary is an edge in
    both pictures whichever way the contrast runs; built as PoseScorer.mark
    and solve_yaw_mark.
    Then measured, over every heading on 72 of the operator's real captures
    against confirmed poses,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
2026-09-06 Pin the 40th pass's commit and the 15:03 build in the live-state block
2026-09-06 WIP: the photograph matched to the cloud by its features (forty-first pass, unfinished)
    New tlsconvert/match.py: the cloud's reflectivity panorama and the photograph matched
    feature to feature (DISK+LightGlue or XFeat through ONNX Runtime), two-point RANSAC for
    the rotation and a six-parameter fit for the seat, a pairing verdict from the count of
    agreeing points. Wired as the FIRST solver on arrival (Studio and CLI), as a one-press
    "Match the picture" door and button, as the judge in "Which photograph belongs" and the
    sort's picture check, and the page now keeps clouds whose blob fingerprint is unchanged
    instead of re-fetching all of them on every photograph press.
    Measured on the operator'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
2026-09-06 Pin the 41st pass's commit in the live-state block
2026-09-06 The camera's seat is searched by the count, not inherited from the seed
    "deep align on scan 4 still not aligning properly": the stored pose had a
    hand-typed heading at zero tilt and the ladder's 0.39 m seat, and Deep
    align polishes from where it starts. Match the picture then returned
    0.28 m -- graded "matched" -- because the six-parameter fit only ever sees
    the pairs RANSAC kept, and RANSAC kept the pairs that agreed from the
    seed's seat. The count tells them apart: 551 of 738 matches agree under
    one rotation from 0.10 m, 210 from the sensor, 109 from 0.39 m, both
    backends peaking at the same height.
    match_pose now renders the cloud from every one of the ladder's
    SEED_HEIGHTS (plus the cal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
2026-09-06 Record the 42nd pass: the seat searched by the count, scan 4 aligned
    Live-state block retitled and pinned to f9e8943; the pass's own section
    carries the seed sweep table, the two rejected shortcuts, the cross-scan
    seat peaks, the cost of the sweep, and the operator's new project file.
    Exes deliberately not rebuilt for this pass alone: the build closing the
    camera-manifest pass carries it, and the block says so.
2026-09-07 A camera manifest beside every exported cloud, in the file's own frame
    Export merged cloud now writes <stem>.camera_manifest.json (authoritative),
    .camera_positions.csv, .export_report.md and .camera_preview.png beside
    the cloud: one record per panorama with its camera centre in the exported
    frame and metres, through the exporter's own Level(Setup(Lean(p))) written
    as one matrix and checked against the pipeline's transforms to 1e-9; a
    camera-to-file rotation with the equirectangular pixel-to-ray equations
    written out (and verified against colour.sample and lift_image); the
    station beside the optical centre with the seat between them; image
    sha256, size, EXIF time, and the Insta360's all-zero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
2026-09-07 Record the 43rd pass: the camera manifest, the build, and the pin that lied
    Live-state block retitled to the forty-third pass and pinned to f357a74;
    the pass's own section carries the frame derivation, the sample from the
    operator's job, the six-break audit, the 01:34 build (manifest and match
    modules read out of the bundles), and the lesson: the suite was green with
    the export door calling a name that did not exist, because the check
    pinned the name in the source. Only a call proves a door runs.
2026-09-07 Studio crashed inside OpenBLAS's worker pool; OpenBLAS now runs on one thread
    "studio is crashing": Windows logged an access violation in
    libscipy_openblas64_ at 01:53:10, nine minutes into a session on the
    01:34 build. The minidump placed it in OpenBLAS's Windows worker loop
    (blas_thread_server) at the call through queue->routine: the worker had
    popped a work node from OpenBLAS's one shared queue whose memory was dead
    -- one node on the stack of a thread that no longer existed, the other
    numpy's own static data read through a stale `next`. Those nodes live on
    the calling thread's stack, and Studio's callers are the HTTP server's
    per-request threads, which end with the request. A placement i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
2026-09-07 Record the 44th pass: the OpenBLAS crash read from the dump, the pin, the build
2026-09-08 Fix the first three sweep defects: the dead DXF export, and two rooms
    The 45th pass listed thirty defects and fixed none. This takes the top
    three off the list, each at the shape of the mistake rather than the line
    that reported it, and each with a named check that fails when it is
    reverted.
    The DXF outline export has raised TypeError since 2026-08-28: the two
    point writers grew close(keep=) and the two drawing writers did not, while
    pipeline.convert and pipeline.merge close every writer from a finally as
    close(keep=finished). So the outline button cannot have worked, and the
    TypeError also replaced whatever had really gone wrong. keep=False now
    returns BEFORE the analysis, not just before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
2026-09-08 Two more sweep defects: a search in two frames, and a range in log metres
    The deep search built its starting pose out of camera_z and nothing else.
    _pattern fills a missing seat in with setdefault(..., 0.0) and passes those
    zeros down, so every candidate was scored from the lidar's own axis, while
    the incumbent's score is taken with the seat left None -- which
    PoseScorer._at reads as the camera's real seat. Two poses judged from two
    different eyes, and the bigger number wins. The answer came back in the
    wrong frame too: the camera_x returned was an offset from the origin and
    the caller stores it as the seat. refine_pose and deep_refine both carry
    all six numbers; this was the one sibling of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
2026-09-08 The field box stops calling a dead capture a finished scan
    Two guards on the Pi, neither able to do the job its name claims.
    start_capture confirms tcpdump survived its first moment and nothing ever
    looked again, so a recorder that died a few degrees into a three-minute
    sweep let the motor run to the end, wrote a sidecar describing the whole
    track, and reported "Scan complete" over a pcap holding a sliver of it.
    should_abort is the only question the sweep asks, so that is where the
    recorder is asked after now.
    stop_capture refused a capture only when getsize(...) == 0, and tcpdump
    writes a 24-byte pcap header the moment it opens the file -- so the one
    state the check existed to catch was t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
2026-09-08 Pins that follow their cloud, and a heading of zero that survives a save
    forgetScan renumbers every index above the one that went, and V.pinWho's
    renumber was written as `else if` behind two V.matched branches. Those are
    two independent pieces of state that happen to sit next to each other, and
    a match record exists in the normal case -- the moment anything has been
    matched. So whenever one was present and was not itself the removed cloud,
    the pins kept the old number and were handed to whichever cloud inherited
    it: the exact failure the block's own comment says it prevents, arriving
    through the block itself. An else is a claim that two things cannot both
    need doing.
    Every existing check on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
2026-09-08 Fix 8 audited: the re-solved answer agreed with the one it replaced
    Reverting the save filter to the bare falsy test gives 1896 passed, 2
    failed -- exactly the two checks that name the fix, nothing else in
    1898. Restored byte for byte and back to green. That closes the debt
    the last commit left open: 20 breaks this pass, all 20 caught.
    The second discriminator is worth keeping. The reverted run printed
    (None, {... 'yaw_deg': 0.0, 'given': True ...}): the restore door was
    handed None -- "solve it" -- while the dict it returned still read
    yaw_deg 0.0. The outcome looked right; only the value the door was
    ASKED with showed the scan had been re-solved. A check written against
    the returned value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
2026-09-08 The shoot solve paints where it looked, and both ends of the seat contract
    solve_shoot handed _repaint a pose with camera_z and no camera_x or
    camera_y, and _repaint read a missing key as 0.0. Measured on a
    two-scan job: 13.5 mm and 14.1 mm of plan seat walked back to the
    lidar's own axis, per scan. colour_scan writes the seat into both
    colour_info and the scan attribute from one tuple, so the seat was not
    ignored -- it was destroyed in both places, and that is what the next
    save writes.
    Six of the seven _repaint callers passed all three numbers. This was
    the seventh, and it is the one that applies to every photographed scan
    at once. set_tilt carries a comment saying this defect was found a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
2026-09-08 A restart pointer: nothing half-done, and nothing delivered either
    Records where the 46th pass stopped so the next session does not have
    to re-derive it. All ten fixes are written, tested, reversion-audited,
    committed and pushed, with no audit debt outstanding and a clean tree.
    Next chosen is align.py:11817 -- saved point pairs are never restored
    on open, so every pin an operator places is silently lost the next
    time the job is opened.
    And the thing to say first on resuming: none of the ten are in
    anything the operator runs. dist\ is still the 2026-09-07 02:34 build
    and the Pi still has the old tls_scan.py. Ten fixes in source is not
    ten fixes delivered.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
2026-09-08 The freeze on rotate came back: the GPU setting undid itself
    Windows keys the per-app graphics choice on msedgewebview2.exe's FULL
    path, version folder included. WebView2 updated itself from 151 to 152,
    the High-performance entry matched nothing, and Studio's window went back
    onto the integrated Radeon -- the 08-27 hang, with no change to Studio.
    desktop.prefer_fast_gpu() now writes GpuPreference=2 for every installed
    WebView2 version at each Studio start, before the window opens, logs what
    it asked, and leaves an existing entry alone. The page's low-power warning
    says Studio tried and gives the manual route as the fallback.
    Suite 1910 -> 1917 on a scratch registry key; reversion-audited (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
2026-09-08 The freeze survived the GPU fix: a move re-tests only what it can change
    The 22:47 boot drew on the RTX and the turn still hung. Every scan move
    ended in editsFollow(), which replayed every cut against every point on
    the page's main thread 250 ms after the hand paused and again on release:
    2.0-2.5 s at 46 million points, measured under node on the shipped
    functions. A cut that remembers where a cloud stood cannot read
    differently after that cloud moves, so followMoved(s) re-tests nothing
    for the ordinary job and replays once, logged with its cost, only for a
    cut with no frame for the moved cloud. Every one-scan door passes its
    scan; the whole-job doors keep the full replay.
    Also: the forty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
2026-09-09 The rematch found nothing to rematch: the fault was the pose
    The operator asked to rematch the Ministry of Sound scans to their photographs.
    Every one of the 54 photographed captures was already wearing the right one:
    48 the pictures read outright, 0 changes, 5 mute but bracketed by confirmed
    neighbours, 1 unvouched, 2 captures the camera never shot. That is exactly the
    54 photographed positions pair_in_order's own docstring cites for this job.
    The fault was the heading. Eighteen of the project's twenty-three scans graded
    doubtful, and a weak fit paints the right photograph at the wrong angle, which
    on screen is indistinguishable from the wrong photograph. Those headings were
    solved on 09-0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
2026-09-09 Colour by return strength, and the wire had to carry it
    "i need an intensity filter in blue that gets lighter the more points
    are gathered" -- the operator meant the instrument's own reflectivity, so
    the mode button gains a fourth stop that ramps deep navy to pale
    blue-white.
    It could not be one shader line. The colour block carries EITHER the
    photograph OR the return strength and never both: a grey cloud's single
    byte IS its reflectivity, but once a photograph is applied `aCol.r` is
    the picture's RED, and painting that as intensity renders a red wall as
    a strong return with nothing on screen to say it is wrong. So a coloured
    cloud that still has its reflectivity now sends a fourth byte and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
2026-09-09 Record where the camera positions are written
    Asked during the 48th pass: which file, beside the exported cloud, says
    where the 360 camera sat. `manifest.write_beside` writes it under the
    cloud's own stem -- the manifest, the CSV, the report and a plan preview
    when one can be drawn -- and the entry carries TWO positions, the
    panorama's optical centre and the lidar's, about 0.10 m apart on this
    rig. A pointer rather than a copy, since manifest.py's own docstring is
    the authority; the one thing noted against it is that the docstring says
    three files and then lists four.
2026-09-09 Nine things the sweep named, and a press for the whole shoot
    The pairs an operator picks are saved and were never read back. Three
    places already agreed they should be: projectState writes them,
    save_project writes them under a note saying dropping them "would throw
    that away silently", open_project hands them back -- and openProject had
    a comment saying they come back standing over no code at all. Silent in
    the worst way, because a job with no pairs looks exactly like a job whose
    pairs were lost.
    The clip box's grips were behind !V.tool, so any armed tool switched all
    seven off with the box and its dots still drawn -- the third report in
    that class. They are asked before the tools now; a 9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
2026-09-09 Record the 49th pass, and repair six checks that raised instead of failing
    The exes are rebuilt (12:41-12:42, selftest 0), so the blocker that led
    the restart pointer for a day is closed and the pointer says so.
    The audit's very first break came back CAUGHT and SUITE DIED: with the
    pairs restore removed, `_op_src.index(...)` RAISES, so the run ended in a
    traceback instead of the checks printing their names. A test that cannot
    fail cleanly cannot report -- the 48th pass's lesson, met in code written
    after it. `find` instead of `index` at four ordering checks, no
    `check=True` on the node harness, and `.get` on every result read.
    And one fixture could not have failed either: the whole-job cle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
2026-09-10 Ask the build what it carries, rather than trusting that it carries it
    "It is in the source and not on the machine" is this project's most expensive
    recurring mistake. A build packs the working tree, a build can be skipped, and
    a build can be run with the Studio open -- and every one of those looks the
    same afterwards: green suite, clean tree, confident report, and an operator
    still running last week's behaviour. The 48th pass's colour mode led the
    restart pointer for a day in exactly that state.
    Grepping the exe does not answer it, which is the trap. PyInstaller stores the
    modules compressed, so a plain search finds neither the new string nor the old
    one, and zero hits reads like a failure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
2026-09-10 Read the return mode, close the 49th audit, and let Edge run
    The decoder never read the factory byte that says which return the sensor is
    sending. In dual mode the twelve blocks of a packet are six pairs, one firing
    reported twice, and read as twelve firings the first block of every pair lost
    its per-laser spread and the firing times ran twice as long as the packet.
    Every capture this rig has made is Strongest from a VLP-16, checked on four
    captures and 16,000 packets, so nothing is wrong today and the default decode
    was already right about angle, range and reflectivity. This is protective: the
    mode is now read per packet, a pair is timed as one firing, the spread steps
    pair to pair, and bot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
2026-09-10 A stop throws the scan away and turns the head back; the Rapid parks at 180
    "i would like it if i stop a scan mid sweep to delete that scan and lidar
    resets ... resets heading." A STOP pressed during a sweep now deletes the
    capture that scan was recording, and its sidecar if one exists, by name and
    never by pattern, then turns the head back to where that scan started.
    The position after a stop was unknown by design, and it never had to be.
    pigpio cannot report how many steps it had emitted, so every stop threw the
    position away and the operator re-homed by hand. But the planner fixes every
    step's timing before the move begins, so the count at a stop follows from how
    long the move had run: t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
    [test_capture_guards.py, test_scan_profiles.py, test_stepper_watchdog.py, tls_scan.py, tls_stepper.py, tls_web.py]
2026-09-10 Save for compaction: where to resume, and what the rematched project showed
    A resume-here block at the top of the current entry, in order. First, the Pi
    delivery, blocked on the Pi's current address: every address the record holds
    is stale or on the lidar link, today's hotspot answers only the phone, and
    deploy53.py is ready for the moment an address is known. Second, the
    rematched Ministry project, which the operator opened and saved at 11:15:
    doubtful fell from 14 to 1 as predicted, but at least 25 photos the matcher
    solved were saved graded "given", as if typed, so Deep align will skip them.
    The door that does it is not traced yet. Third, the sweep's open list is 20
    plus two parked DXF it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
2026-09-10 A STOP with nothing running is refused, not saved for the next move
    The stop flag was cleared only when a scan began or ended. The panel polls
    once a second, so STOP stays enabled for up to a second after a scan ends,
    and a second phone or a stale page can post it at any time. That press
    waited, and the next Restart, which never cleared it, stopped on its first
    poll, drove nothing, and reported itself interrupted.
    Two halves, each audited on its own:
    - request_stop refuses while nothing runs ("Nothing is running", 409).
    Every head move runs with busy set, so nothing stoppable is refused.
    - do_restart clears any leftover stop before it raises busy, so no press
    meant for that restart is t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
2026-09-10 Save the end of the session: where to resume, from the top of the file
    The record's opening now points a cold read straight to the current LIVE
    STATE, which sits thousands of lines below older restart-pointer entries.
    Its RESUME HERE is rewritten for the end of the session: the rig idle and
    shut down, everything pushed, the Pi carrying every Pi change. Next, in
    order: watch the first real STOP and 180 Rapid, make the splash test skip
    without Pillow so the deploy can restart the scanner itself, trace the
    door that saves solved headings as given, then shoot.py:516.
2026-09-10 Record the session end: the repaired project reopened grey headless
    A headless open of two captures from the repaired project came back
    with no colour on either, while colouring the same scans directly
    works. Not yet traced; the record tells the next session to trace it
    before the operator relies on the repaired copy. The Studio audit was
    still running at the session's end.
2026-09-11 Hold a pose the open could not paint back, and close the 55th audit
    The repaired project's grey reopen was traced: with memory to spare both
    captures open right (matched rung 4; solved fresh, doubtful, neither
    given). Beside five audit suites both repaints refused early, and
    _carry_colour threw the refusal away. Worse, a grey scan wears no pose, so
    the next save wrote the photograph out of the project: heading, seat,
    grade and match record. A photograph merely missing on open went the same
    way.
    A pose that could not be painted back is now held on the scan
    (unrestored_pose). The save writes it back as it came, a re-read at
    another detail tries it again, and the open, the re-read and the page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
2026-09-11 Take the drift edge norm off BLAS, which made an EXACT check flaky
    "The padded slice equals the wrapped gather EXACTLY (through the seam)"
    failed once in 34 suite runs this pass, printing the same numbers on both
    sides: two calls of paint_drift on one input disagreed.
    Measured and refused, in order: memory alignment, repeated calls, the
    card (paint_drift never uses it), CPU load. What held: _drift_edges took
    np.linalg.norm of a 518,400-cell field through OpenBLAS, whose sum splits
    across its threads. At one thread against the default the resampled image
    was bit-identical, the edge field differed in 388,348 cells (up to
    1.4e-17), and the answer moved by 2.2e-16. Two calls that see different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
2026-09-13 Measure where a wall's thickness comes from; no first return exists
    The operator asked for a less noisy wall, "decoding only the first
    return" or anything else. The VLP-16 has Strongest, Last and Dual only,
    every capture is Strongest, and a wall gives one return, so no return
    choice changes a wall. Measured on the 09-02 job instead:
    - per-shot range noise 5 mm (second differences along a laser's own
    firing sequence), 5-8 mm across all 56 captures, no warm-up, no drift
    - a wall in the Studio's decode is 8-12 mm sigma, 14 mm at 4-6 m
    - one laser, one cell, one side of the fan: 5 mm, the shot noise; the
    rest is geometry and per-laser bias
    - per-laser azimuth + the manual's Table 9-1 vertic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
2026-09-13 Smooth surfaces: every return onto the plane of its own cell
    The operator asked for a less noisy wall and, given the measurement,
    said "do it". A third cleaning rule beside strays and weak returns, off
    by default, one cloud or the whole job, carried by the project, the
    re-read and the export like the other two.
    Every return of the capture feeds ten sums for its cell; a cell with 12+
    returns scattering under a quarter of its width is a plane, and its
    returns move along the normal by their own residual, never more than
    3 cm. The planes come from a re-read of the whole capture, never from
    the decimated picture. The preview keeps the raw points and draws the
    moved copy beside them; the export f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
2026-09-13 Keep within N m: a reach on each cloud, and on every scan opened
    The operator asked to get rid of points further than 4 metres for the
    cleanest results, applied on import so the quality is visible at once
    and on export exactly as the view shows it.
    A fourth cleaning rule beside strays, weak returns and smoothing: a
    keep-mask on the range from the tripod, in the cloud's own frame, which
    is where both the preview and the exporter apply every rule -- so the
    file is the view's rule on every return. The tray has a reach slider,
    one-cloud and whole-job buttons, and every rule body carries the reach
    the cloud already wears, so a stray or smoothing press never switches it
    off; the undo re-sends it.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
2026-09-13 The corrected decode is the default: per-laser azimuth and laser origins
    Measured on two full-360 captures the operator shot tonight
    (TLS_26_09_13_19_02_13 and _19_05_53, 378 degrees at 2 degrees a second)
    and the two 190-degree door captures 10 and 30.
    The pitch delta that came with per-laser azimuth was wrong in sign. At
    effective pitch 8.3 / 8.4 / 8.5 the plane sigma over 25 cm cells is
    11.22 / 10.97 / 10.88 mm (full-360 a), 11.34 / 11.01 / 10.89 (b),
    7.04 / 7.01 / 7.06 (capture 10), 10.66 / 10.54 / 10.49 (capture 30):
    8.4 is within 1% of the best everywhere and the only value whose 4-12 m
    band never worsens. The shipped -0.20 gave 11.64 on capture a, worse
    than block azimuth (11.58). PE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
2026-09-13 The two halves of the fan land on each other: the puck's azimuth curve
    The operator, looking at the full-360 scans, saw the points from one
    half of the fan not lining up with the other half. They were right, and
    every thickness measure of the day had been blind to it: a plane
    residual is taken across the plane, the fan angle moves a wall point
    along the wall, and on a 190-degree sweep each floor cell is seen by one
    half only, so its own plane fit swallowed the slip.
    On the full rotations, front half minus back half in the same cells, the
    floor splits 16 / 24 / 47 / 55 mm at 0.75 / 1.5 / 2.25 / 3 m from the
    axis and the ceiling -5 / +1 / +13 / +29, both captures to the
    millimetre, walls with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
2026-09-13 The pan-scale check, and a common elevation offset for the fan halves
    The operator asked for the measured check of the full turn of pan
    coming up 0.22 degrees short. It does not: a point-to-plane fit of the
    last 18 degrees of the 378-degree sweep onto the first 18 gives +0.78 and
    +0.06 on the two fan sides of one capture, +0.36 and +0.18 on the other.
    A pan-scale error would give the same number on both sides, and an
    18-degree wedge of one room cannot separate a rotation about the axis
    from a sideways shift. The earlier figure was an artefact of that.
    STEPS_PER_REV stays; a real check needs a narrow target seen before and
    after a full turn.
    What the same fit does find, over the whole sweep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
2026-09-13 Record the next steps offered at the end of the fifty-sixth pass
    Per-laser fan-angle offsets with a twice-per-turn term, per-session
    range offsets at import, and the operational habits (warm-up, scan a
    station twice, slow profile). None started. Planes now sit at the
    sensor's own noise floor; the pan scale, roll, yaw, lever and return
    mode were all measured null and are not worth revisiting.
2026-09-13 Record why the scans stopped lining up after the decode change
    The fan halves land within a few millimetres on five job captures under
    the product decode. What remains is scan against scan: today's decode
    moves every capture by a rigid half-degree tilt in its own frame, and the
    project's poses were solved on 09-10 under the old decode. The answer is
    to re-solve (Close the loop), not to re-correct.
2026-09-13 The project records which decode its poses were fitted to
    A decode change is a pose change in disguise: the corrected decode tilted
    every capture a rigid half degree in its own frame, and poses solved the
    day before sat 37 mm out at 5 m. rig.decode_stamp names the geometry
    every point carries; one door, align._stamp_pose, stamps every solved
    placement (pair, multi, pairs by hand, the survey whether it moved or
    found the walk agreeing); a Scan is born stamped and a re-read carries it.
    The save writes the stamp beside each placement, the open returns the
    placed captures whose stamp is not the running one, and the page sends
    the operator to Close the loop rather than back to the calibration.
    Tw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
2026-09-13 Carry a placement made on the earlier decode across on open
    The photograph is solved on the levelled cloud, and the lean in the file
    was fitted on the old points; under the corrected decode the raw points
    sit half a degree turned inside that lean, so the picture lands half a
    degree off. Rather than send the operator to a long re-solve, the open
    now measures each capture's rigid shift between the two decodes (every
    100th packet chunk both ways, 0.2 s) and moves the placement with its
    points: M' = M T^-1 for the scan, decomposed back into Setup and Lean;
    the photograph keeps its pitch and roll and turns only by the yaw the
    decomposition moved. Exact to machine precision. Photographs are stampe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
2026-09-14 Deep align settles the heading at the rig's stack, then on the content
    "deep align not working on scan 21" (the restaurant's half-arc capture,
    190.8 degrees). Reproduced through the server's own deep(): with the
    operator's cuts in force the reflectivity sweep at the STORED stack
    read the true heading 3.4 against a false one 2.3, and the screening
    then freed the tilt, so the false basin 140 degrees out dressed itself
    in a -2.2/-2.6 lean and a 0.40 m camera and won the fine judge 5.2 to
    3.9. On a half-circle scan a tilt acts nearly uniform, so any wrong
    heading can be dressed to fit. At the rig's own bolted geometry (the
    confirmed siblings' median) the same sweep reads 5.0 against 2.7 and
    the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
2026-09-14 Deep align hears no cuts
    The operator's call, on the numbers: with the restaurant project's 81
    lasso cuts the mask walk before a deep press took 279 s alone (each
    lasso tested on every one of 18 captures, 0.13 s a test over 1.2M
    points) against a 30 s search. "i dont think the cut list helps here."
    The route hands take_edit nothing for /photo/deep and /photo/deepall,
    which clears every mask, so both deep doors read the whole capture;
    every other photograph door still sends its list on its own press.
    Suite 2187 -> 2189; the audit (deep_press forced False) fired its
    named check. Exes rebuilt 18:32-18:33.
2026-09-22 The moved cloud's cut replay is one cloud, off the page
    "when moving point clouds in the Z direction the progam slows down too
    much" (2026-09-22). Not Z: a capture brought into the job after its cuts
    were drawn has no frame in any of them, and every nudge of it replayed
    every cut against every cloud on the main thread, 50-58 s in the log.
    - recomputeLive(only) re-tests the moved cloud alone; the rest are summed
    from a cached per-cloud count (aliveOf), cleared by the fast drop.
    - followMoved -> replayOne: the mask is computed in a Web Worker from a
    copy of the cloud's points and the cuts that reach it (replayJob,
    maskOf); the worker's source is the page's own functions lifted by
    toSt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
2026-09-22 A cut reaches only the clouds that were there when it was drawn
    "scan 23 is not displaying as a full scan" -> "make it so when a new
    cloud is imported that nothing effects it" (2026-09-22). Capture 23,
    brought into the restaurant job after its 82 cuts and unplaced at the
    origin, kept 42% of itself under lassos drawn for the other clouds: with
    no frame in any cut it was tested in the merged frame wherever it sat.
    - pipeline._reaches(op, index): in scope AND (the cut remembers nothing
    OR it remembers this cloud); Edit.for_scan reads it. The page's
    reaches() mirrors it in planFor, applyDrop and clipSpared, so the
    preview, the fast drop, the spared count and the exported file agree.
    - A c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
2026-09-22 The bring-back lasso: the deleted points inside an outline come back
    "i want a tool in the delete point tab that when i draw a polygon all
    deleted points in that polygon appear again" (2026-09-22). A third
    outline mode, restore, beside Delete inside and Delete outside; Alt-Enter
    does the same as the button.
    - It is ordered: a cut drawn after it deletes again. Every op the page
    sends now carries its place in the list (order), and both the replay
    (maskOf, the worker's own function) and the exporter (Edit.mask) walk
    the drops and the bring-backs in that order after the keeps.
    - pipeline.Lasso gains restore and order, written only when set so older
    files read back unchanged; keep wins o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
2026-09-23 Export 6x faster: each cut tests only what it could change; .laz compressed again
    Profiled on the restaurant job, 84 cuts were 353 s of a 388 s capture:
    every cut walked all 22M points. Edit.mask now hands a drop only the live
    points, a bring-back only the dead, and rules out 0.5 m blocks whose
    corners all project off the outline's screen rectangle; a cut's clip box
    is tested on enclosed points only. 353 s -> 30 s, 0 of 23.7M points
    different.
    laspy inferred compression from "x.laz.part", so every .laz since
    2026-08-28 was plain LAS (26 B/pt). LasWriter now names do_compress and
    uses the parallel lazrs backend.
    Suite 2242 passed, 0 failed; reversion audit fired the 4 named checks.
    Co-Auth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
2026-09-23 Merge on four threads, written in capture order; Export for SketchUp
    pipeline.merge converts captures on a thread pool (MERGE_WORKERS = 4,
    bounded by captures and half the cores), each into a _Held buffer the
    writer takes in capture order, so thinning and the file are unchanged.
    6 restaurant captures: 335 s -> 177 s, output byte-identical.
    Export tray gains "Export for SketchUp": '<name> sketchup.laz' beside the
    chosen file at a 1 cm grid (SKETCHUP_GRID_M). Measured on the whole job:
    33.6M points, ~150 MB .laz -- inside the size Scan Essentials' RealWorks
    import is reported to handle; every return is 441M.
    Suite 2254 passed, 0 failed; reversion audit fired the named checks.
    Co-Authored-By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
