Kizim01/Kizim-TLS-Pie/(notices)

Notices in the files:
Arduino Microview/LidarHDMicroviewV1.0/LidarHDMicroviewV1.0.ino:
This program is free software: you can redistribute it and/or modify
it under the terms of the GNU General Public License as published by
the Free Software Foundation, either version 3 of the License, or
(at your option) any later version.
